orbitinstasis/T420_KB_BLE/Images/20221105_153418.jpg

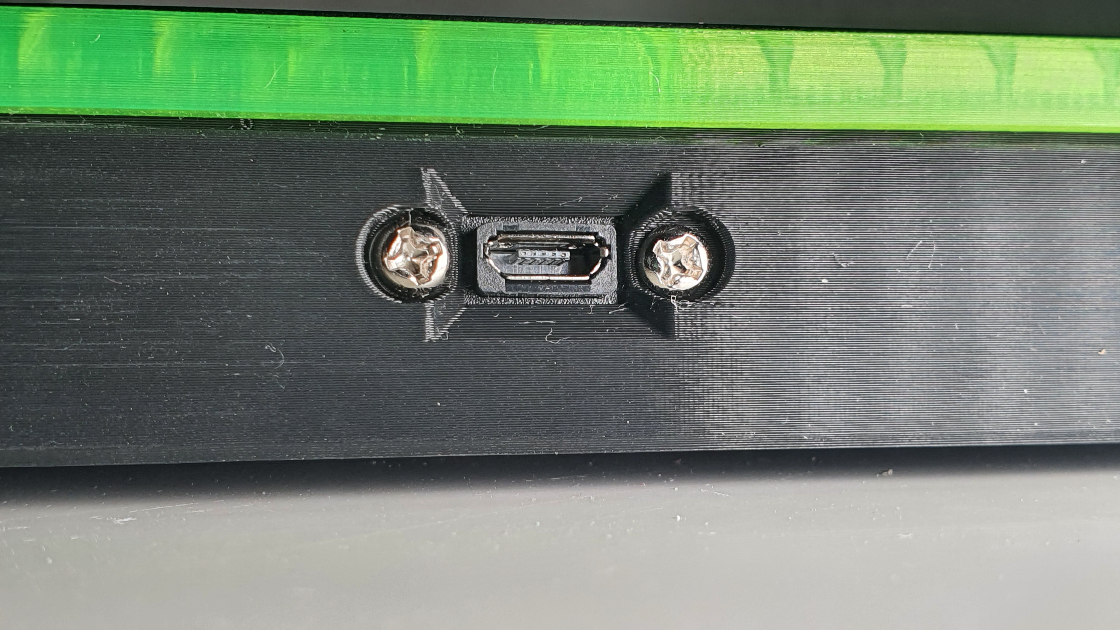
Images/20221105_153418.jpg
