orbitinstasis/T420_KB_BLE/README.md

# T420_KB_BLE
BLE and USB Mouse and Keyboard
