orbitinstasis/T420_KB_BLE/Old/Lenovo_ThinkPad_T61/Teensy 3p2/Lenovo_T61_io_list.txt

cntrl-l			16	22	
cntrl-r			9	22	
shift-l			17	21	
shift-r			9	21	
alt-l			15	1	
alt-r			8	1	
gui				12	3	
a				11	20	
b				25	8	
c				24	9	
d				11	24	
e				12	24	
f				25	11	
g				15	25	
h				31	15	
i				32	12	
j				31	11	
k				32	11	
l				7	11	
m				31	9	
n				31	8	
o				7	12	
p				12	6	
q				12	20	
r				12	25	
s				11	33	
t				17	25	
u				31	12	
v				25	9	
w				12	33	
x				9	33	
y				31	17	
z				9	20	
`				16	20	
1				10	20	
2				10	33	
3				10	24	
4				25	10	
5				16	25	
6				31	16	
7				31	10	
8				32	10	
9				7	10	
0				6	10	
-				16	6	
=				32	16	
bckspace		26	17	
esc				15	20	
f1				16	33	
f2				16	24	
f3				17	24	
f4				15	24	
f5				15	26	
f6				15	32	
f7				17	7	
f8				16	7	
f9				16	26	
f10				26	10	
f11				10	5	
f12				10	4	
insert			16	4	
delete			16	5	
home			16	2	
pg-up			16	3	
pg-dn			10	3	
end				10	2	
arrow-r			8	4	
arrow-l			8	2	
arrow-u			15	2	
arrow-d			5	8	
menu			11	3	
/				6	8	
period			7	9	
comma			32	9	
;				11	6	
'				15	6	
enter			26	9	
[				17	6	
]				32	17	
\				26	11	
caps-lck		17	33	
tab				17	20	
space			26	8	
prt-sc			10	1	
scr-lk			12	1	
pause			9	2	
page left		9	3	
page right		8	3	
mute			11	5	
volume down		17	5	
volume up		12	5	
ThinkVantage	15	5
