orbitinstasis/T420_KB_BLE/Enclosure/adafruit-bluefruit-le-uart-friend-bluetooth-low-energy-ble-1.snapshot.6/TEXTURES/eagleUp_Adafruit Bluefruit LE UART Friend_board_bottom.jpg

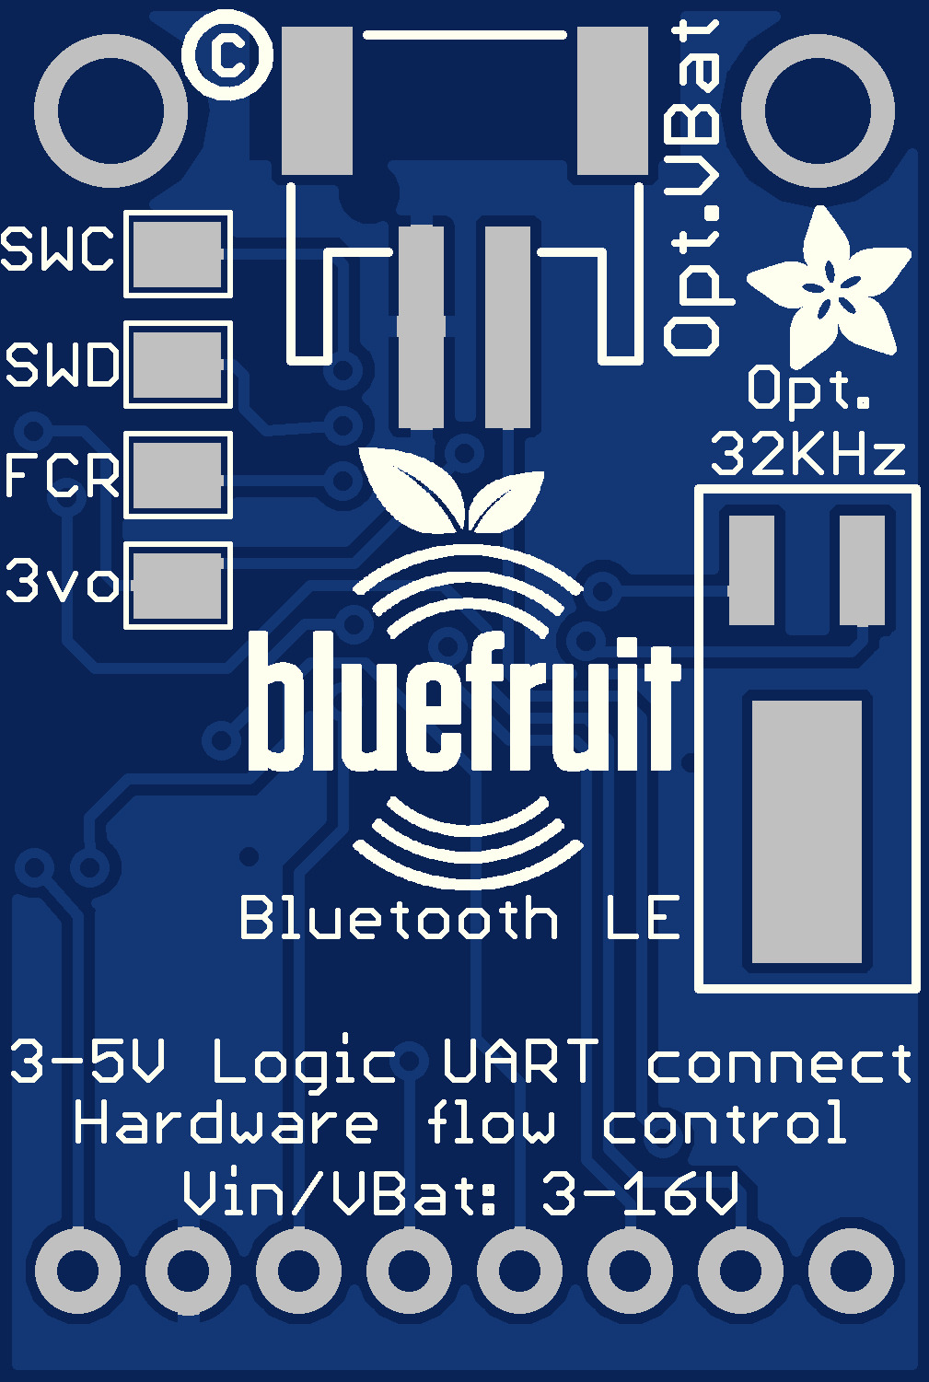
Enclosure/adafruit-bluefruit-le-uart-friend-bluetooth-low-energy-ble-1.snapshot.6/TEXTURES/eagleUp_Adafruit Bluefruit LE UART Friend_board_bottom.jpg
