orbitinstasis/T420_KB_BLE/Enclosure/revers t410_scaled.png

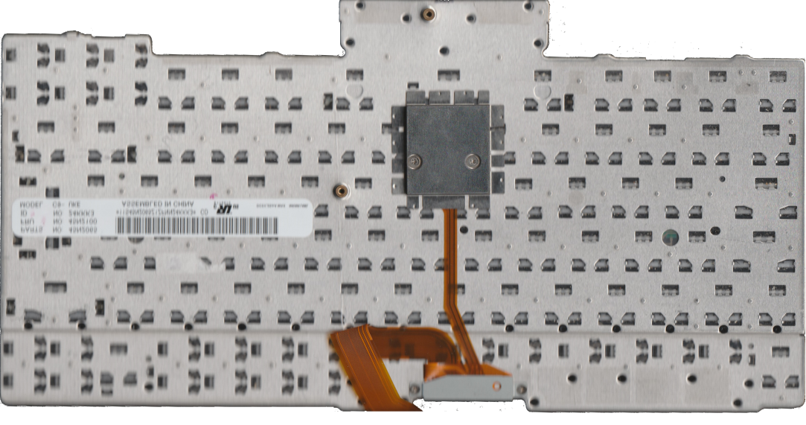
Enclosure/revers t410_scaled.png
