orbitinstasis/T420_KB_BLE/Enclosure/switch/Sliding Switches.PNG

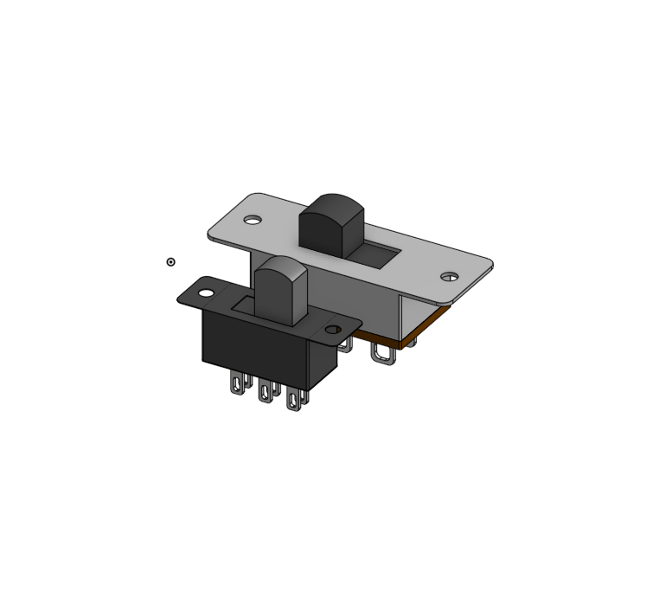
Enclosure/switch/Sliding Switches.PNG
