orbitinstasis/T420_KB_BLE/Images/20221105_142908.jpg

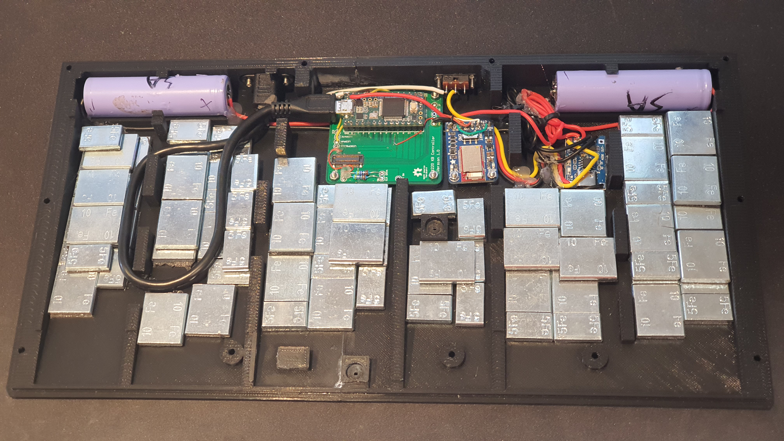
Images/20221105_142908.jpg
