orbitinstasis/T420_KB_BLE/Images/20221105_153204.jpg

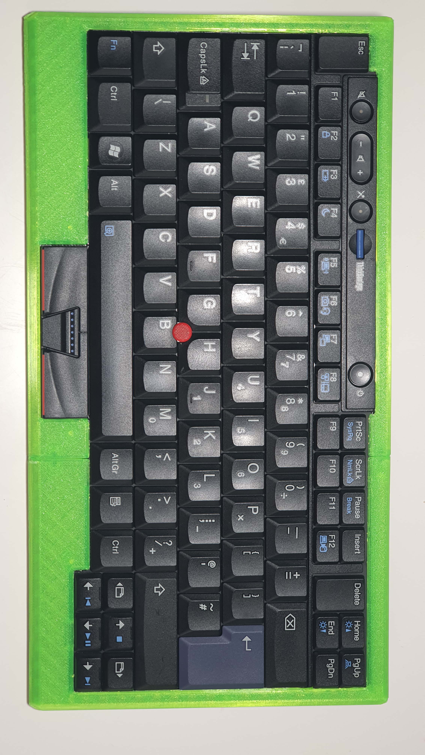
Images/20221105_153204.jpg
