orbitinstasis/T420_KB_BLE/Images/20221105_153320.jpg

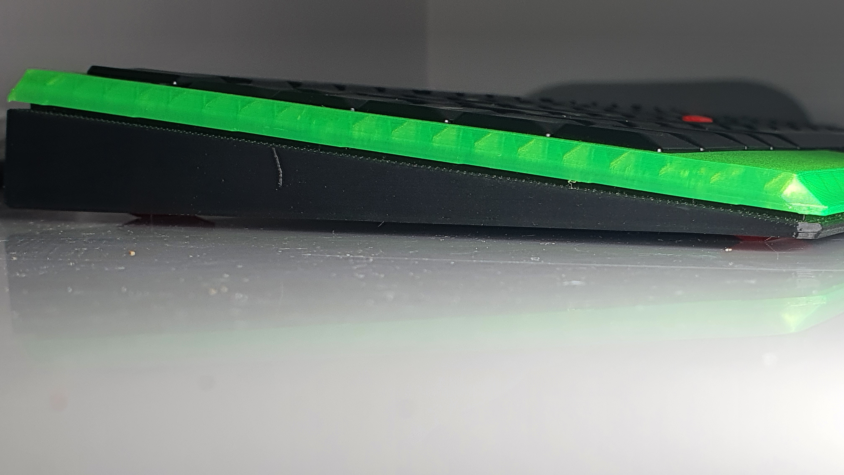
Images/20221105_153320.jpg
