orbitinstasis/T420_KB_BLE/Images/20221105_153400.jpg

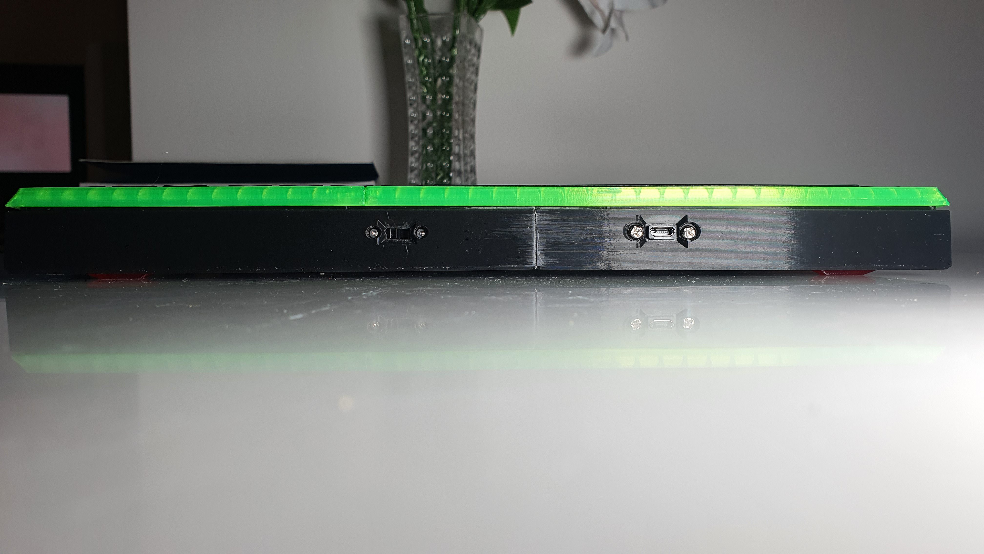
Images/20221105_153400.jpg
