orbitinstasis/T420_KB_BLE/Images/20221105_153611.jpg

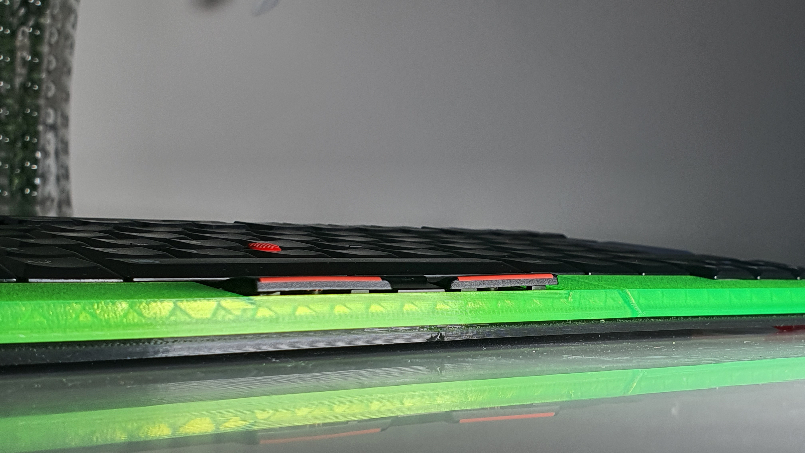
Images/20221105_153611.jpg
