orbitinstasis/T420_KB_BLE/Images/20221105_153649.jpg

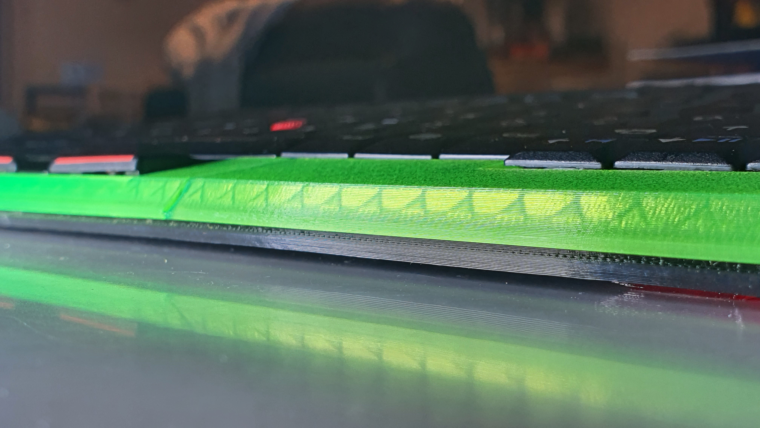
Images/20221105_153649.jpg
