orbitinstasis/T420_KB_BLE/Images/IMG-20221105-WA0033.jpeg

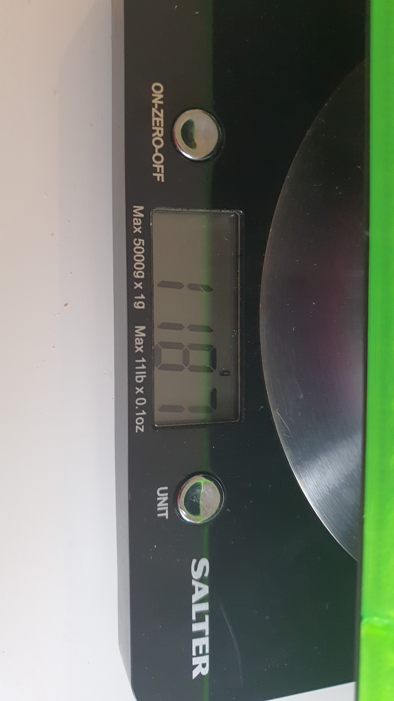
Images/IMG-20221105-WA0033.jpeg
