orbitinstasis/T420_KB_BLE/Enclosure/3D Printable Parts/4 R.stl

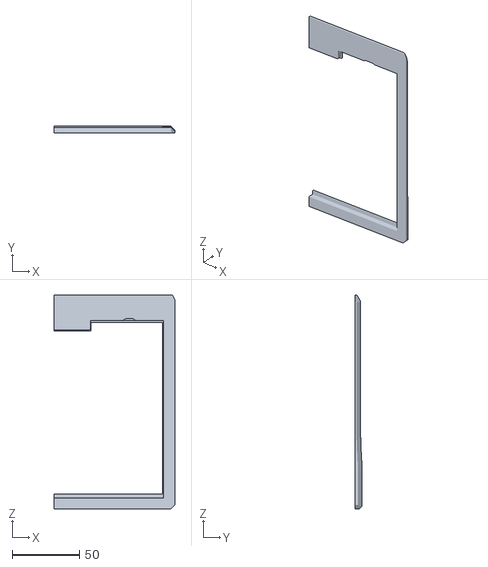
[picture p27: CAD file, 2022-11-05]
Enclosure/3D Printable Parts/4 R.stl
90.0 x 5.33 x 159.5
