orbitinstasis/T420_KB_BLE/Enclosure/BatteryHolder.stp

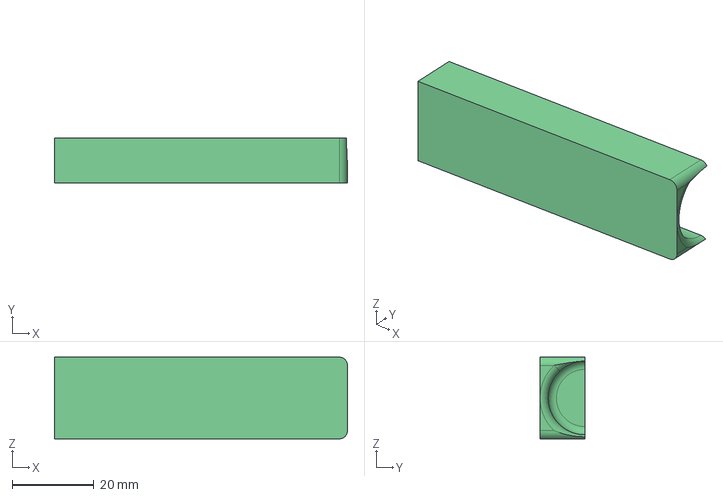
[picture p28: CAD file, 2022-11-05]
Enclosure/BatteryHolder.stp
71.7 x 11.0 x 20.0 mm
