orbitinstasis/T420_KB_BLE/Enclosure/switch/Sliding Switch 2.step

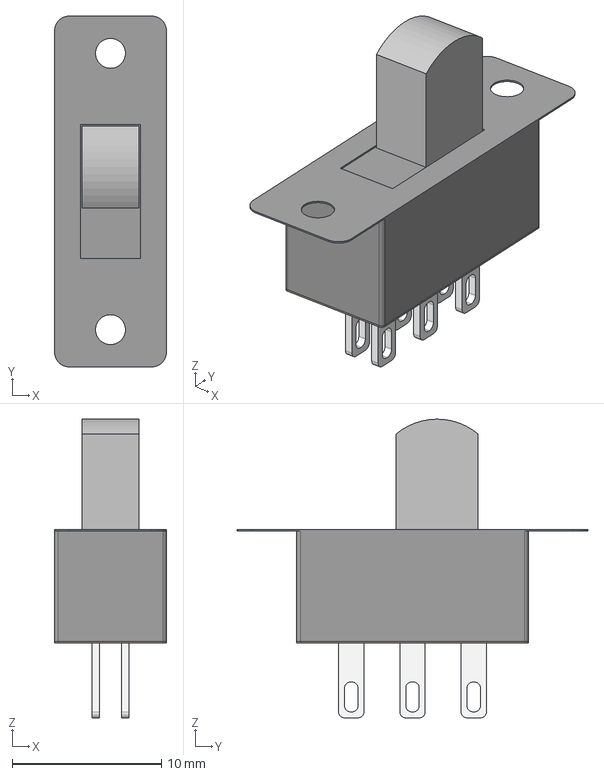
[picture p29: CAD file, 2022-11-05]
Enclosure/switch/Sliding Switch 2.step
7.50 x 23.5 x 20.0 mm
