orbitinstasis/T420_KB_BLE/Enclosure/3D Printable Parts/BezelTest2Left.stp

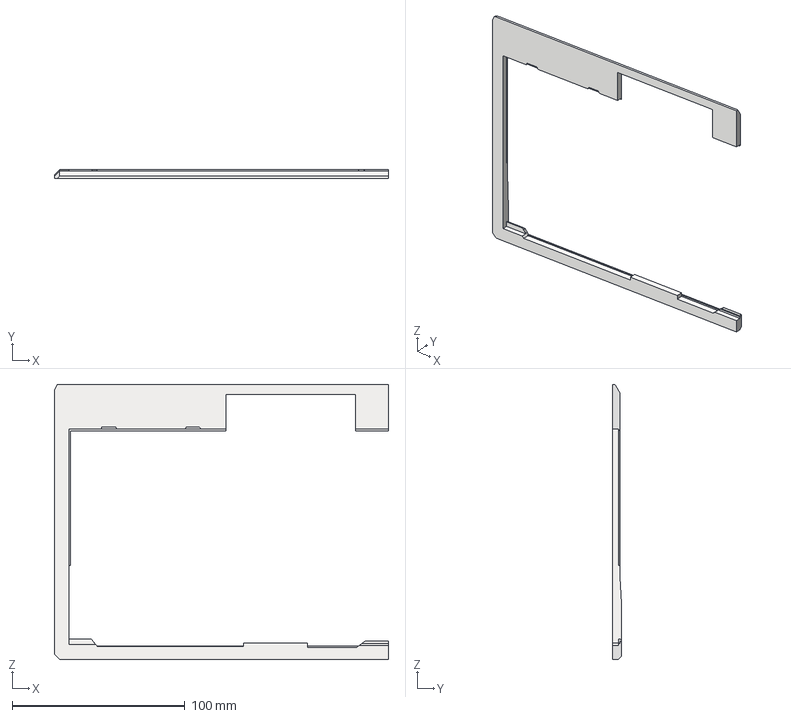
[picture p30: CAD file, 2022-11-05]
Enclosure/3D Printable Parts/BezelTest2Left.stp
193.6 x 5.33 x 159.5 mm
