orbitinstasis/T420_KB_BLE/Enclosure/BezelStep2AfterFinal.stp

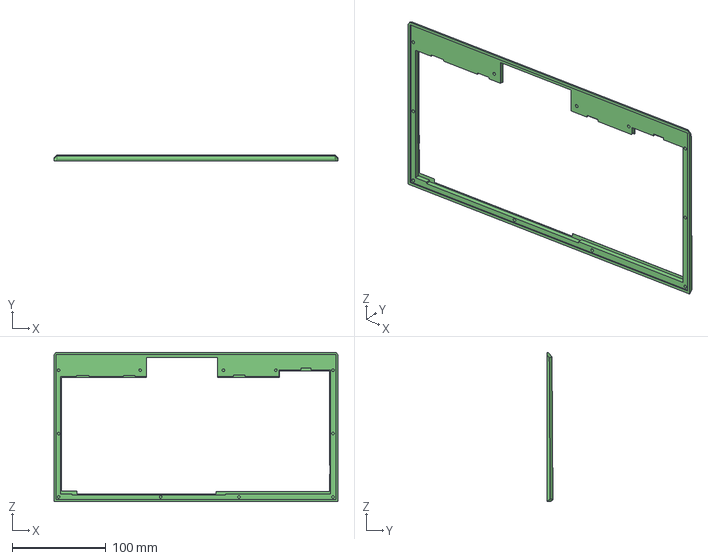
[picture p31: CAD file, 2022-11-05]
Enclosure/BezelStep2AfterFinal.stp
303.6 x 6.33 x 159.5 mm
