orbitinstasis/T420_KB_BLE/Enclosure/3D Printable Parts/62.stl

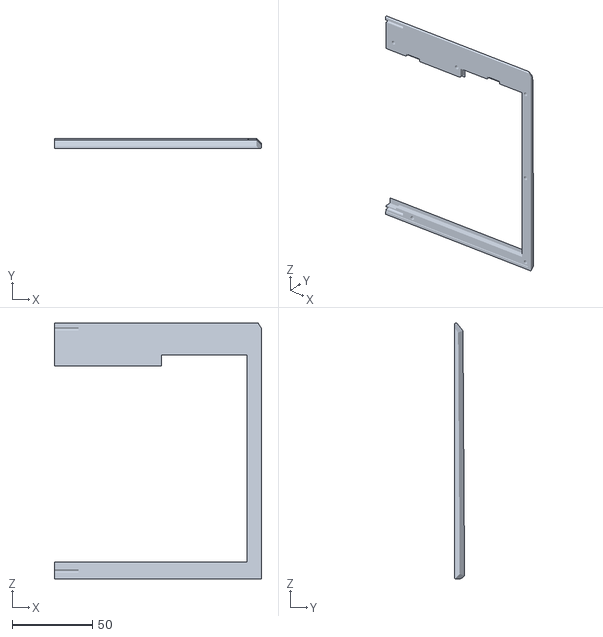
[picture p32: CAD file, 2022-11-05]
Enclosure/3D Printable Parts/62.stl
129.0 x 6.33 x 159.5
