orbitinstasis/T420_KB_BLE/Enclosure/New.stl

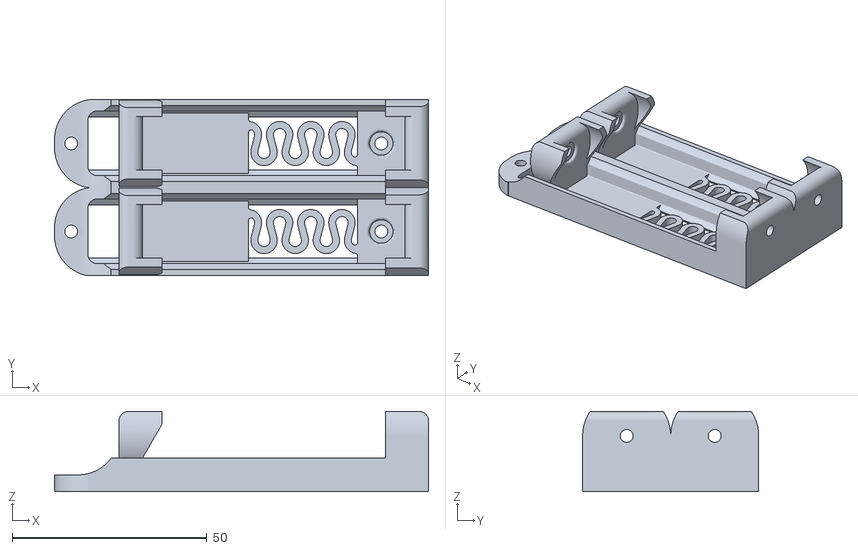
[picture p33: CAD file, 2022-11-05]
Enclosure/New.stl
96.0 x 45.3 x 20.6
