orbitinstasis/T420_KB_BLE/Enclosure/switch/Three Position Sliding Switch.step

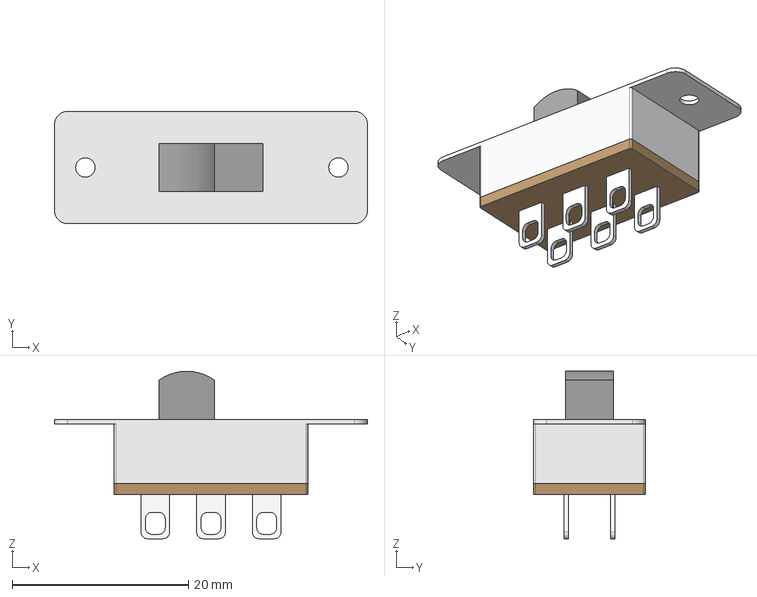
[picture p34: CAD file, 2022-11-05]
Enclosure/switch/Three Position Sliding Switch.step
35.5 x 12.8 x 19.0 mm
