orbitinstasis/T420_KB_BLE/Enclosure/Adafruit3258.stp

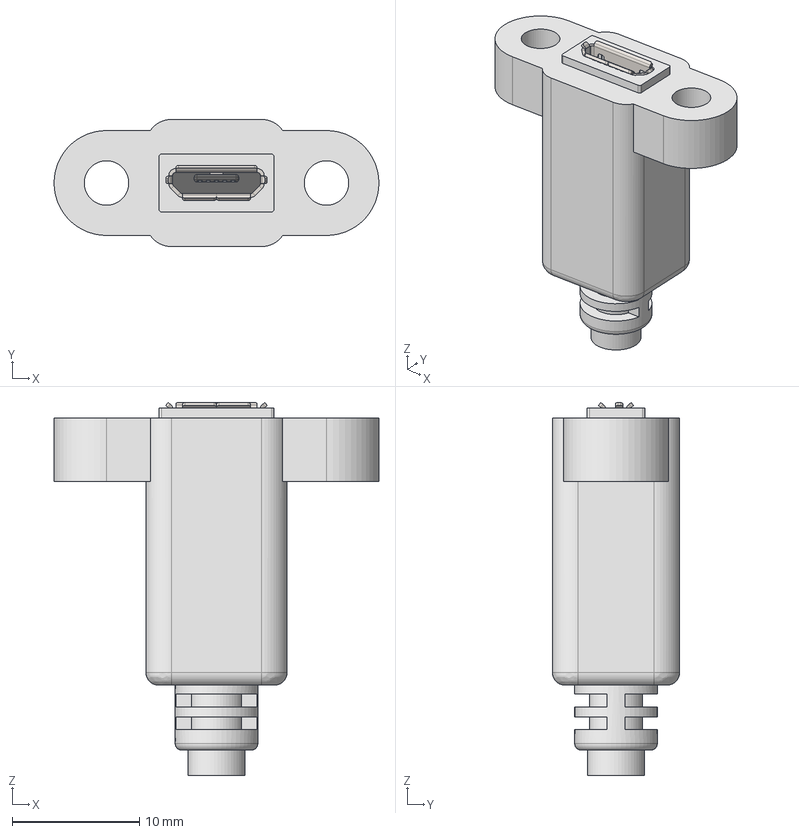
[picture p35: CAD file, 2022-11-05]
Enclosure/Adafruit3258.stp
25.5 x 10.0 x 29.3 mm
Adafruit3258_1
molex_0473460001
