orbitinstasis/T420_KB_BLE/Enclosure/3D Printable Parts/testBottom.stp

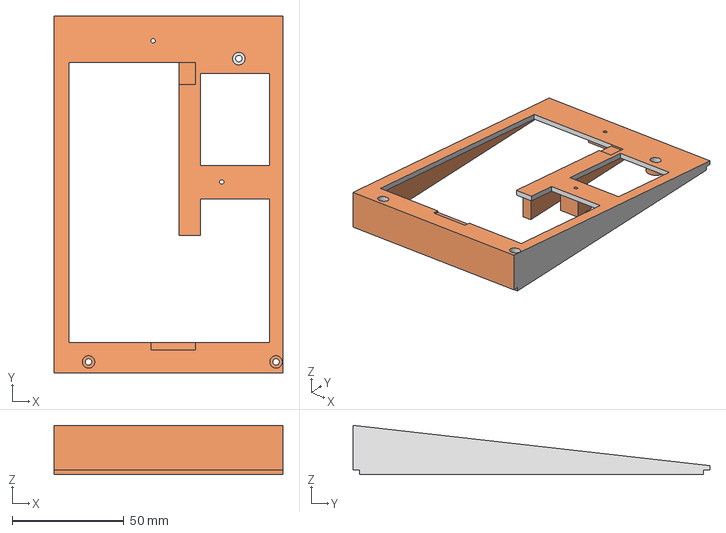
[picture p36: CAD file, 2022-11-05]
Enclosure/3D Printable Parts/testBottom.stp
102.2 x 159.5 x 22.0 mm
