orbitinstasis/T420_KB_BLE/Enclosure/3D Printable Parts/7rIGHT.stp

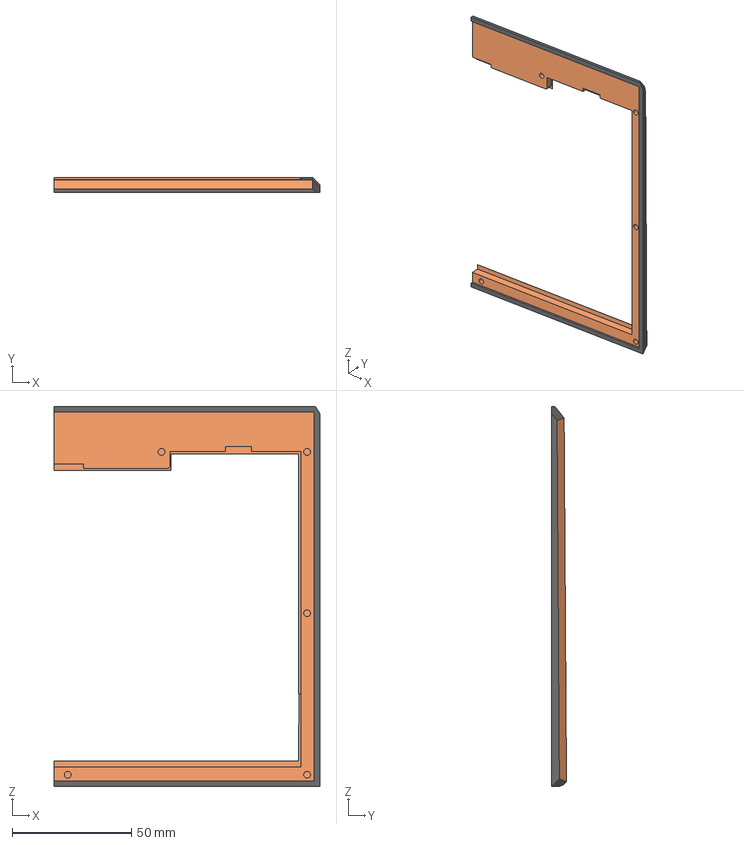
[picture p37: CAD file, 2022-11-05]
Enclosure/3D Printable Parts/7rIGHT.stp
111.5 x 6.33 x 159.5 mm
