orbitinstasis/T420_KB_BLE/Enclosure/test.stp

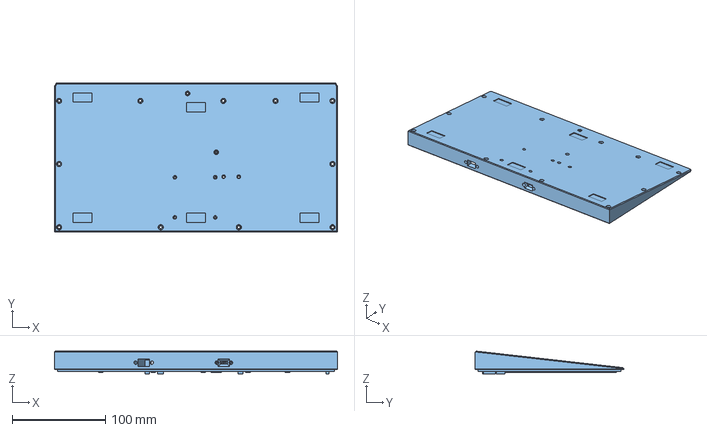
[picture p38: CAD file, 2022-11-05]
Enclosure/test.stp
303.6 x 159.5 x 24.5 mm
