orbitinstasis/T420_KB_BLE/Enclosure/3D Printable Parts/LeftBottomV1.stp

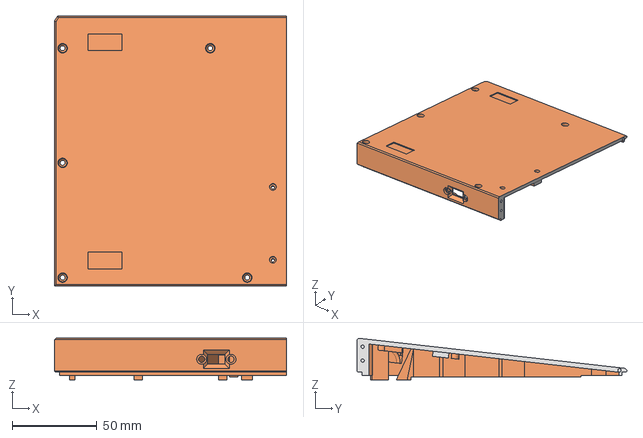
[picture p39: CAD file, 2022-11-05]
Enclosure/3D Printable Parts/LeftBottomV1.stp
137.3 x 159.5 x 24.5 mm
