orbitinstasis/T420_KB_BLE/Enclosure/6xPads.stp

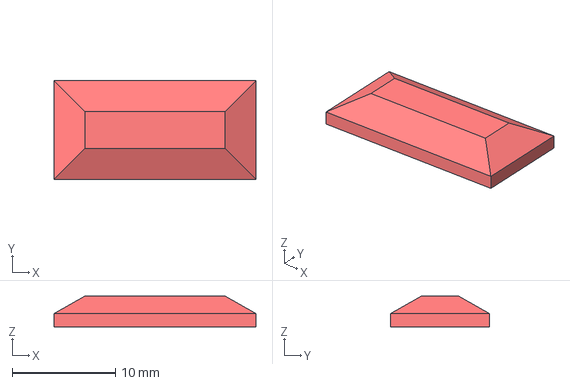
[picture p40: CAD file, 2022-11-05]
Enclosure/6xPads.stp
19.6 x 9.60 x 3.00 mm
