orbitinstasis/T420_KB_BLE/Enclosure/3D Printable Parts/61.stl

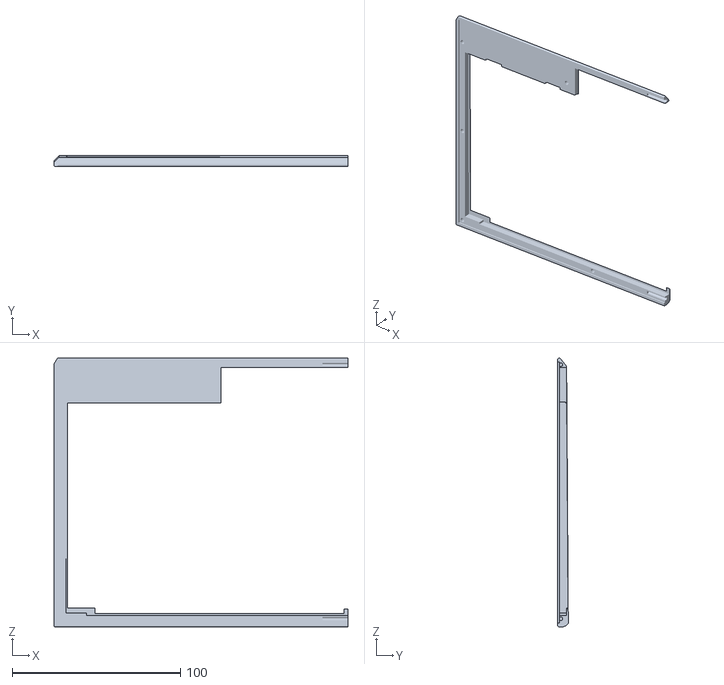
[picture p41: CAD file, 2022-11-05]
Enclosure/3D Printable Parts/61.stl
174.6 x 6.33 x 159.5
