orbitinstasis/T420_KB_BLE/Enclosure/Lenovo_Scanner t32.step

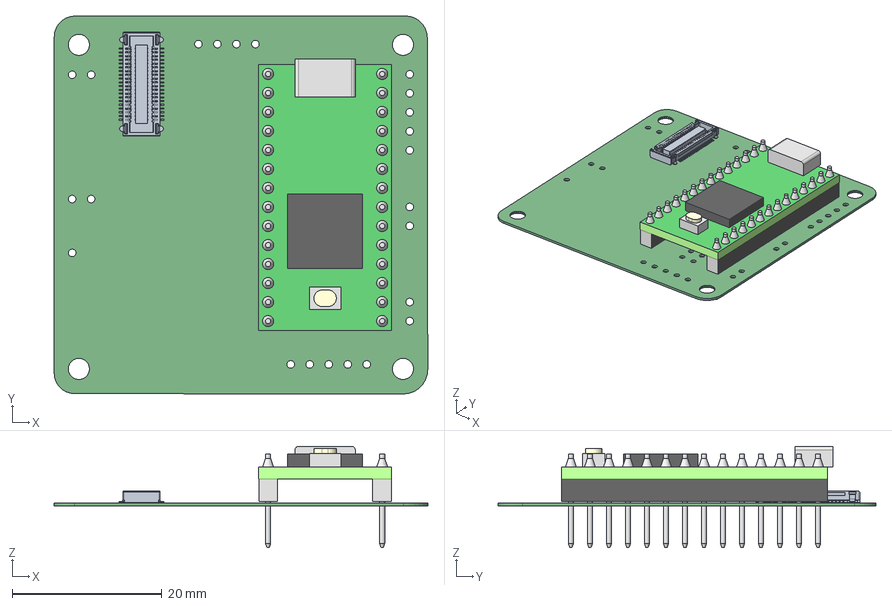
[picture p42: CAD file, 2021-09-04]
Enclosure/Lenovo_Scanner t32.step
49.9 x 50.5 x 13.6 mm
Teensy3.2
