orbitinstasis/T420_KB_BLE/Enclosure/3D Printable Parts/BezelTest2Right.stp

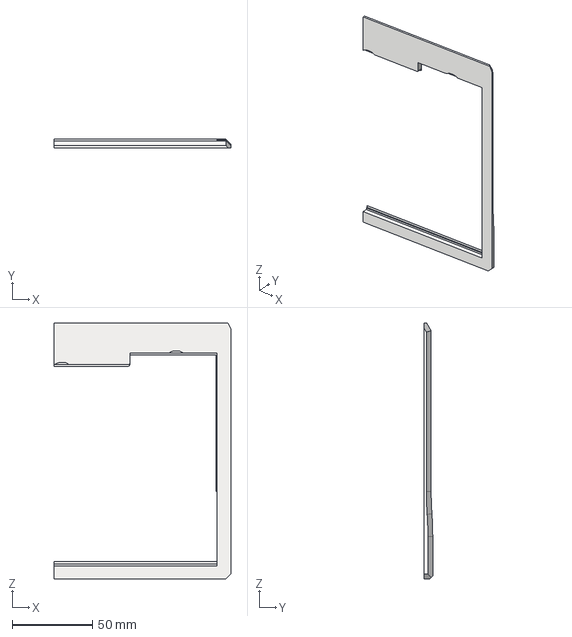
[picture p43: CAD file, 2022-11-05]
Enclosure/3D Printable Parts/BezelTest2Right.stp
110.0 x 5.33 x 159.5 mm
