orbitinstasis/T420_KB_BLE/Enclosure/Teensy3.2.STEP

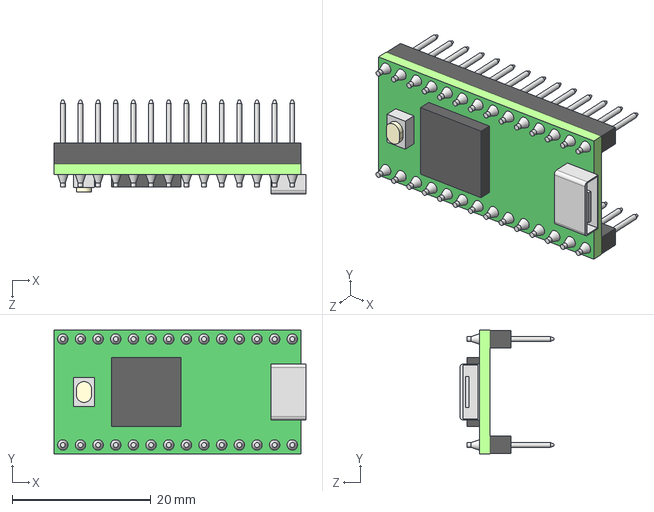
[picture p44: CAD file, 2021-09-04]
Enclosure/Teensy3.2.STEP
36.3 x 17.8 x 13.6 mm
