orbitinstasis/T420_KB_BLE/Enclosure/3D Printable Parts/bezel3.stp

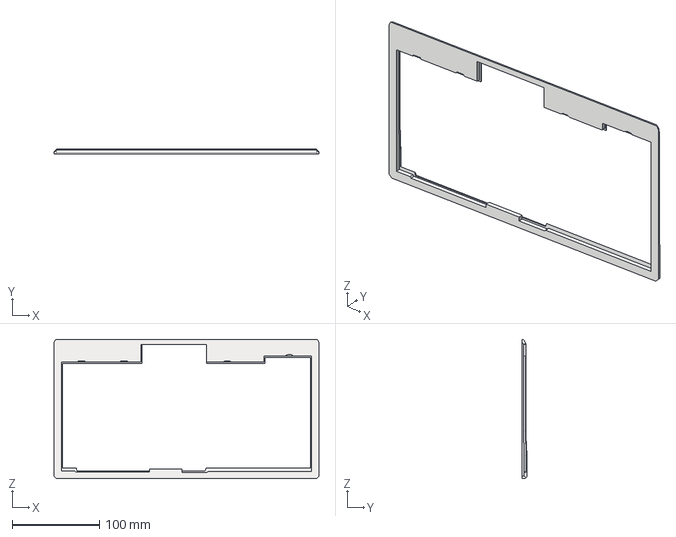
[picture p45: CAD file, 2022-11-05]
Enclosure/3D Printable Parts/bezel3.stp
303.6 x 5.33 x 159.5 mm
