orbitinstasis/T420_KB_BLE/Enclosure/3D Printable Parts/5THFinalAttemptLeft.stp

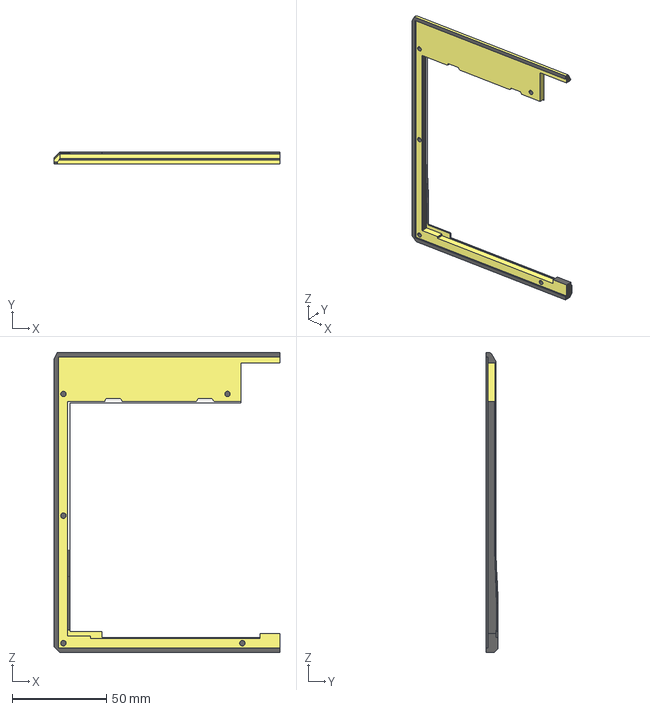
[picture p46: CAD file, 2022-11-05]
Enclosure/3D Printable Parts/5THFinalAttemptLeft.stp
120.0 x 6.33 x 159.5 mm
