orbitinstasis/T420_KB_BLE/Enclosure/3D Printable Parts/5THFinalAttemptRight.stp

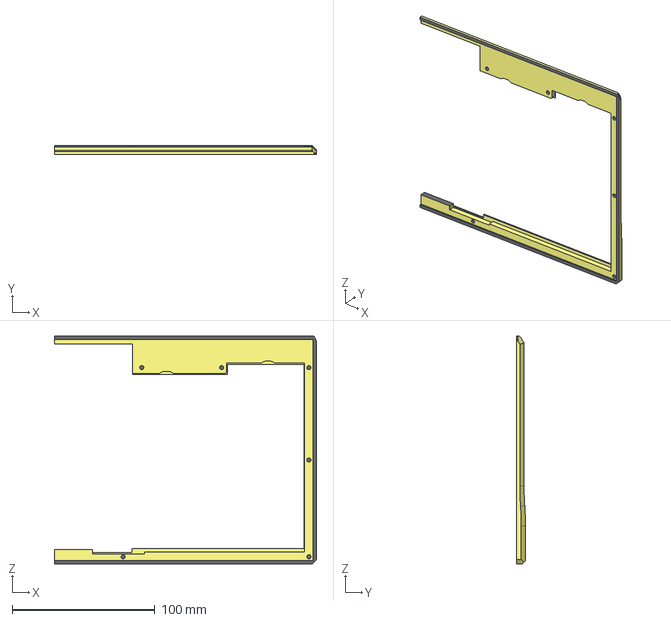
[picture p47: CAD file, 2022-11-05]
Enclosure/3D Printable Parts/5THFinalAttemptRight.stp
183.6 x 6.33 x 159.5 mm
