orbitinstasis/T420_KB_BLE/Enclosure/3D Printable Parts/BezelTestOneLeft.stp

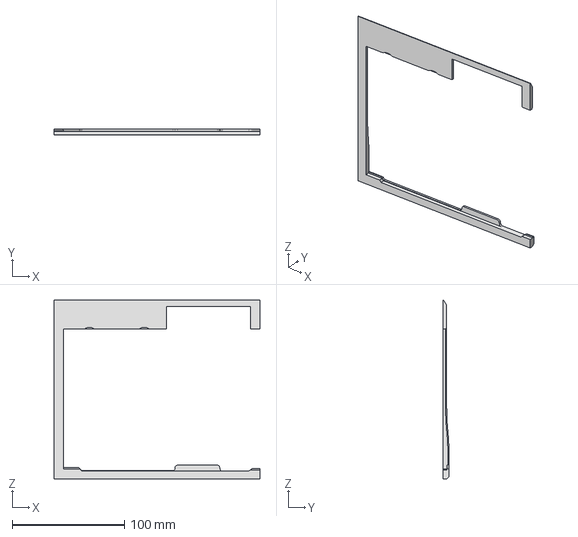
[picture p48: CAD file, 2022-11-05]
Enclosure/3D Printable Parts/BezelTestOneLeft.stp
183.6 x 5.33 x 159.5 mm
