orbitinstasis/T420_KB_BLE/Enclosure/3D Printable Parts/7Left.stp

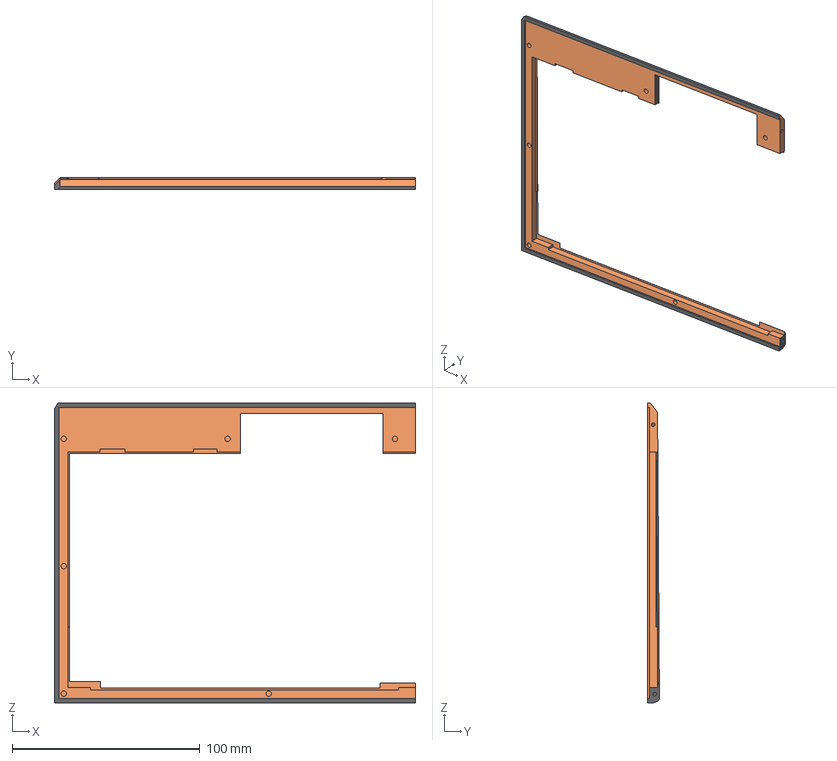
[picture p49: CAD file, 2022-11-05]
Enclosure/3D Printable Parts/7Left.stp
192.1 x 6.33 x 159.5 mm
