orbitinstasis/T420_KB_BLE/Enclosure/3D Printable Parts/RightBottomV1.stp

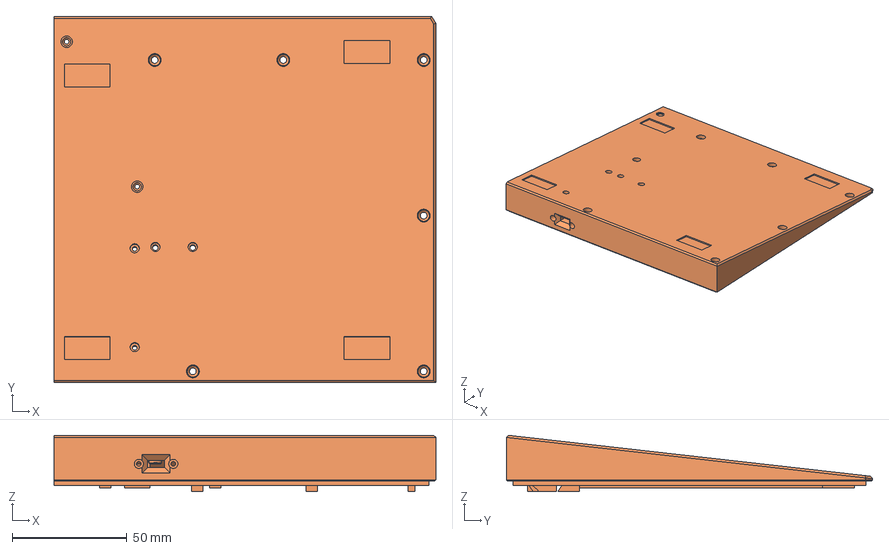
[picture p50: CAD file, 2022-11-05]
Enclosure/3D Printable Parts/RightBottomV1.stp
166.3 x 159.5 x 24.5 mm
