orbitinstasis/T420_KB_BLE/Enclosure/3D Printable Parts/BottomStep.stp

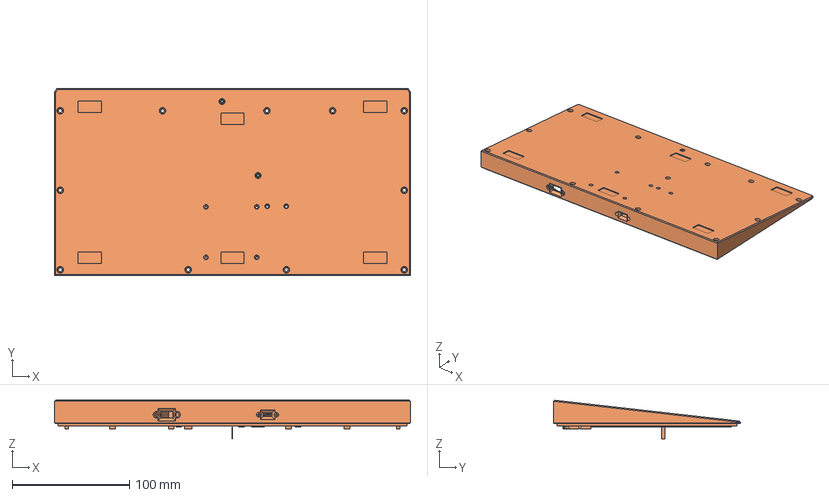
[picture p51: CAD file, 2022-11-05]
Enclosure/3D Printable Parts/BottomStep.stp
303.6 x 159.5 x 32.9 mm
