orbitinstasis/T420_KB_BLE/Enclosure/3D Printable Parts/BottomRight.3mf

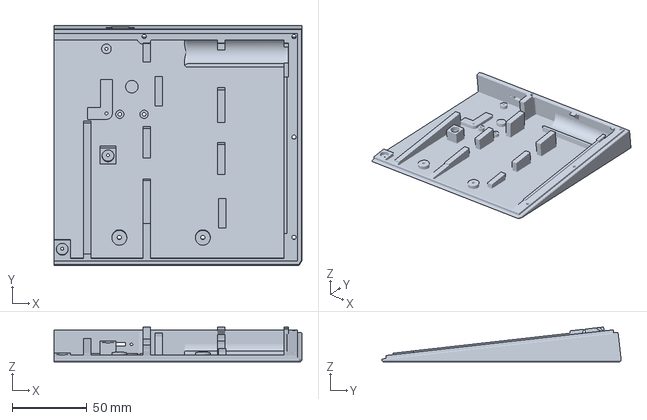
[picture p52: CAD file, 2022-11-05]
Enclosure/3D Printable Parts/BottomRight.3mf
166.3 x 160.6 x 23.5 mm
