orbitinstasis/T420_KB_BLE/Enclosure/3D Printable Parts/4 left.stl

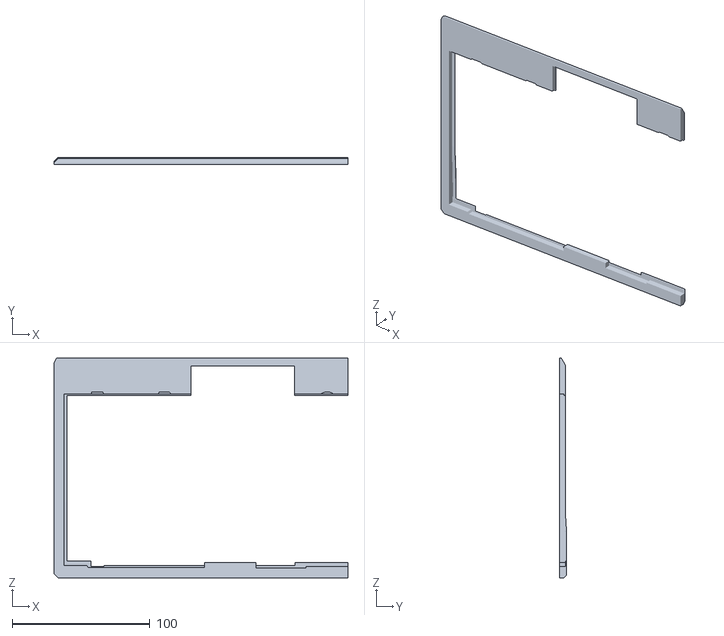
[picture p53: CAD file, 2022-11-05]
Enclosure/3D Printable Parts/4 left.stl
213.6 x 5.33 x 159.5
