orbitinstasis/T420_KB_BLE/Enclosure/3D Printable Parts/BezelTestOneRight.stp

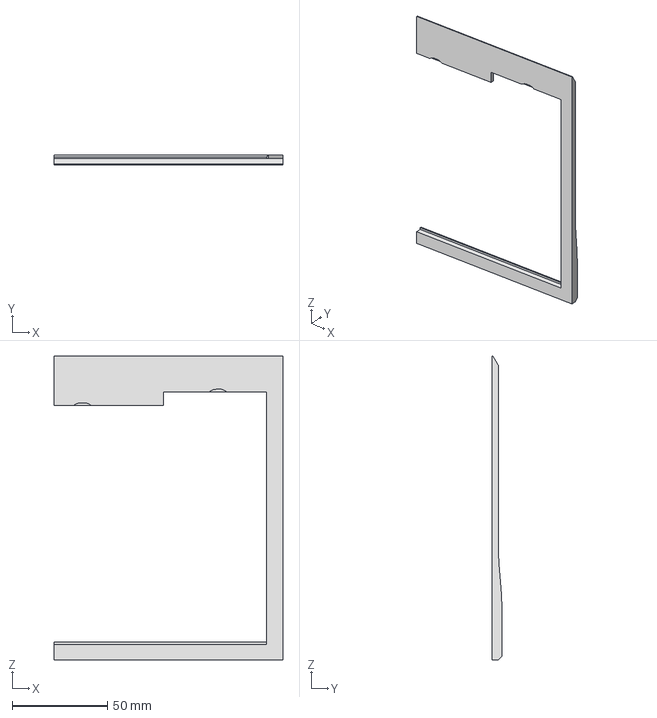
[picture p54: CAD file, 2022-11-05]
Enclosure/3D Printable Parts/BezelTestOneRight.stp
120.0 x 5.33 x 159.5 mm
