orbitinstasis/T420_KB_BLE/(list of files, cad)

Other CAD files:
Enclosure/switch/Sliding Switch.iges
Enclosure/3D Printable Parts/6THright.stp
Enclosure/FinalBezel.stp
Enclosure/3D Printable Parts/6THLEFT.stp
Enclosure/10gram weight.ipt
Enclosure/18650-battery-7.snapshot.1/18650 Battery Final.SLDPRT
Enclosure/18650-battery-7.snapshot.1/18650 Battery Final.ipt
Enclosure/1X01.ipt
Enclosure/1X02.ipt
Enclosure/1X05.ipt
Enclosure/3D Printable Parts/BezelTest2Right.3mf
Enclosure/3D Printable Parts/Bottom.ipt
Enclosure/3D Printable Parts/OldVersions/Bottom.0024.ipt
Enclosure/3D Printable Parts/OldVersions/Bottom.0025.ipt
Enclosure/3D Printable Parts/OldVersions/Bottom.0026.ipt
Enclosure/3D Printable Parts/OldVersions/Bottom.0027.ipt
Enclosure/3D Printable Parts/OldVersions/Bottom.0028.ipt
Enclosure/3D Printable Parts/testBottom.3mf
Enclosure/543630489.iam
Enclosure/5gram weight.ipt
Enclosure/Adafruit3258.ipt
Enclosure/AssBasedonStep.iam
Enclosure/BatteryHolder.ipt
Enclosure/Bezel.ipt
Enclosure/BezelStep2AfterFinal.ipt
Enclosure/Board.ipt
Enclosure/BoardLenovo_Scanner_t32.iam
Enclosure/BottomStep.ipt
Enclosure/BottomStep.stp
Enclosure/Case.ipt
Enclosure/Free-Models.iam
Enclosure/J1Lenovo_Scanner_t32.iam
Enclosure/Lenovo_Scanner t32.iam
Enclosure/Lenovo_Scanner v1.iam
Enclosure/M3 Screw.ipt
Enclosure/My USB Hub.ipt
Enclosure/OSHW_5MM.ipt
Enclosure/OldVersions/AssBasedonStep.0048.iam
Enclosure/OldVersions/AssBasedonStep.0049.iam
Enclosure/OldVersions/AssBasedonStep.0050.iam
Enclosure/OldVersions/AssBasedonStep.0051.iam
Enclosure/OldVersions/AssBasedonStep.0052.iam
Enclosure/OldVersions/Bezel.0067.ipt
Enclosure/OldVersions/Bezel.0068.ipt
Enclosure/OldVersions/Bezel.0069.ipt
Enclosure/OldVersions/Bezel.0070.ipt
Enclosure/OldVersions/Bezel.0071.ipt
Enclosure/OldVersions/BottomStep.0033.ipt
Enclosure/OldVersions/BottomStep.0034.ipt
Enclosure/OldVersions/BottomStep.0035.ipt
Enclosure/OldVersions/BottomStep.0036.ipt
Enclosure/OldVersions/BottomStep.0037.ipt
Enclosure/OldVersions/Case.0003.ipt
Enclosure/OldVersions/Case.0004.ipt
Enclosure/OldVersions/M3 Screw.0001.ipt
Enclosure/OldVersions/M3 Screw.0002.ipt
Enclosure/OldVersions/M3 Screw.0003.ipt
Enclosure/OldVersions/Pads.0001.ipt
Enclosure/OldVersions/m2 screw.0001.ipt
Enclosure/OldVersions/m2 screw.0002.ipt
Enclosure/OldVersions/m2 screw.0003.ipt
Enclosure/Open CASCADE STEP translator 6.8 1.1.1.ipt
Enclosure/Open CASCADE STEP translator 6.8 1.2.1.1.ipt
Enclosure/Open CASCADE STEP translator 6.8 1.2.1.2.ipt
Enclosure/PCB Component.iam
Enclosure/Pads.ipt
Enclosure/T420 Holder.ipt
Enclosure/TEENSY_3P2MIN.ipt
Enclosure/Teensy3.2.ipt
Enclosure/ThinkBoard.iam
Enclosure/USB Hub.ipt
Enclosure/WM6787CT-ND.ipt
Enclosure/m2 screw.ipt
Enclosure/my keyboard BOTTOM.ipt
Enclosure/switch/OldVersions/Sliding Switch 2.0001.ipt
Enclosure/switch/Sliding Switch 2.ipt
Enclosure/switch/Three Position Sliding Switch.iges
Enclosure/switch/battery_holder_2batteries.ipt
Enclosure/t410.ipt
Enclosure/t420 ipt/Audio Control Button.ipt
Enclosure/t420 ipt/Audio Mute Button Label.ipt
Enclosure/t420 ipt/Audio Volume Buttons Label.ipt
Enclosure/t420 ipt/Audio Volume Buttons.iam
Enclosure/t420 ipt/Keyboard Top Bar.iam
Enclosure/t420 ipt/Keycap (Arrows).ipt
Enclosure/t420 ipt/Keycap (Backspace).ipt
Enclosure/t420 ipt/Keycap (Caps Lock).ipt
Enclosure/t420 ipt/Keycap (Ctrl L).ipt
Enclosure/t420 ipt/Keycap (Delete).ipt
Enclosure/t420 ipt/Keycap (Enter).ipt
Enclosure/t420 ipt/Keycap (Function Keys).ipt
Enclosure/t420 ipt/Keycap (Pg Fwd _ Pg Back).ipt
Enclosure/t420 ipt/Keycap (Shift L).ipt
Enclosure/t420 ipt/Keycap (Shift R).ipt
Enclosure/t420 ipt/Keycap (Space).ipt
Enclosure/t420 ipt/Keycap (Standard).ipt
Enclosure/t420 ipt/Keycap (Tab _ Backslash).ipt
Enclosure/t420 ipt/Keycap (TrackPoint B).ipt
Enclosure/t420 ipt/Keycap (Trackpoint G _ H).ipt
Enclosure/t420 ipt/Keycap (Up Arrow).ipt
Enclosure/t420 ipt/Keycap (Win).ipt
Enclosure/t420 ipt/Keycap Label (! Exclamation Mark).ipt
Enclosure/t420 ipt/Keycap Label (# Pound Sign).ipt
Enclosure/t420 ipt/Keycap Label ($ Dollar Sign).ipt
Enclosure/t420 ipt/Keycap Label (% Percent Sign).ipt
Enclosure/t420 ipt/Keycap Label (& Ampersand).ipt
Enclosure/t420 ipt/Keycap Label ('_ Apostrophe _ Quotation Mark).ipt
Enclosure/t420 ipt/Keycap Label (( Open Parentheses).ipt
Enclosure/t420 ipt/Keycap Label () Close Parentheses).ipt
Enclosure/t420 ipt/Keycap Label (, Comma).ipt
Enclosure/t420 ipt/Keycap Label (-_ Hyphen-Minus _ Underscore).ipt
Enclosure/t420 ipt/Keycap Label (. Period).ipt
Enclosure/t420 ipt/Keycap Label (0).ipt
Enclosure/t420 ipt/Keycap Label (1).ipt
Enclosure/t420 ipt/Keycap Label (2).ipt
Enclosure/t420 ipt/Keycap Label (3).ipt
Enclosure/t420 ipt/Keycap Label (4).ipt
Enclosure/t420 ipt/Keycap Label (5).ipt
Enclosure/t420 ipt/Keycap Label (6).ipt
Enclosure/t420 ipt/Keycap Label (7).ipt
Enclosure/t420 ipt/Keycap Label (8).ipt
Enclosure/t420 ipt/Keycap Label (9).ipt
Enclosure/t420 ipt/Keycap Label (;_ Semicolon _ Colon).ipt
Enclosure/t420 ipt/Keycap Label (=+ Equal Sign _ Plus Sign).ipt
Enclosure/t420 ipt/Keycap Label (@ At Sign).ipt
Enclosure/t420 ipt/Keycap Label (A).ipt
Enclosure/t420 ipt/Keycap Label (Alt).ipt
Enclosure/t420 ipt/Keycap Label (Arrow Down).ipt
Enclosure/t420 ipt/Keycap Label (Arrow Left).ipt
Enclosure/t420 ipt/Keycap Label (Arrow Right).ipt
Enclosure/t420 ipt/Keycap Label (Arrow Up).ipt
Enclosure/t420 ipt/Keycap Label (B).ipt
Enclosure/t420 ipt/Keycap Label (Backspace).ipt
Enclosure/t420 ipt/Keycap Label (Break).ipt
Enclosure/t420 ipt/Keycap Label (Browser Back).ipt
Enclosure/t420 ipt/Keycap Label (Browser Fwd).ipt
Enclosure/t420 ipt/Keycap Label (C).ipt
Enclosure/t420 ipt/Keycap Label (CapsLk).ipt
Enclosure/t420 ipt/Keycap Label (Ctrl L).ipt
Enclosure/t420 ipt/Keycap Label (Ctrl R).ipt
Enclosure/t420 ipt/Keycap Label (D).ipt
Enclosure/t420 ipt/Keycap Label (Delete).ipt
Enclosure/t420 ipt/Keycap Label (E).ipt
Enclosure/t420 ipt/Keycap Label (End).ipt
Enclosure/t420 ipt/Keycap Label (Enter).ipt
Enclosure/t420 ipt/Keycap Label (Esc).ipt
Enclosure/t420 ipt/Keycap Label (F).ipt
Enclosure/t420 ipt/Keycap Label (F1).ipt
Enclosure/t420 ipt/Keycap Label (F10).ipt
Enclosure/t420 ipt/Keycap Label (F11).ipt
Enclosure/t420 ipt/Keycap Label (F12).ipt
Enclosure/t420 ipt/Keycap Label (F2).ipt
Enclosure/t420 ipt/Keycap Label (F3).ipt
Enclosure/t420 ipt/Keycap Label (F4).ipt
Enclosure/t420 ipt/Keycap Label (F5).ipt
Enclosure/t420 ipt/Keycap Label (F6).ipt
Enclosure/t420 ipt/Keycap Label (F7).ipt
Enclosure/t420 ipt/Keycap Label (F8).ipt
Enclosure/t420 ipt/Keycap Label (F9).ipt
Enclosure/t420 ipt/Keycap Label (Fn Battery).ipt
Enclosure/t420 ipt/Keycap Label (Fn Brightness Down).ipt
Enclosure/t420 ipt/Keycap Label (Fn Brightness Up).ipt
Enclosure/t420 ipt/Keycap Label (Fn Camera_Headset).ipt
Enclosure/t420 ipt/Keycap Label (Fn Hibernate).ipt
Enclosure/t420 ipt/Keycap Label (Fn Lock).ipt
Enclosure/t420 ipt/Keycap Label (Fn Magnify Screen).ipt
Enclosure/t420 ipt/Keycap Label (Fn Play _ Pause).ipt
Enclosure/t420 ipt/Keycap Label (Fn Projector).ipt
Enclosure/t420 ipt/Keycap Label (Fn Sleep).ipt
Enclosure/t420 ipt/Keycap Label (Fn Stop).ipt
Enclosure/t420 ipt/Keycap Label (Fn ThinkLight).ipt
Enclosure/t420 ipt/Keycap Label (Fn Track Next).ipt
Enclosure/t420 ipt/Keycap Label (Fn Track Prev).ipt
Enclosure/t420 ipt/Keycap Label (Fn TrackPoint).ipt
Enclosure/t420 ipt/Keycap Label (Fn WiFi).ipt
Enclosure/t420 ipt/Keycap Label (Fn).ipt
Enclosure/t420 ipt/Keycap Label (G).ipt
Enclosure/t420 ipt/Keycap Label (H).ipt
Enclosure/t420 ipt/Keycap Label (Home).ipt
Enclosure/t420 ipt/Keycap Label (I).ipt
Enclosure/t420 ipt/Keycap Label (Insert).ipt
Enclosure/t420 ipt/Keycap Label (J).ipt
Enclosure/t420 ipt/Keycap Label (K).ipt
Enclosure/t420 ipt/Keycap Label (L).ipt
Enclosure/t420 ipt/Keycap Label (M).ipt
Enclosure/t420 ipt/Keycap Label (Menu).ipt
Enclosure/t420 ipt/Keycap Label (N).ipt
Enclosure/t420 ipt/Keycap Label (NmLk).ipt
Enclosure/t420 ipt/Keycap Label (Numpad 0).ipt
Enclosure/t420 ipt/Keycap Label (Numpad 1).ipt
Enclosure/t420 ipt/Keycap Label (Numpad 2).ipt
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
