orbitinstasis/T420_KB_BLE/T420 Schematic.pdf

# NOZOMI-3 SWG SDV2 LOGIC SCHEMATICS

# 1.TITLE PAGE

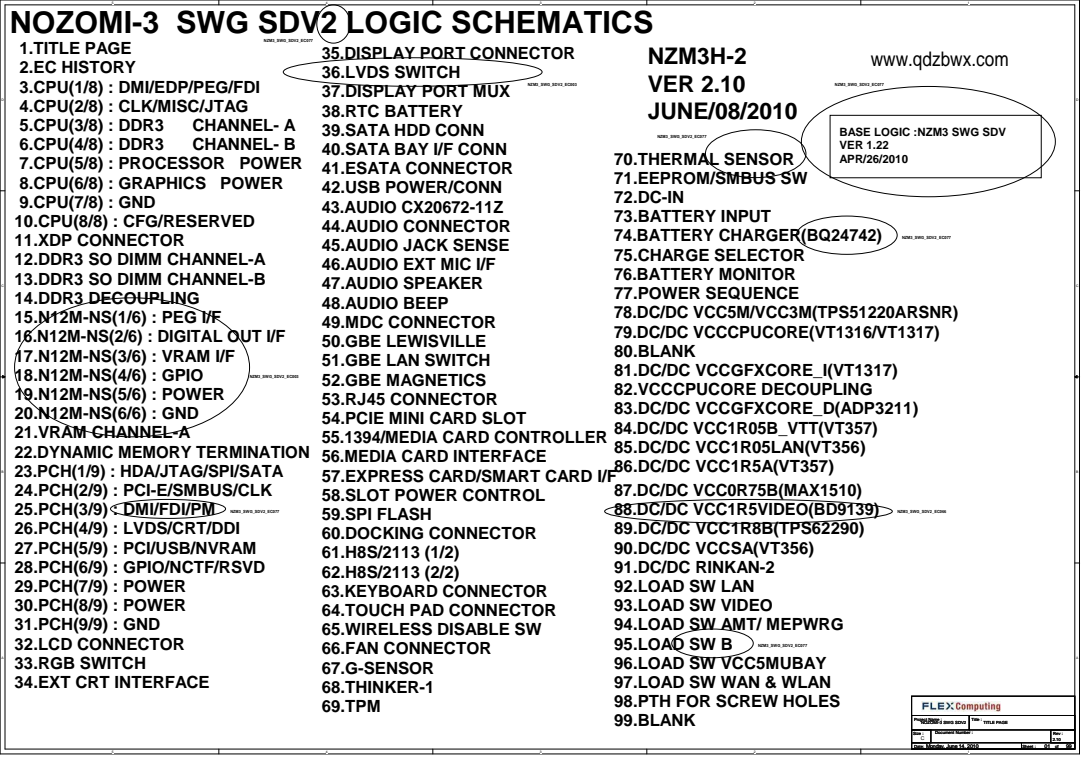
[picture p55: page 1]
5.CPU(3/8) : DDR3; CHANNEL- A; 6.CPU(4/8) : DDR3; CHANNEL- B; NZM3H-2 VER 2.10 JUNE/08/2010; NZM3_SWG_SDV2_EC003; NZM3_SWG_SDV2_EC066; NZM3_SWG_SDV2_EC077

NZM3_SWG_SDV2_EC077
35.DISPLAY PORT CONNECTOR
36.LVDS SWITCH
37.DISPLAY PORT MUX
38.RTC BATTERY
39.SATA HDD CONN
40.SATA BAY I/F CONN
41.ESATA CONNECTOR
42.USB POWER/CONN
43.AUDIO CX20672-11Z
44.AUDIO CONNECTOR
45.AUDIO JACK SENSE
46.AUDIO EXT MIC I/F
47.AUDIO SPEAKER
48.AUDIO BEEP
49.MDC CONNECTOR
50.GBE LEWISVILLE
51.GBE LAN SWITCH
52.GBE MAGNETICS
53.RJ45 CONNECTOR
54.PCIE MINI CARD SLOT
55.1394/MEDIA CARD CONTROLLER
56.MEDIA CARD INTERFACE
57.EXPRESS CARD/SMART CARD I/F
58.SLOT POWER CONTROL
59.SPI FLASH
60.DOCKING CONNECTOR
63.KEYBOARD CONNECTOR
64.TOUCH PAD CONNECTOR
65.WIRELESS DISABLE SW
66.FAN CONNECTOR
67.G-SENSOR
68.THINKER-1
69.TPM

www.qdzbwx.com

2.EC HISTORY
3.CPU(1/8) : DMI/EDP/PEG/FDI
4.CPU(2/8) : CLK/MISC/JTAG
7.CPU(5/8) : PROCESSOR POWER
8.CPU(6/8) : GRAPHICS POWER
9.CPU(7/8) : GND
10.CPU(8/8) : CFG/RESERVED
11.XDP CONNECTOR
12.DDR3 SO DIMM CHANNEL-A
13.DDR3 SO DIMM CHANNEL-B
14.DDR3 DECOUPLING
15.N12M-NS(1/6) : PEG I/F
16.N12M-NS(2/6) : DIGITAL OUT I/F
17.N12M-NS(3/6) : VRAM I/F
18.N12M-NS(4/6) : GPIO
19.N12M-NS(5/6) : POWER
20.N12M-NS(6/6) : GND
21.VRAM CHANNEL-A
22.DYNAMIC MEMORY TERMINATION
23.PCH(1/9) : HDA/JTAG/SPI/SATA
24.PCH(2/9) : PCI-E/SMBUS/CLK
25.PCH(3/9) : DMI/FDI/PM
26.PCH(4/9) : LVDS/CRT/DDI
27.PCH(5/9) : PCI/USB/NVRAM
28.PCH(6/9) : GPIO/NCTF/RSVD
29.PCH(7/9) : POWER
30.PCH(8/9) : POWER
31.PCH(9/9) : GND
32.LCD CONNECTOR
33.RGB SWITCH
34.EXT CRT INTERFACE

BASE LOGIC :NZM3 SWG SDV
VER 1.22
APR/26/2010

70.THERMAL SENSOR
71.EEPROM/SMBUS SW
73.BATTERY INPUT
74.BATTERY CHARGER(BQ24742)
75.CHARGE SELECTOR
76.BATTERY MONITOR
77.POWER SEQUENCE
78.DC/DC VCC5M/VCC3M(TPS51220ARSNR)
79.DC/DC VCCCPUCORE(VT1316/VT1317)
80.BLANK
81.DC/DC VCCGFXCORE_I(VT1317)
82.VCCCPUCORE DECOUPLING
83.DC/DC VCCGFXCORE_D(ADP3211)
84.DC/DC VCC1R05B_VTT(VT357)
85.DC/DC VCC1R05LAN(VT356)
86.DC/DC VCC1R5A(VT357)
87.DC/DC VCC0R75B(MAX1510)
88.DC/DC VCC1R5VIDEO(BD9139)
89.DC/DC VCC1R8B(TPS62290)
90.DC/DC VCCSA(VT356)
91.DC/DC RINKAN-2
92.LOAD SW LAN
93.LOAD SW VIDEO
94.LOAD SW AMT/ MEPWRG
95.LOAD SW B
96.LOAD SW VCC5MUBAY
97.LOAD SW WAN & WLAN
98.PTH FOR SCREW HOLES
99.BLANK

Project Name : NOZOMI-3 SWG SDV2 NOZOMI-3 SWG SDV2 NOZOMI-3 SWG SDV2 | Title : TITLE PAGE TITLE PAGE TITLE PAGE

Size : C | Document Number : | Rev :

Monday, June 14, 2010 Monday, June 14, 2010 Monday, June 14, 2010 Date: | 01 01 01 99 99 99 Sheet : of

# EC HISTORY

# NOZOMI-3 PRE-DV :BASE LOGIC NZM1 EXT 512MB SIT VER.7.03 12/01/2009

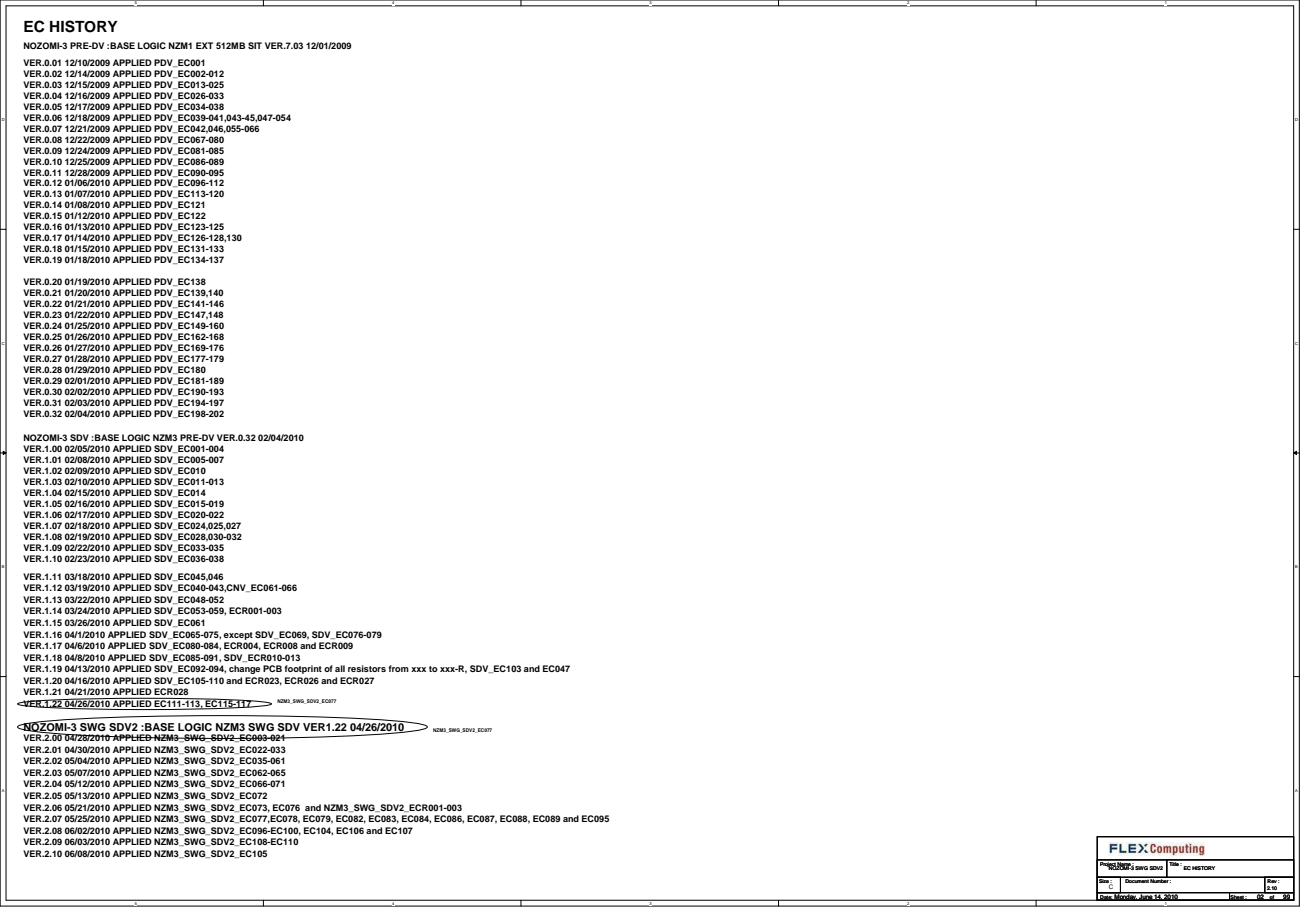
[picture p56: page 2]
Monday, June 14, 2010; NOZOMI-3 SWG SDV2; EC HISTORY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

NOZOMI-3 SDV :BASE LOGIC NZM3 PRE-DV VER.0.32 02/04/2010
VER.1.00 02/05/2010 APPLIED SDV_EC001-004
VER.1.01 02/08/2010 APPLIED SDV_EC005-007
VER.1.02 02/09/2010 APPLIED SDV_EC010
VER.1.03 02/10/2010 APPLIED SDV_EC011-013
VER.1.04 02/15/2010 APPLIED SDV_EC014
VER.1.05 02/16/2010 APPLIED SDV_EC015-019
VER.1.06 02/17/2010 APPLIED SDV_EC020-022
VER.1.07 02/18/2010 APPLIED SDV_EC024,025,027
VER.1.08 02/19/2010 APPLIED SDV_EC028,030-032
VER.1.09 02/22/2010 APPLIED SDV_EC033-035
VER.1.10 02/23/2010 APPLIED SDV_EC036-038
VER.1.11 03/18/2010 APPLIED SDV_EC045,046
VER.1.12 03/19/2010 APPLIED SDV_EC040-043,CNV_EC061-066
VER.1.13 03/22/2010 APPLIED SDV_EC048-052
VER.1.14 03/24/2010 APPLIED SDV_EC053-059, ECR001-003
VER.1.15 03/26/2010 APPLIED SDV_EC061
VER.1.16 04/1/2010 APPLIED SDV_EC065-075, except SDV_EC069, SDV_EC076-079
VER.1.17 04/6/2010 APPLIED SDV_EC080-084, ECR004, ECR008 and ECR009
VER.1.18 04/8/2010 APPLIED SDV_EC085-091, SDV_ECR010-013
VER.1.19 04/13/2010 APPLIED SDV_EC092-094, change PCB footprint of all resistors from xxx to xxx-R, SDV_EC103 and EC047
VER.1.20 04/16/2010 APPLIED SDV_EC105-110 and ECR023, ECR026 and ECR027
VER.1.21 04/21/2010 APPLIED ECR028
VER.1.22 04/26/2010 APPLIED EC111-113, EC115-117
NOZOMI-3 SWG SDV2 :BASE LOGIC NZM3 SWG SDV VER1.22 04/26/2010
VER.2.00 04/28/2010 APPLIED NZM3_SWG_SDV2_EC003-021
VER.2.01 04/30/2010 APPLIED NZM3_SWG_SDV2_EC022-033
VER.2.02 05/04/2010 APPLIED NZM3_SWG_SDV2_EC035-061
VER.2.03 05/07/2010 APPLIED NZM3_SWG_SDV2_EC062-065
VER.2.04 05/12/2010 APPLIED NZM3_SWG_SDV2_EC066-071
VER.2.05 05/13/2010 APPLIED NZM3_SWG_SDV2_EC072
VER.2.06 05/21/2010 APPLIED NZM3_SWG_SDV2_EC073, EC076 and NZM3_SWG_SDV2_ECR001-003
VER.2.07 05/25/2010 APPLIED NZM3_SWG_SDV2_EC077,EC078, EC079, EC082, EC083, EC084, EC086, EC087, EC088, EC089 and EC095
VER.2.08 06/02/2010 APPLIED NZM3_SWG_SDV2_EC096-EC100, EC104, EC106 and EC107
VER.2.09 06/03/2010 APPLIED NZM3_SWG_SDV2_EC108-EC110
VER.2.10 06/08/2010 APPLIED NZM3_SWG_SDV2_EC105

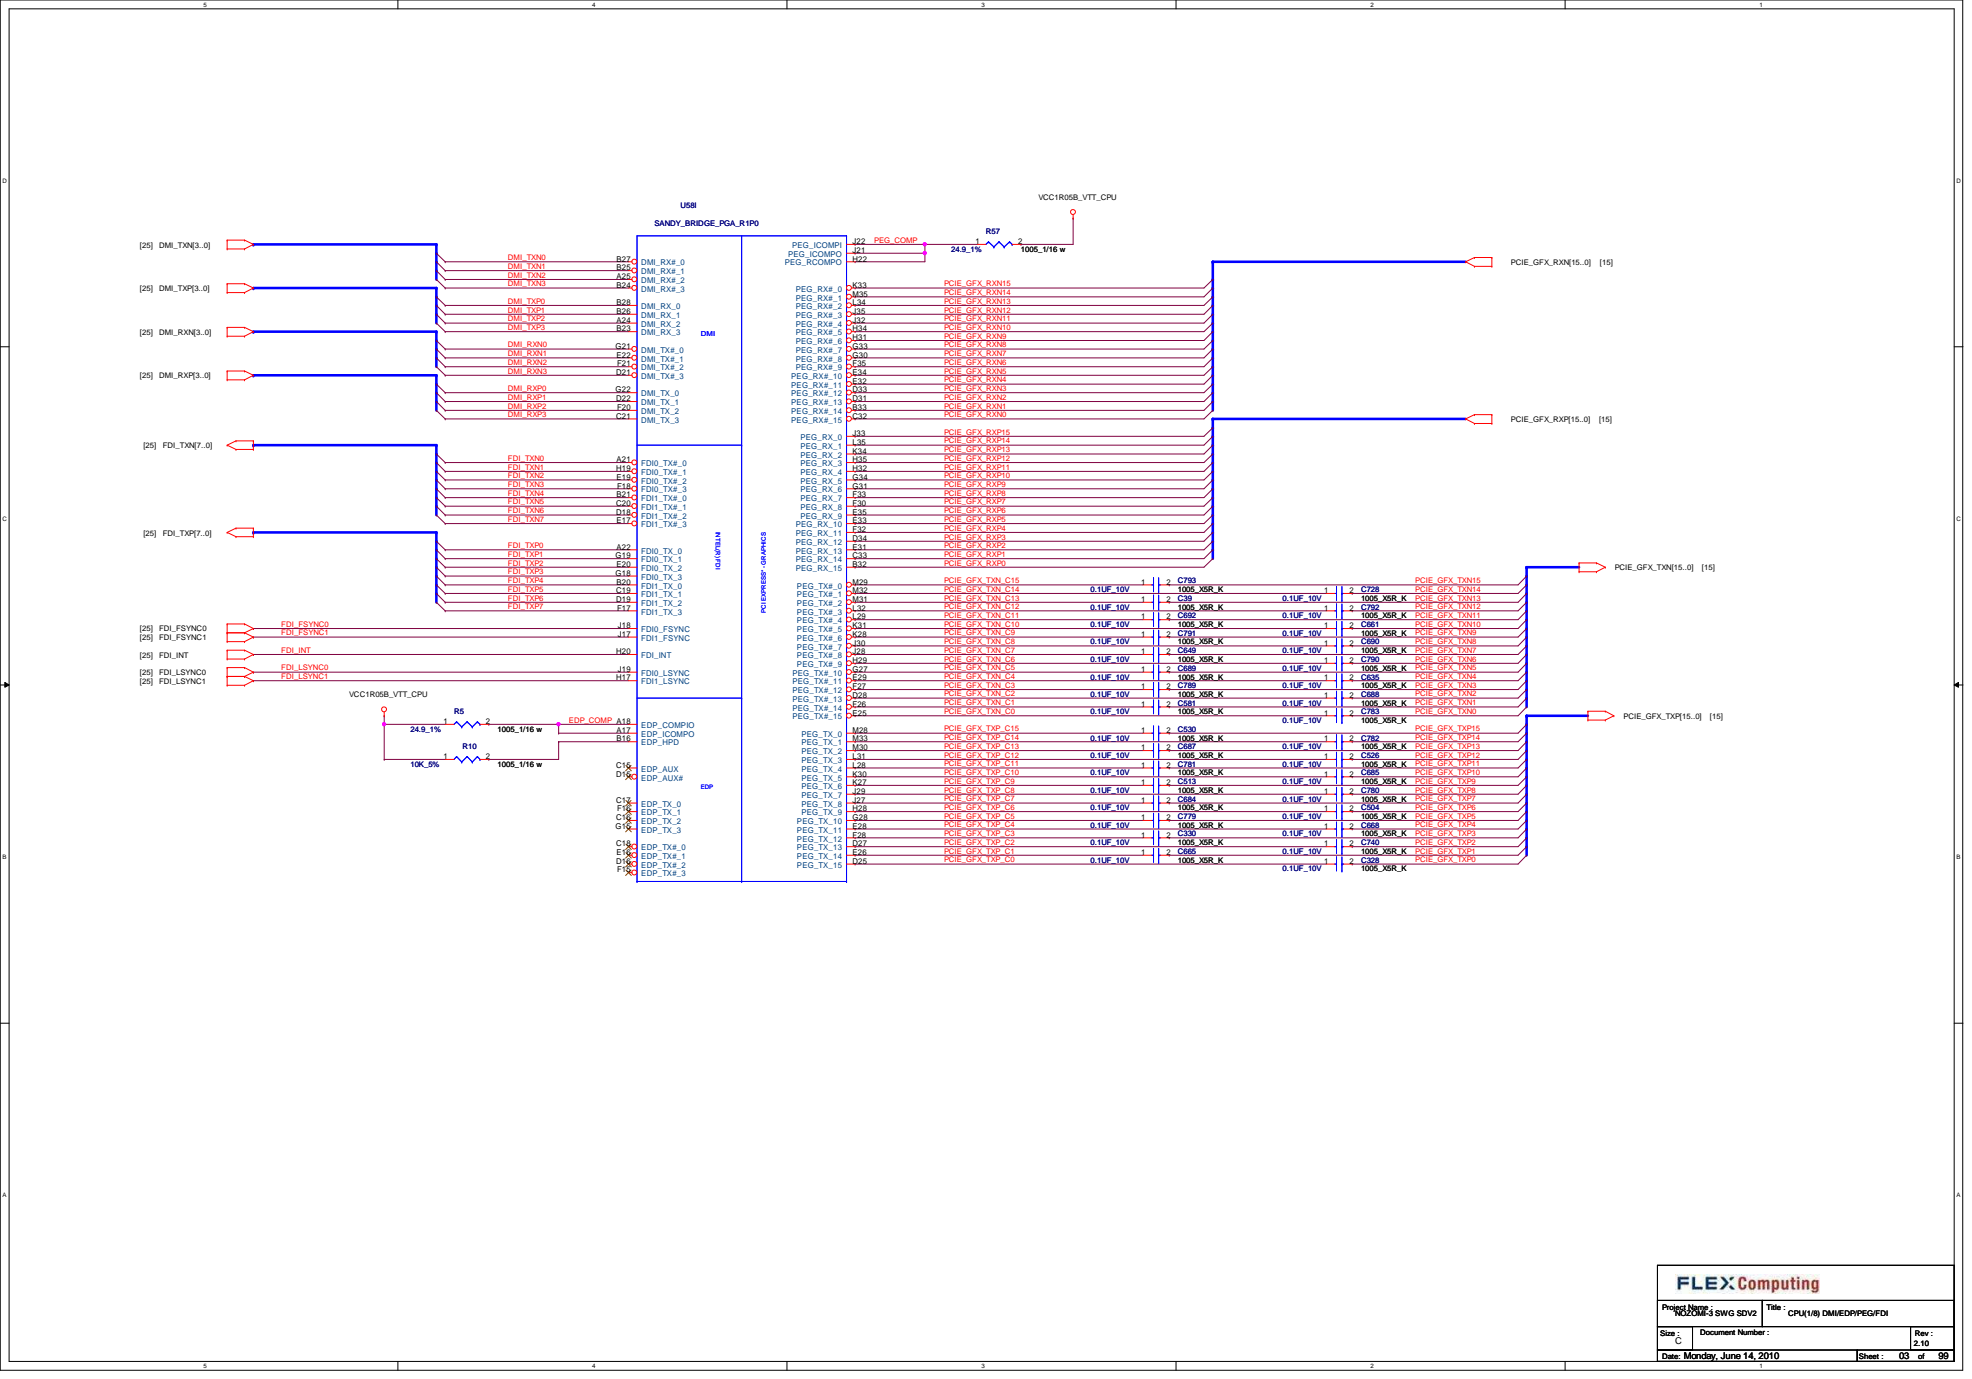
[picture p57: page 3]

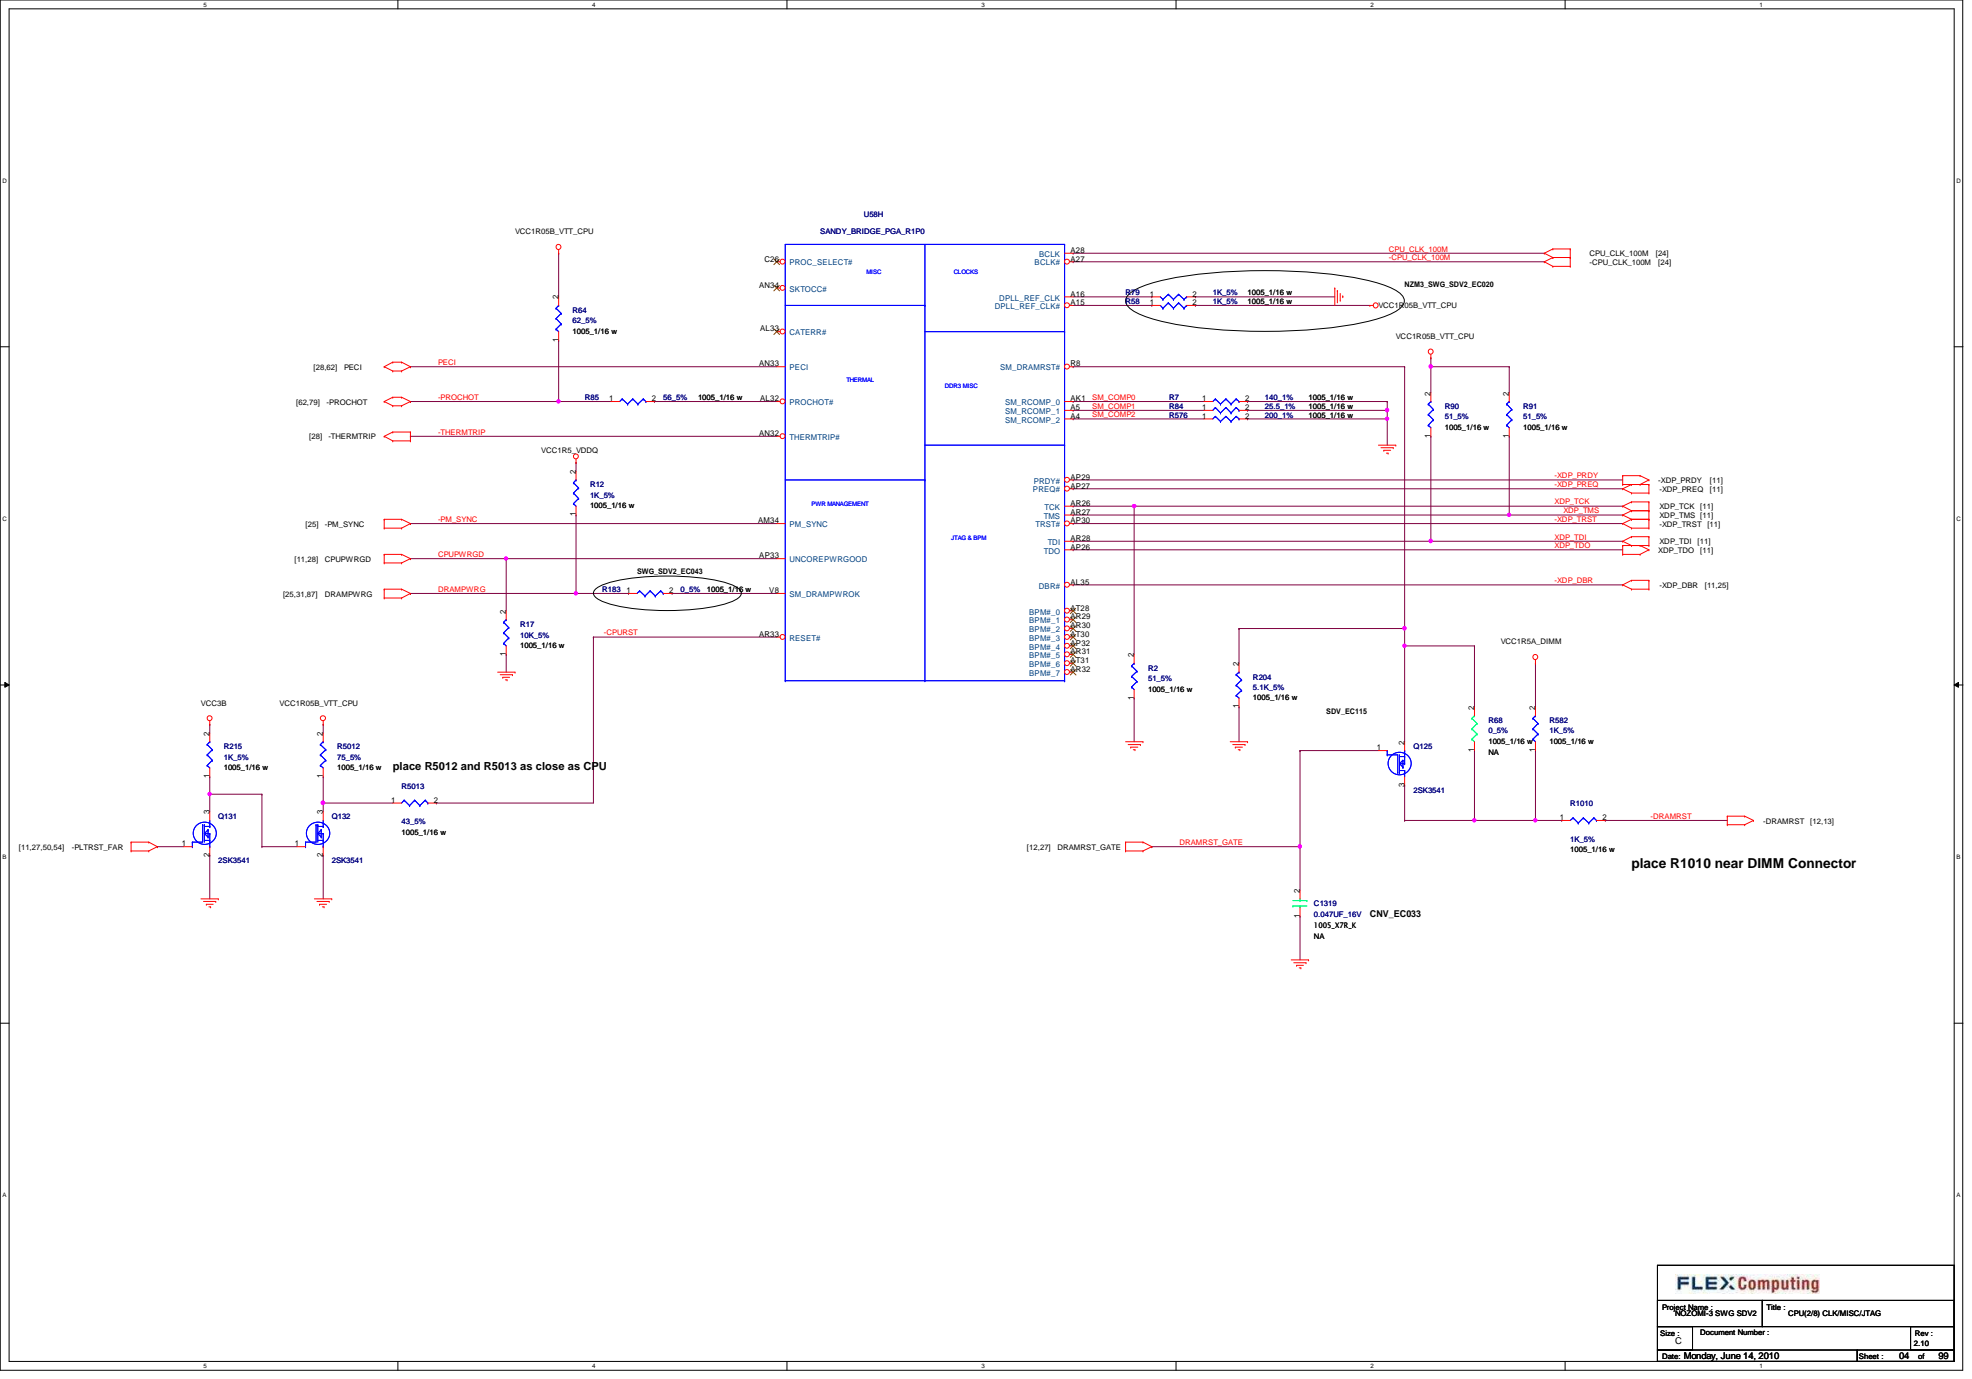
[picture p58: page 4]

place R5012 and R5013 as close as CPU

place R1010 near DIMM Connector

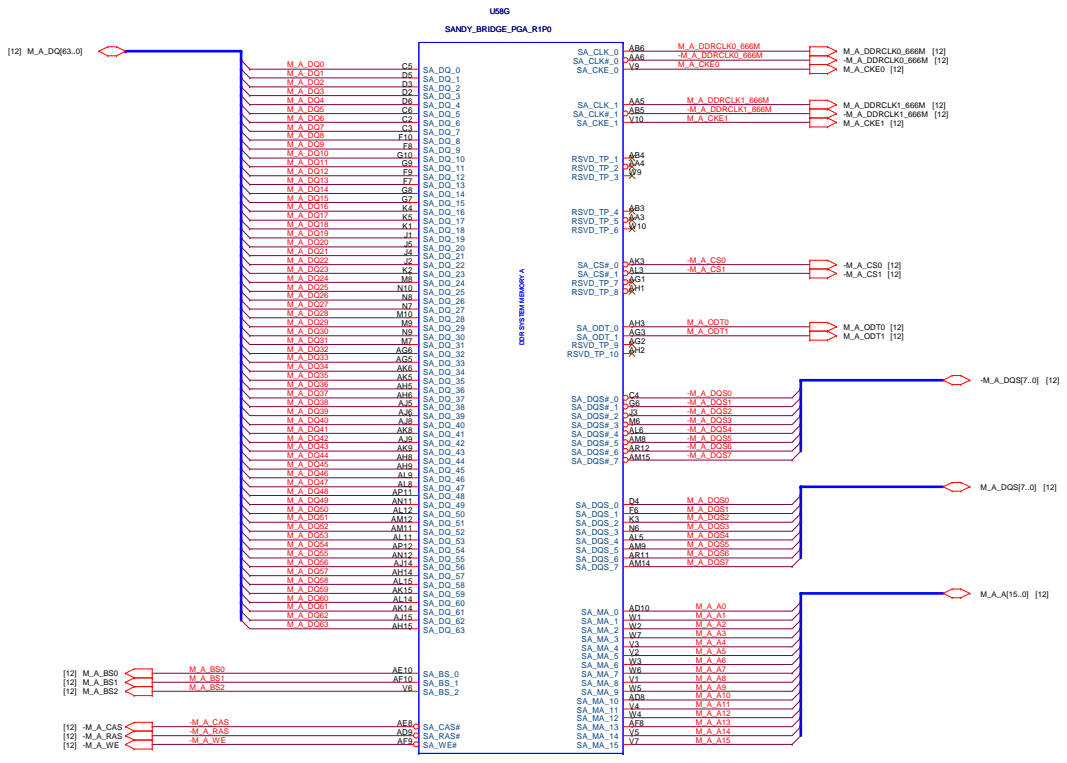
[picture p59: page 5]

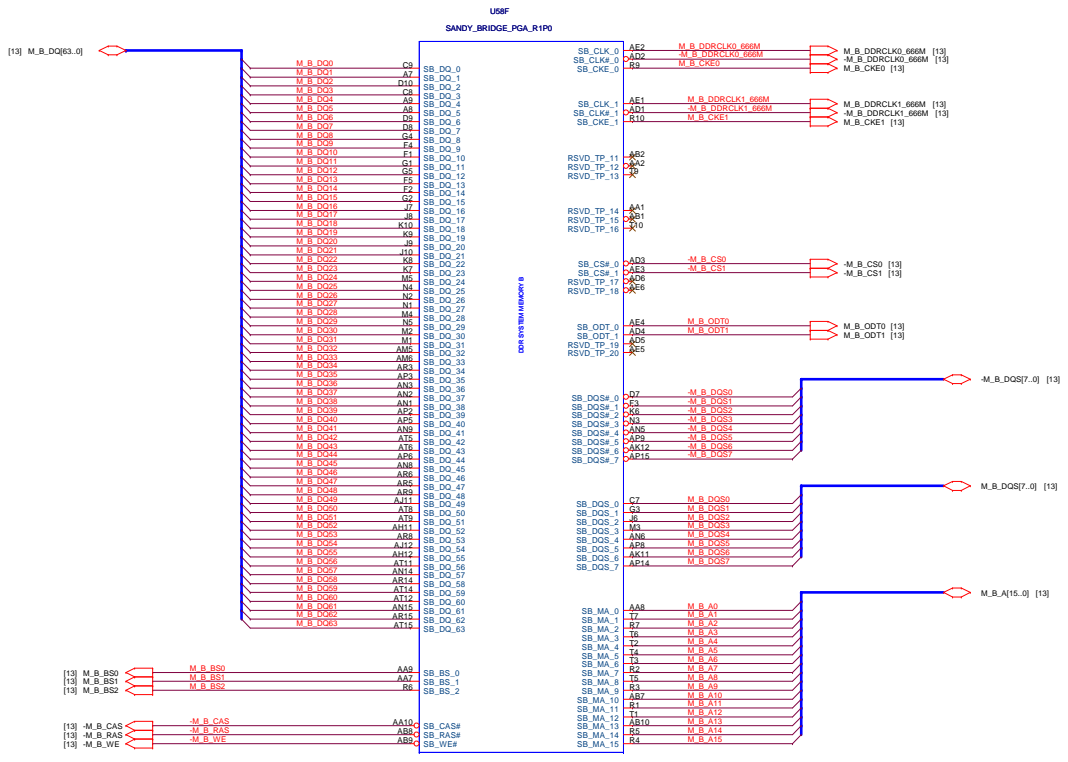
[picture p60: page 6]

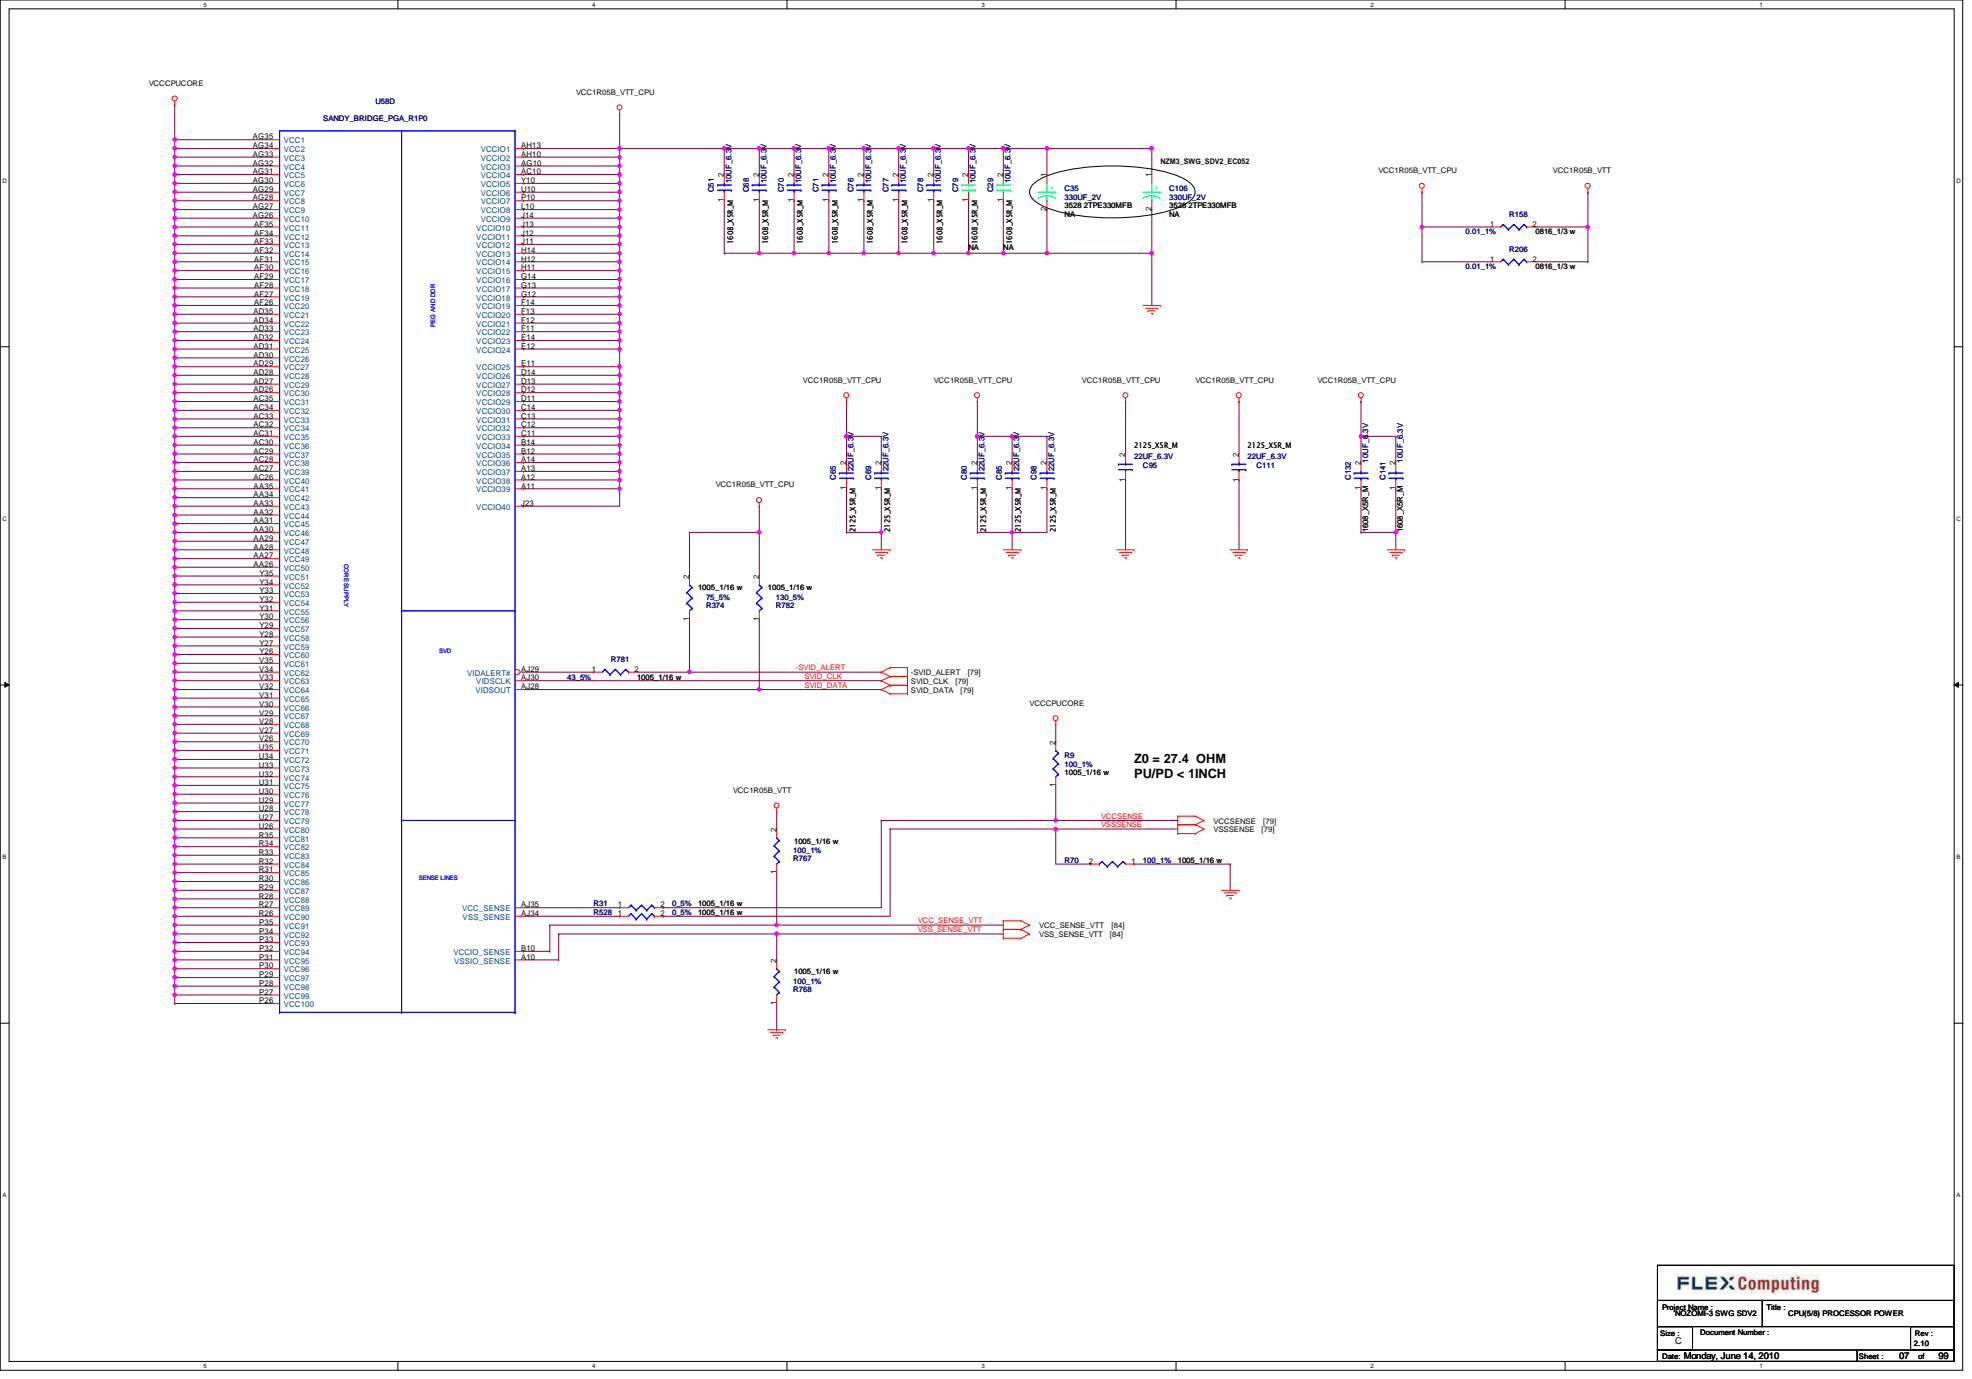
[picture p61: page 7]

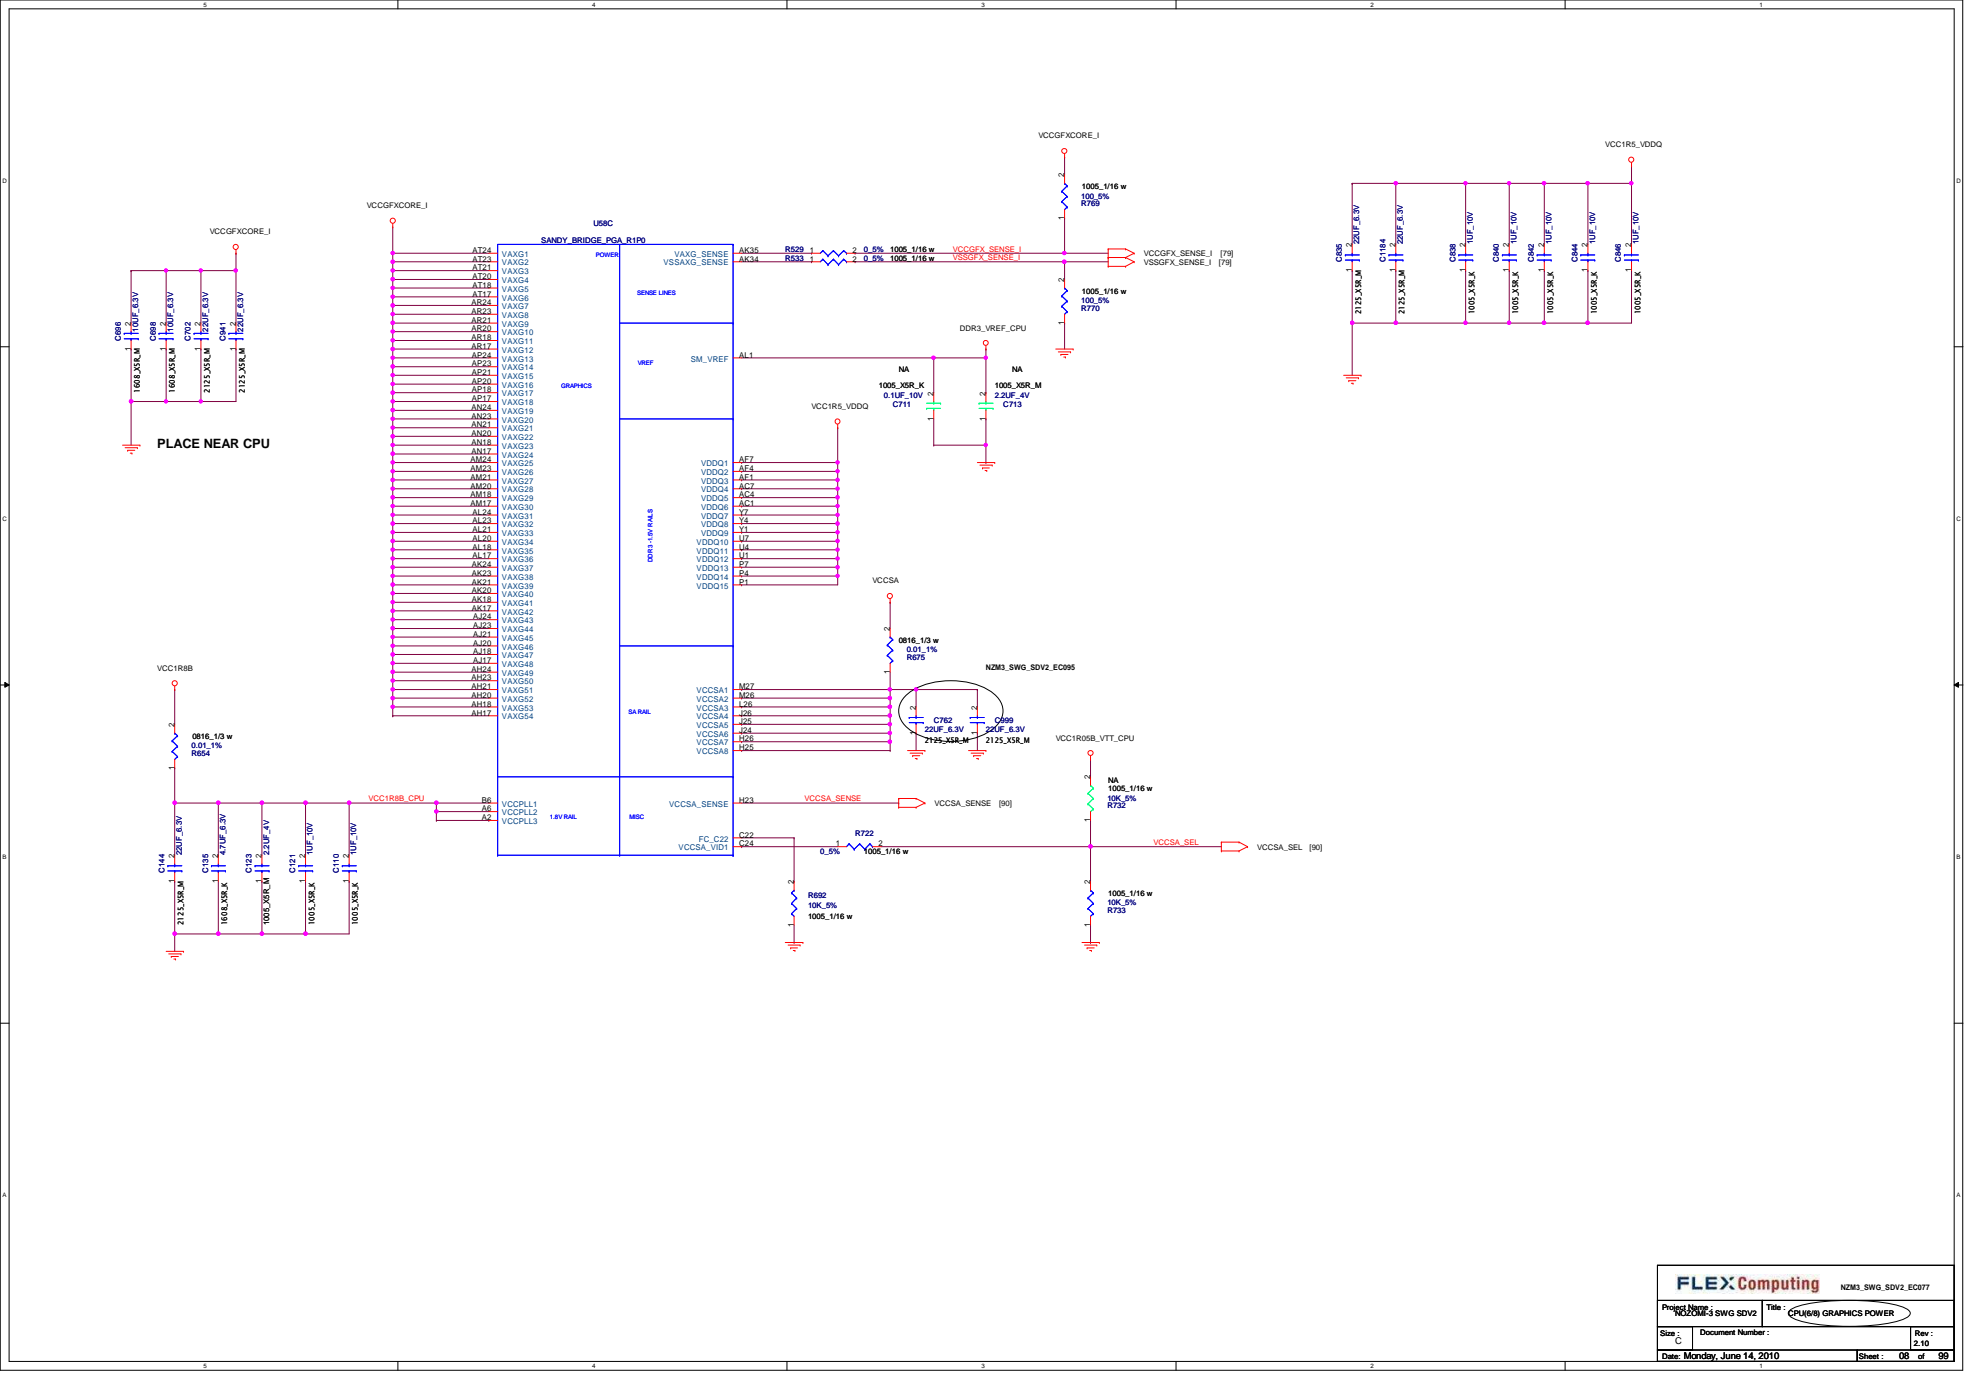
[picture p62: page 8]

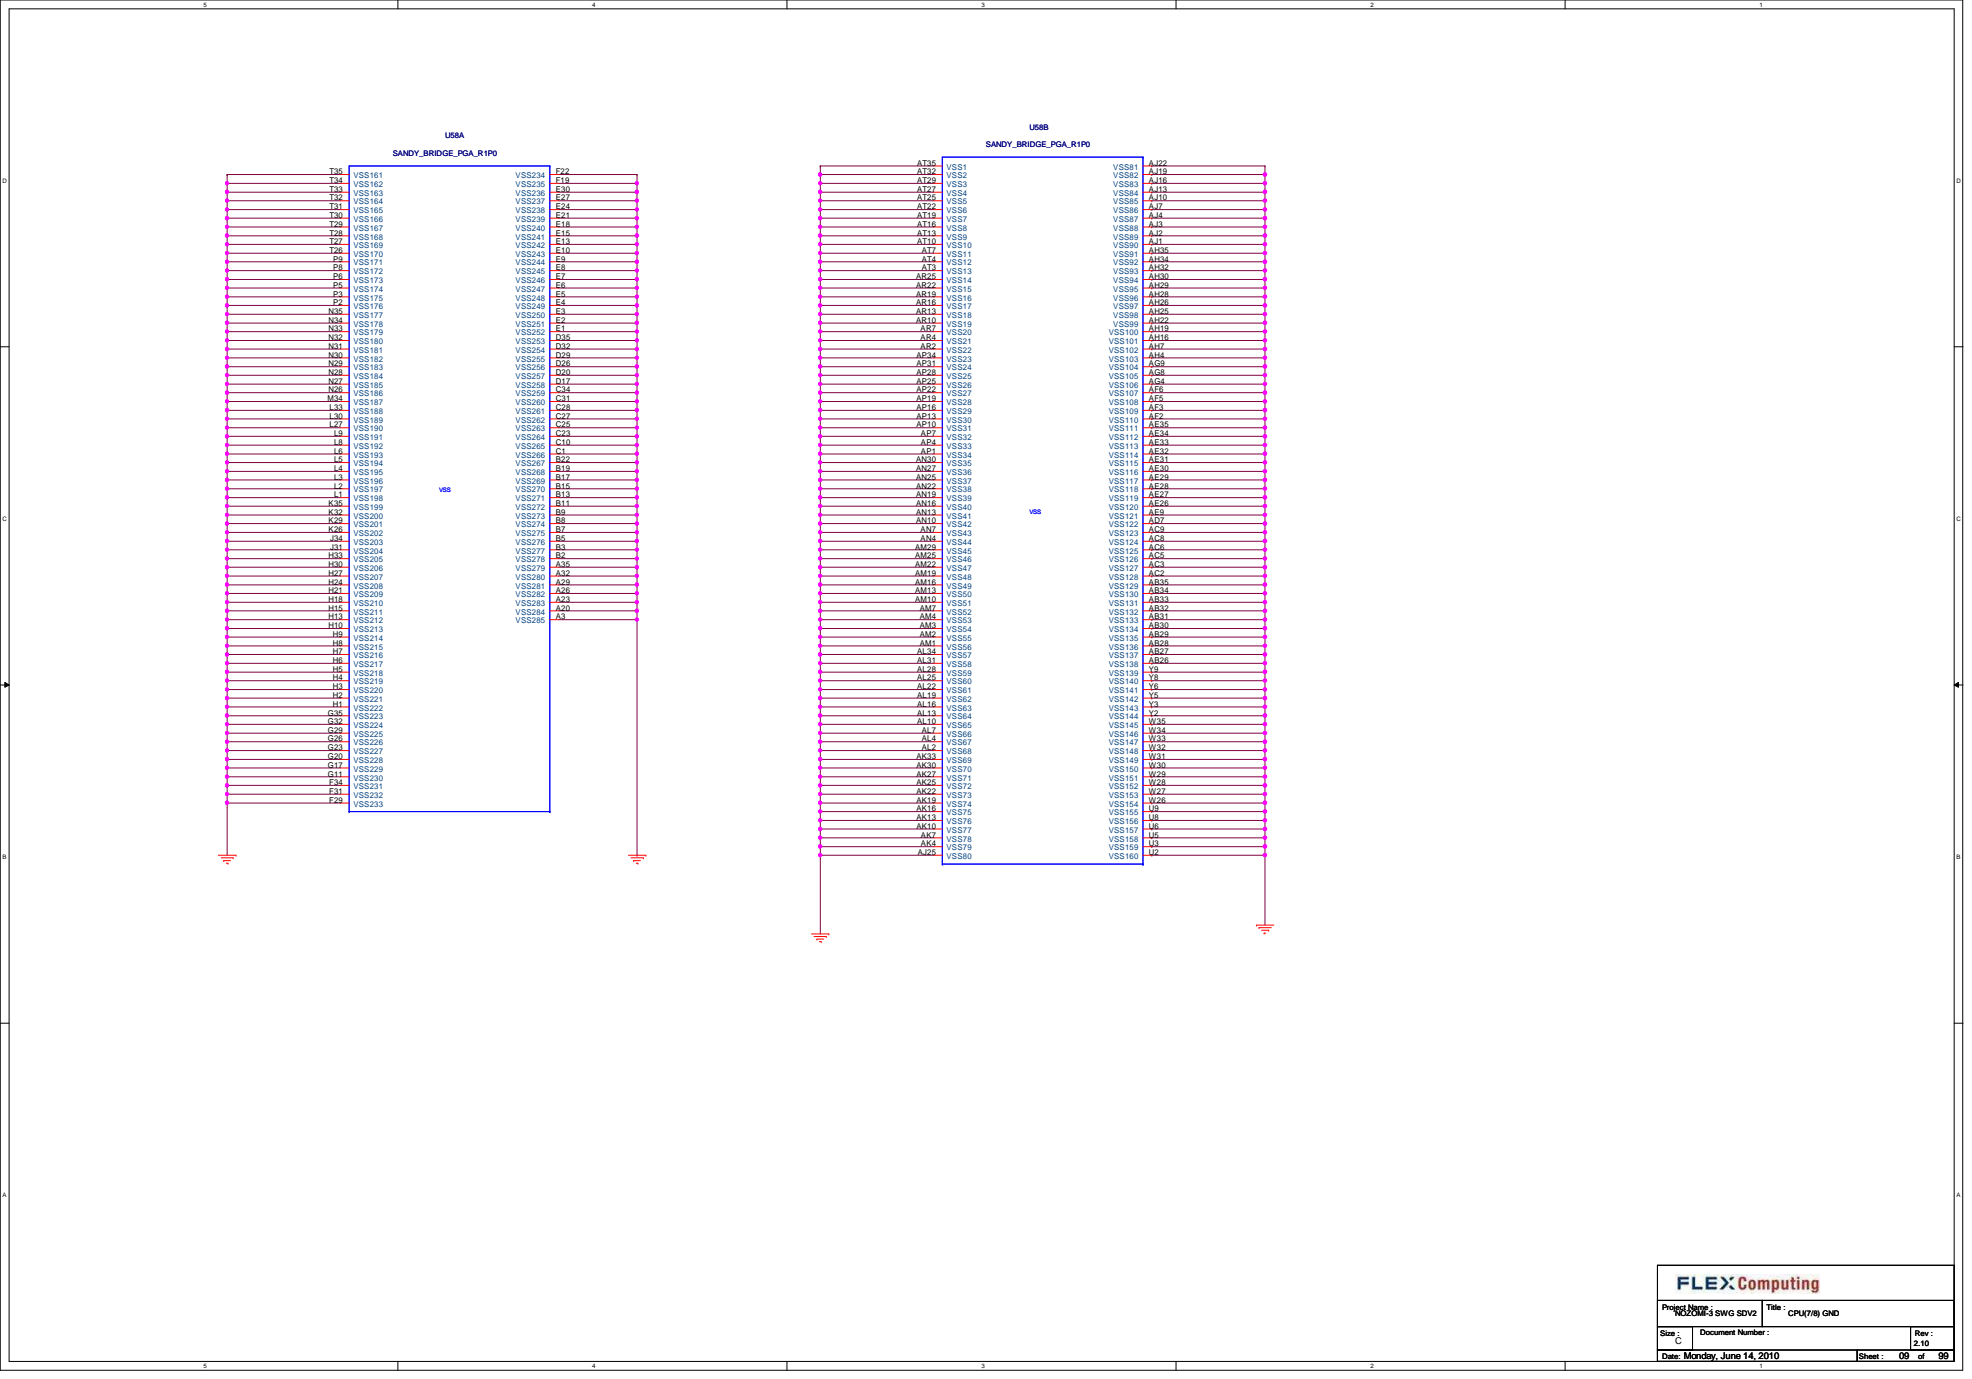
[picture p63: page 9]

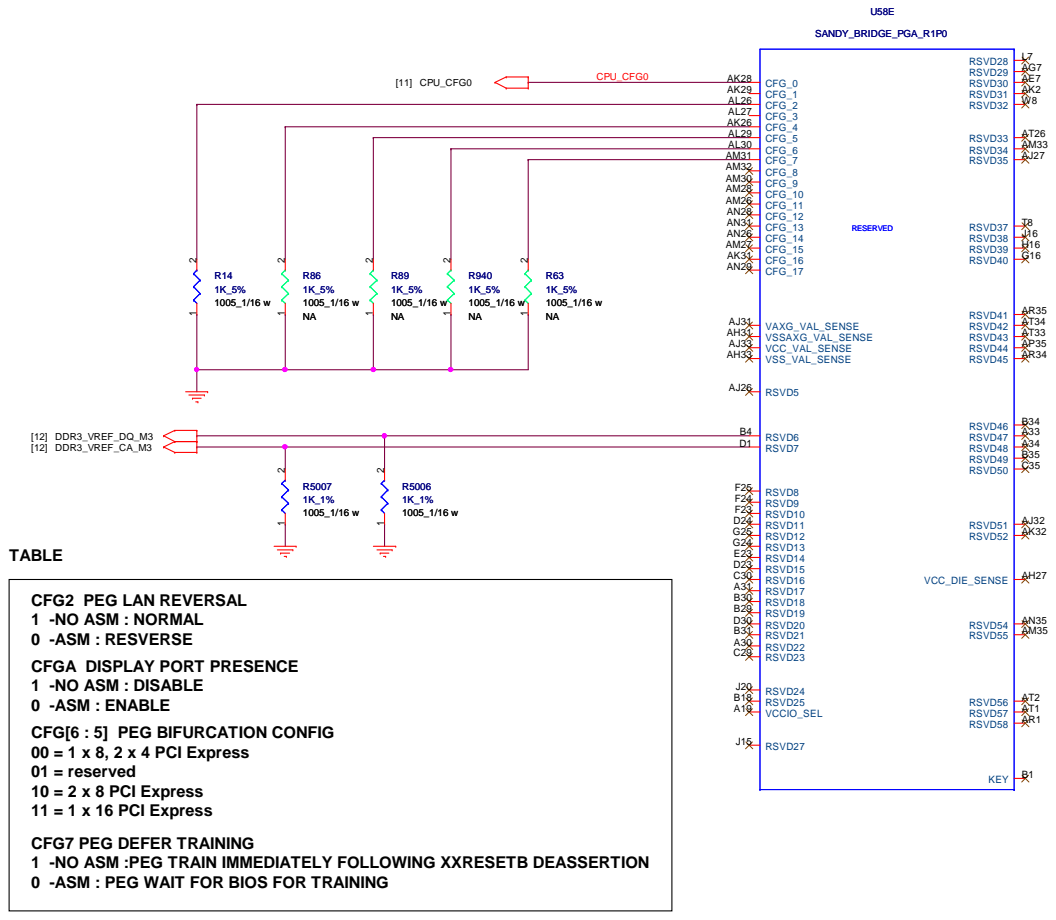
[picture p64: page 10]

CFG2 PEG LAN REVERSAL
1 -NO ASM : NORMAL
0 -ASM : RESVERSE
CFGA DISPLAY PORT PRESENCE
1 -NO ASM : DISABLE
0 -ASM : ENABLE
CFG[6 : 5] PEG BIFURCATION CONFIG
00 = 1 x 8, 2 x 4 PCI Express
01 = reserved
10 = 2 x 8 PCI Express
11 = 1 x 16 PCI Express
CFG7 PEG DEFER TRAINING
1 -NO ASM :PEG TRAIN IMMEDIATELY FOLLOWING XXRESETB DEASSERTION
0 -ASM : PEG WAIT FOR BIOS FOR TRAINING

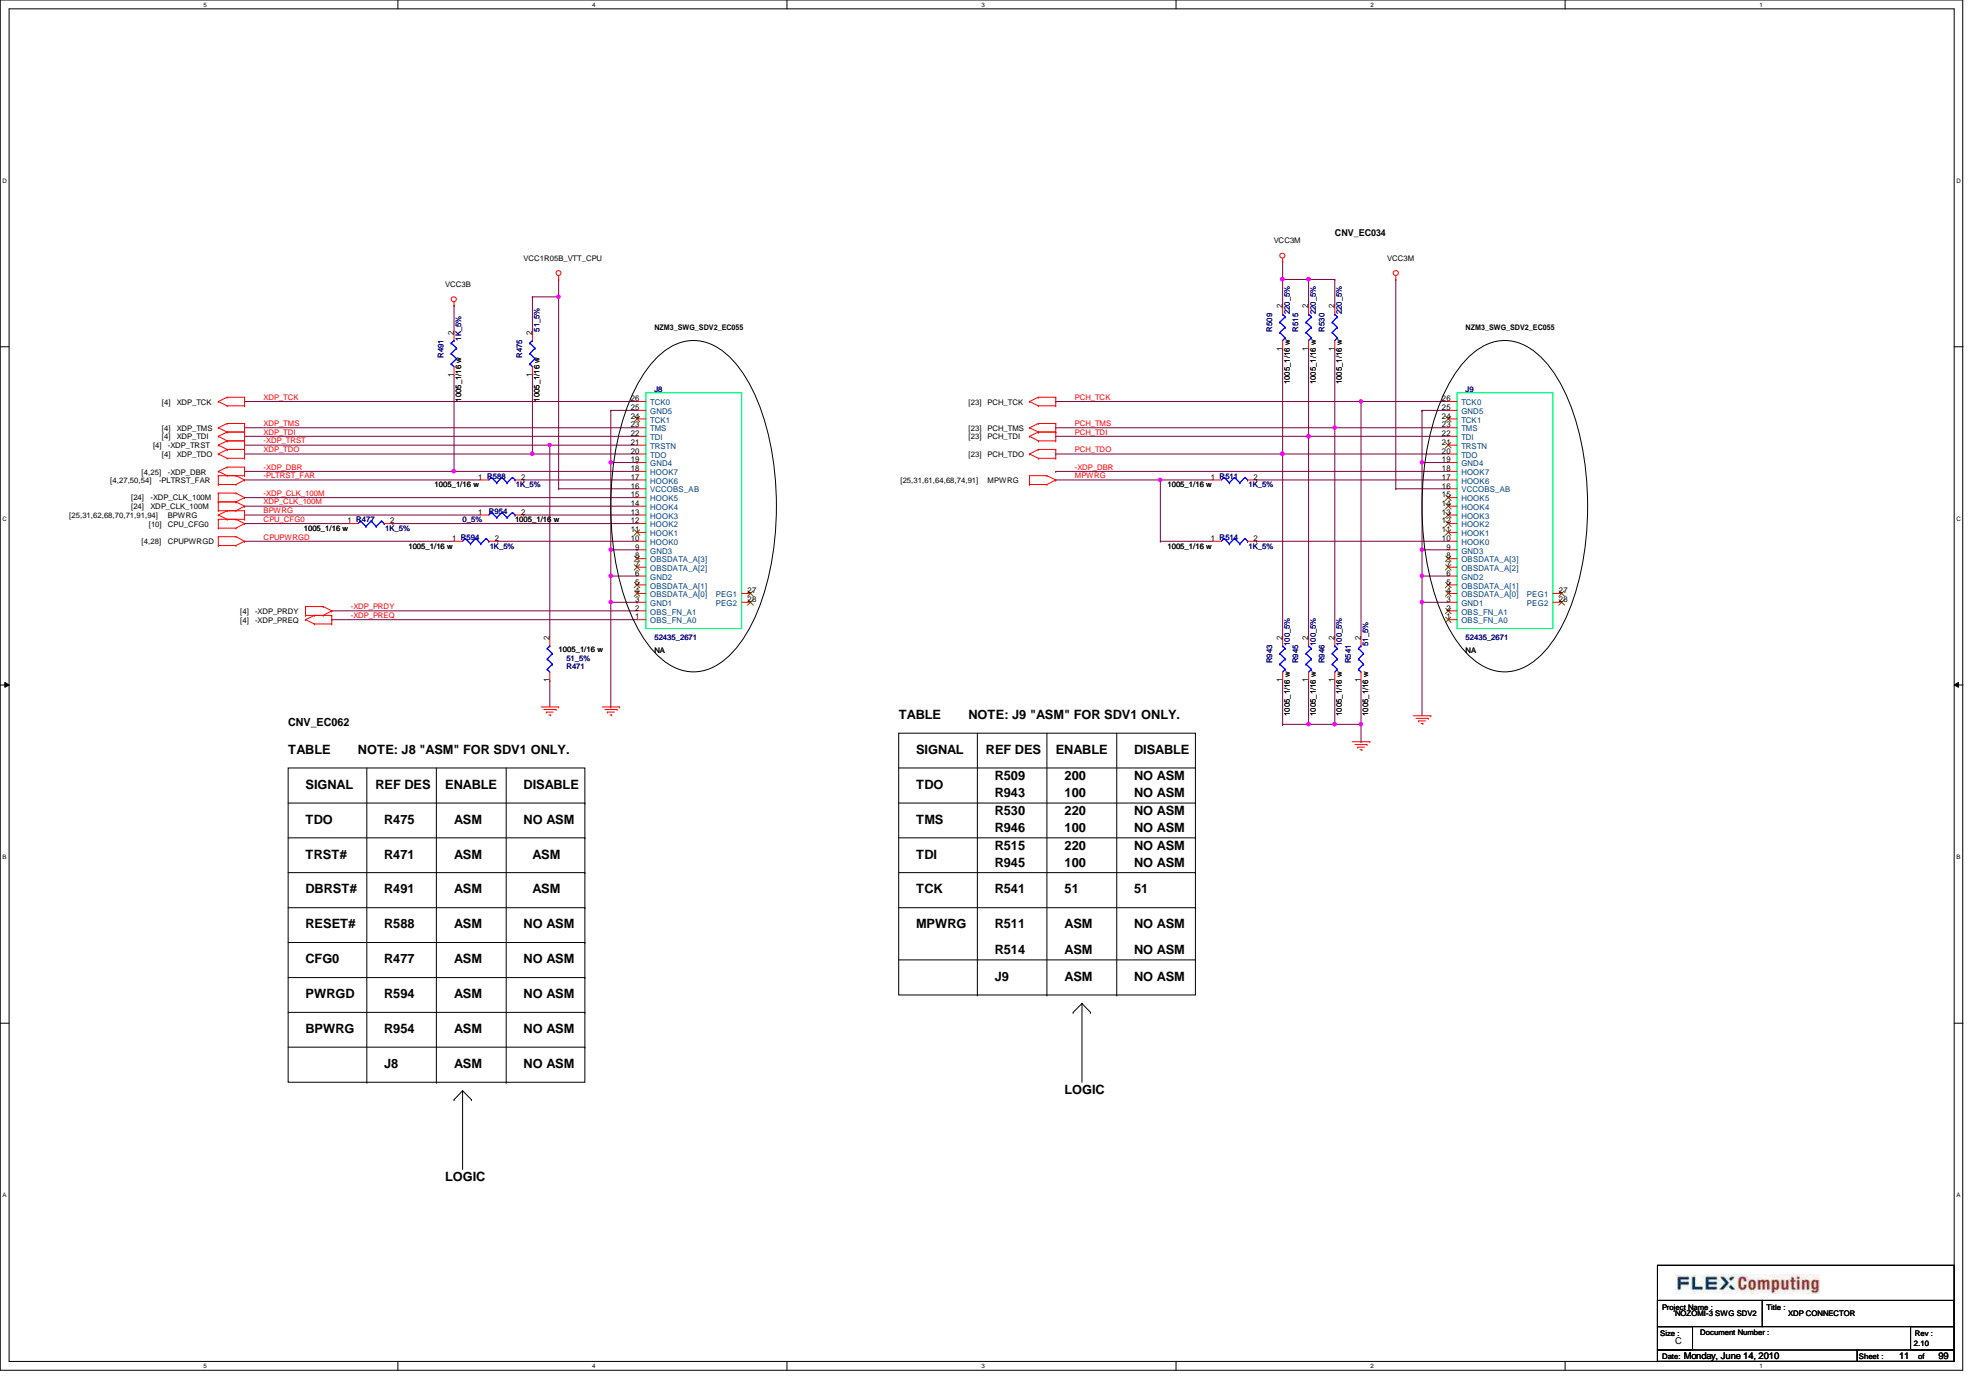
[picture p65: page 11]

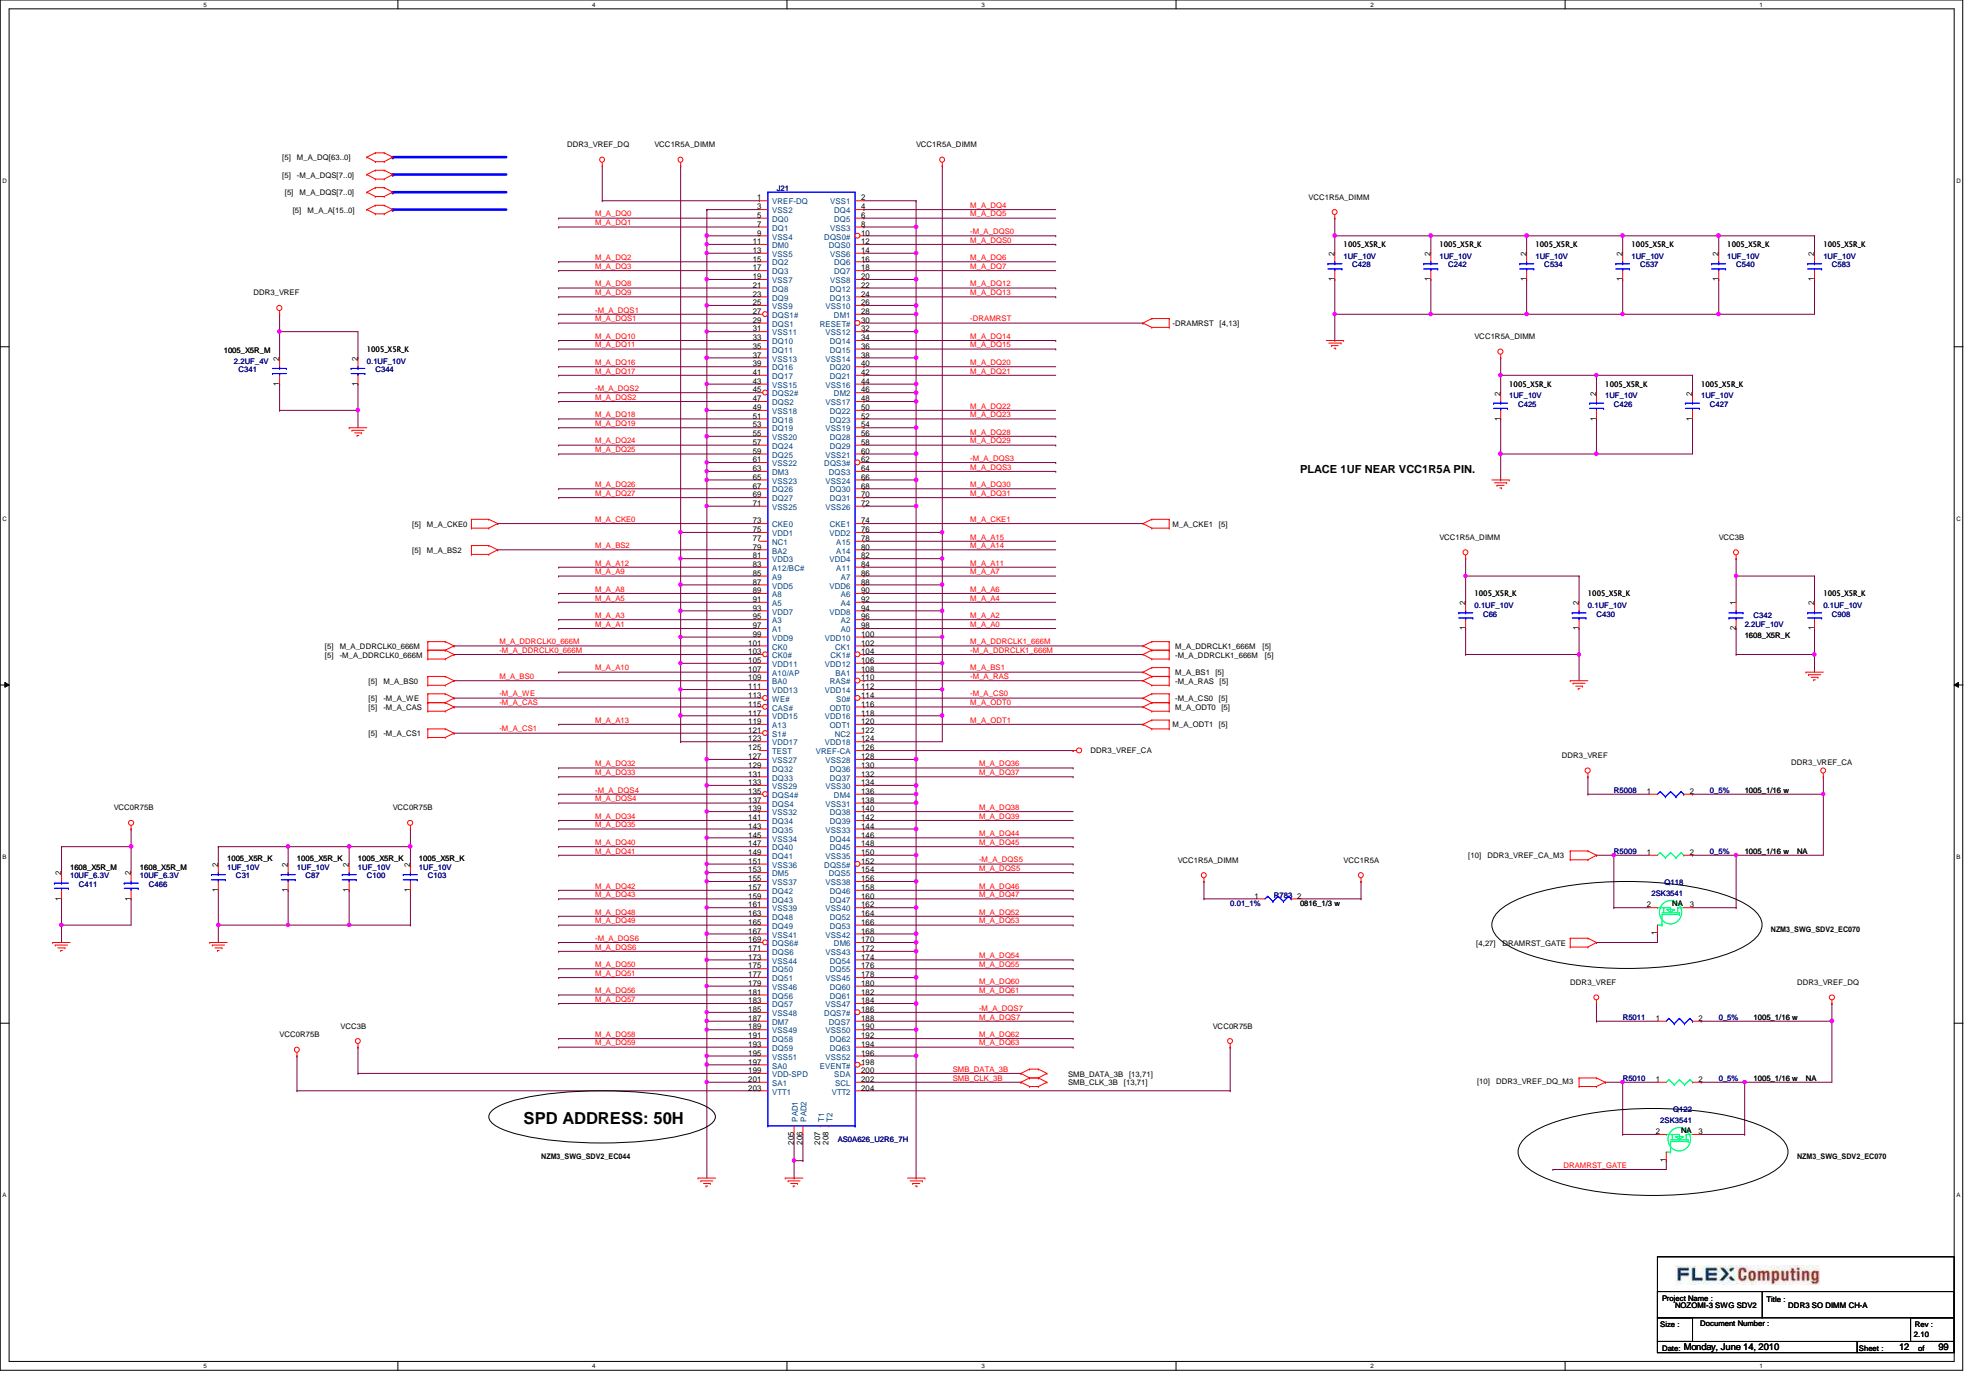
[picture p66: page 12]

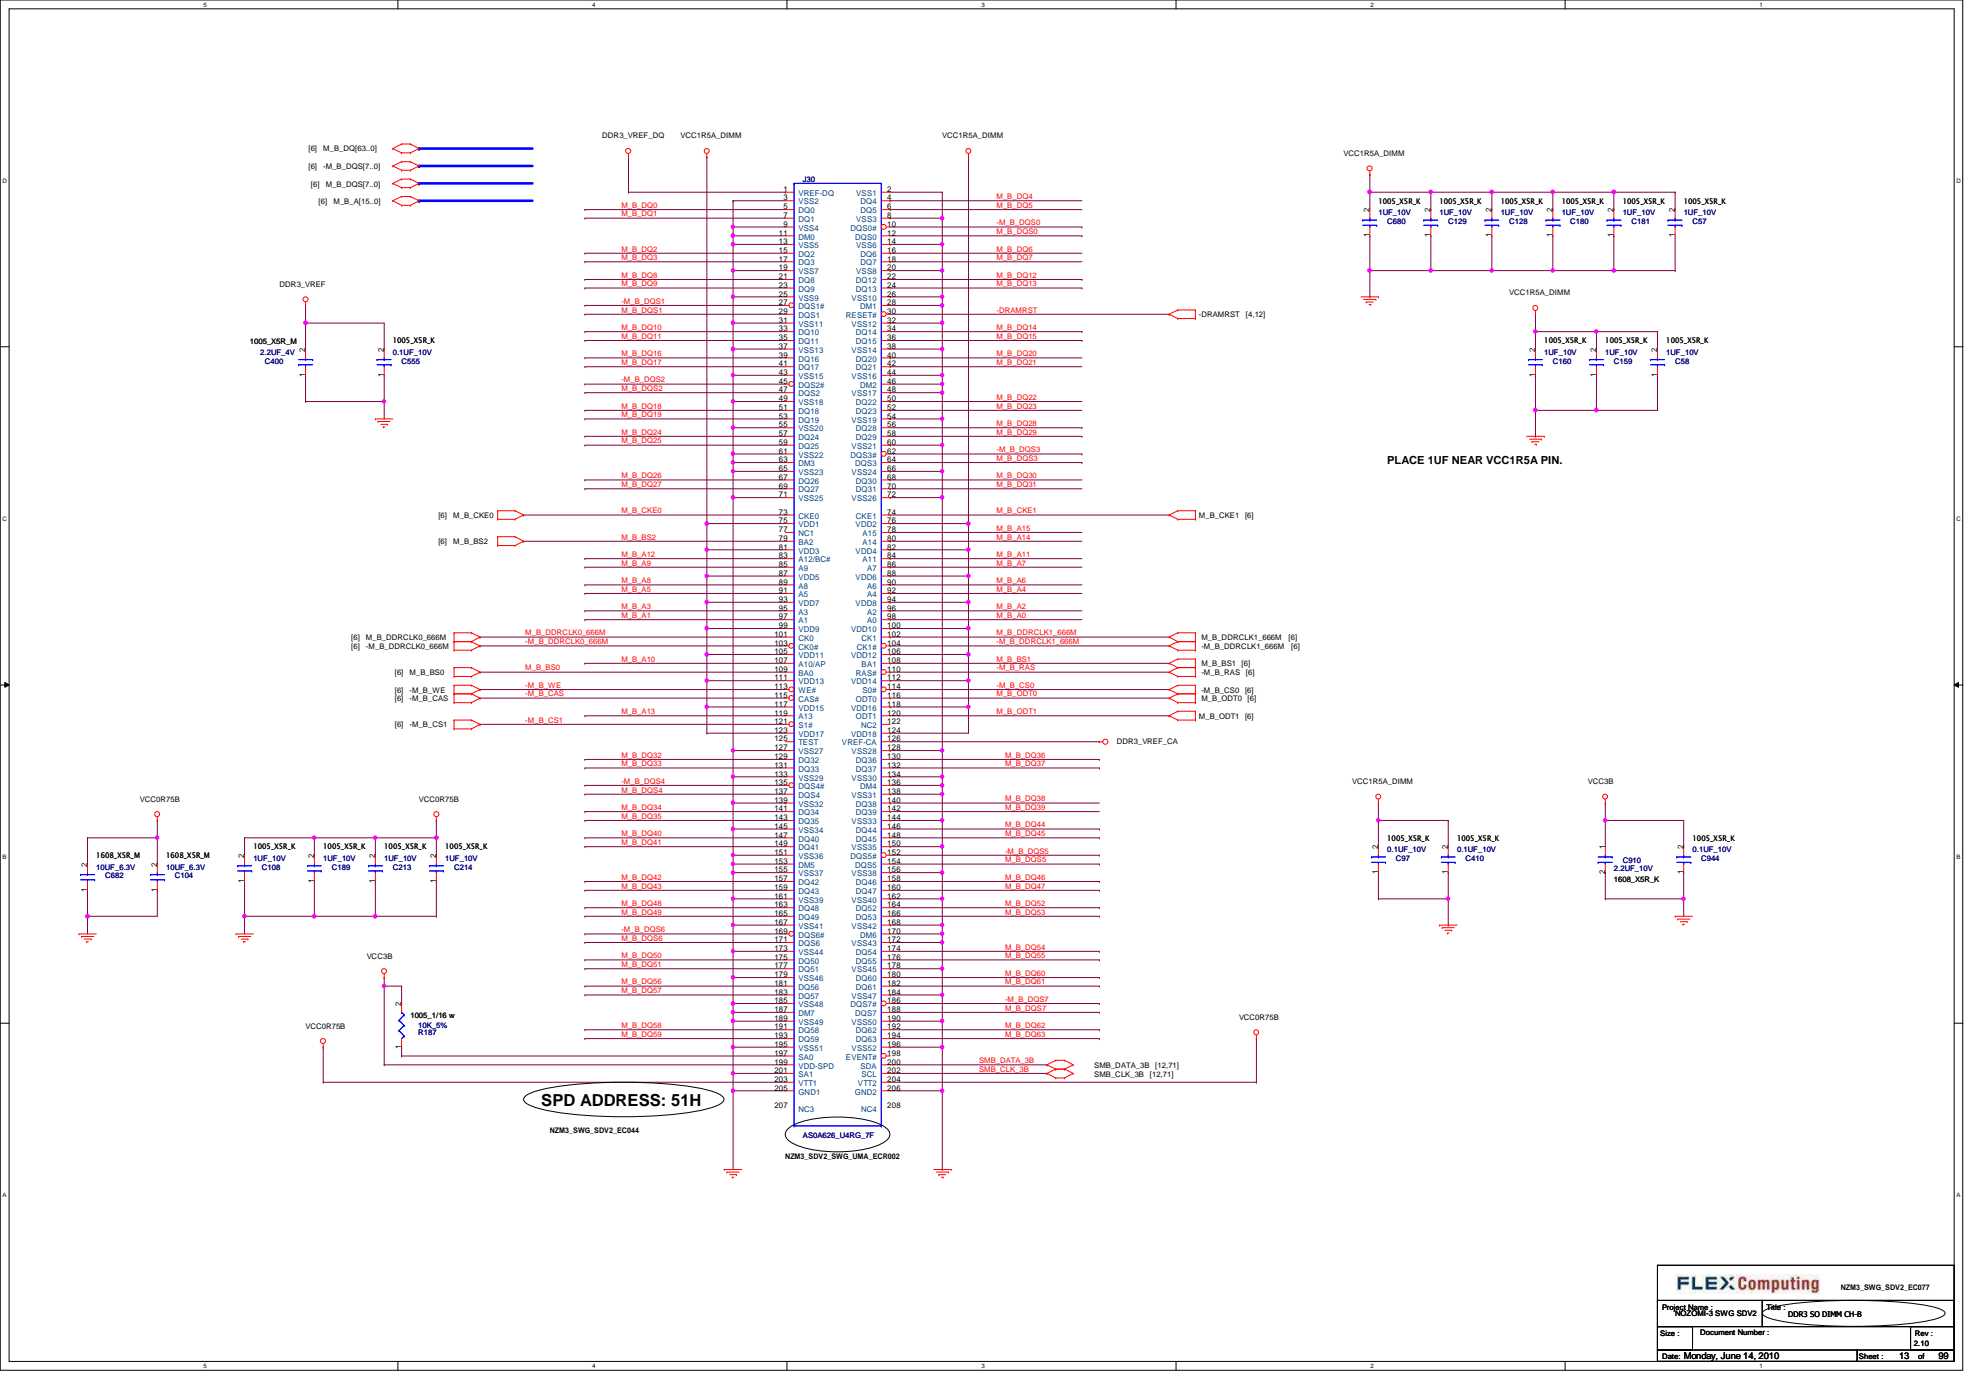
[picture p67: page 13]

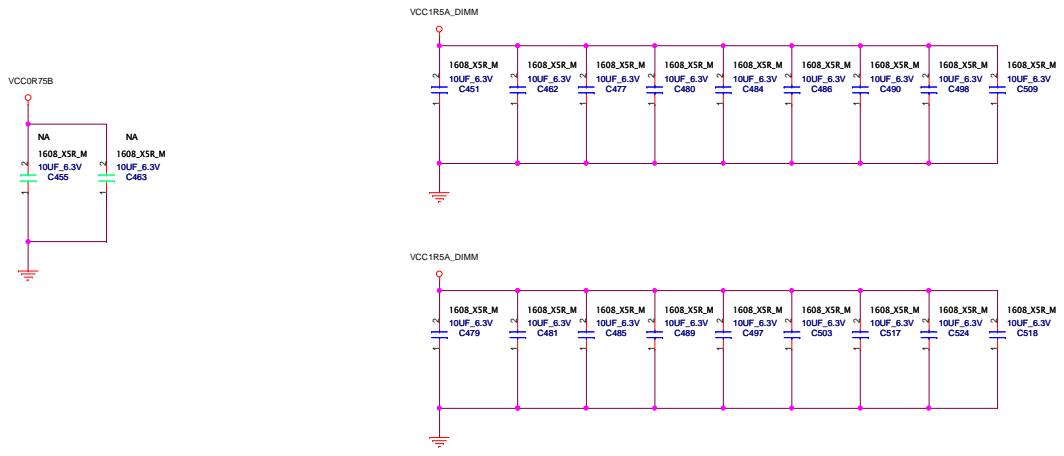
[picture p68: page 14]

1.6A

## PLACE C539 UNDER GPU

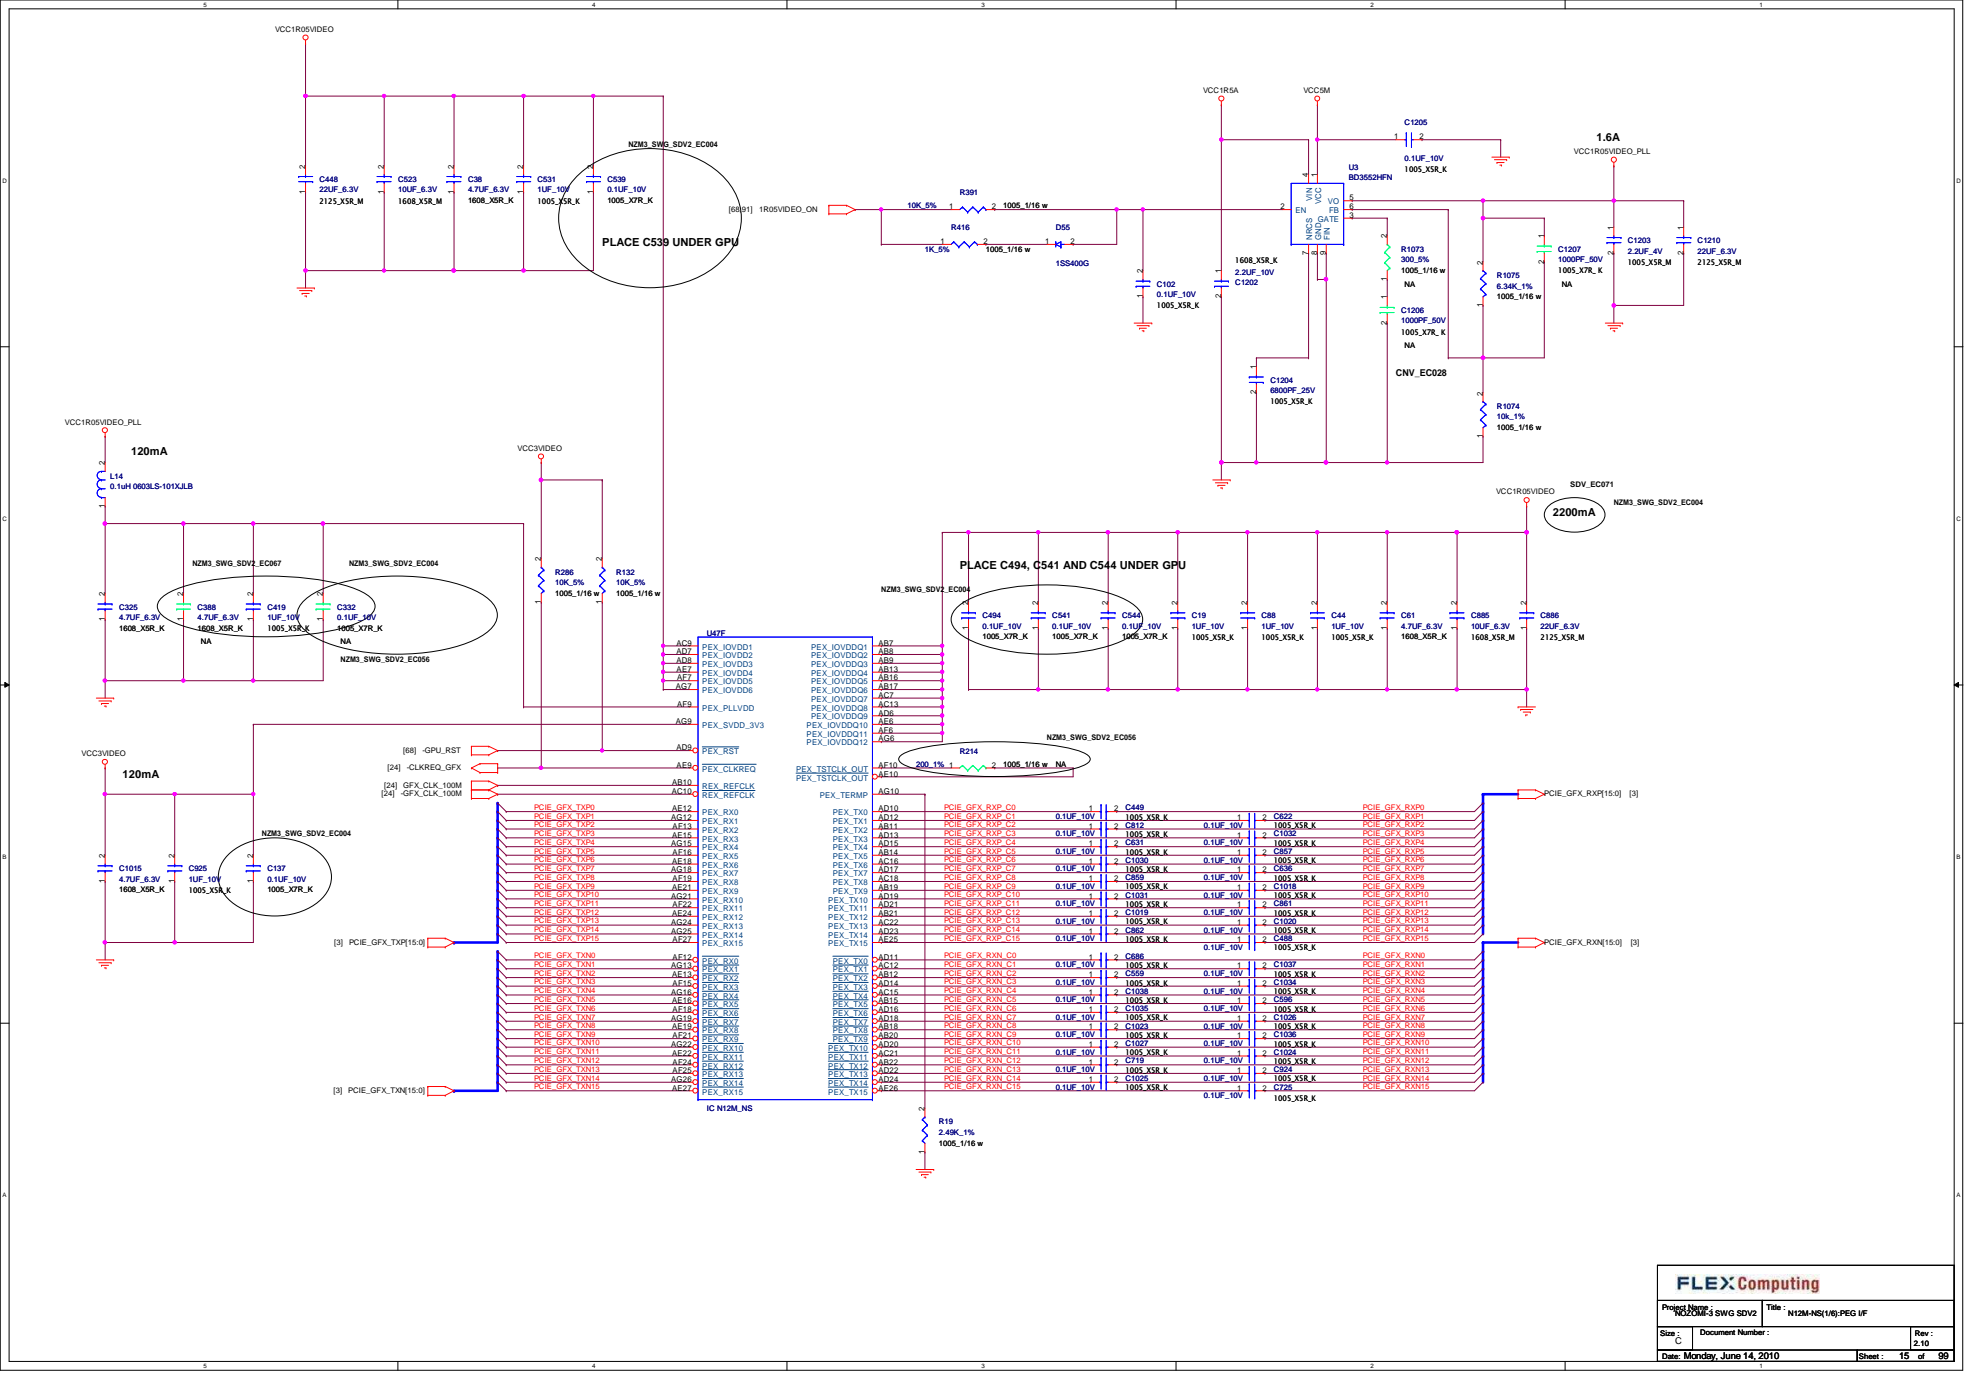
[picture p69: page 15]

PLACE C494, C541 AND C544 UNDER GPU

120mA

855mA

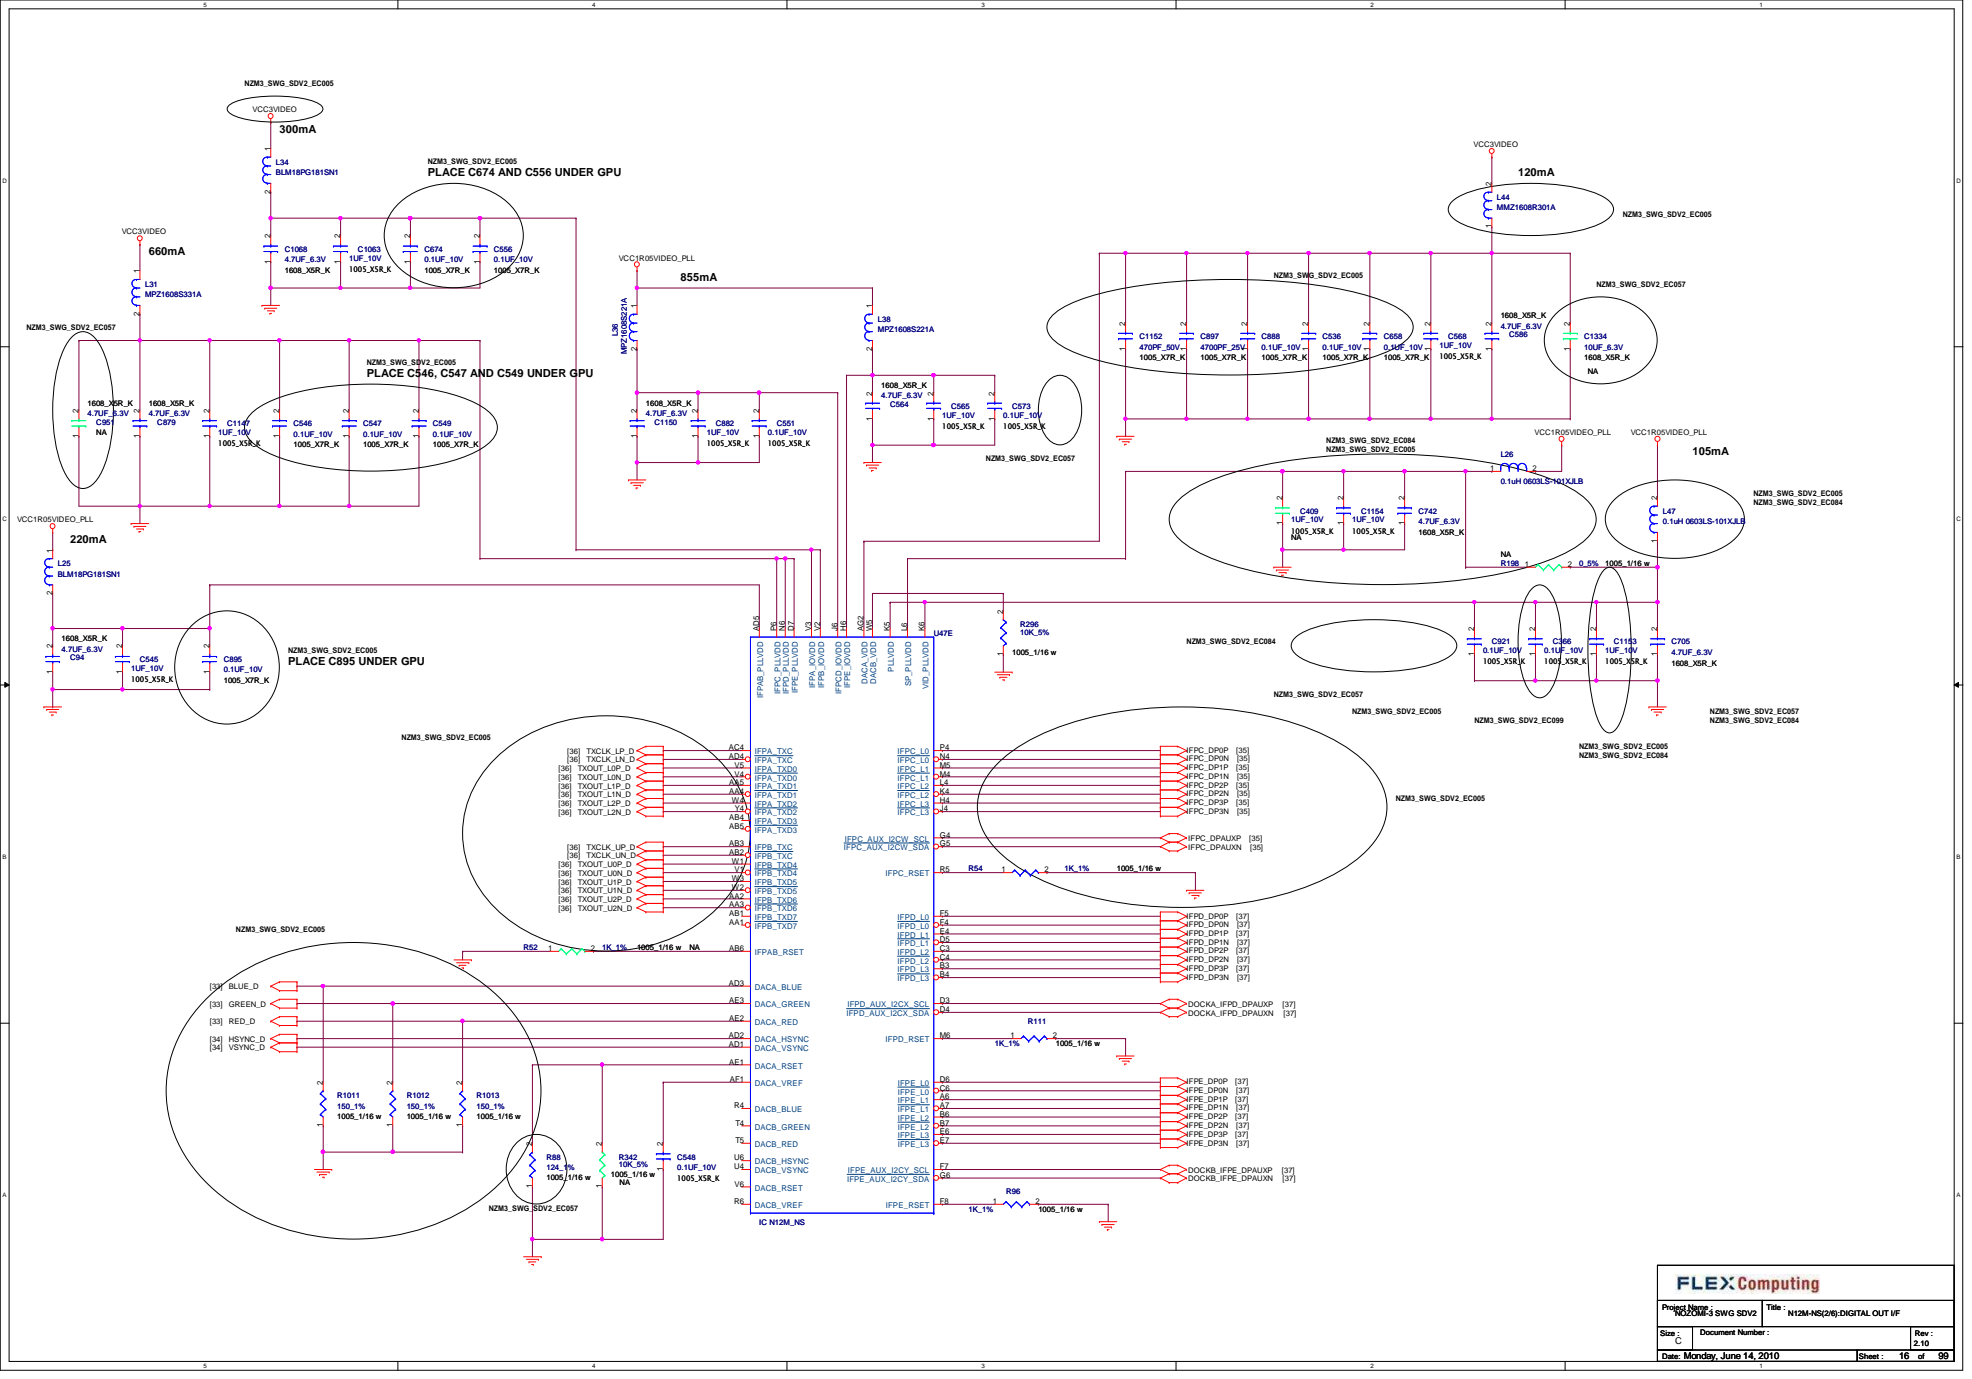
[picture p70: page 16]

NZM3_SWG_SDV2_EC005
PLACE C674 AND C556 UNDER GPU

PLACE C546, C547 AND C549 UNDER GPU

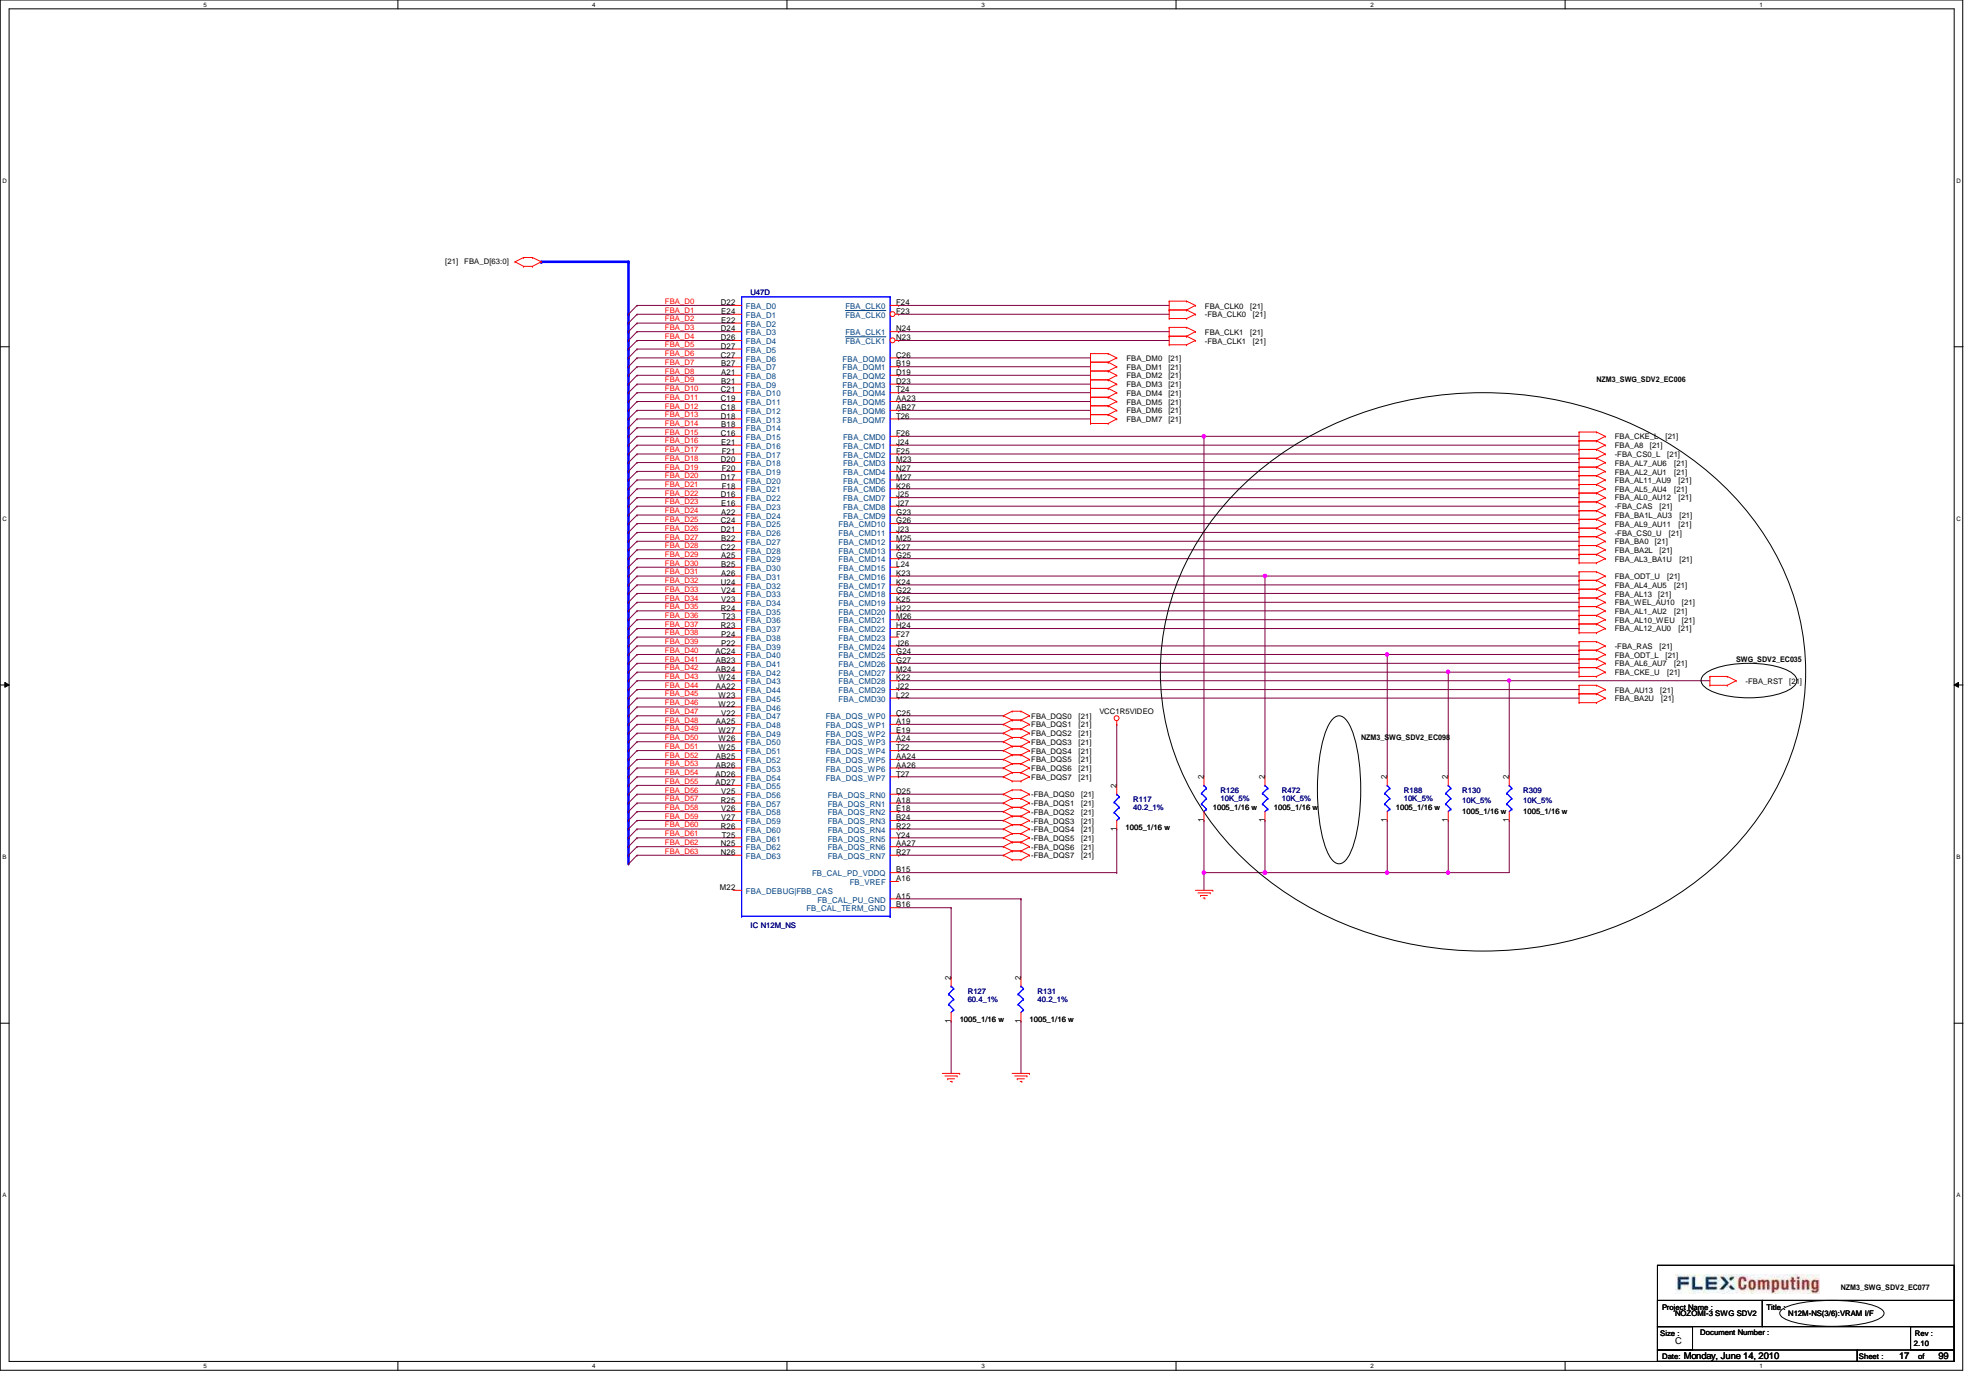
[picture p71: page 17]

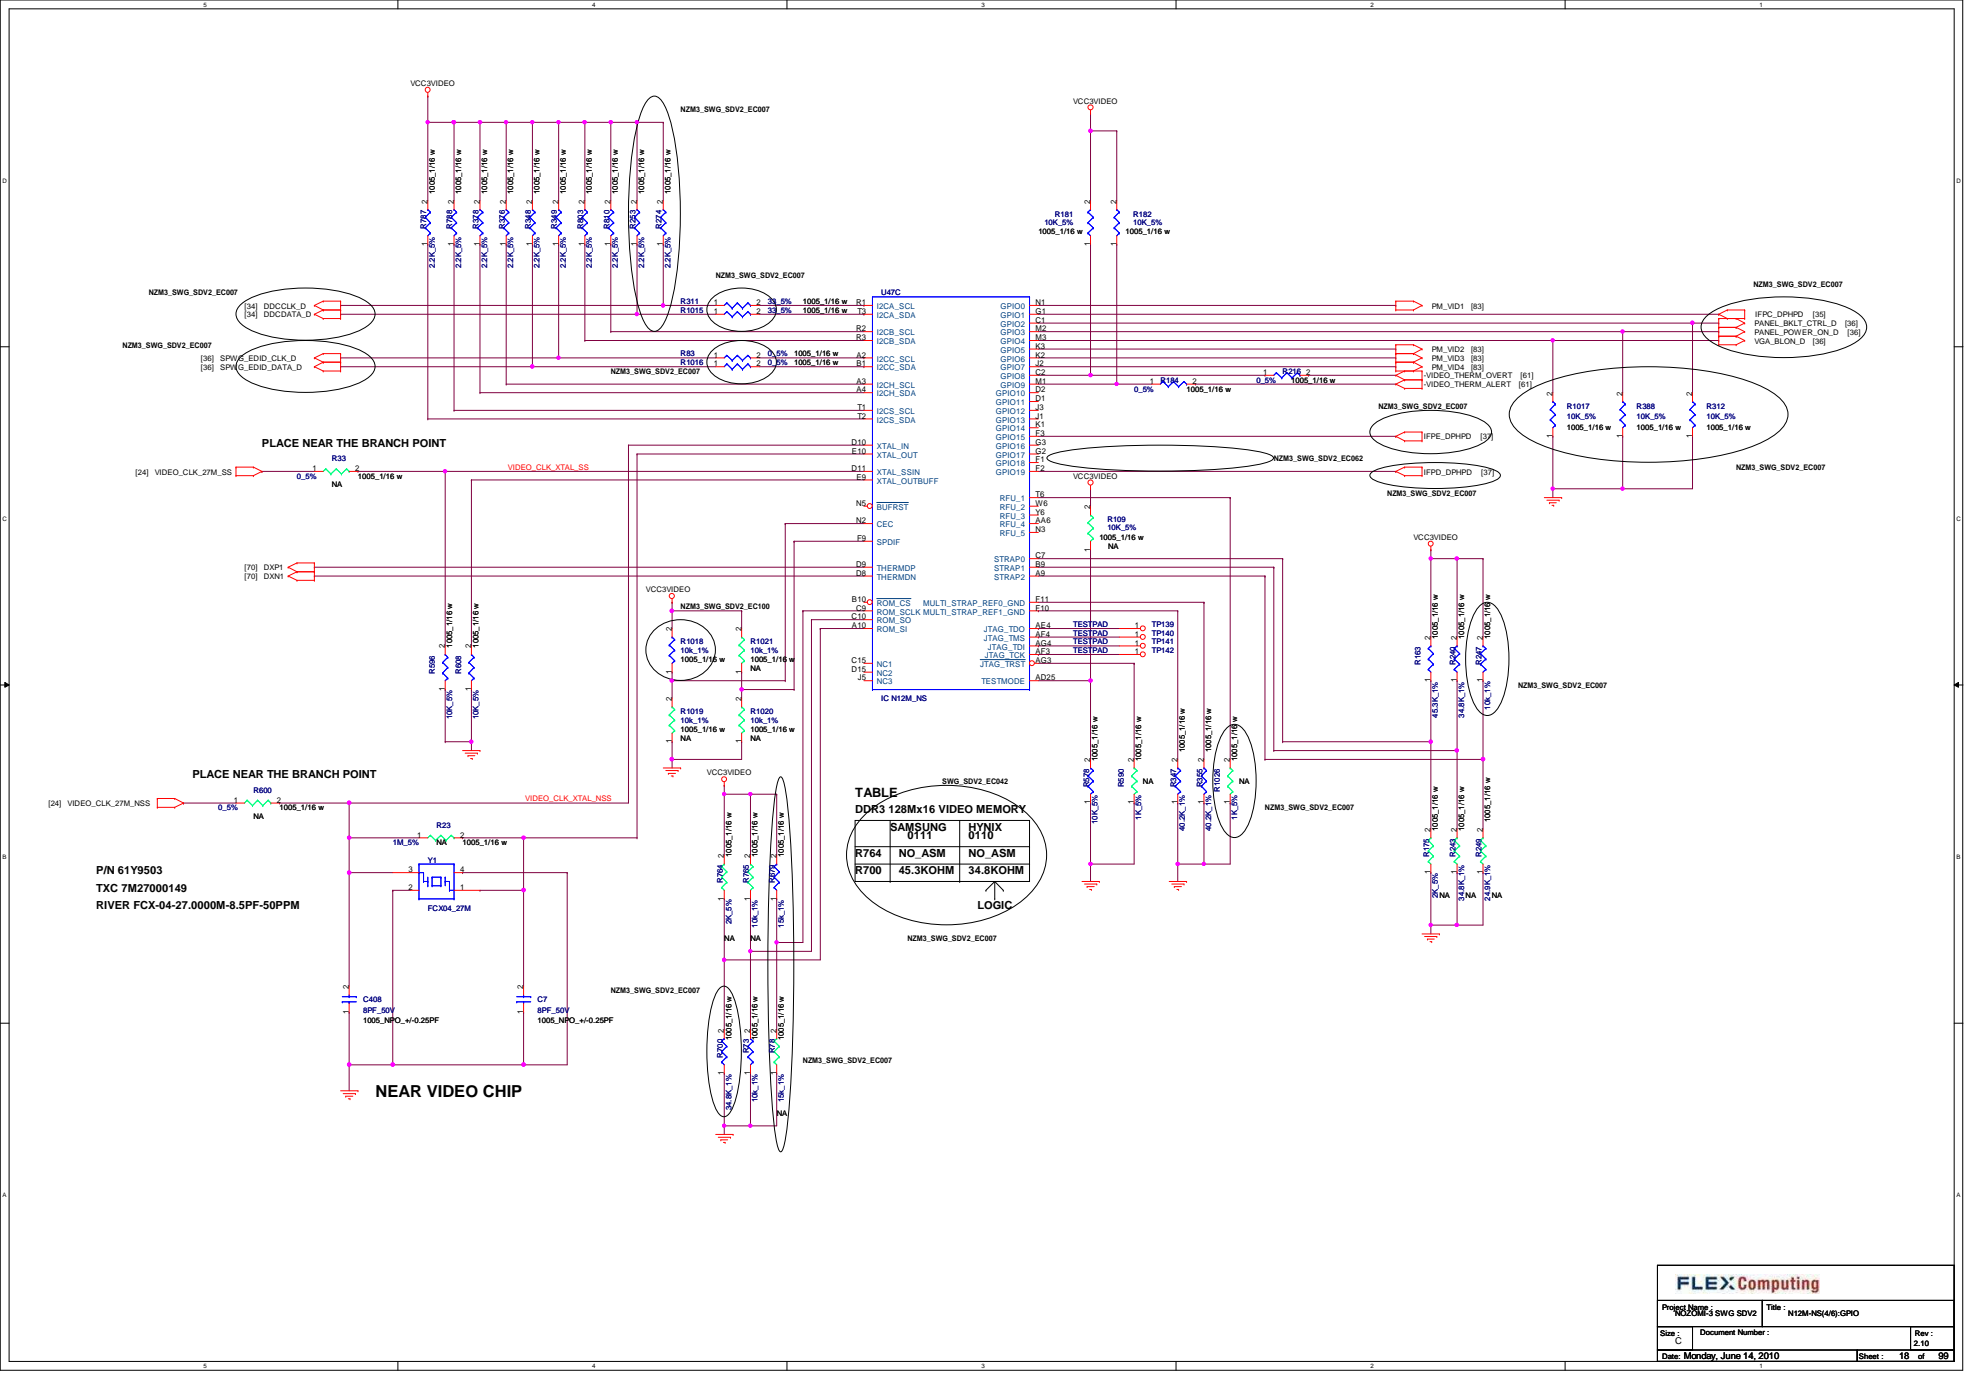
[picture p72: page 18]

PLACE NEAR THE BRANCH POINT

## UNDER GPU

120mA

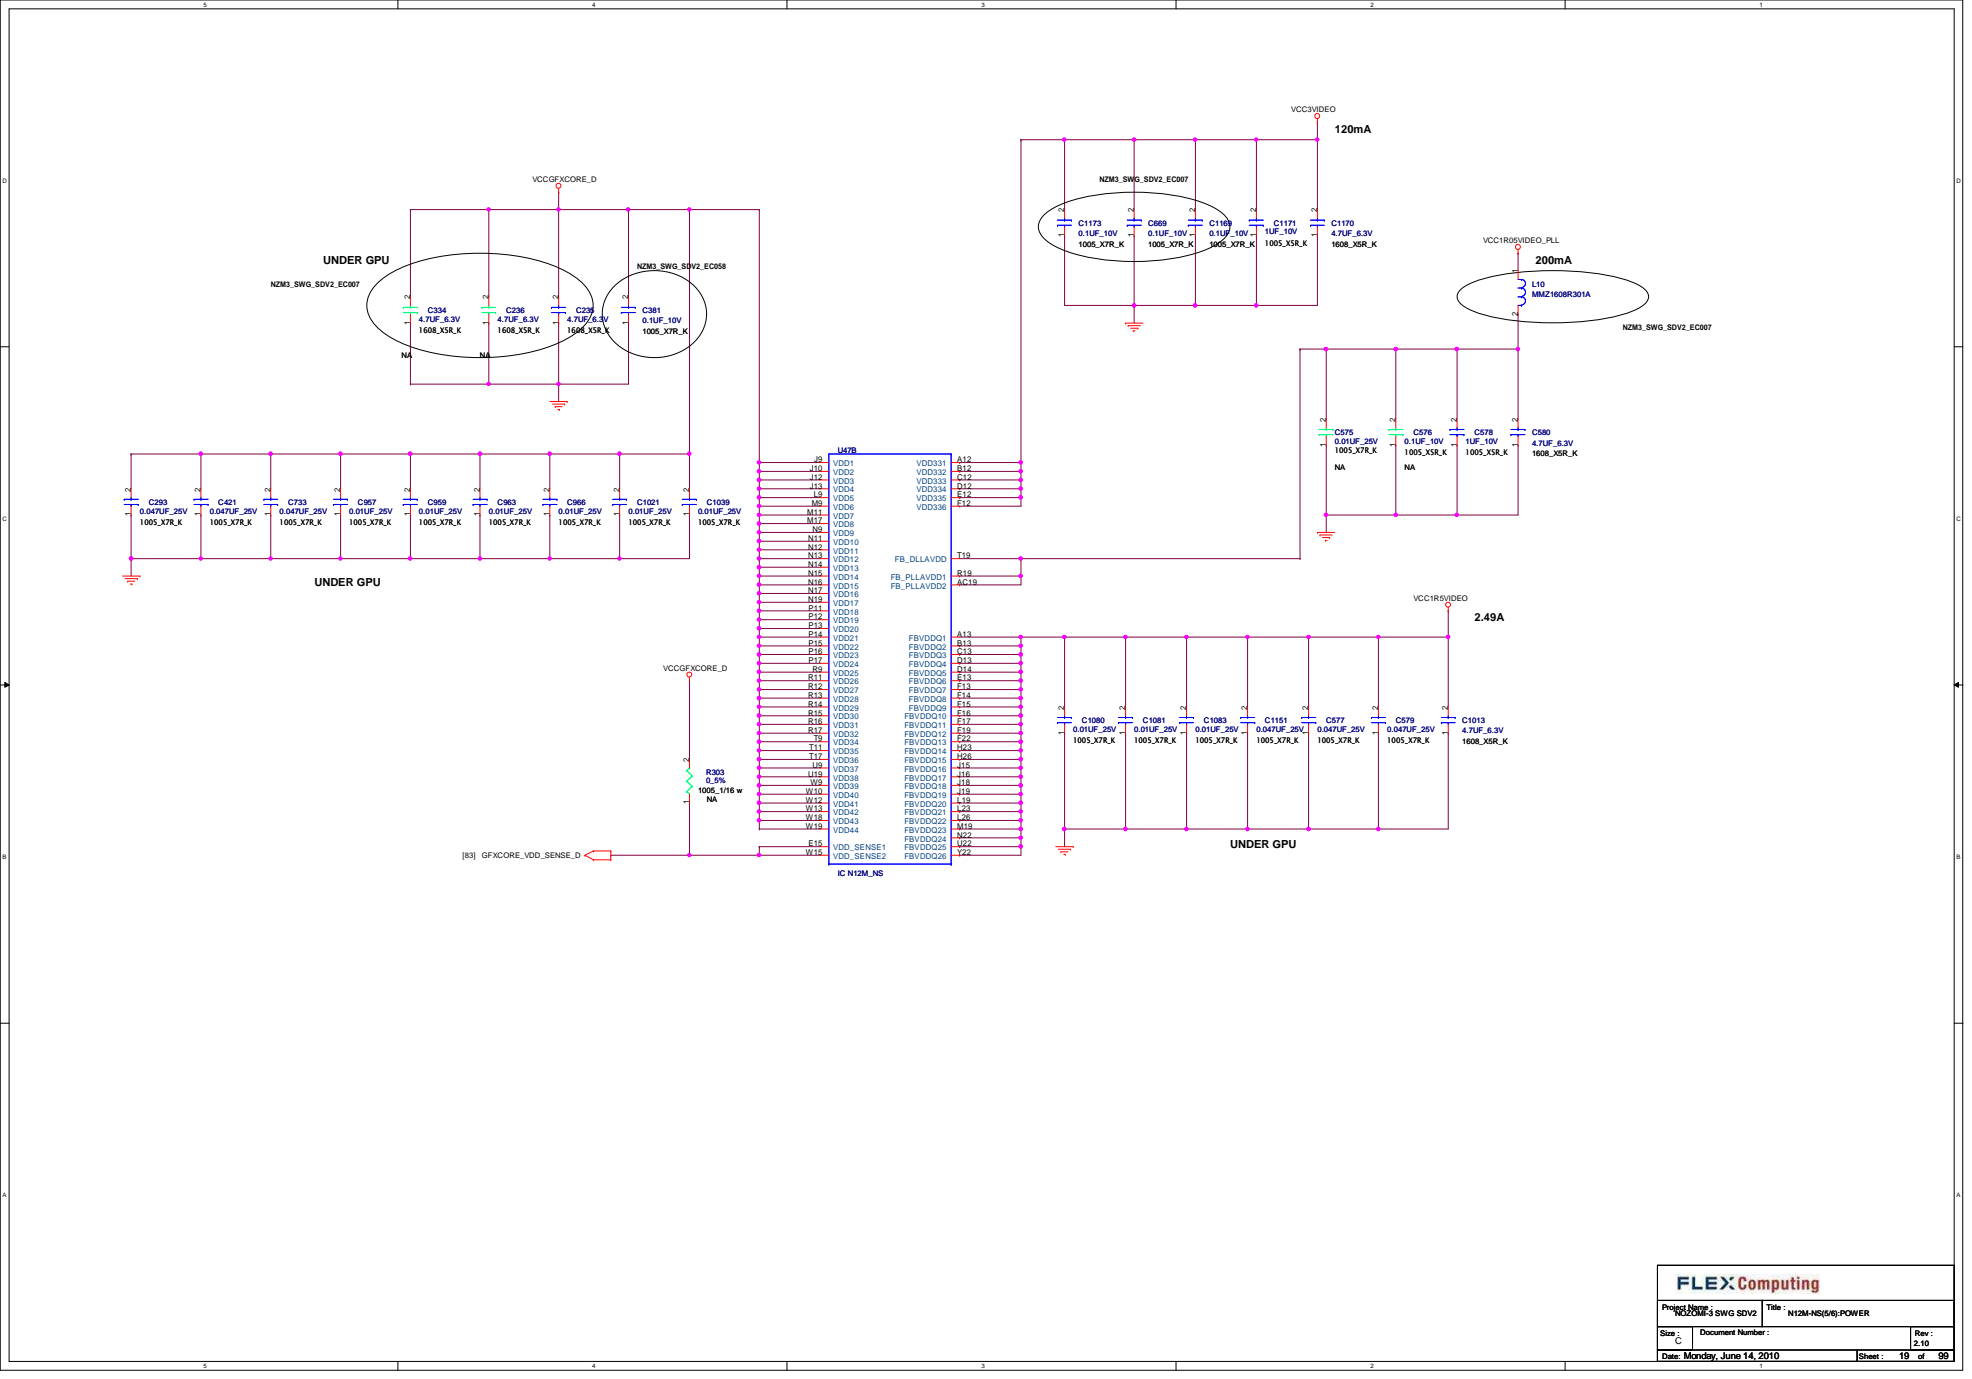
[picture p73: page 19]

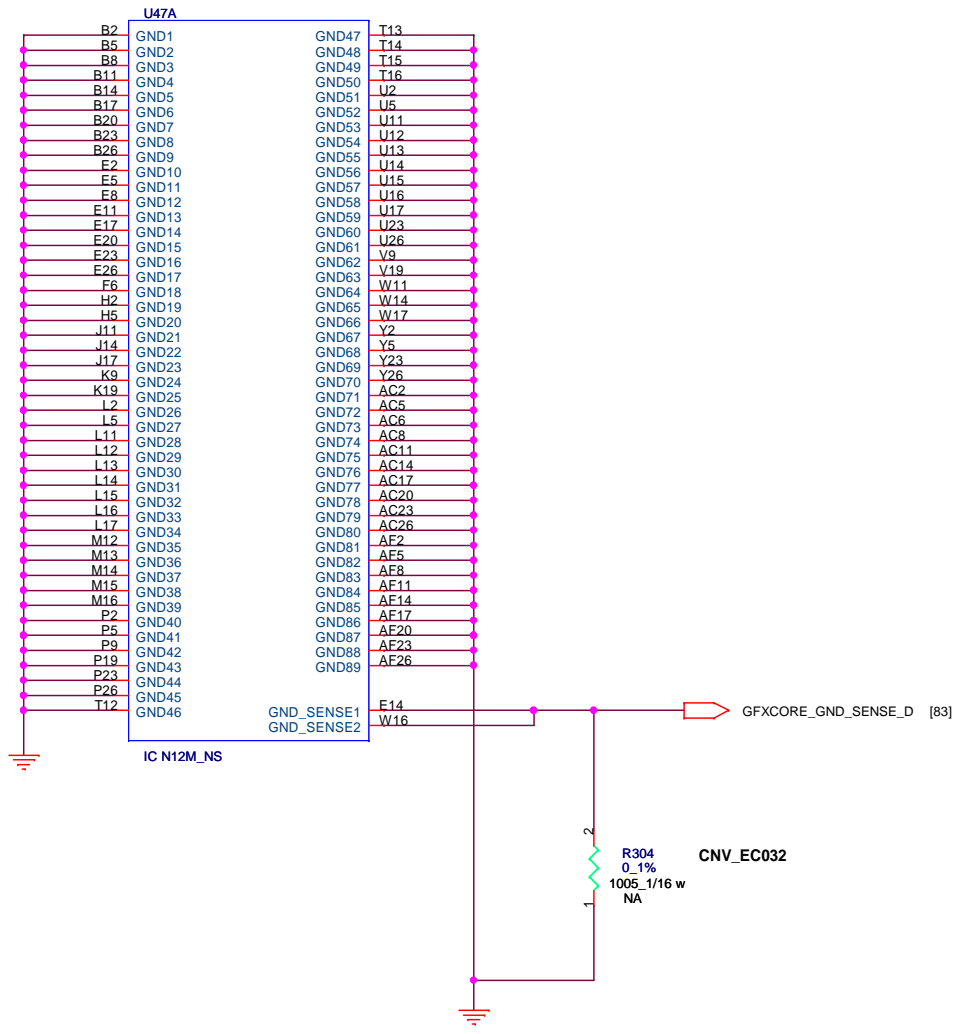
[picture p74: page 20]

(TOP/LEFT SIDE M0) | (BOTTOM/LEFT SIDE M1) | (TOP/RIGHT SIDE M2) | (BOTTOM/RIGHT SIDE M3)

## DDR3 VIDEO MEMORY

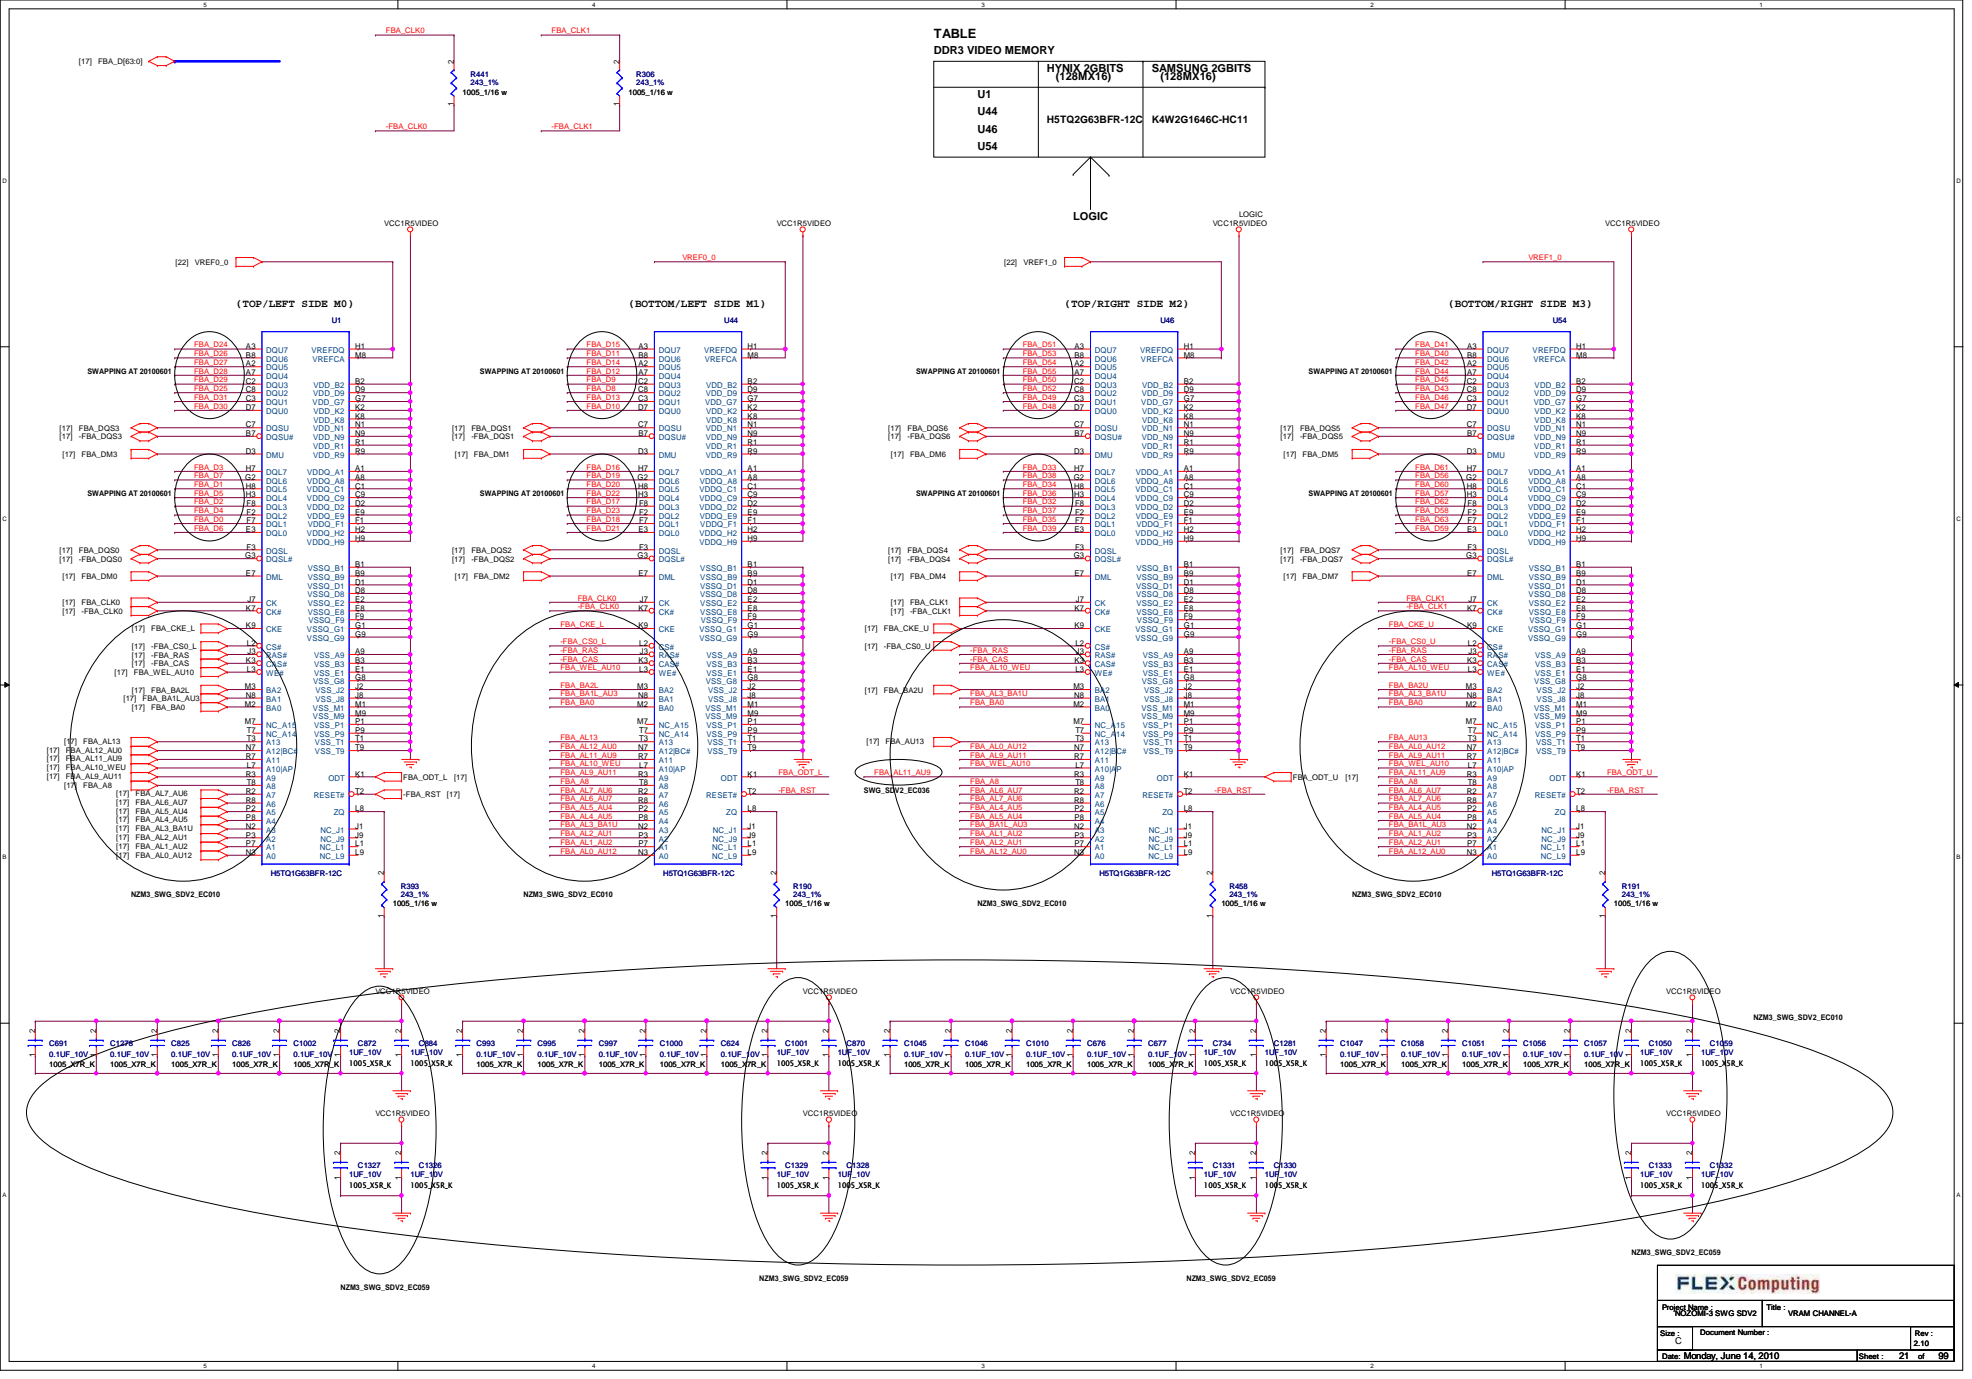
[picture p75: page 21]

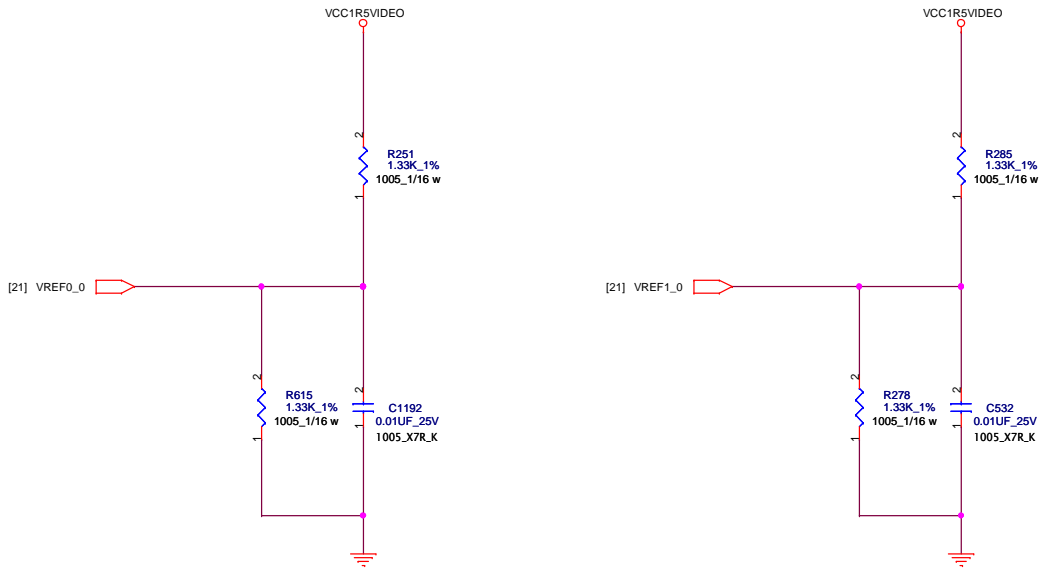
[picture p76: page 22]
[21] VREF0_0; [21] VREF1_0; VCC1R5VIDEO; Monday, June 14, 2010; NOZOMI-3 SWG SDV2; DYNAMIC MEMORY TERMINATION

## HIGH

## SPKR TCO TIMER SYSTEM REBOOT

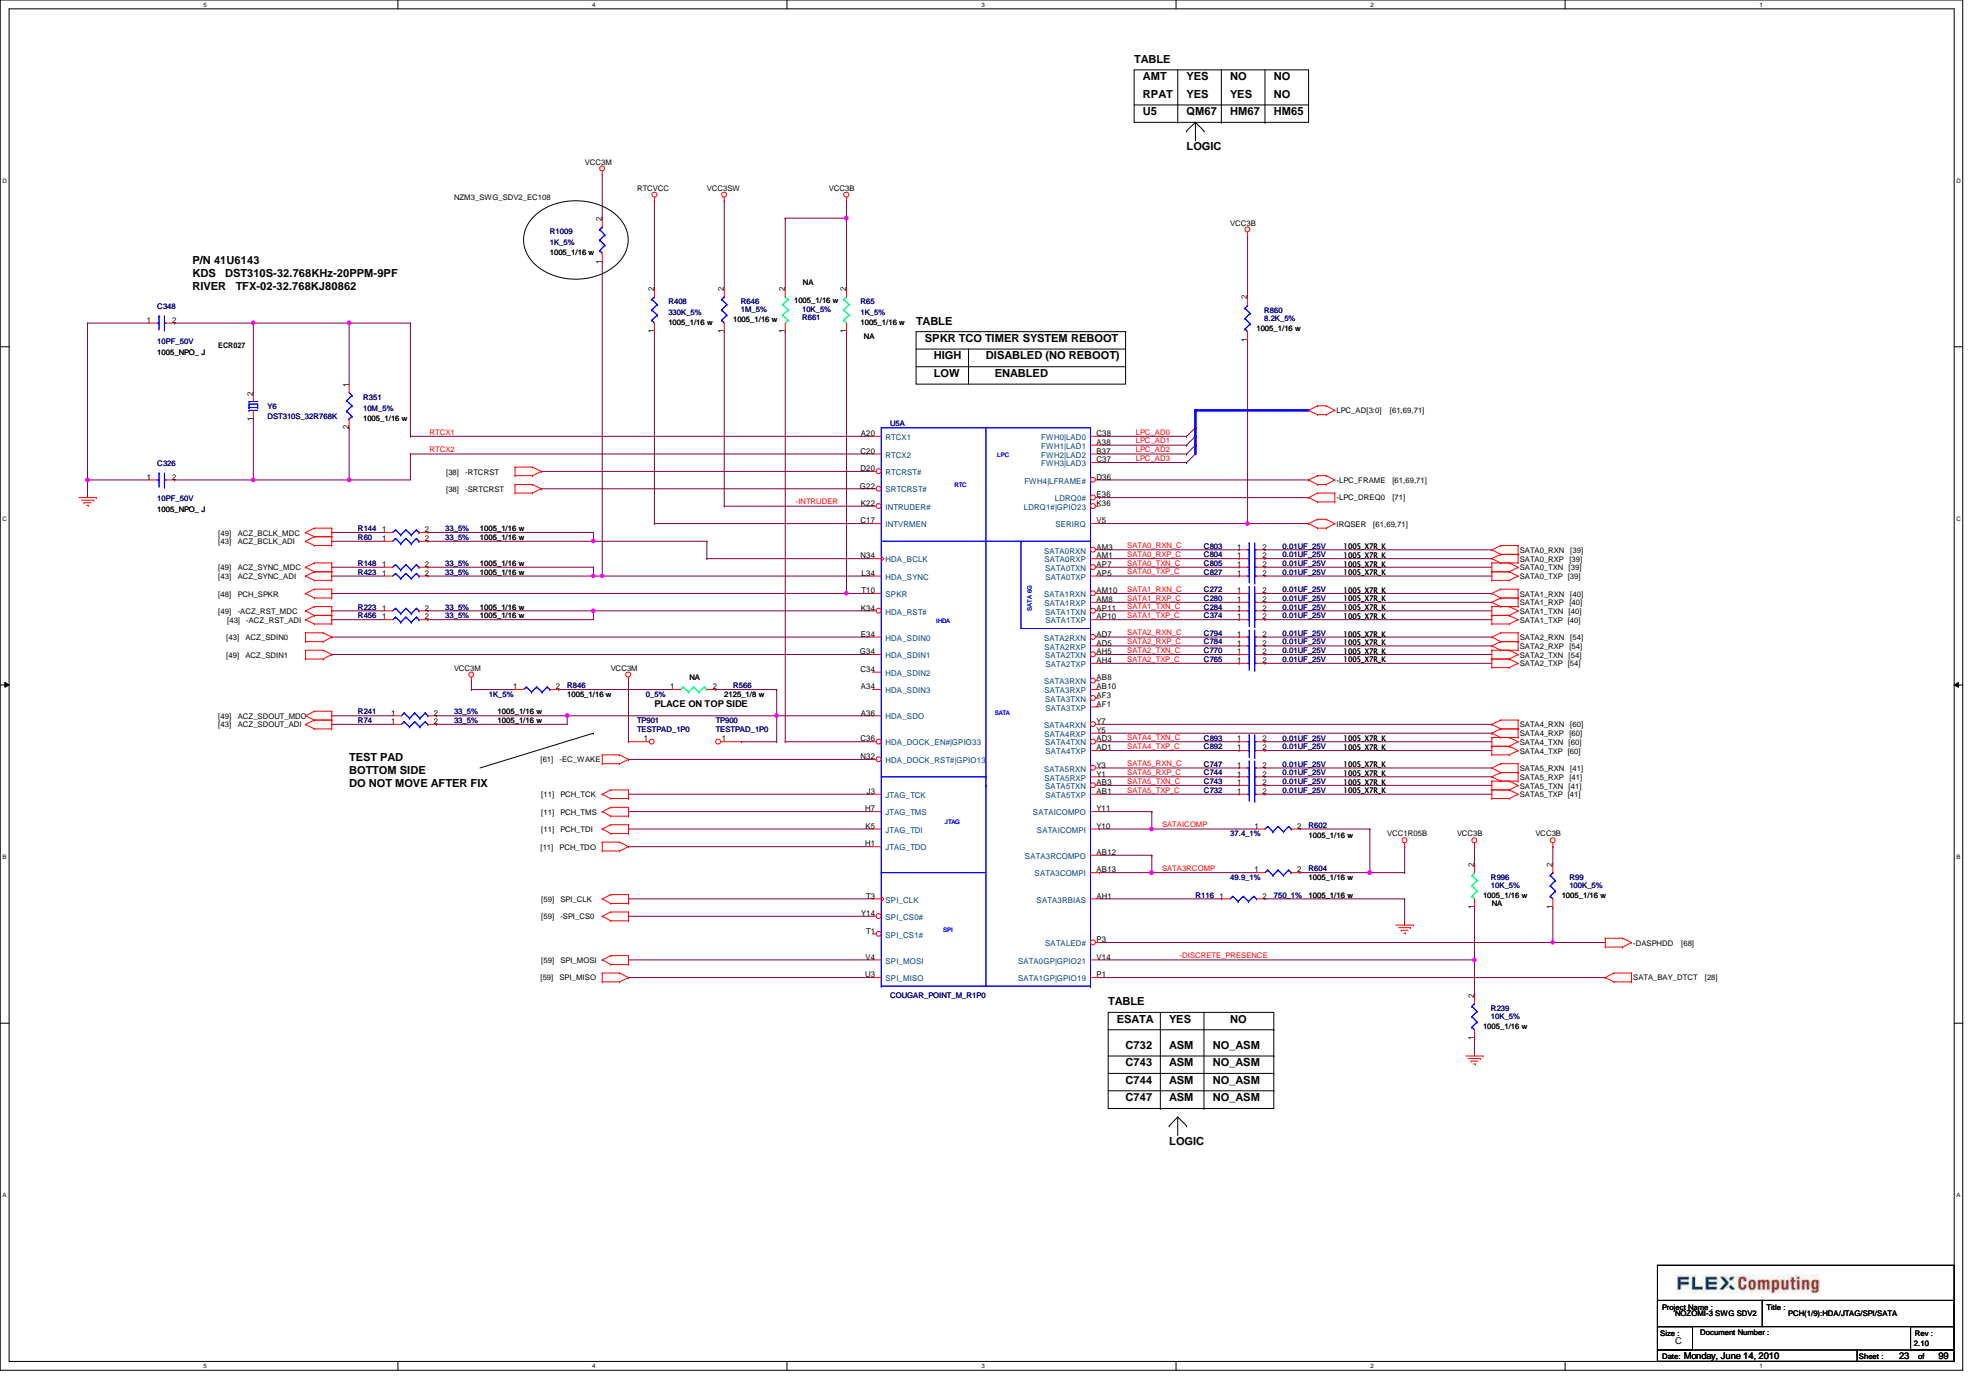
[picture p77: page 23]

RTCX1 A20 RTCX2 C20 RTCRST# D20 SRTCRST# G22 RTC RTC INTRUDER# K22 INTVRMEN C17 | LPC

HDA_BCLK N34 HDA_SYNC L34 SPKR T10 HDA_RST# K34 IHDA IHDA HDA_SDIN0 E34 HDA_SDIN1 G34 HDA_SDIN2 C34 HDA_SDIN3 A34 HDA_SDO A36 HDA_DOCK_EN#|GPIO33 C36 HDA_DOCK_RST#|GPIO13 N32

TEST PAD
BOTTOM SIDE
DO NOT MOVE AFTER FIX

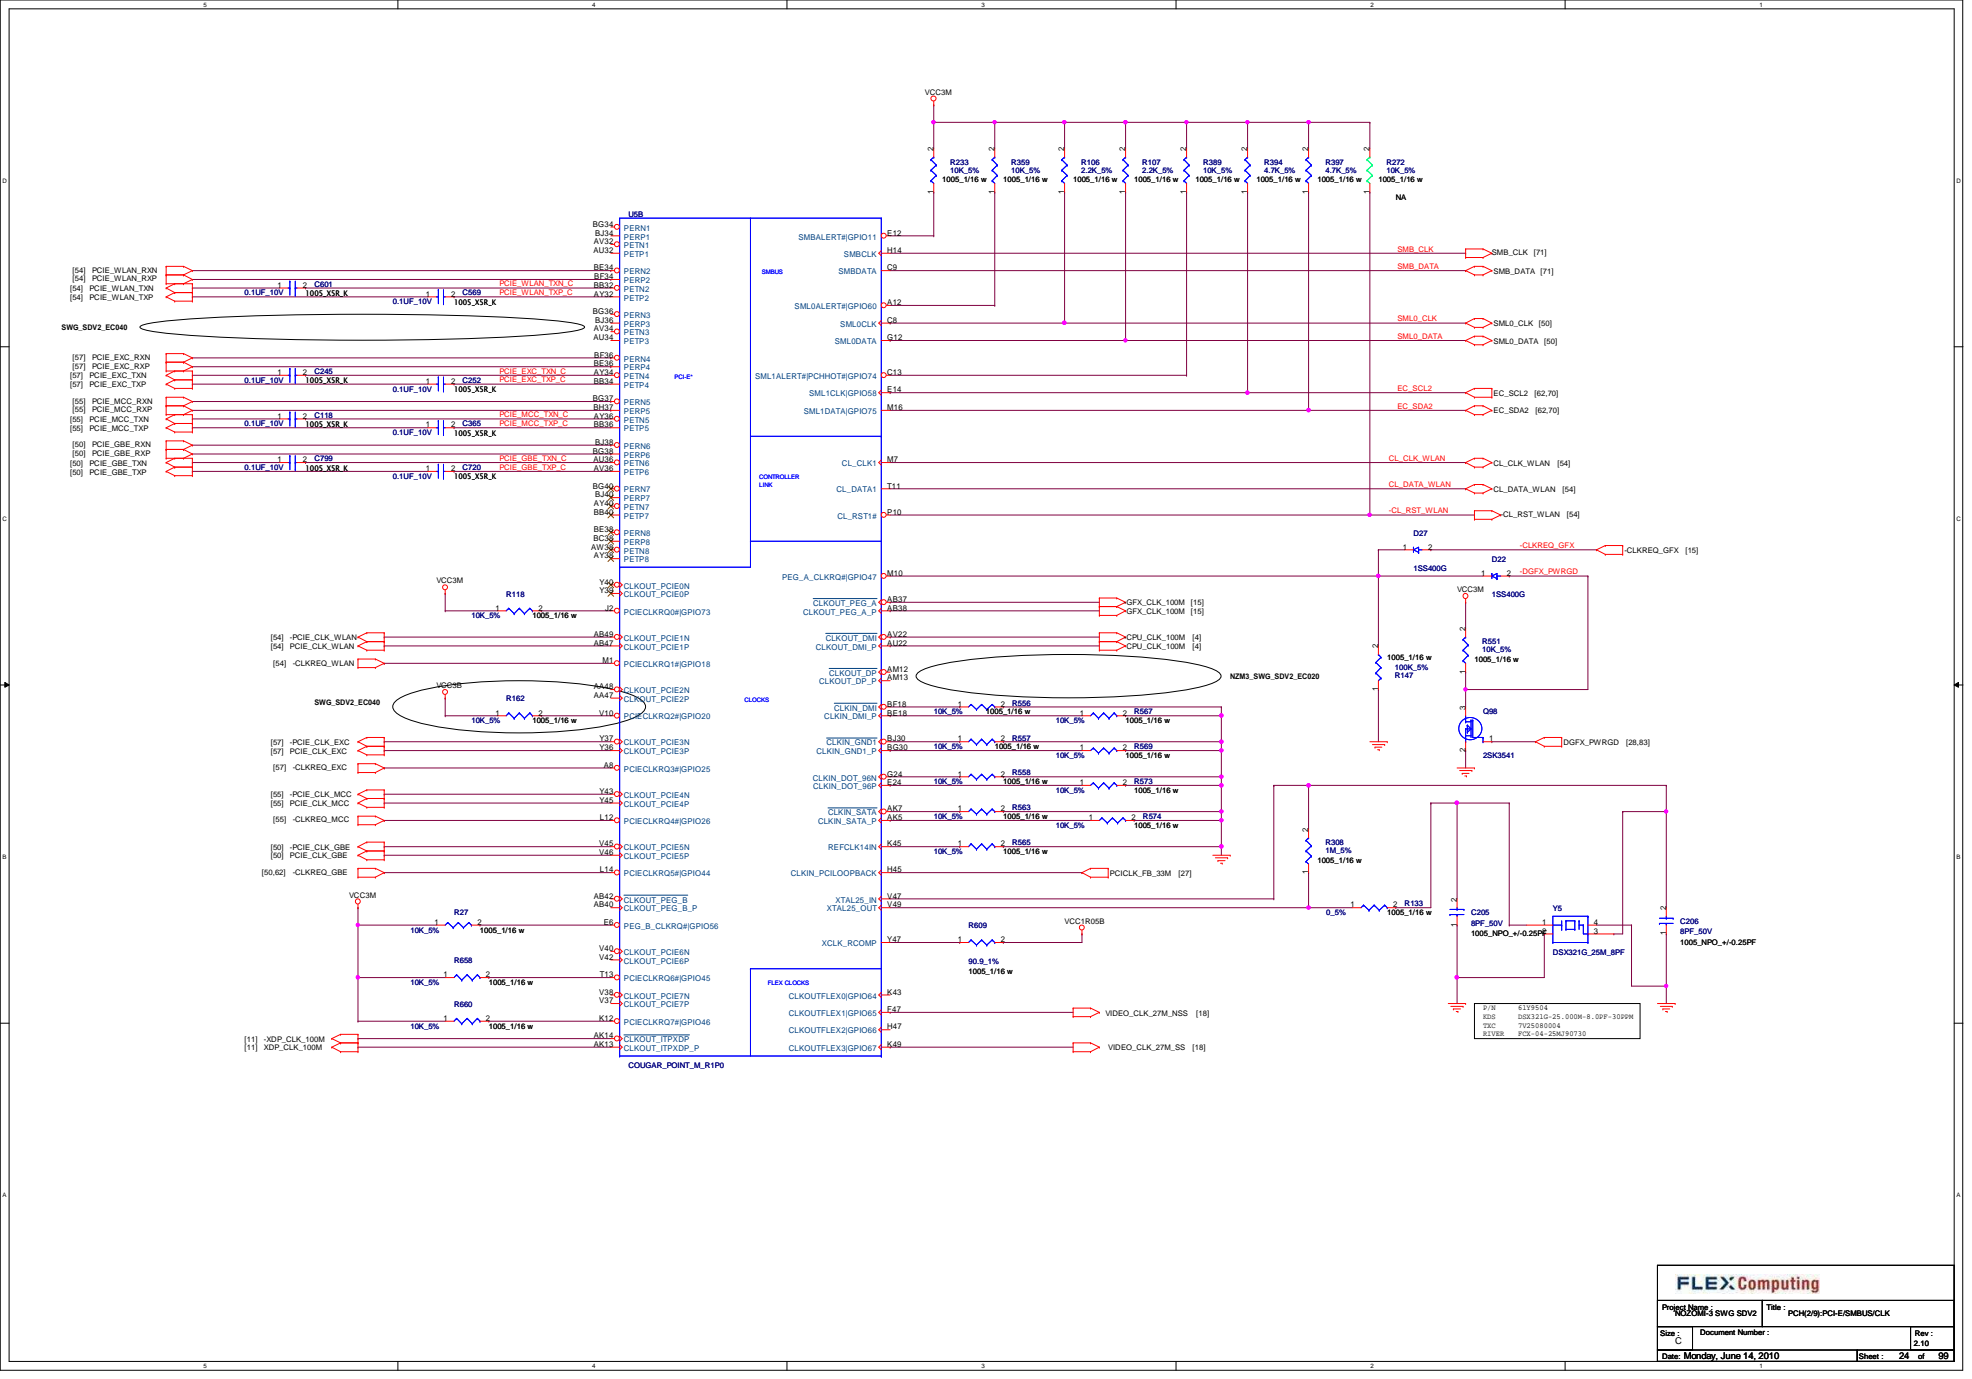
[picture p78: page 24]

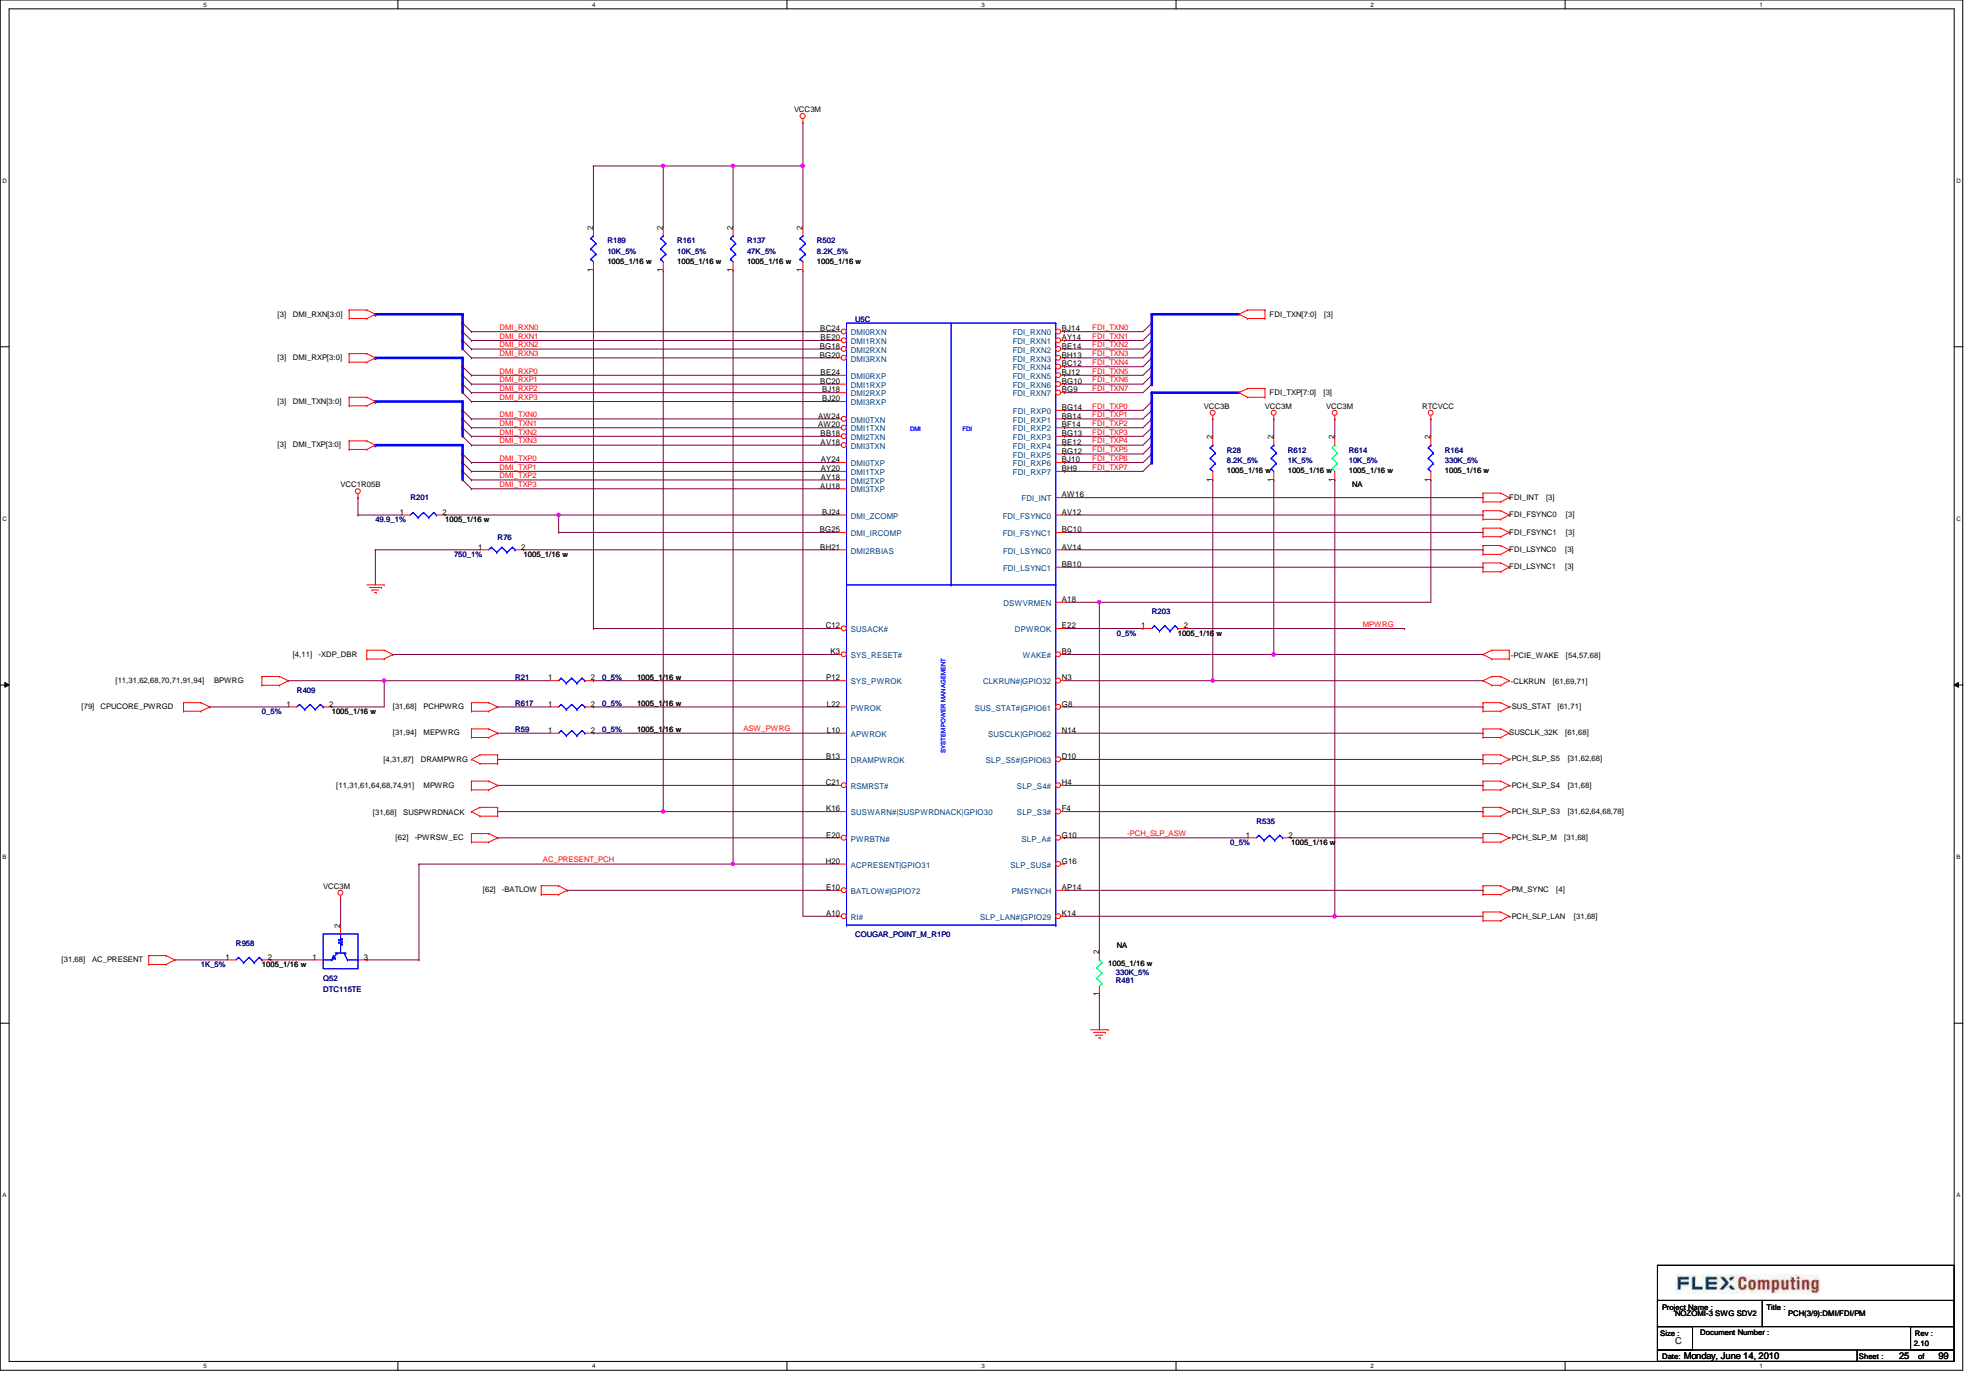
[picture p79: page 25]

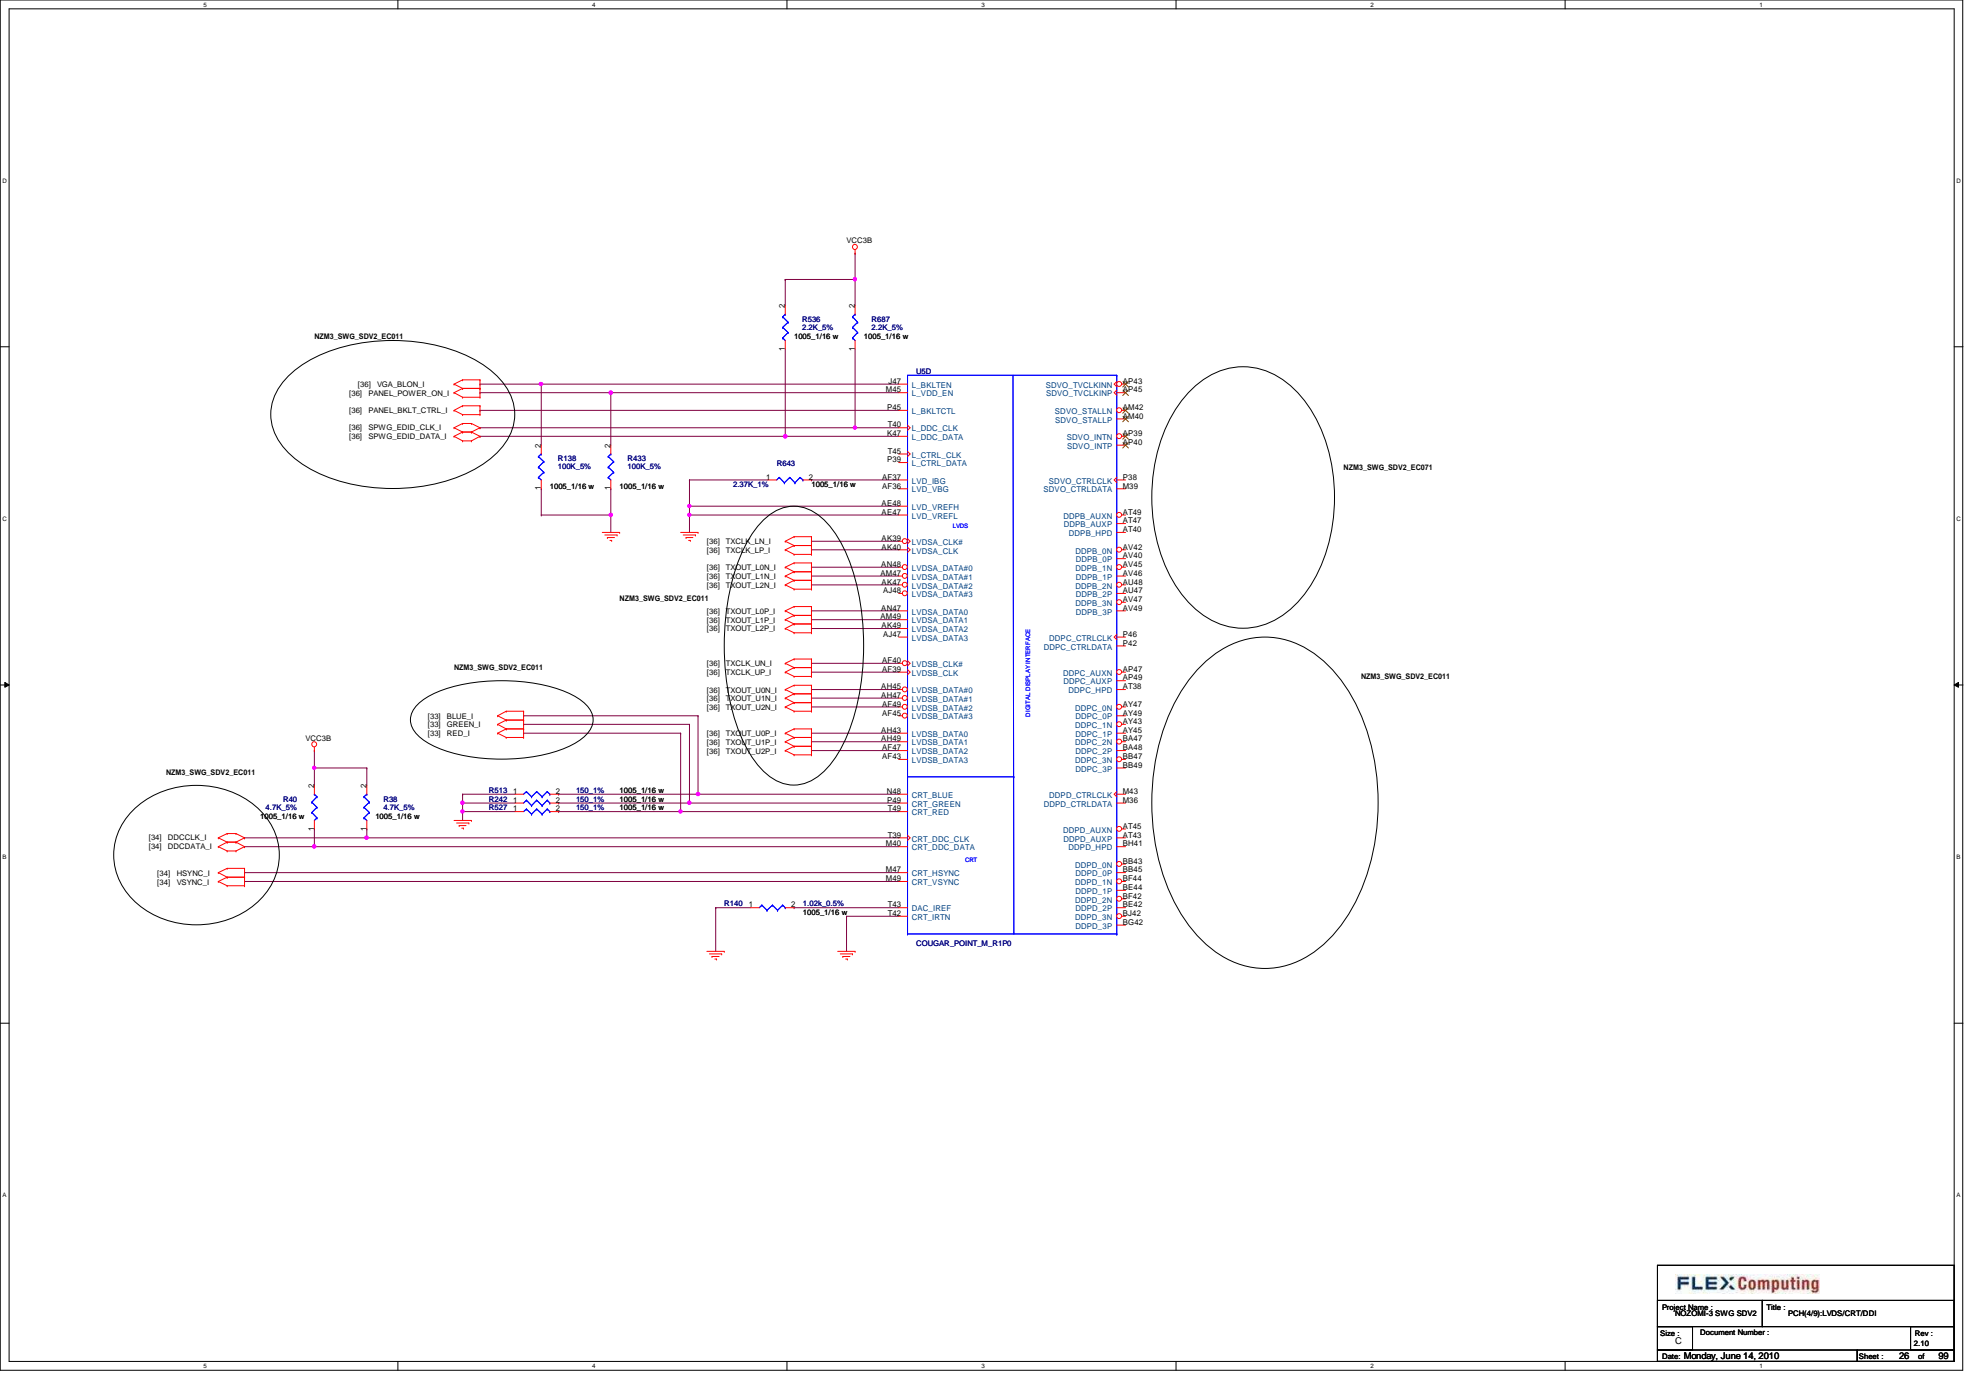
[picture p80: page 26]

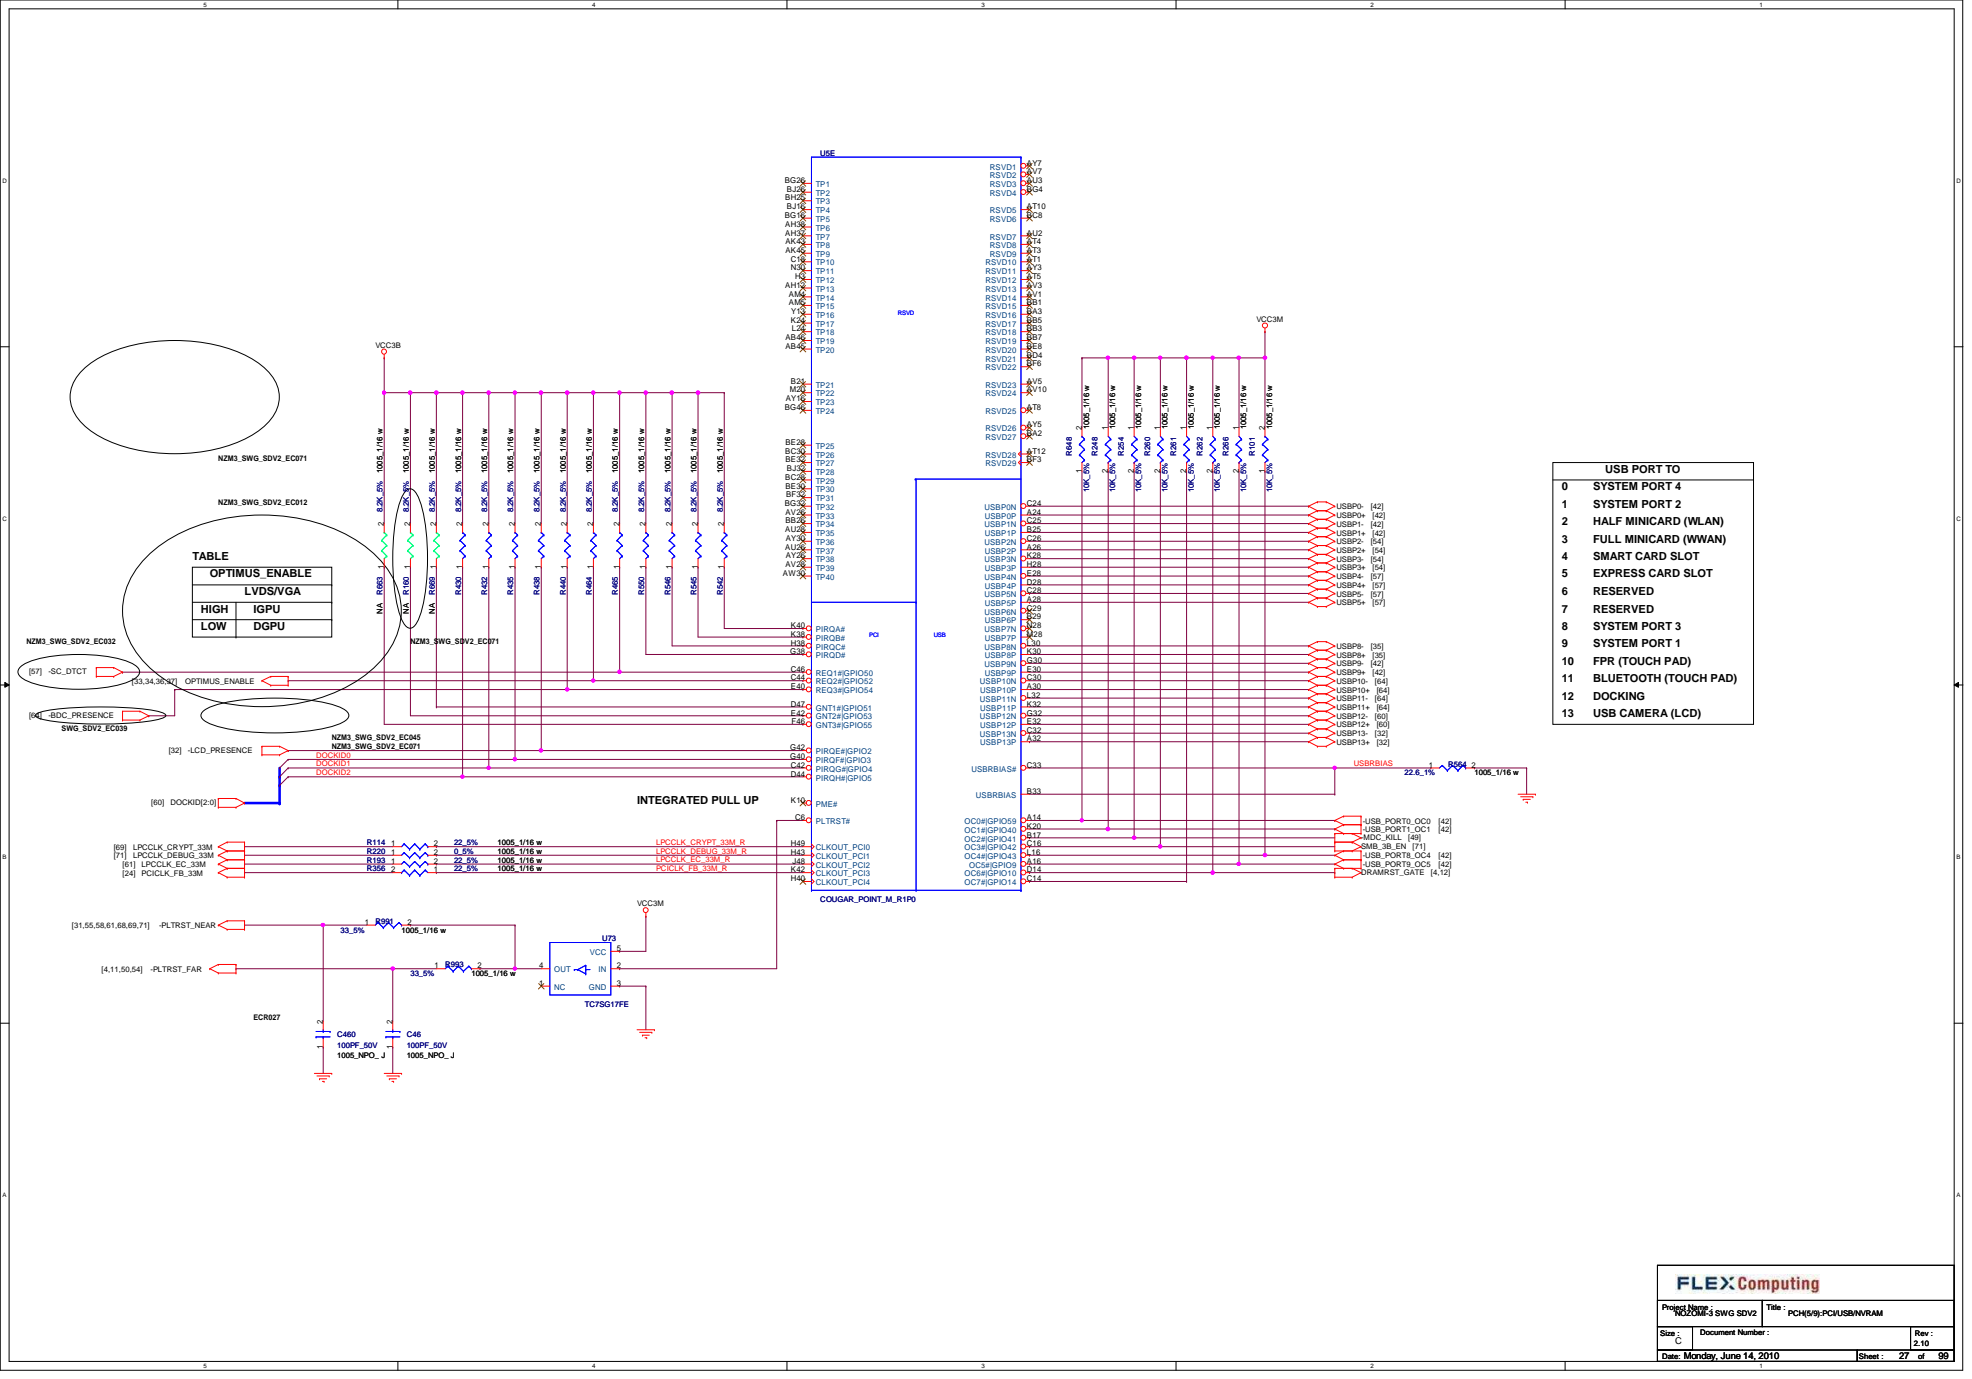
[picture p81: page 27]

## GPIO15 HIGH

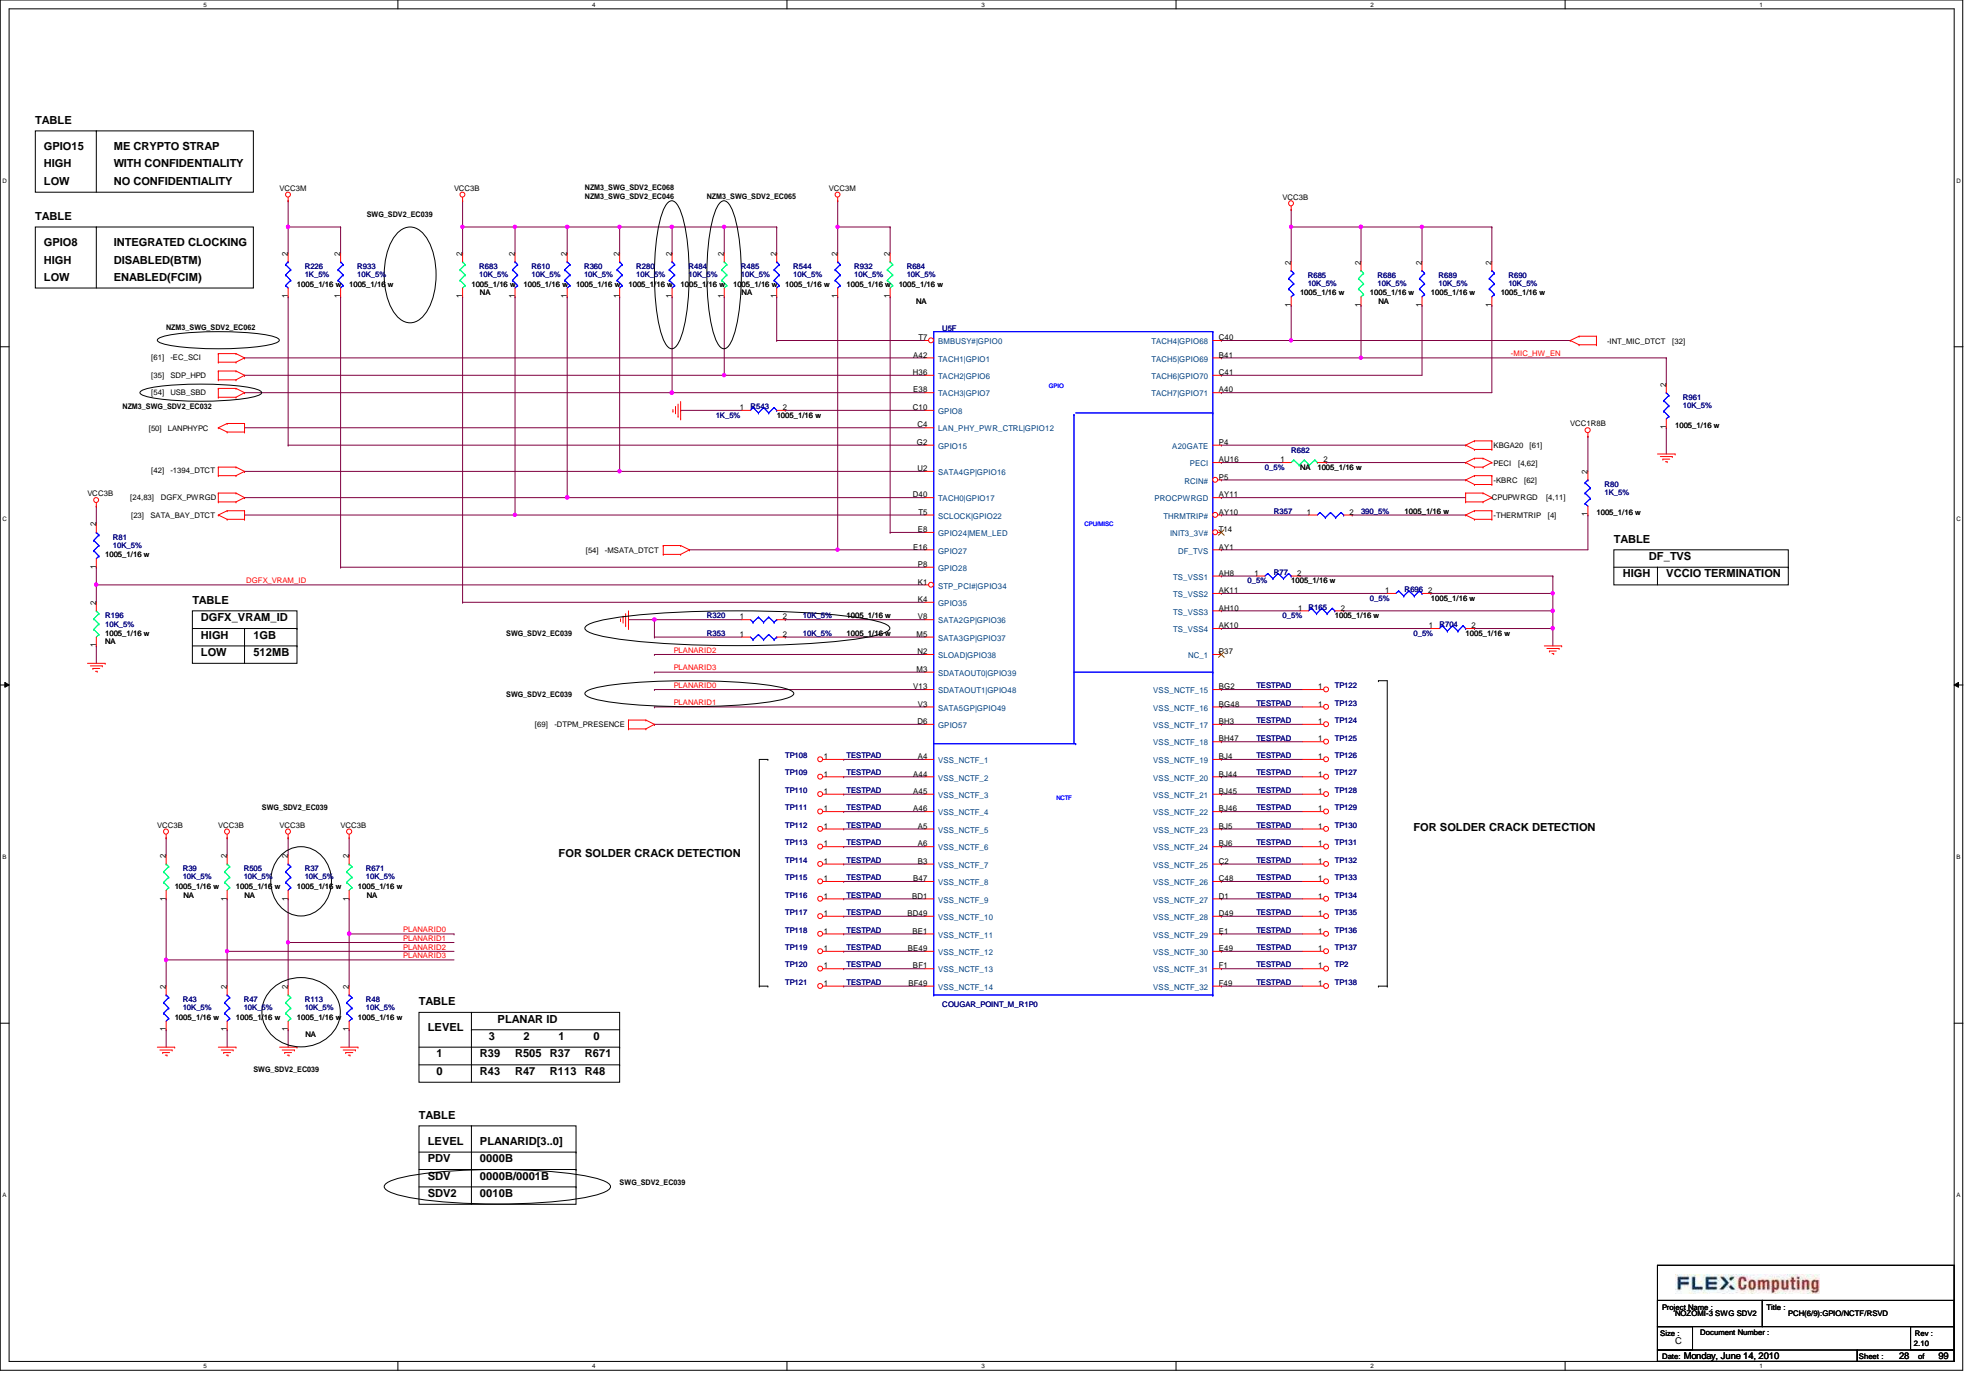
[picture p82: page 28]

FOR SOLDER CRACK DETECTION

1.432A

## (For VCCCORE)

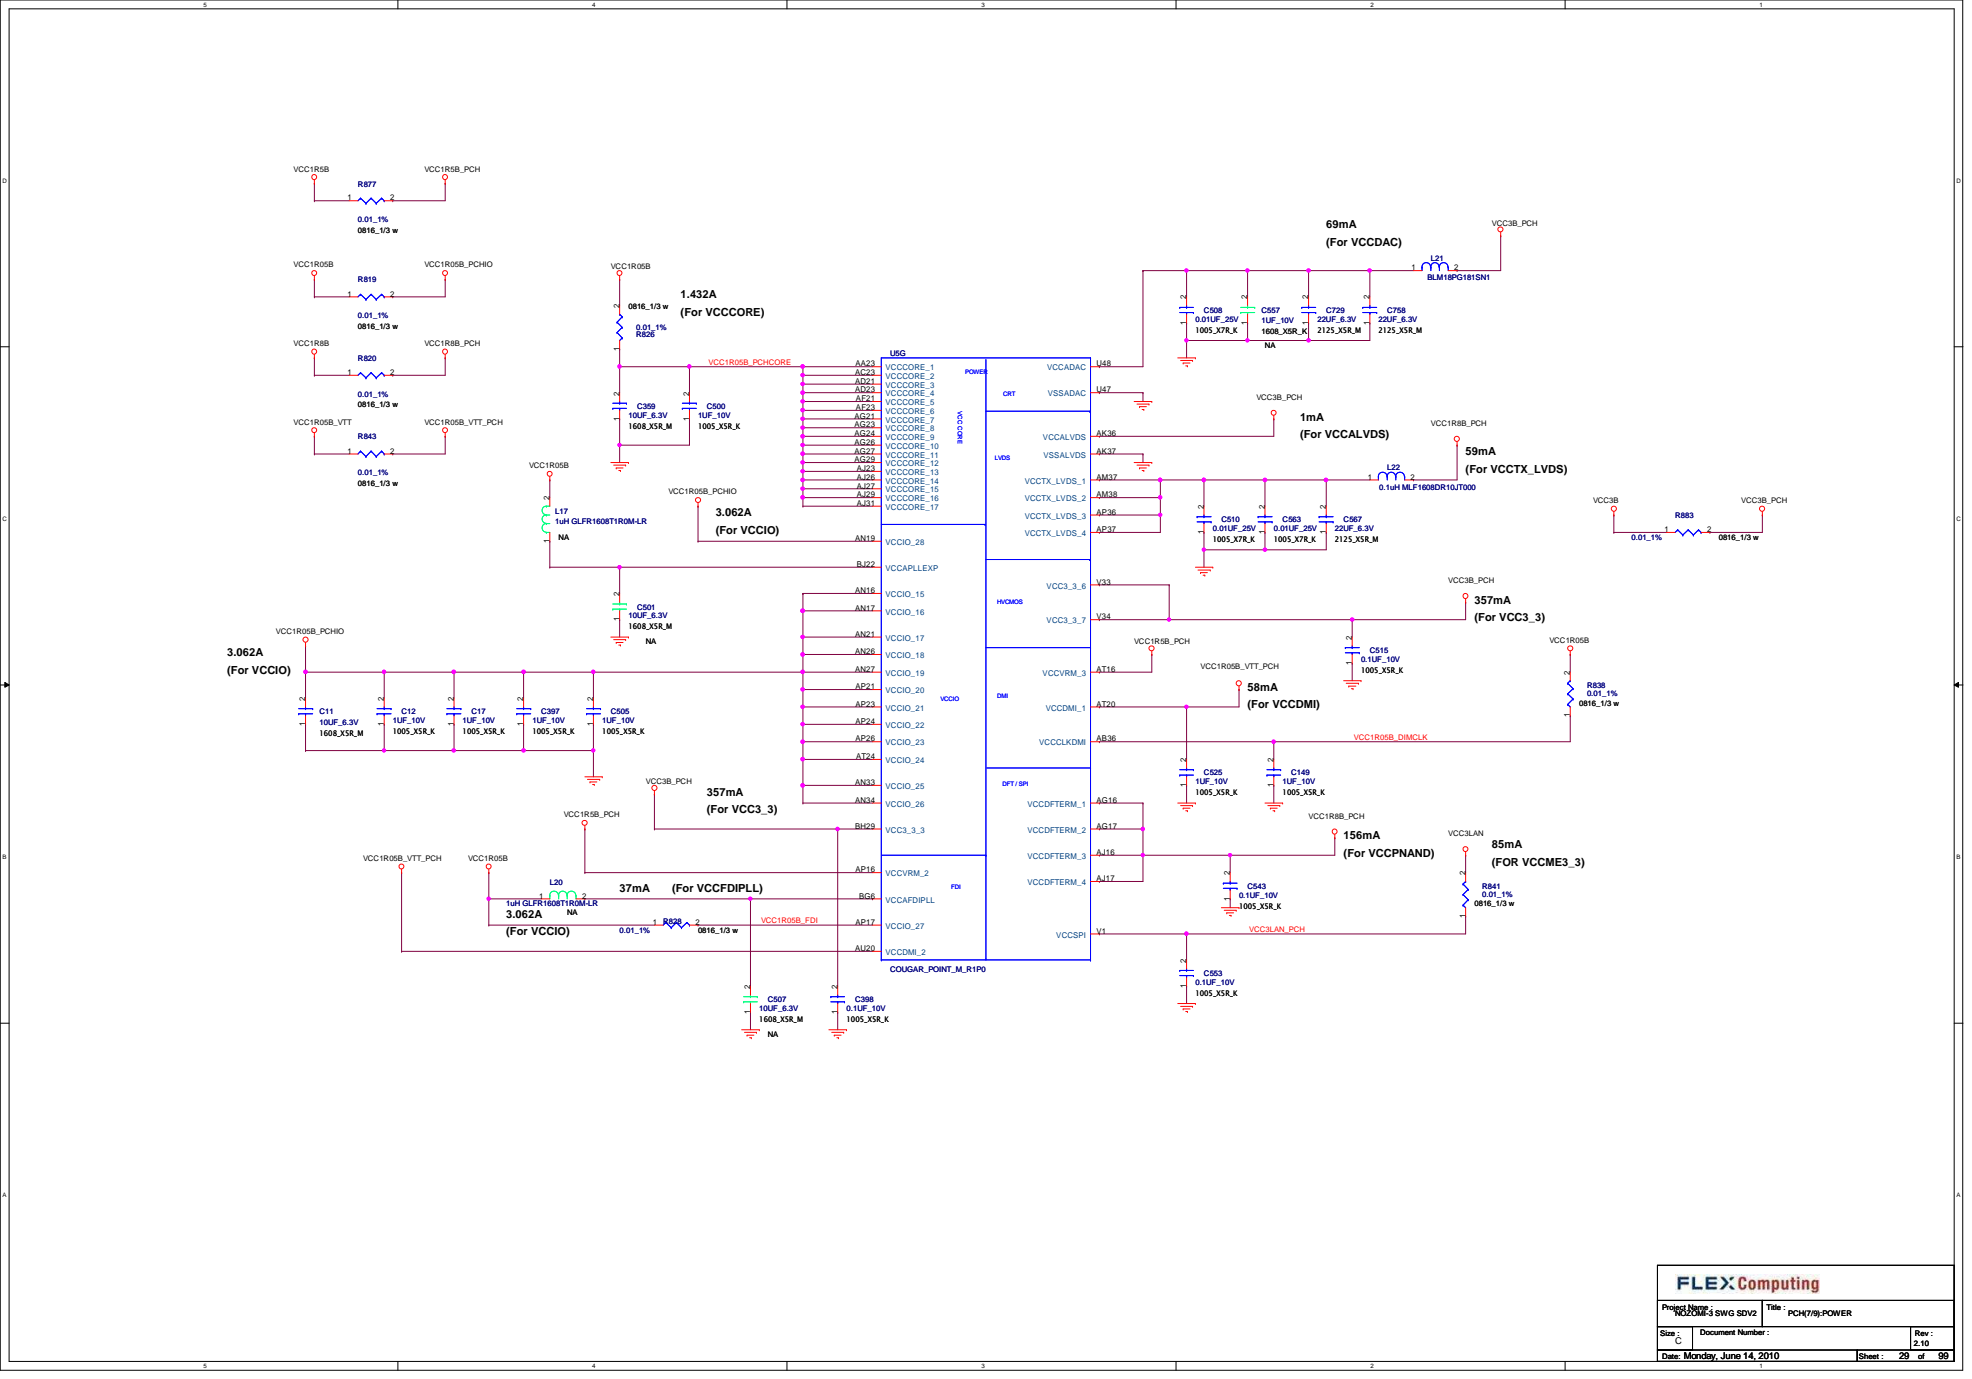
[picture p83: page 29]

3.062A

## (For VCCIO)

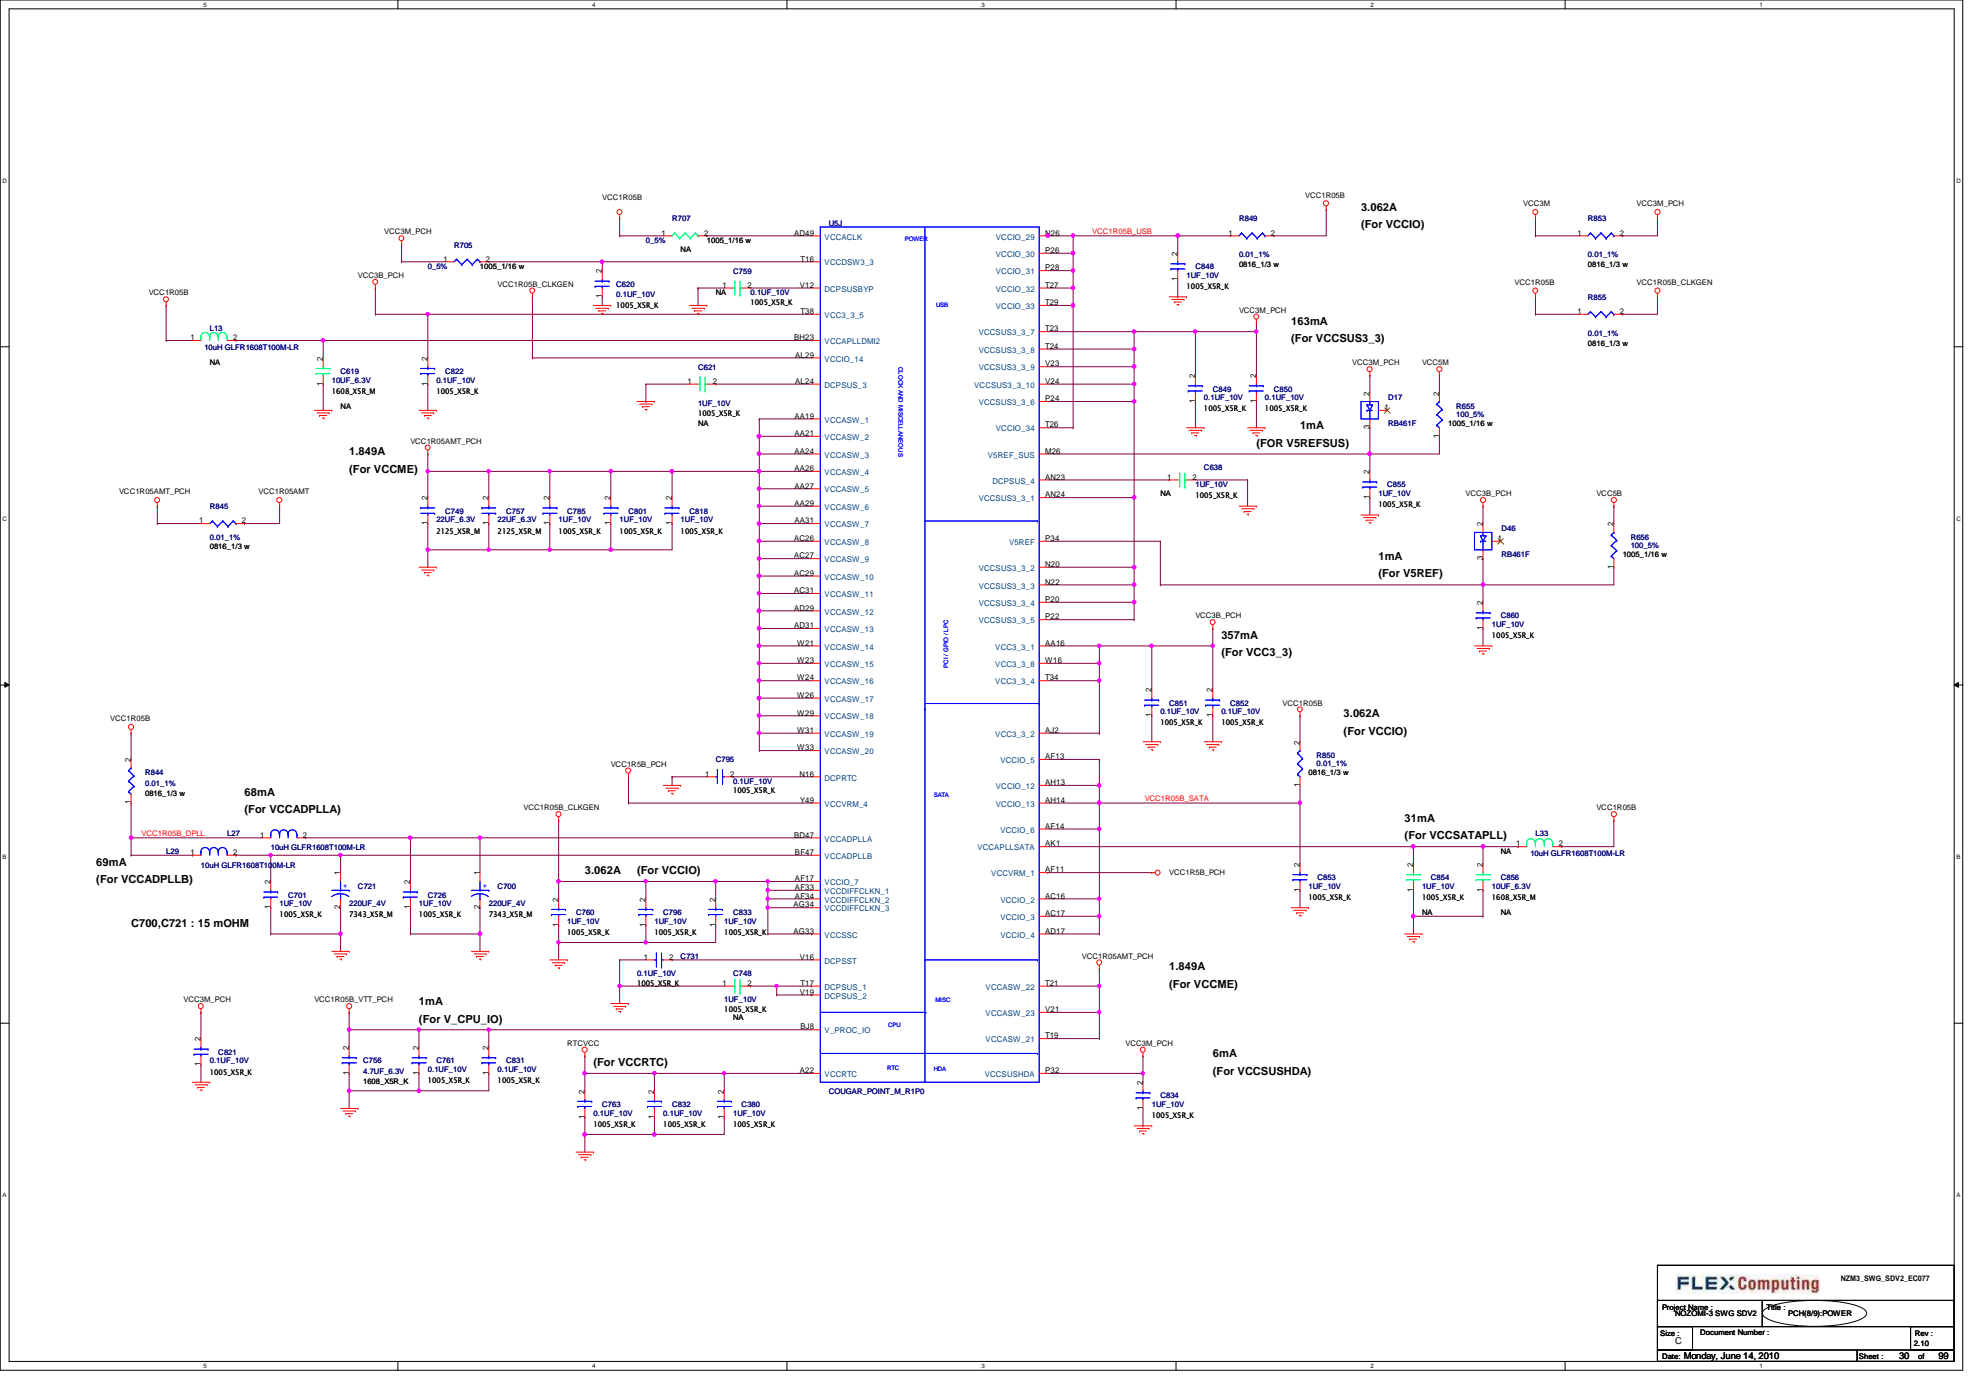
[picture p84: page 30]

# TEST PAD FOR METS/APS

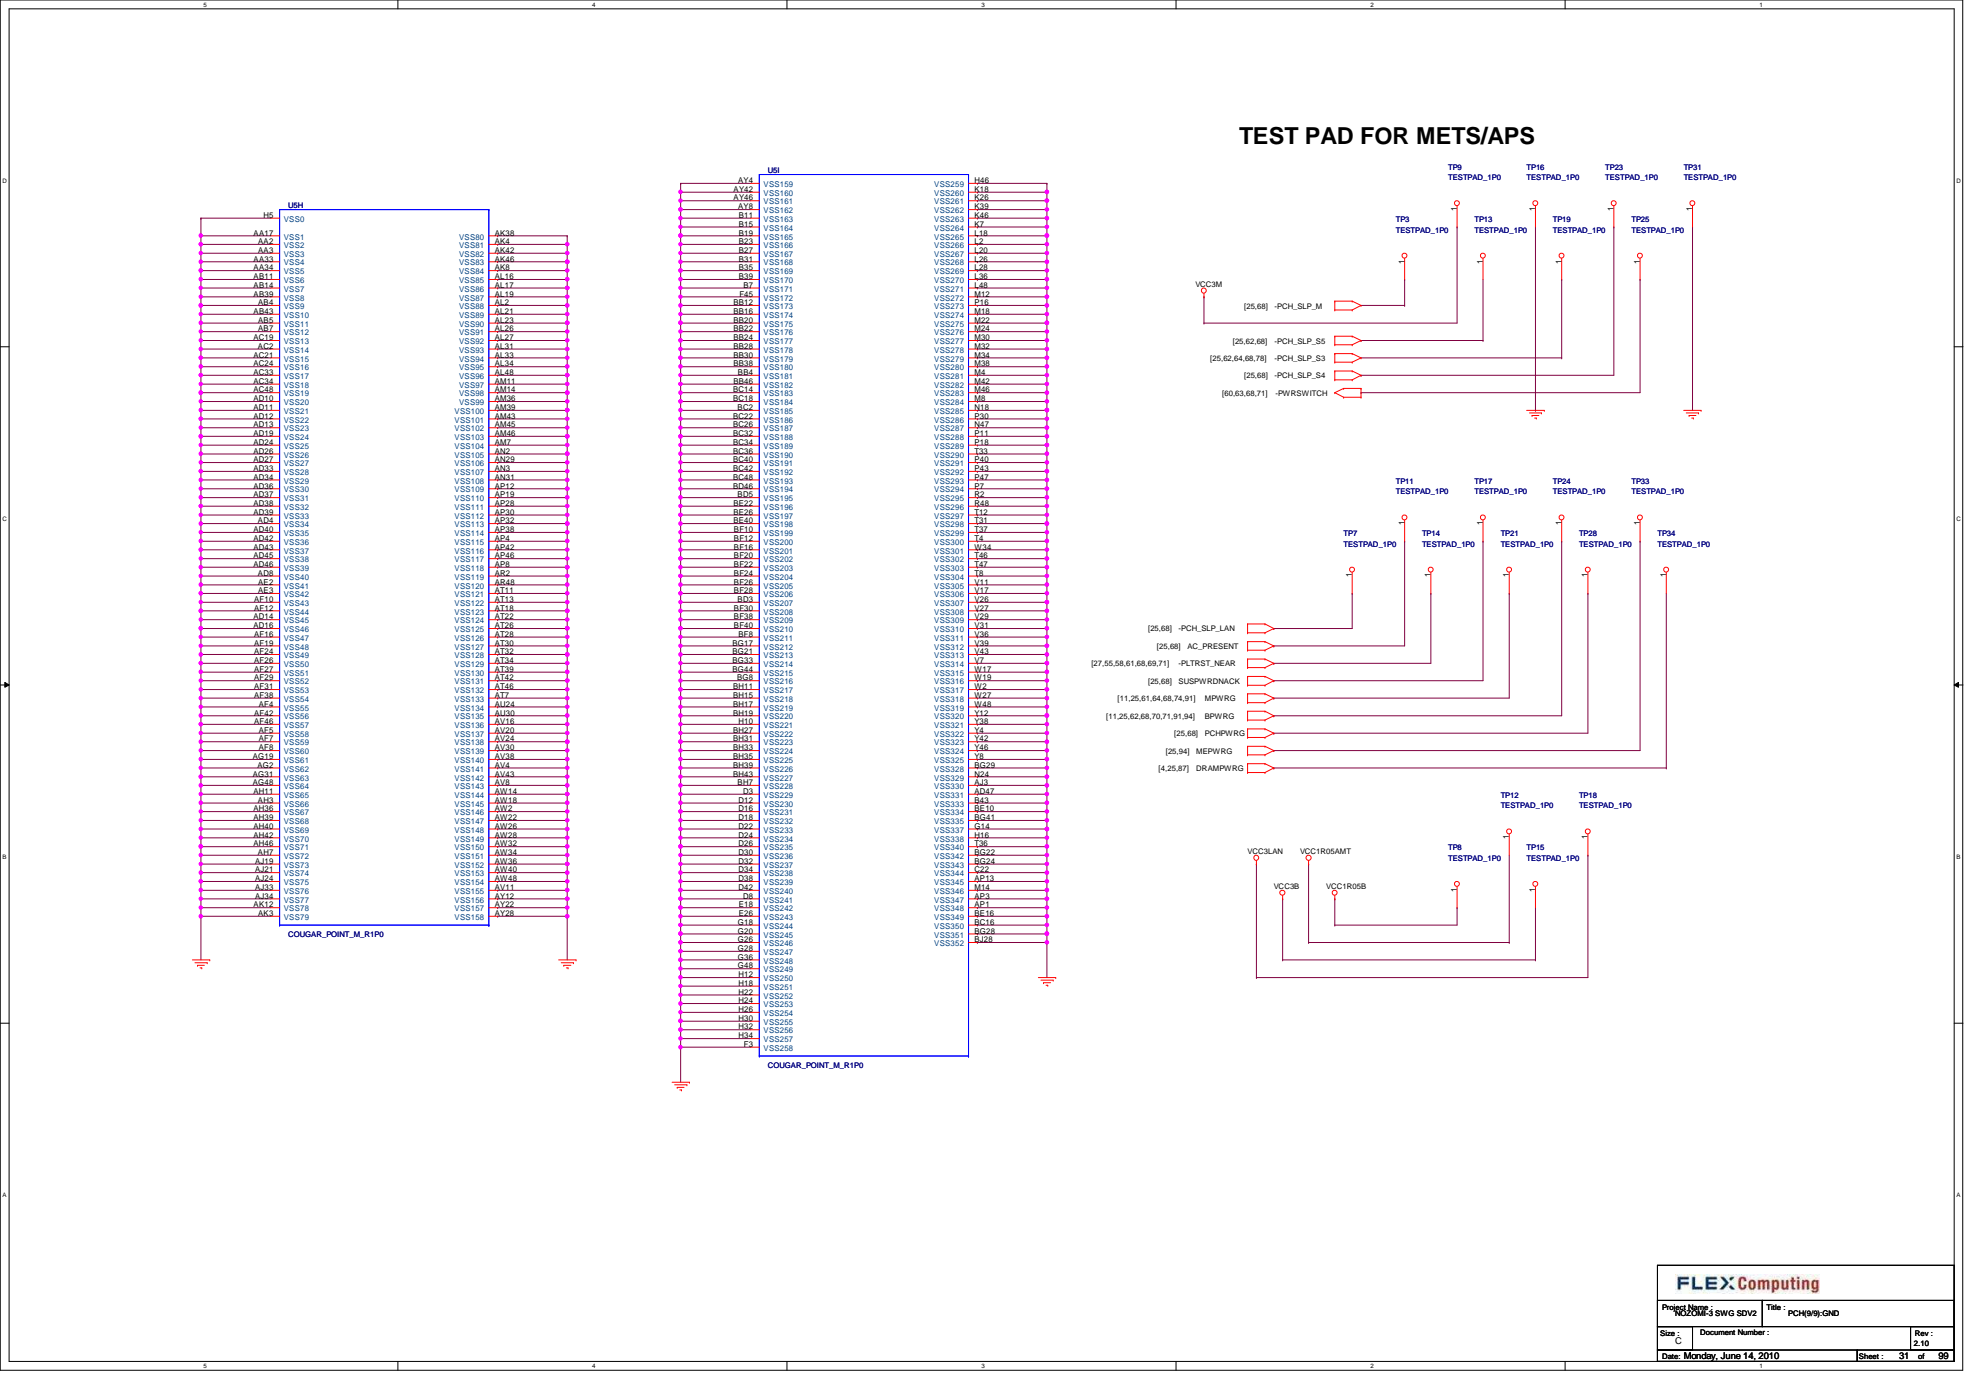
[picture p85: page 31]

0.9A

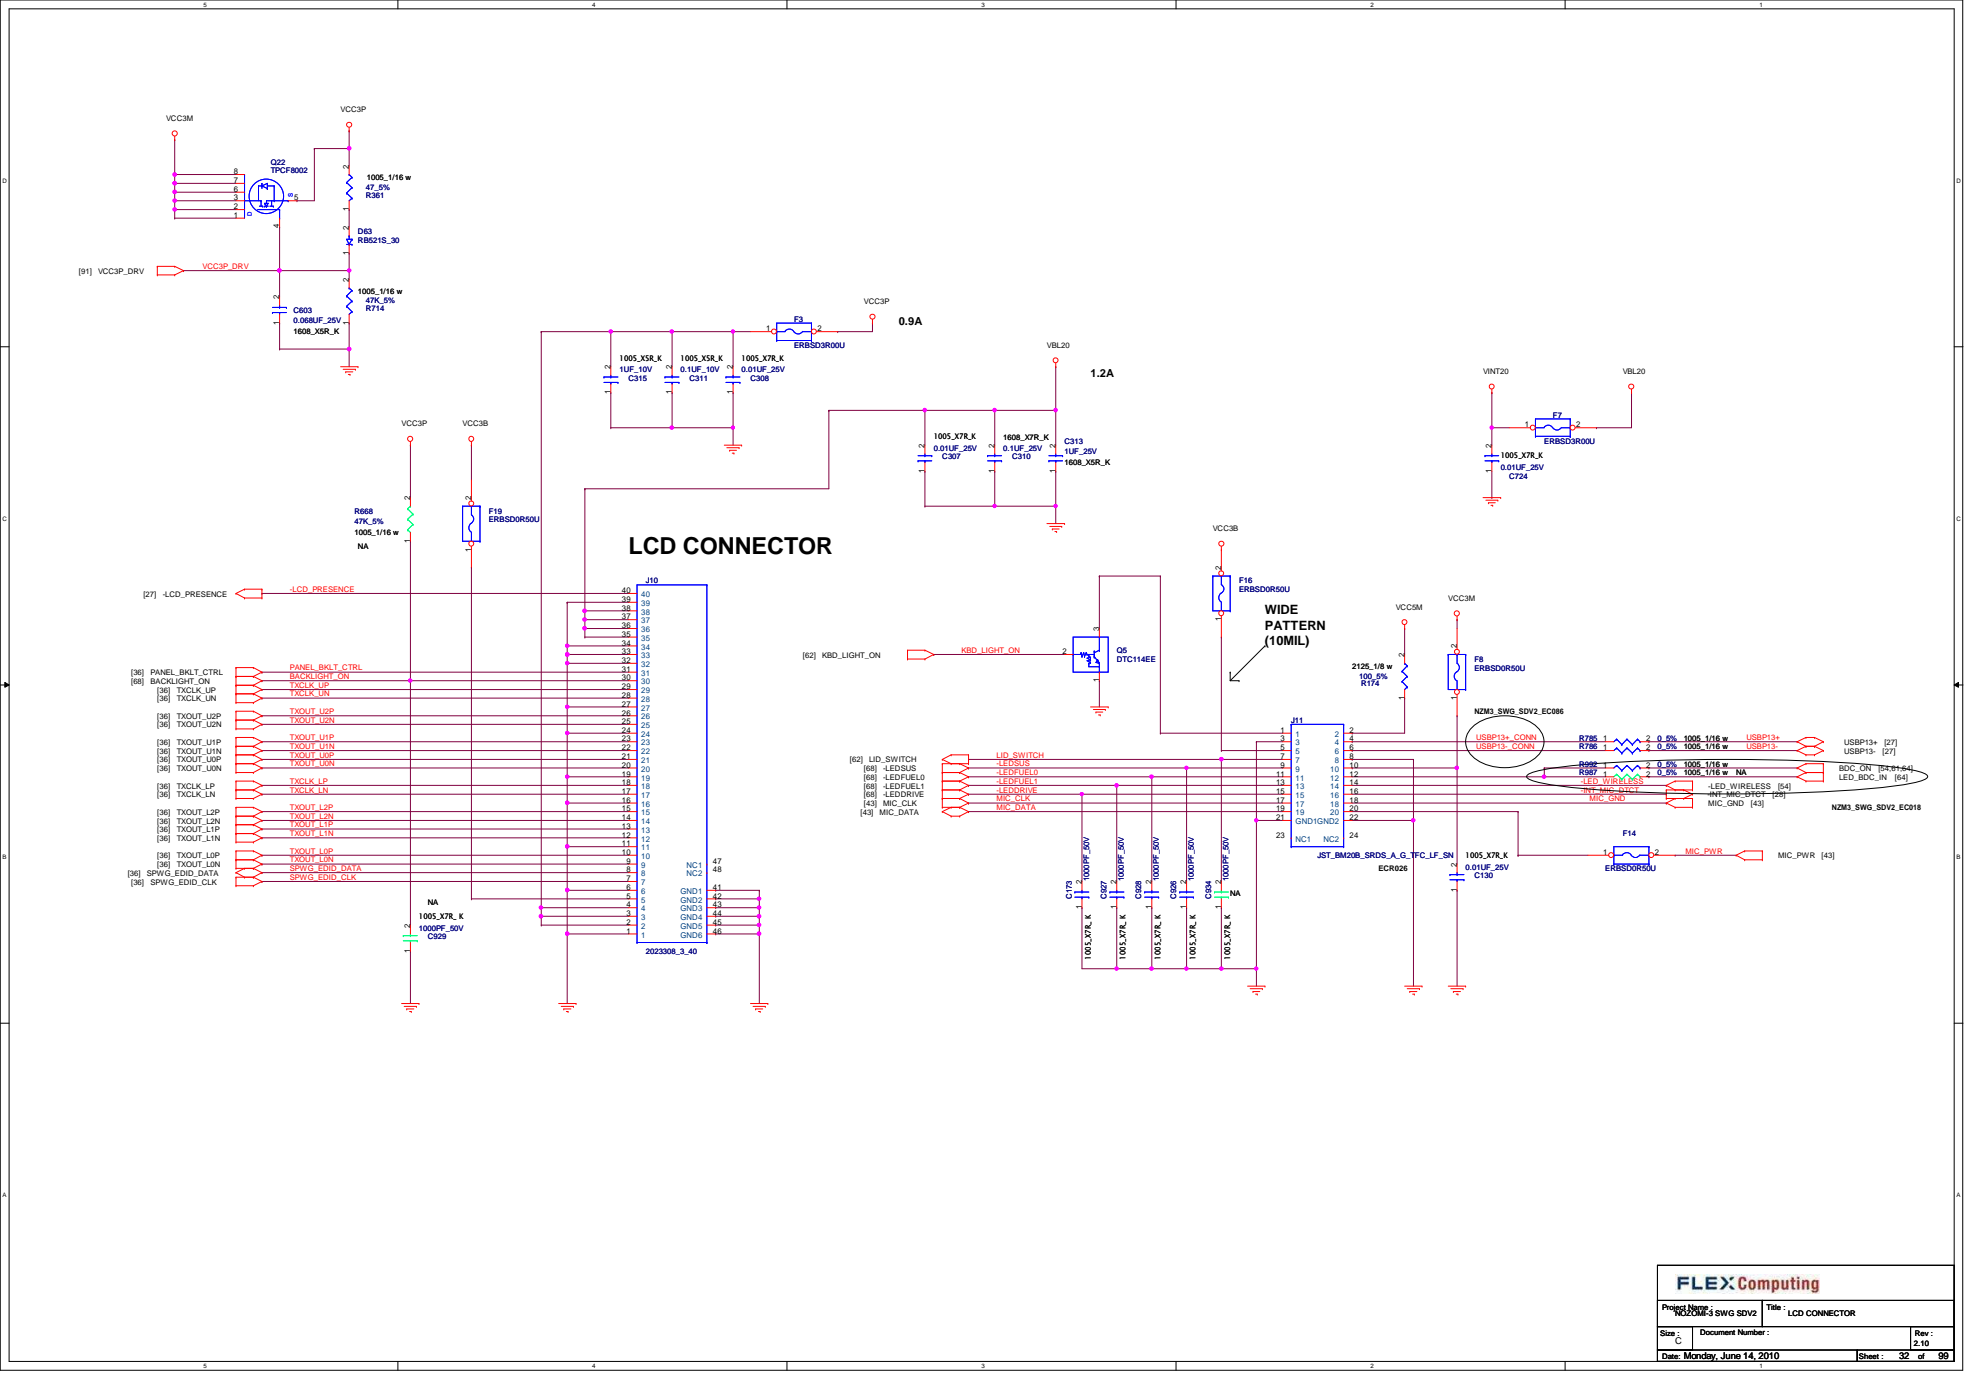
[picture p86: page 32]

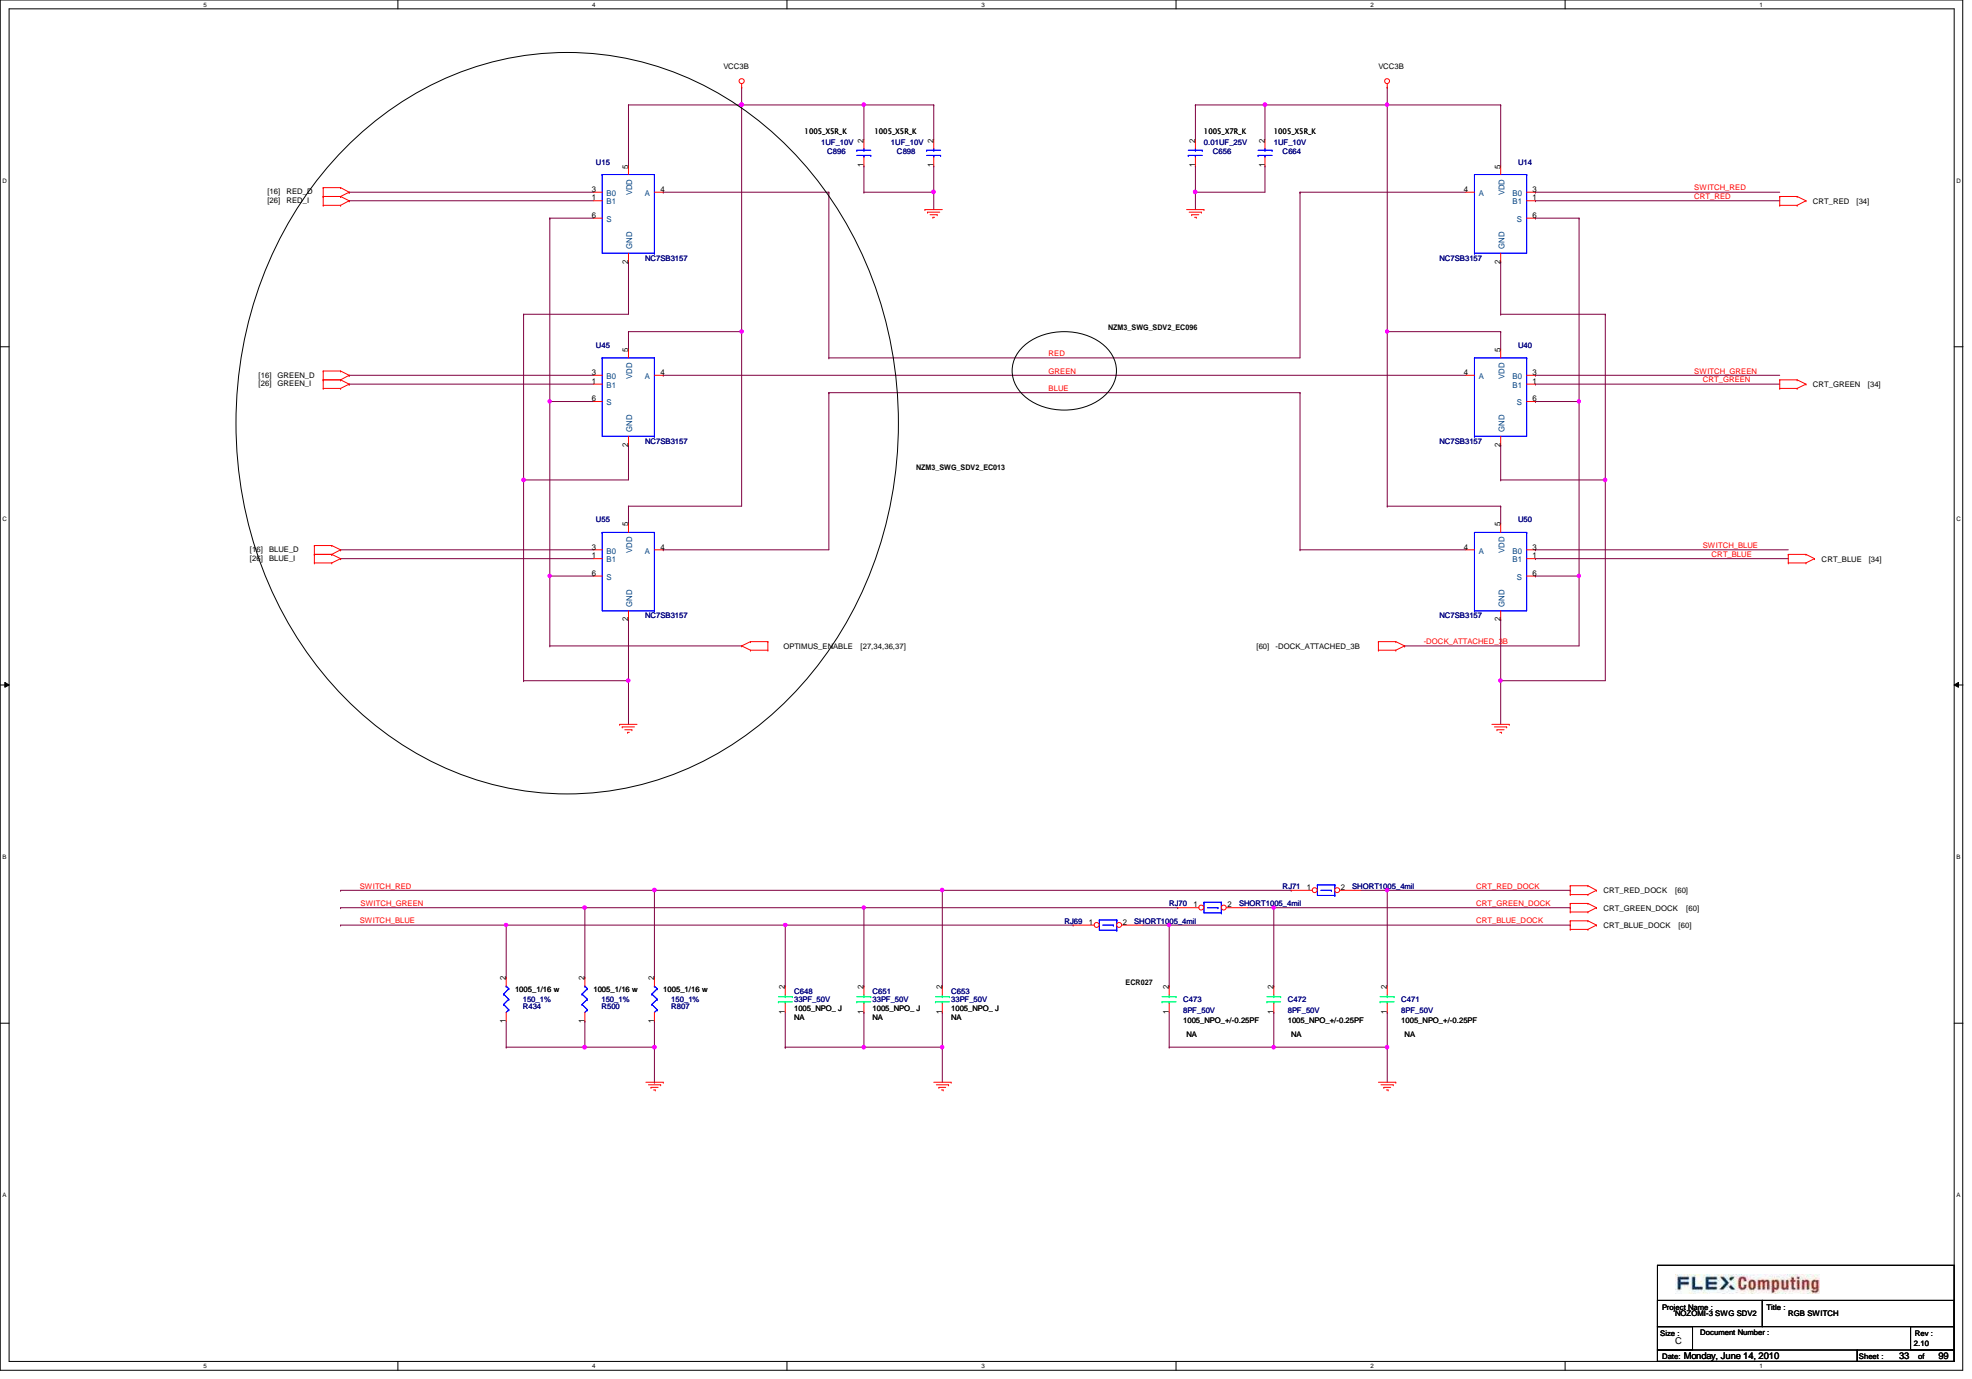
[picture p87: page 33]

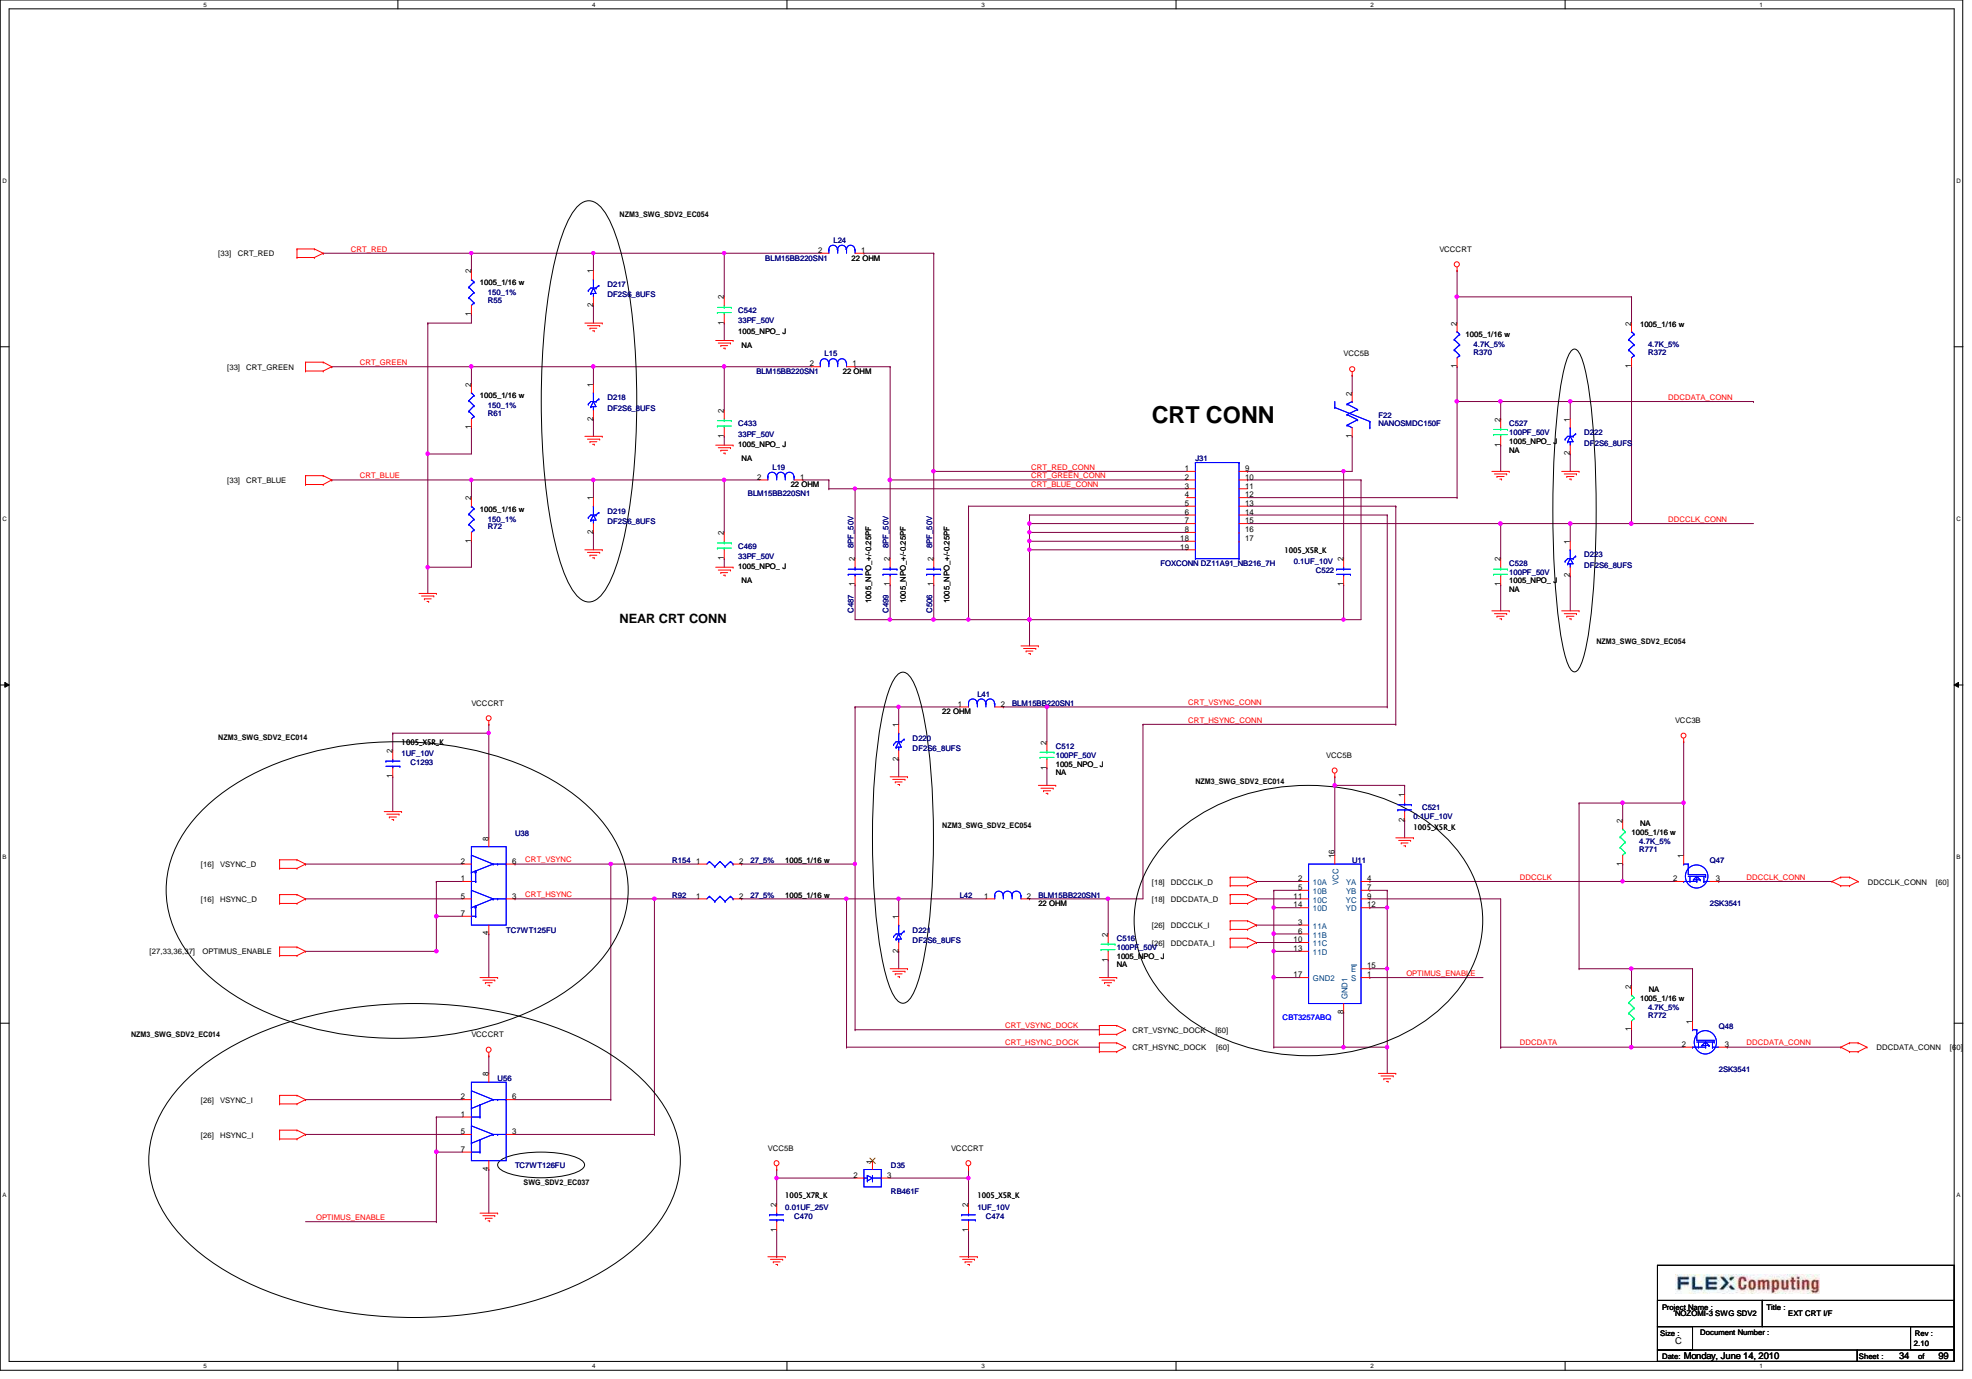
[picture p88: page 34]

## FOR SYSTEM DP NEAR DP CONN

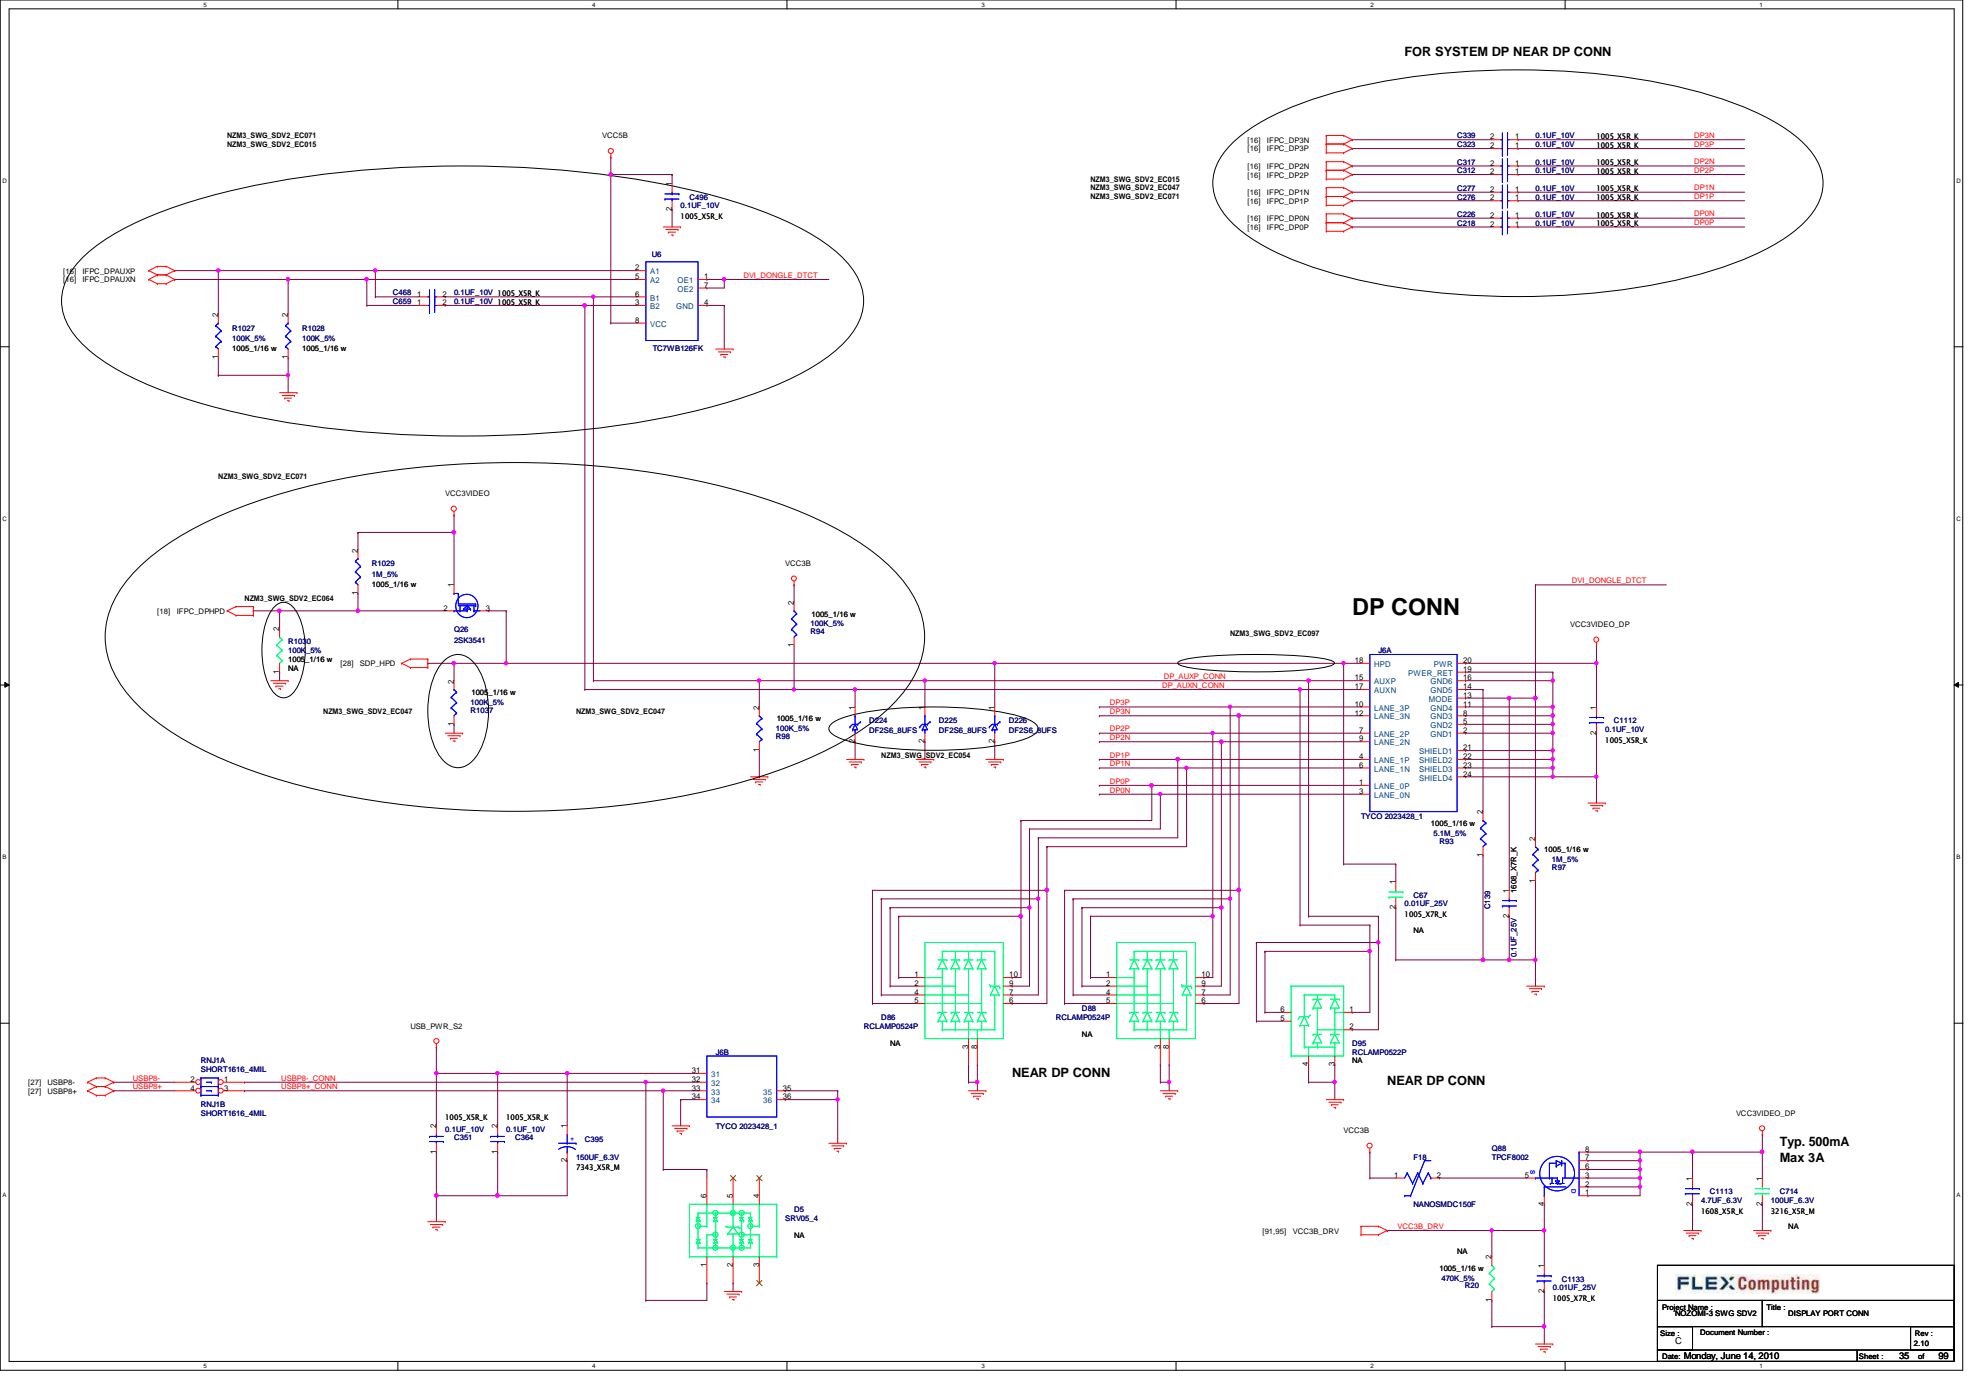
[picture p89: page 35]

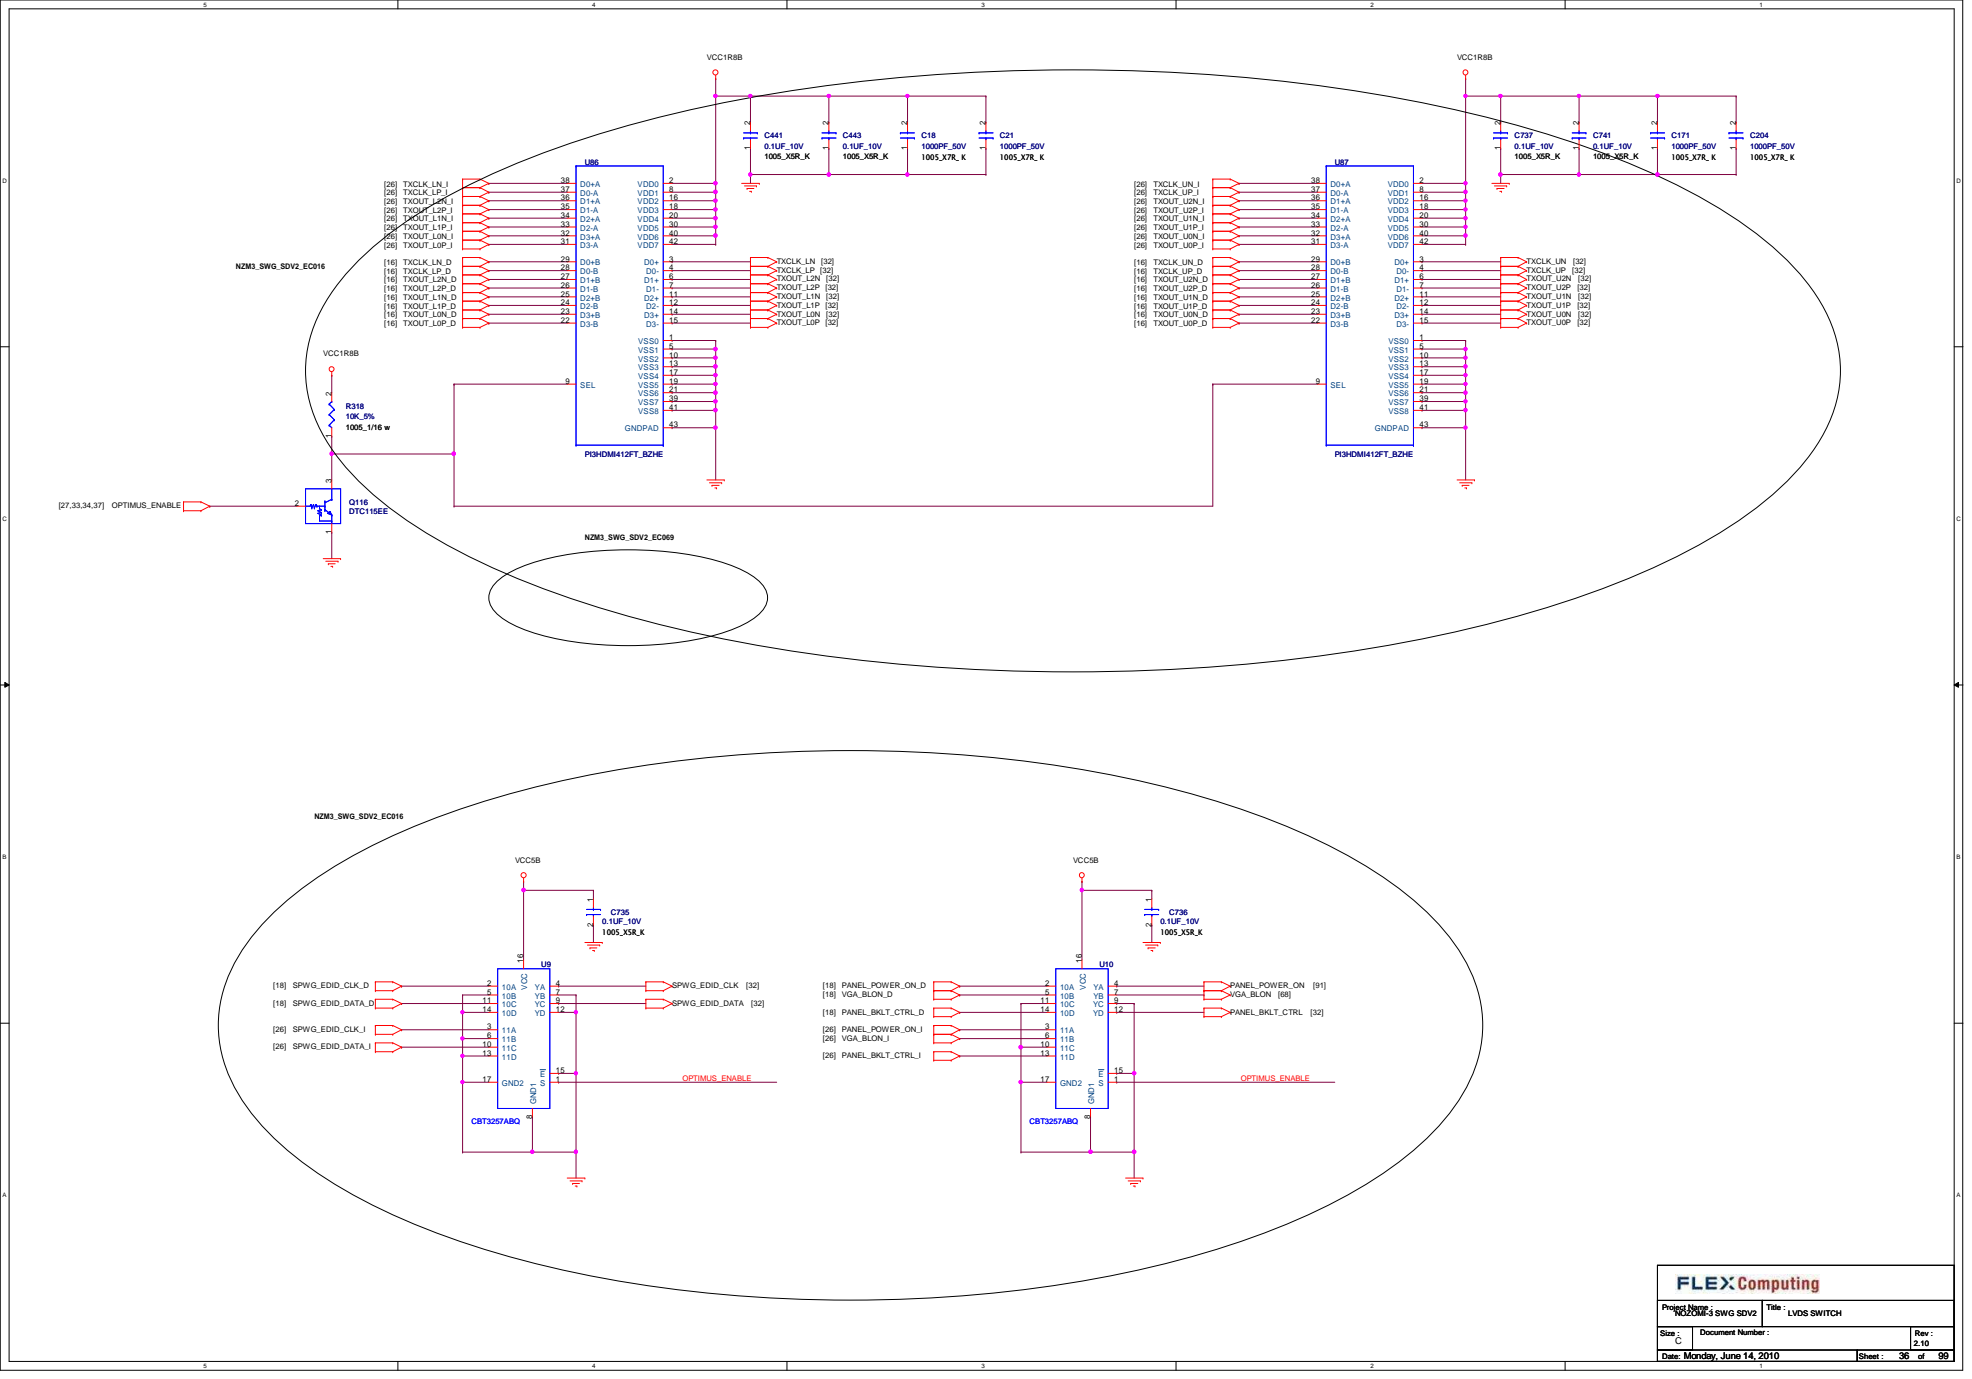
[picture p90: page 36]

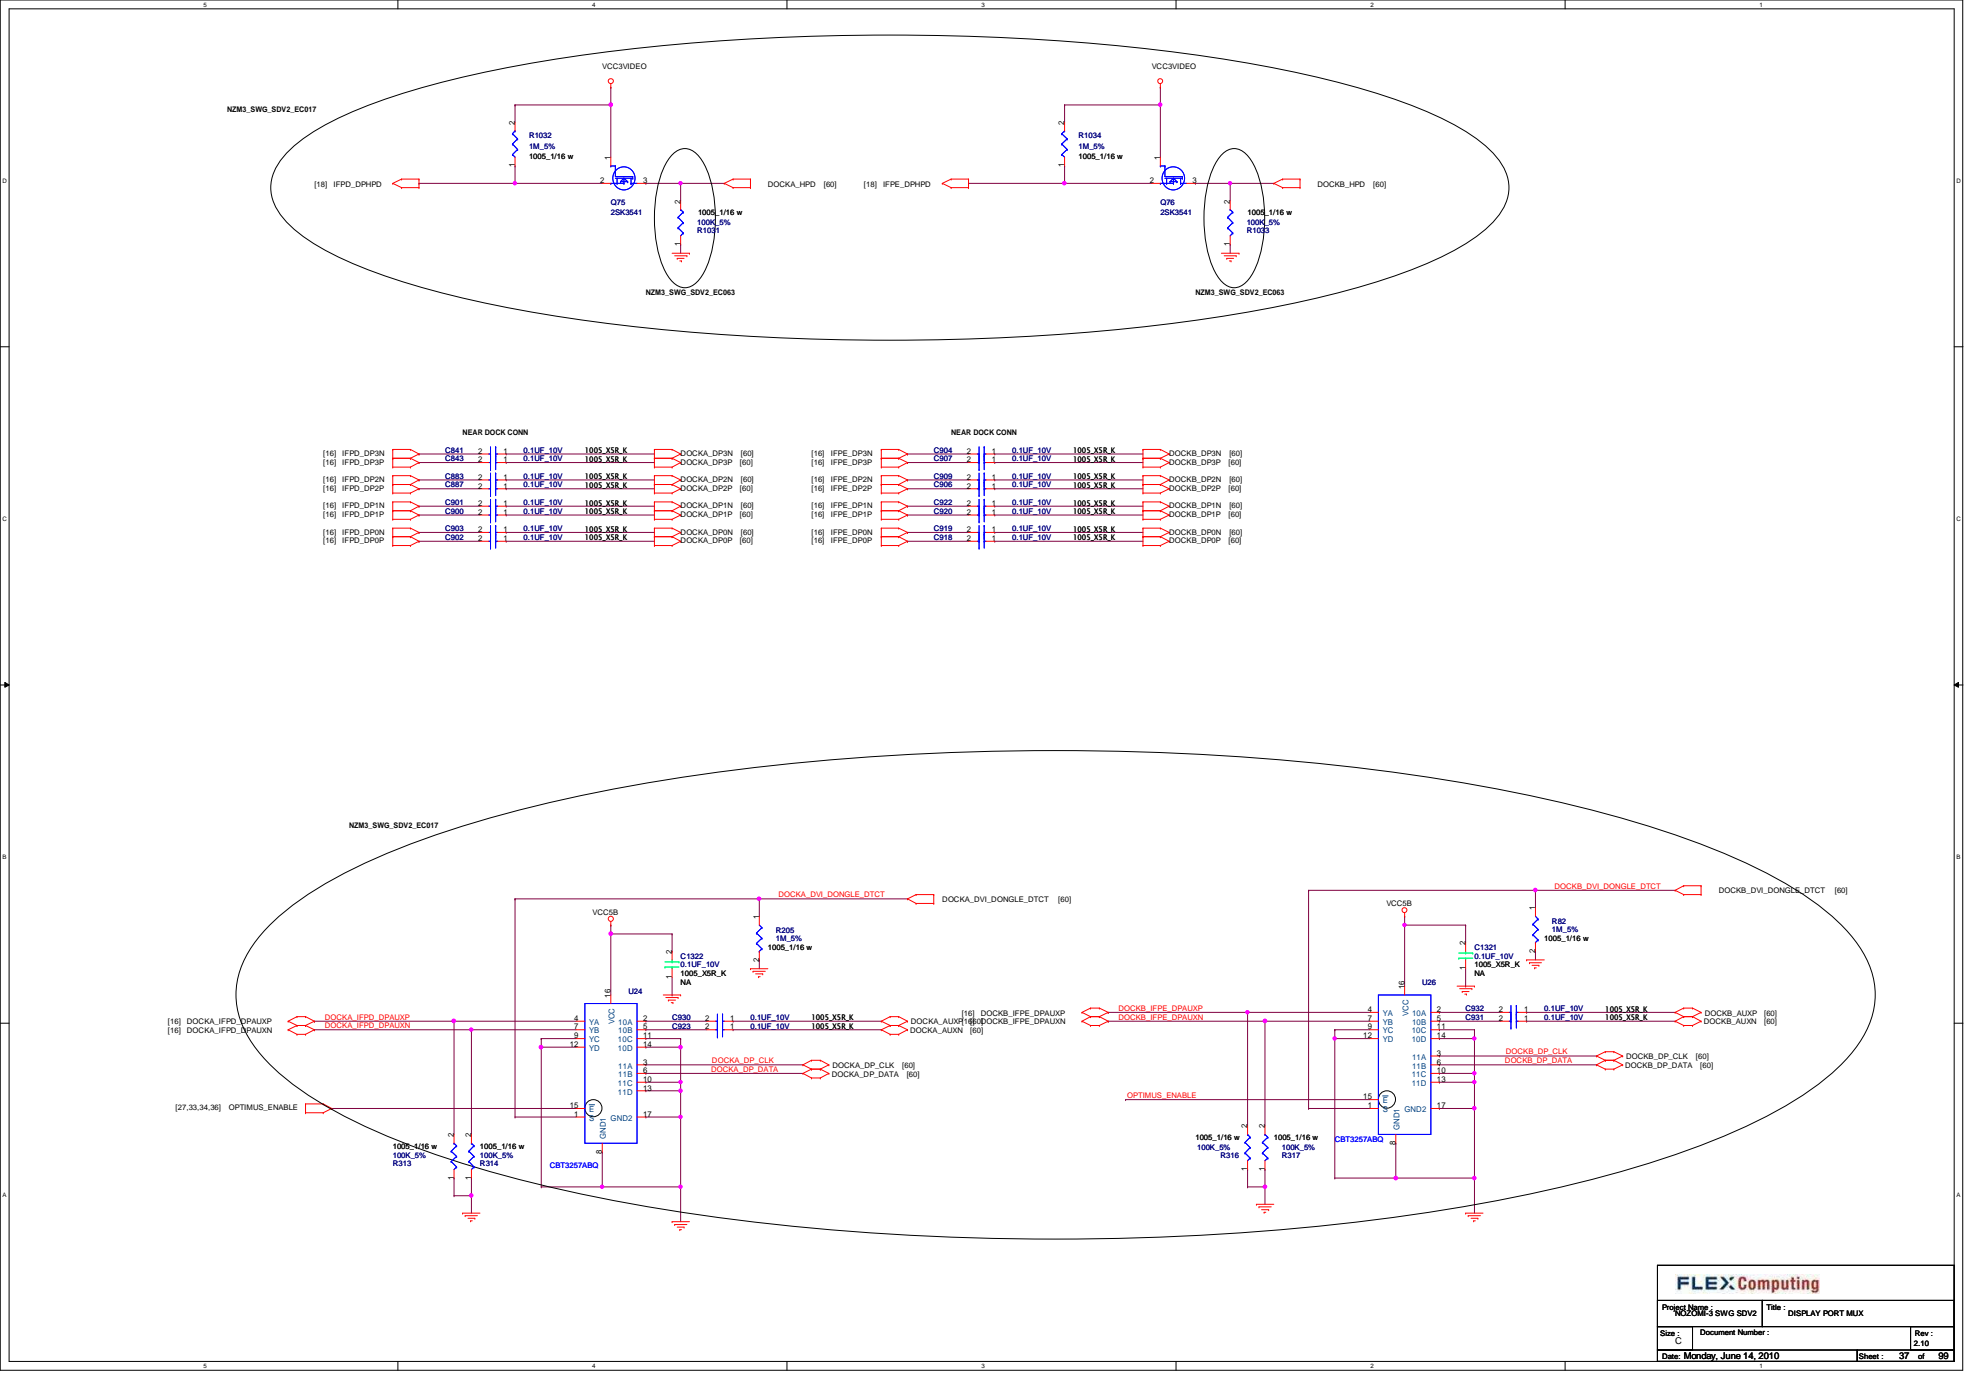
[picture p91: page 37]

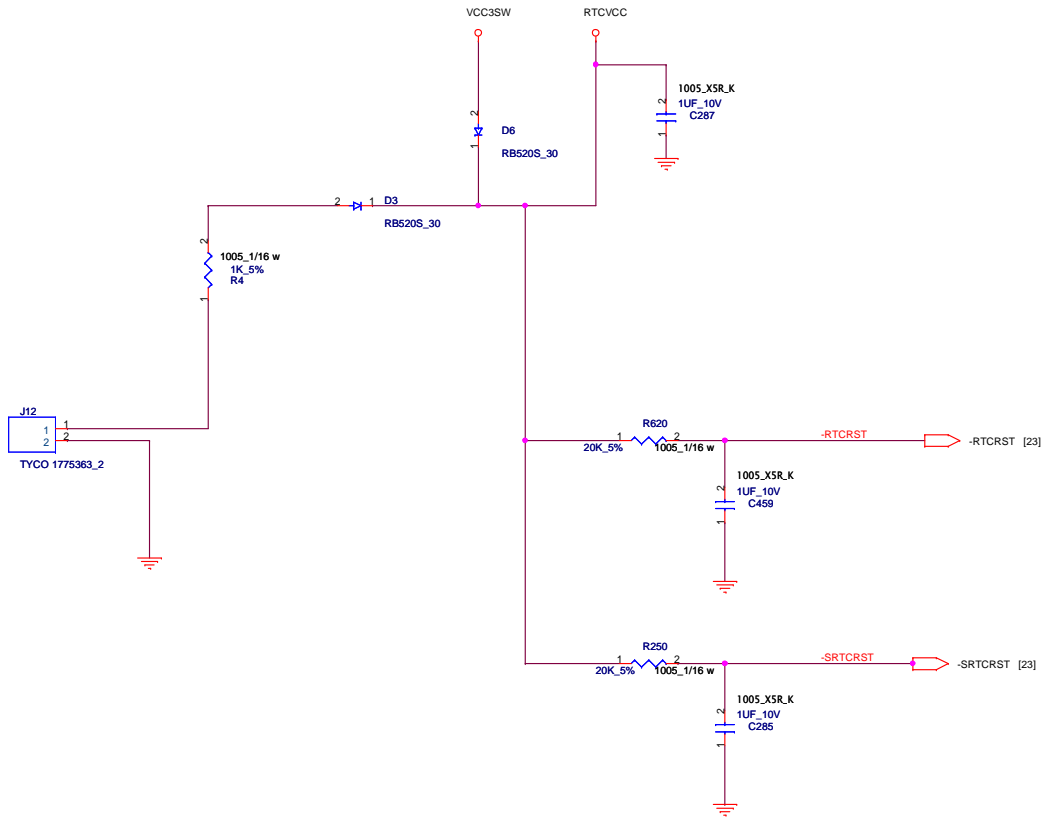
[picture p92: page 38]

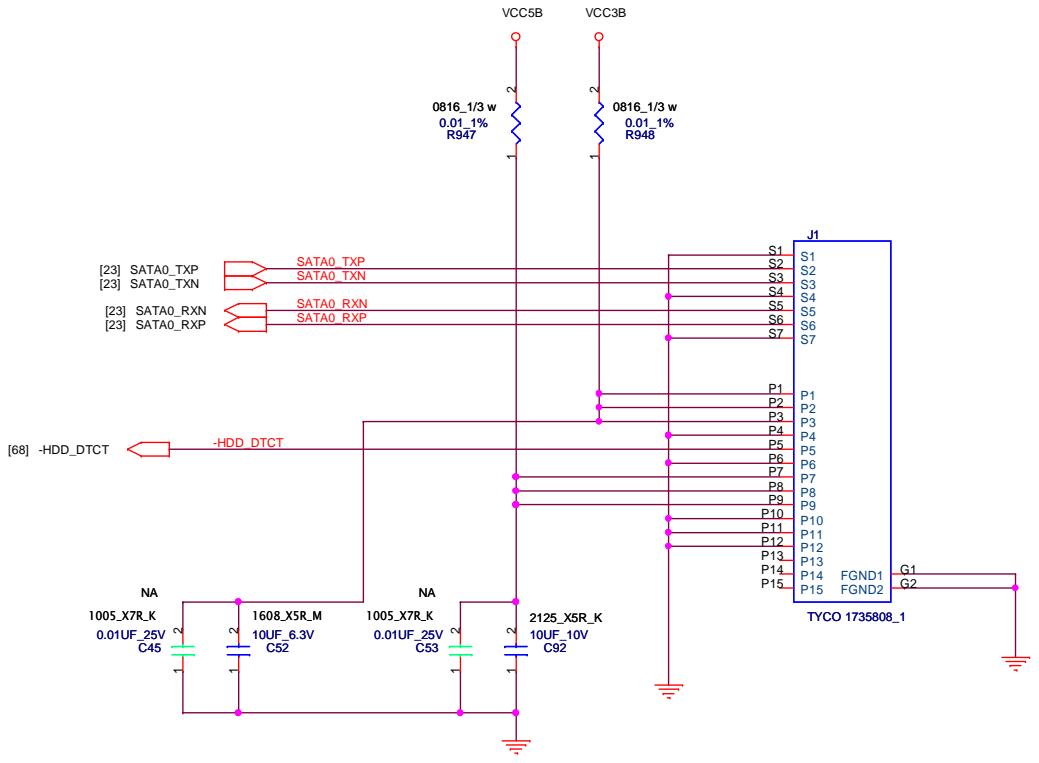
[picture p93: page 39]

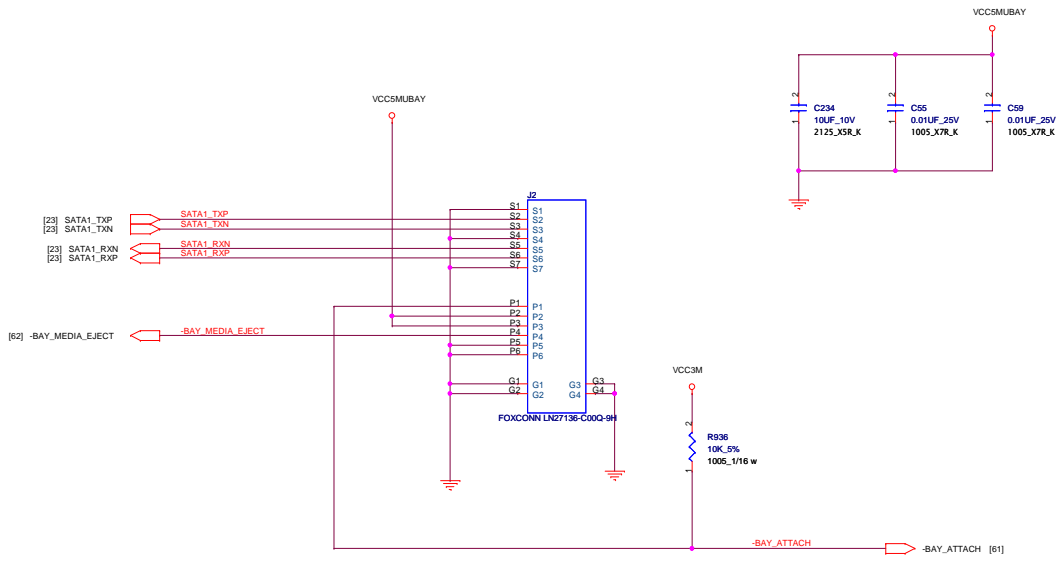
[picture p94: page 40]

## MINIMUM STUB LENGTH

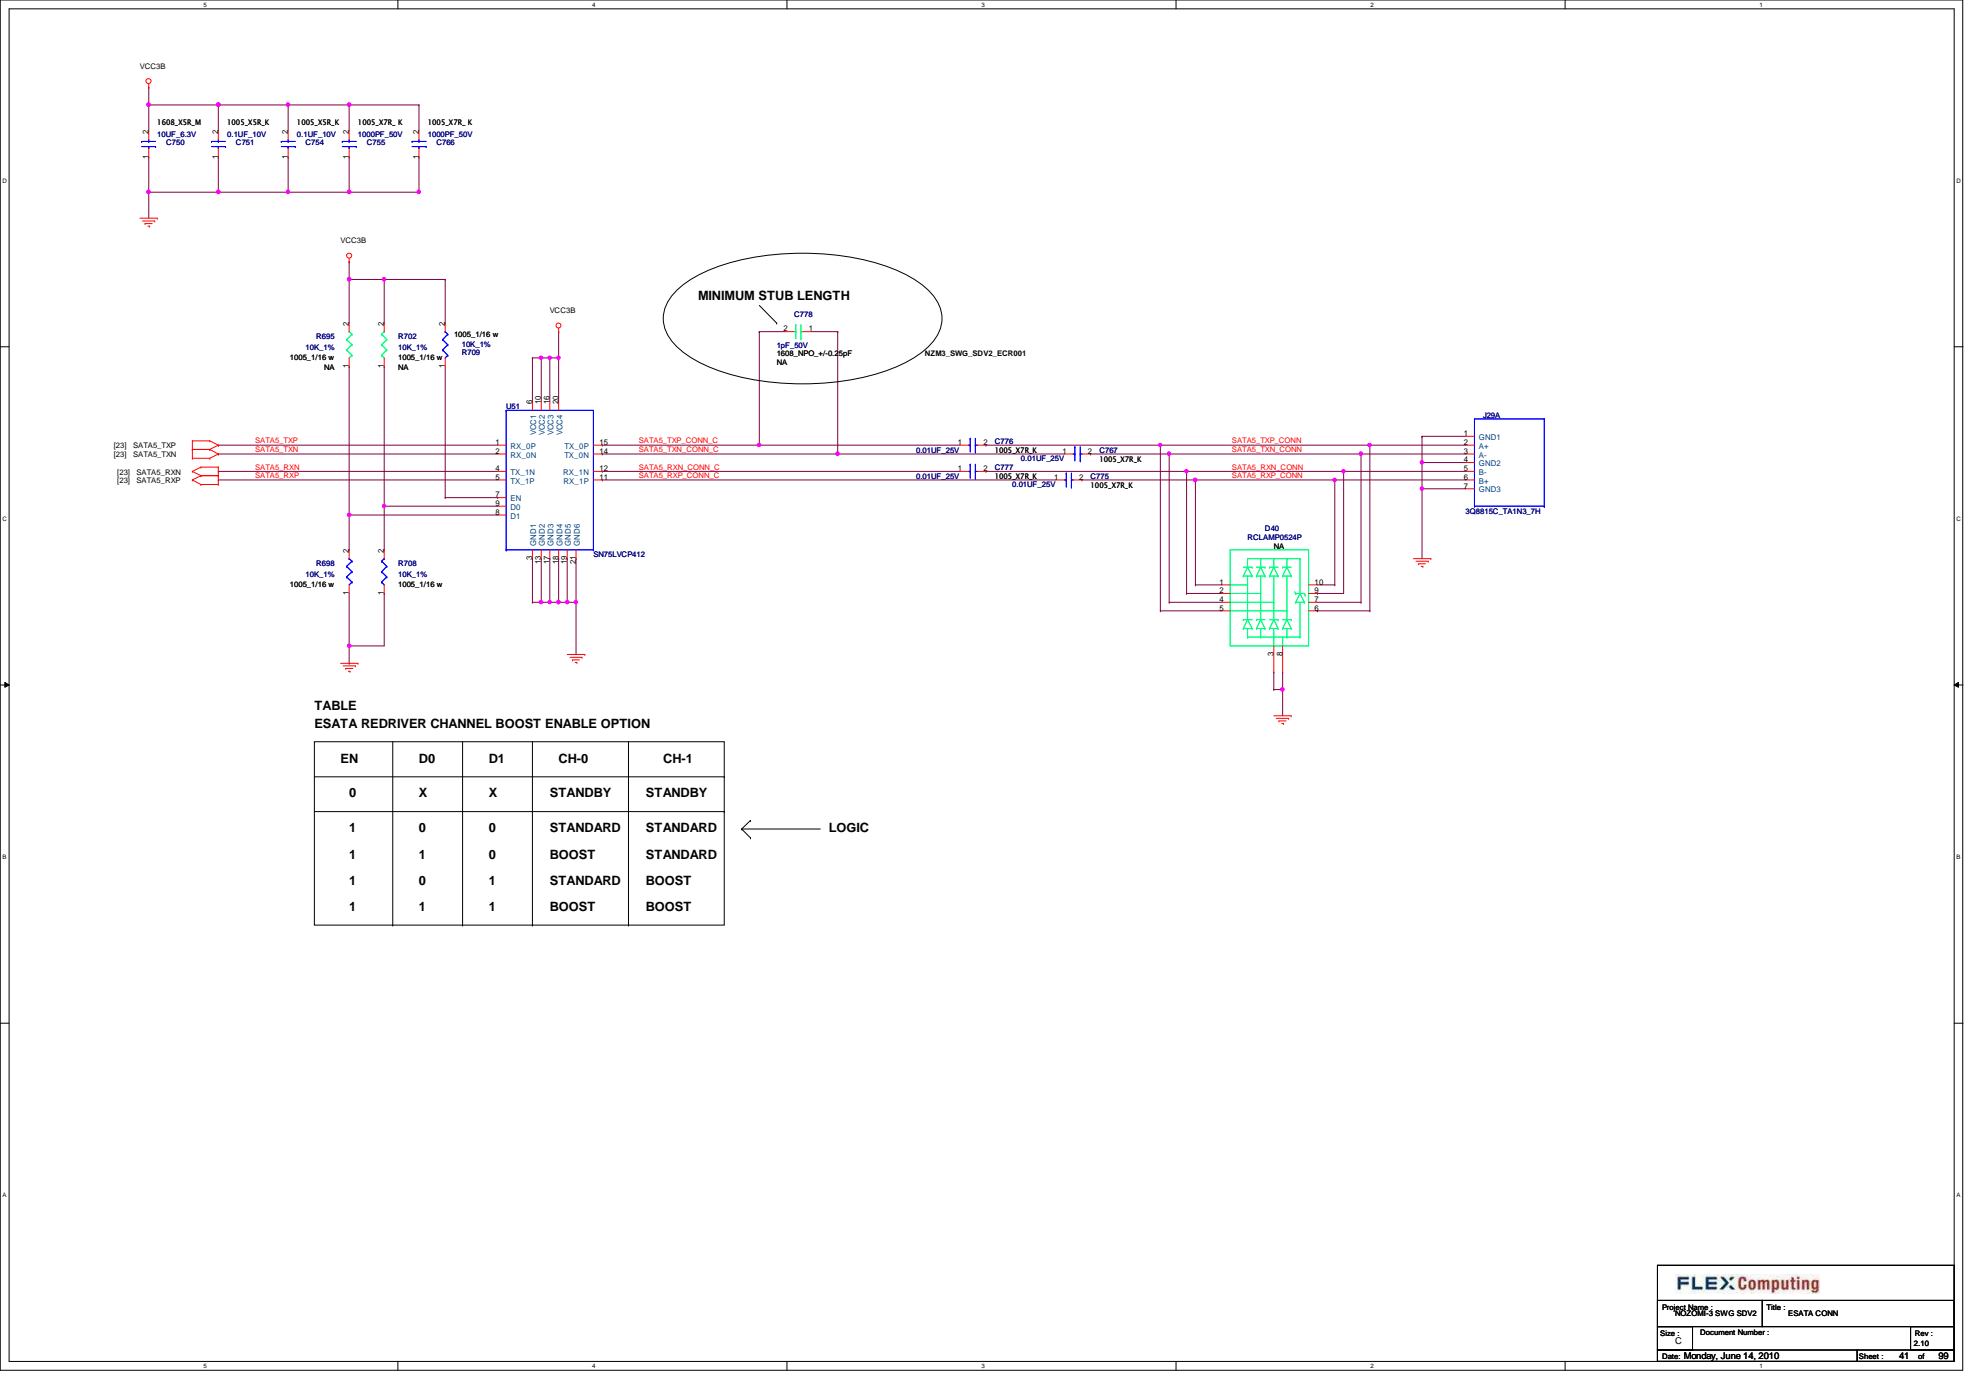
[picture p95: page 41]

TABLE
ESATA REDRIVER CHANNEL BOOST ENABLE OPTION

## WIDE PATTERN(MIN 500mA) PLACE NEAR USB CONN

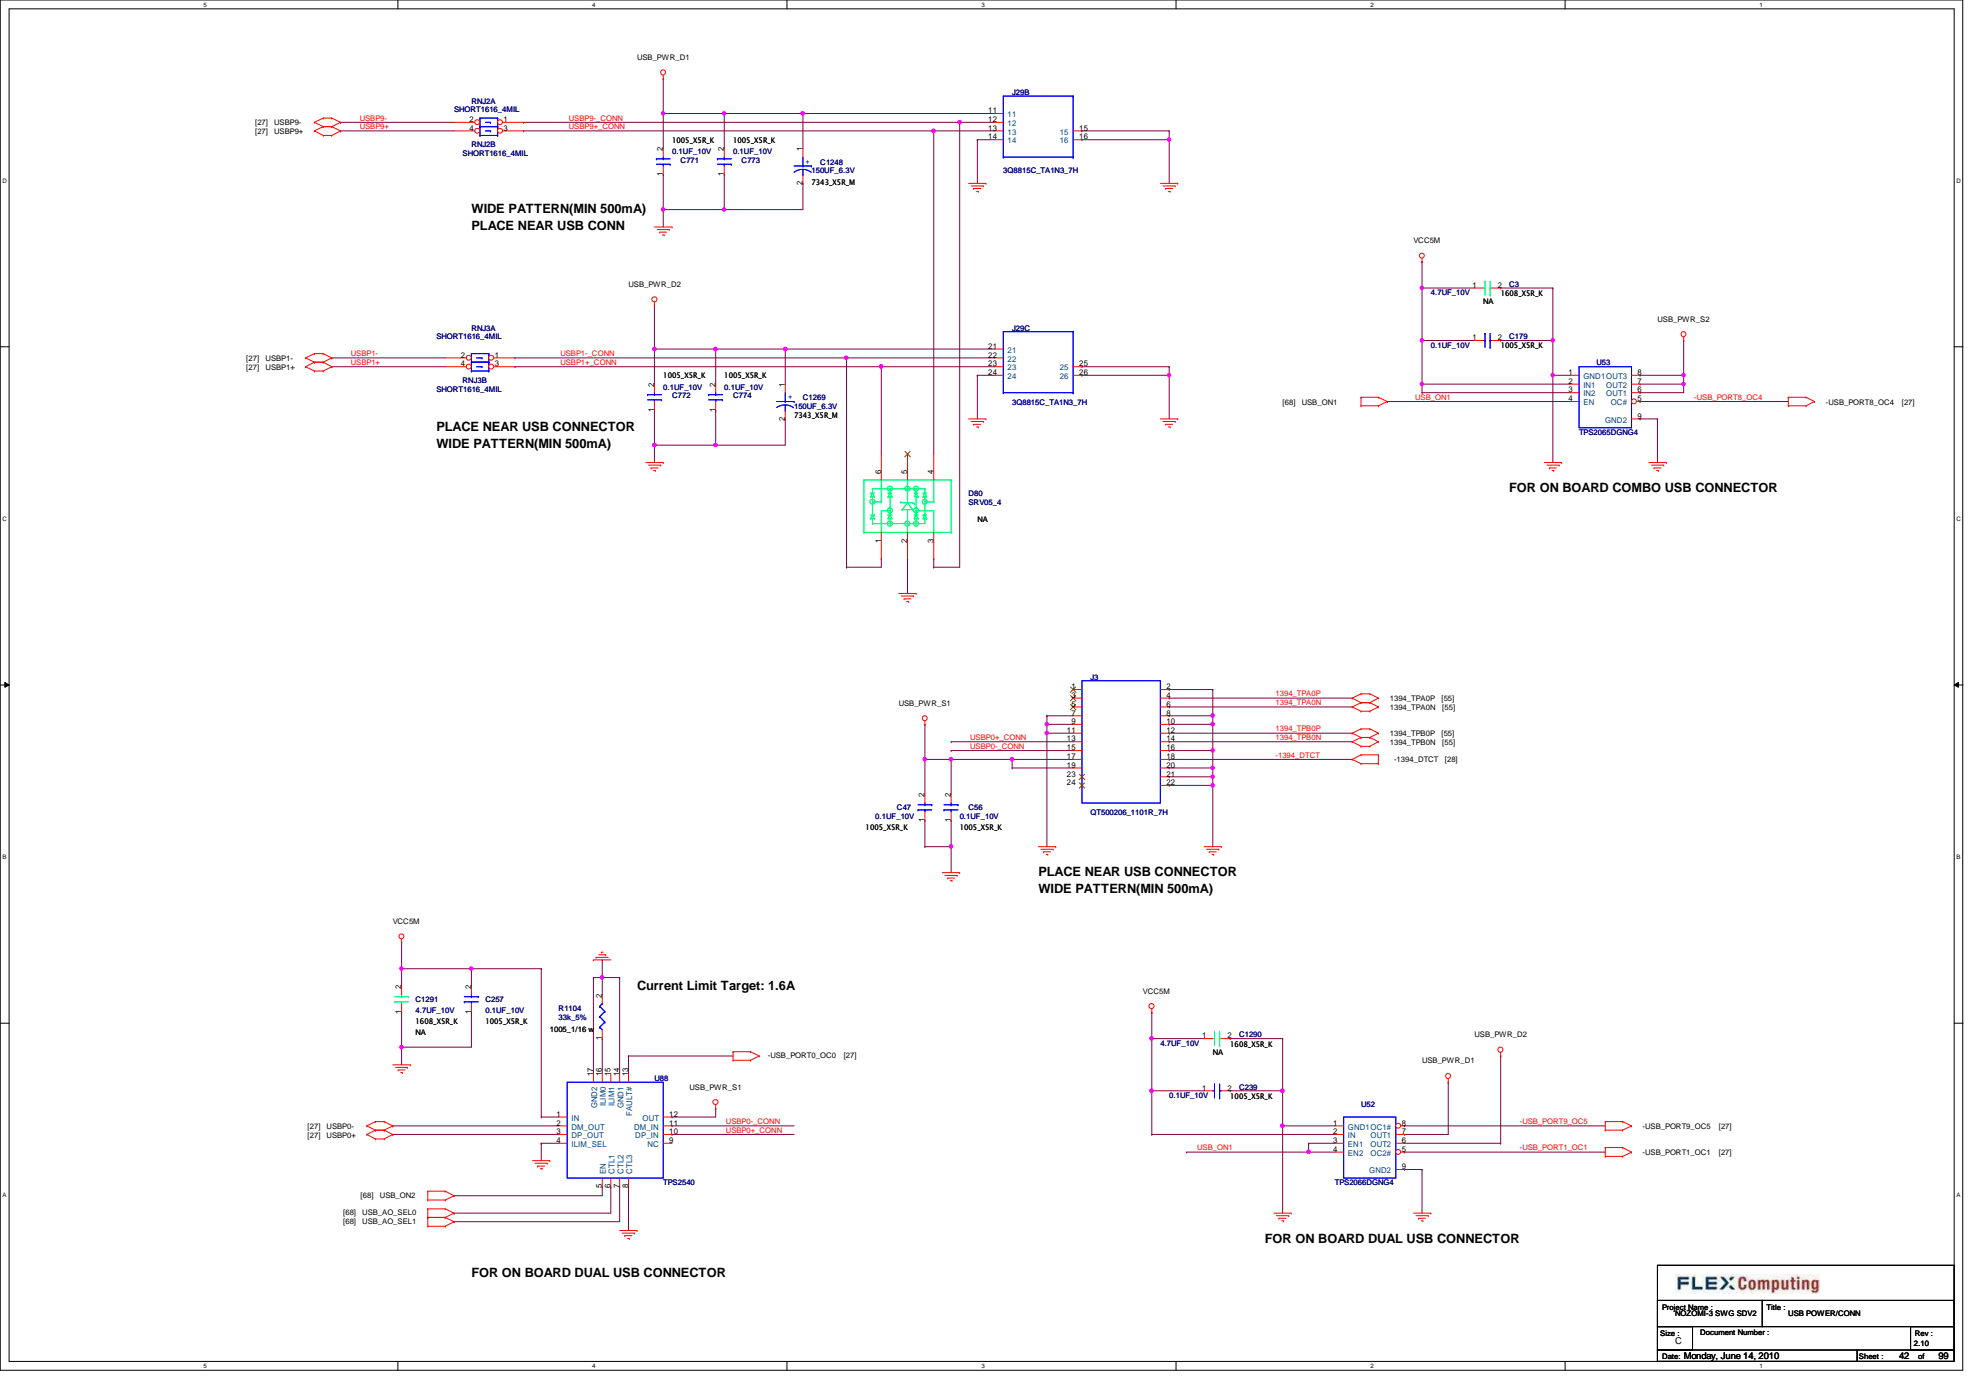
[picture p96: page 42]

PLACE NEAR USB CONNECTOR
WIDE PATTERN(MIN 500mA)

FOR ON BOARD COMBO USB CONNECTOR

FOR ON BOARD DUAL USB CONNECTOR

## NO ASM

## NO ASM

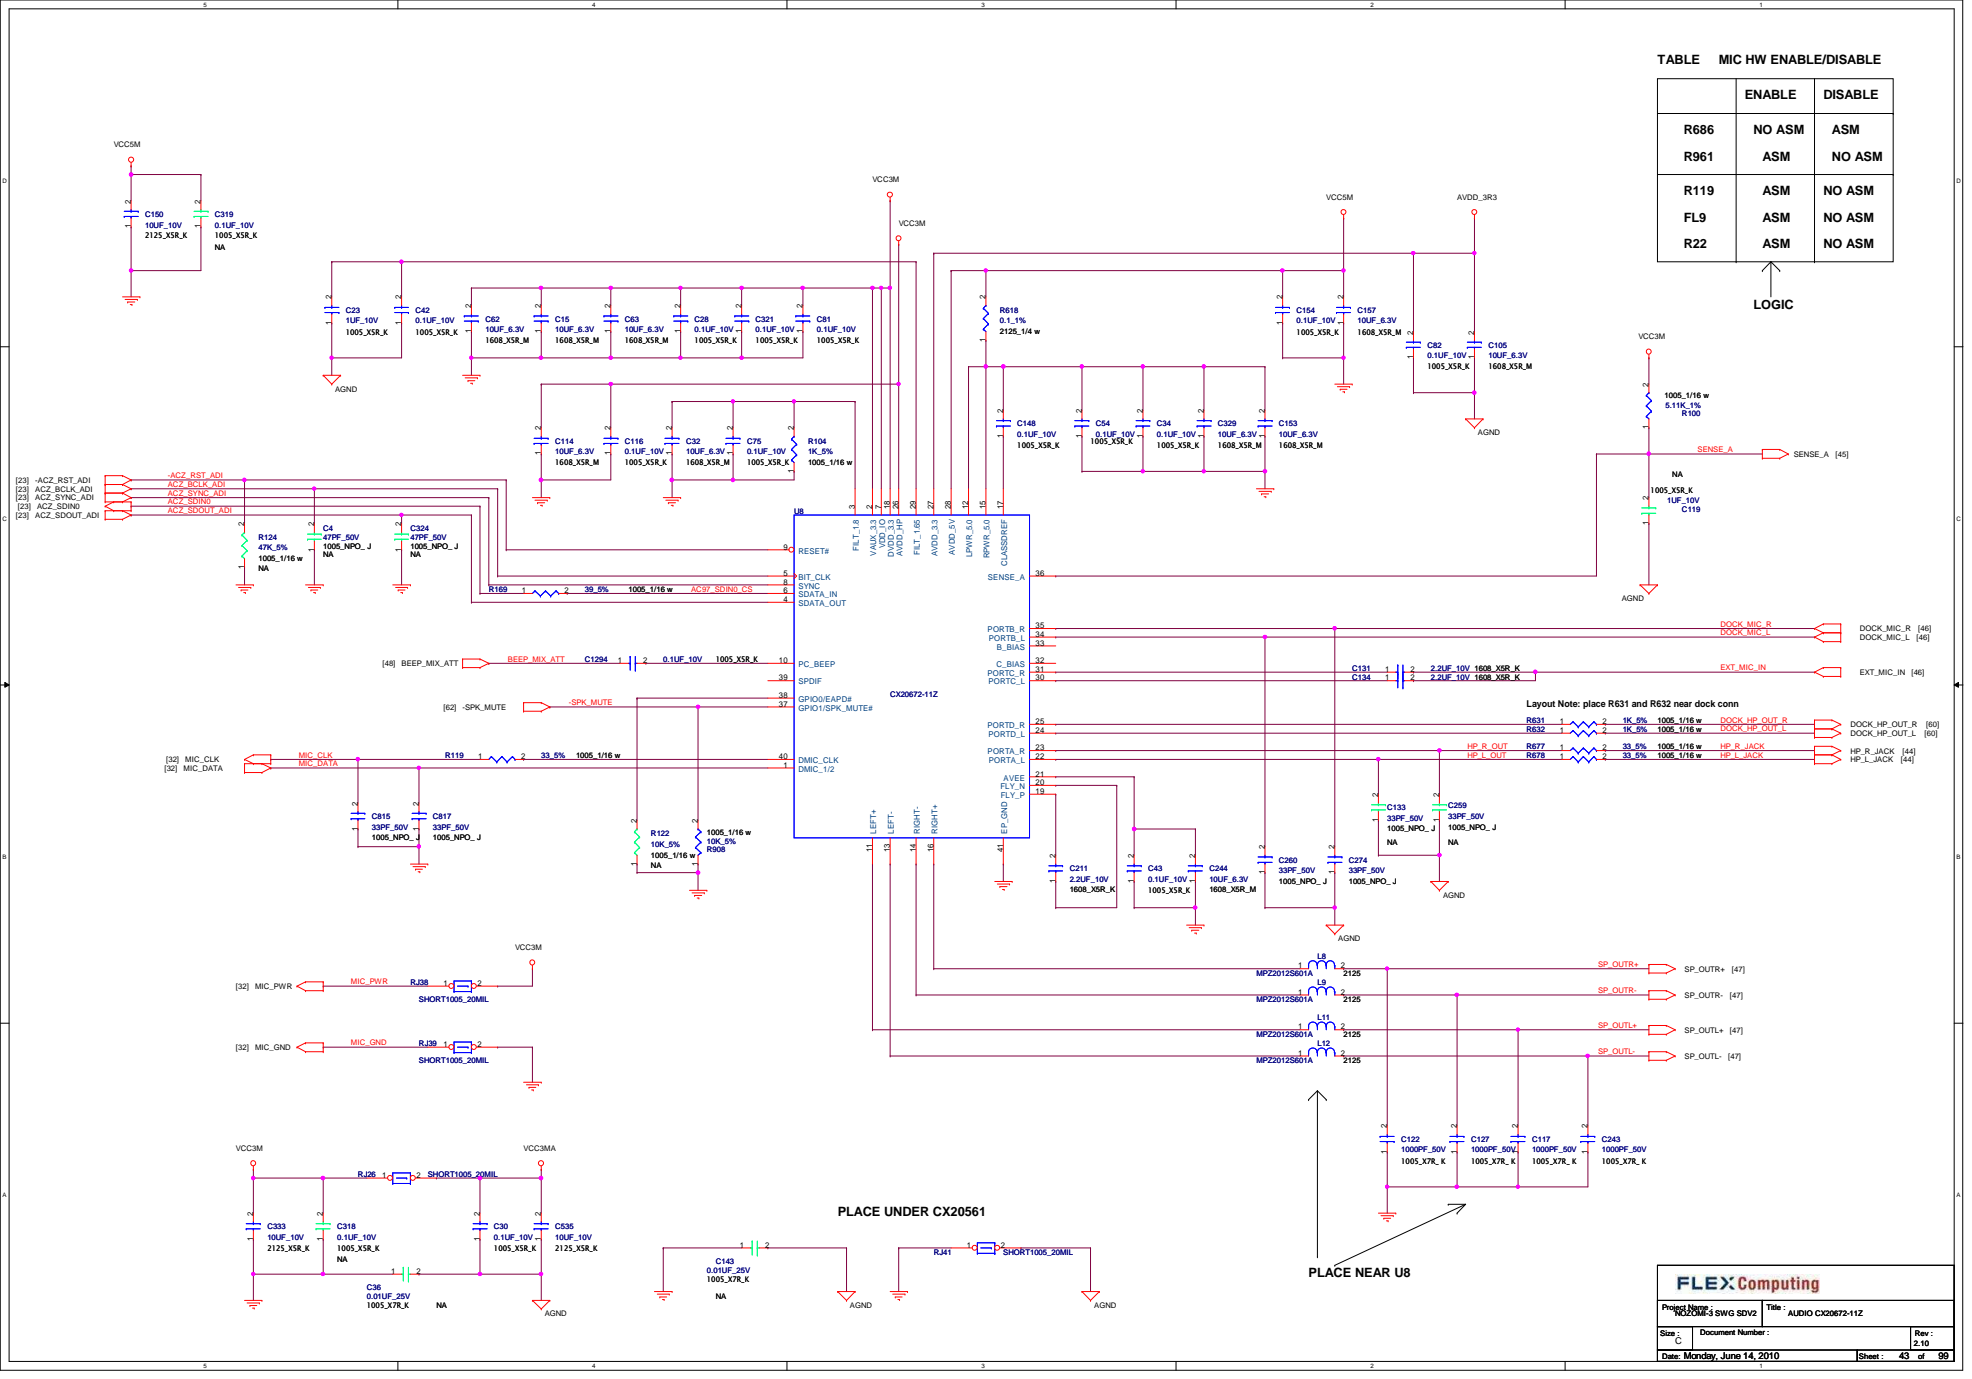
[picture p97: page 43]

MIC HW ENABLE/DISABLE

Layout Note: place R631 and R632 near dock conn

# NEAR AUDIO CONN

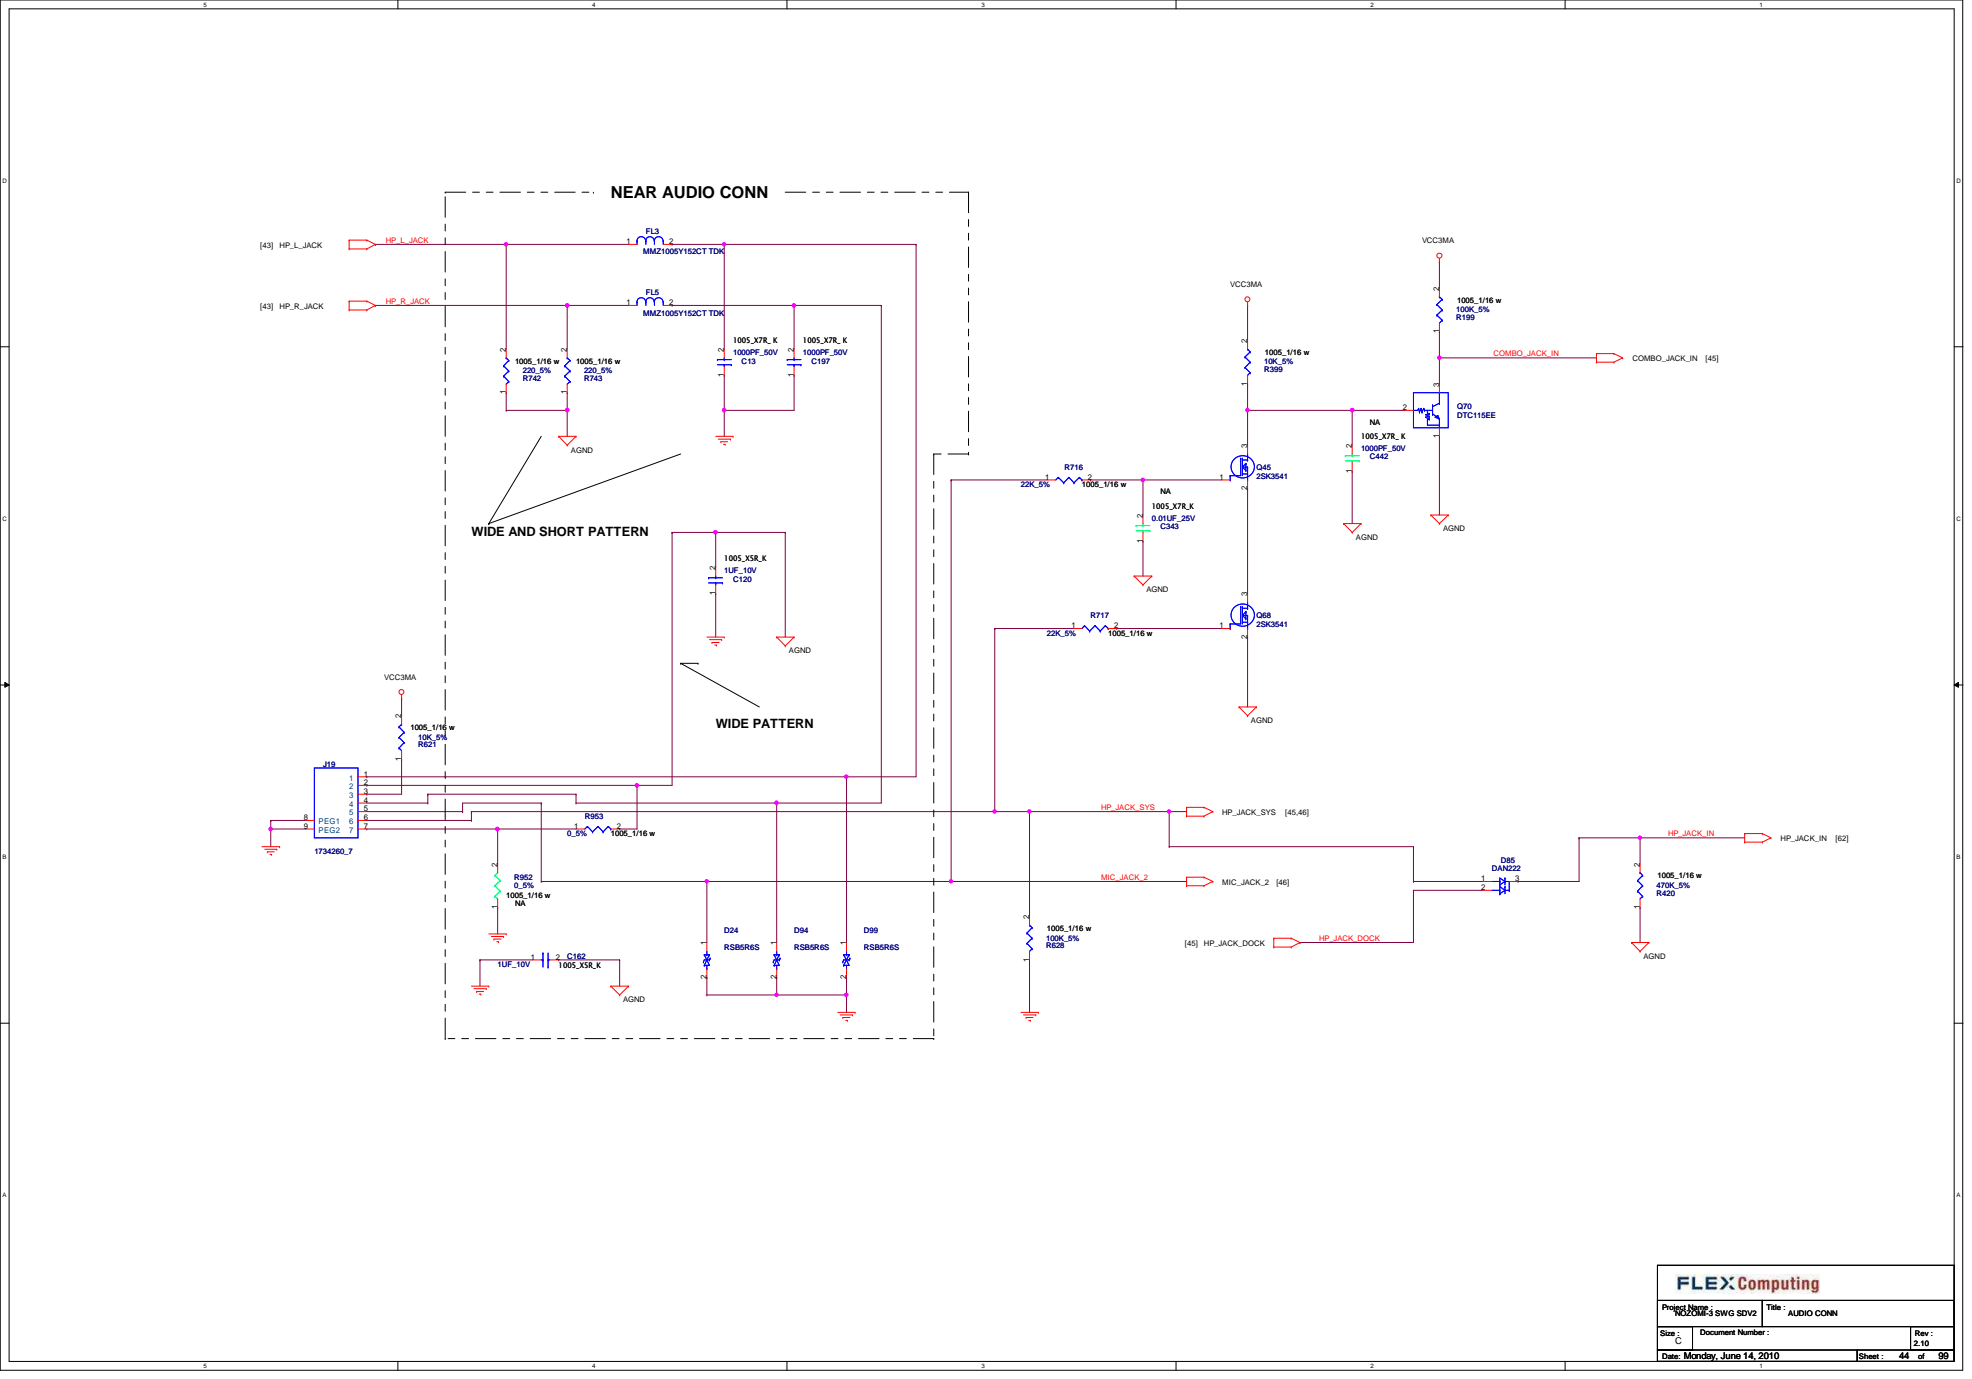
[picture p98: page 44]

WIDE AND SHORT PATTERN

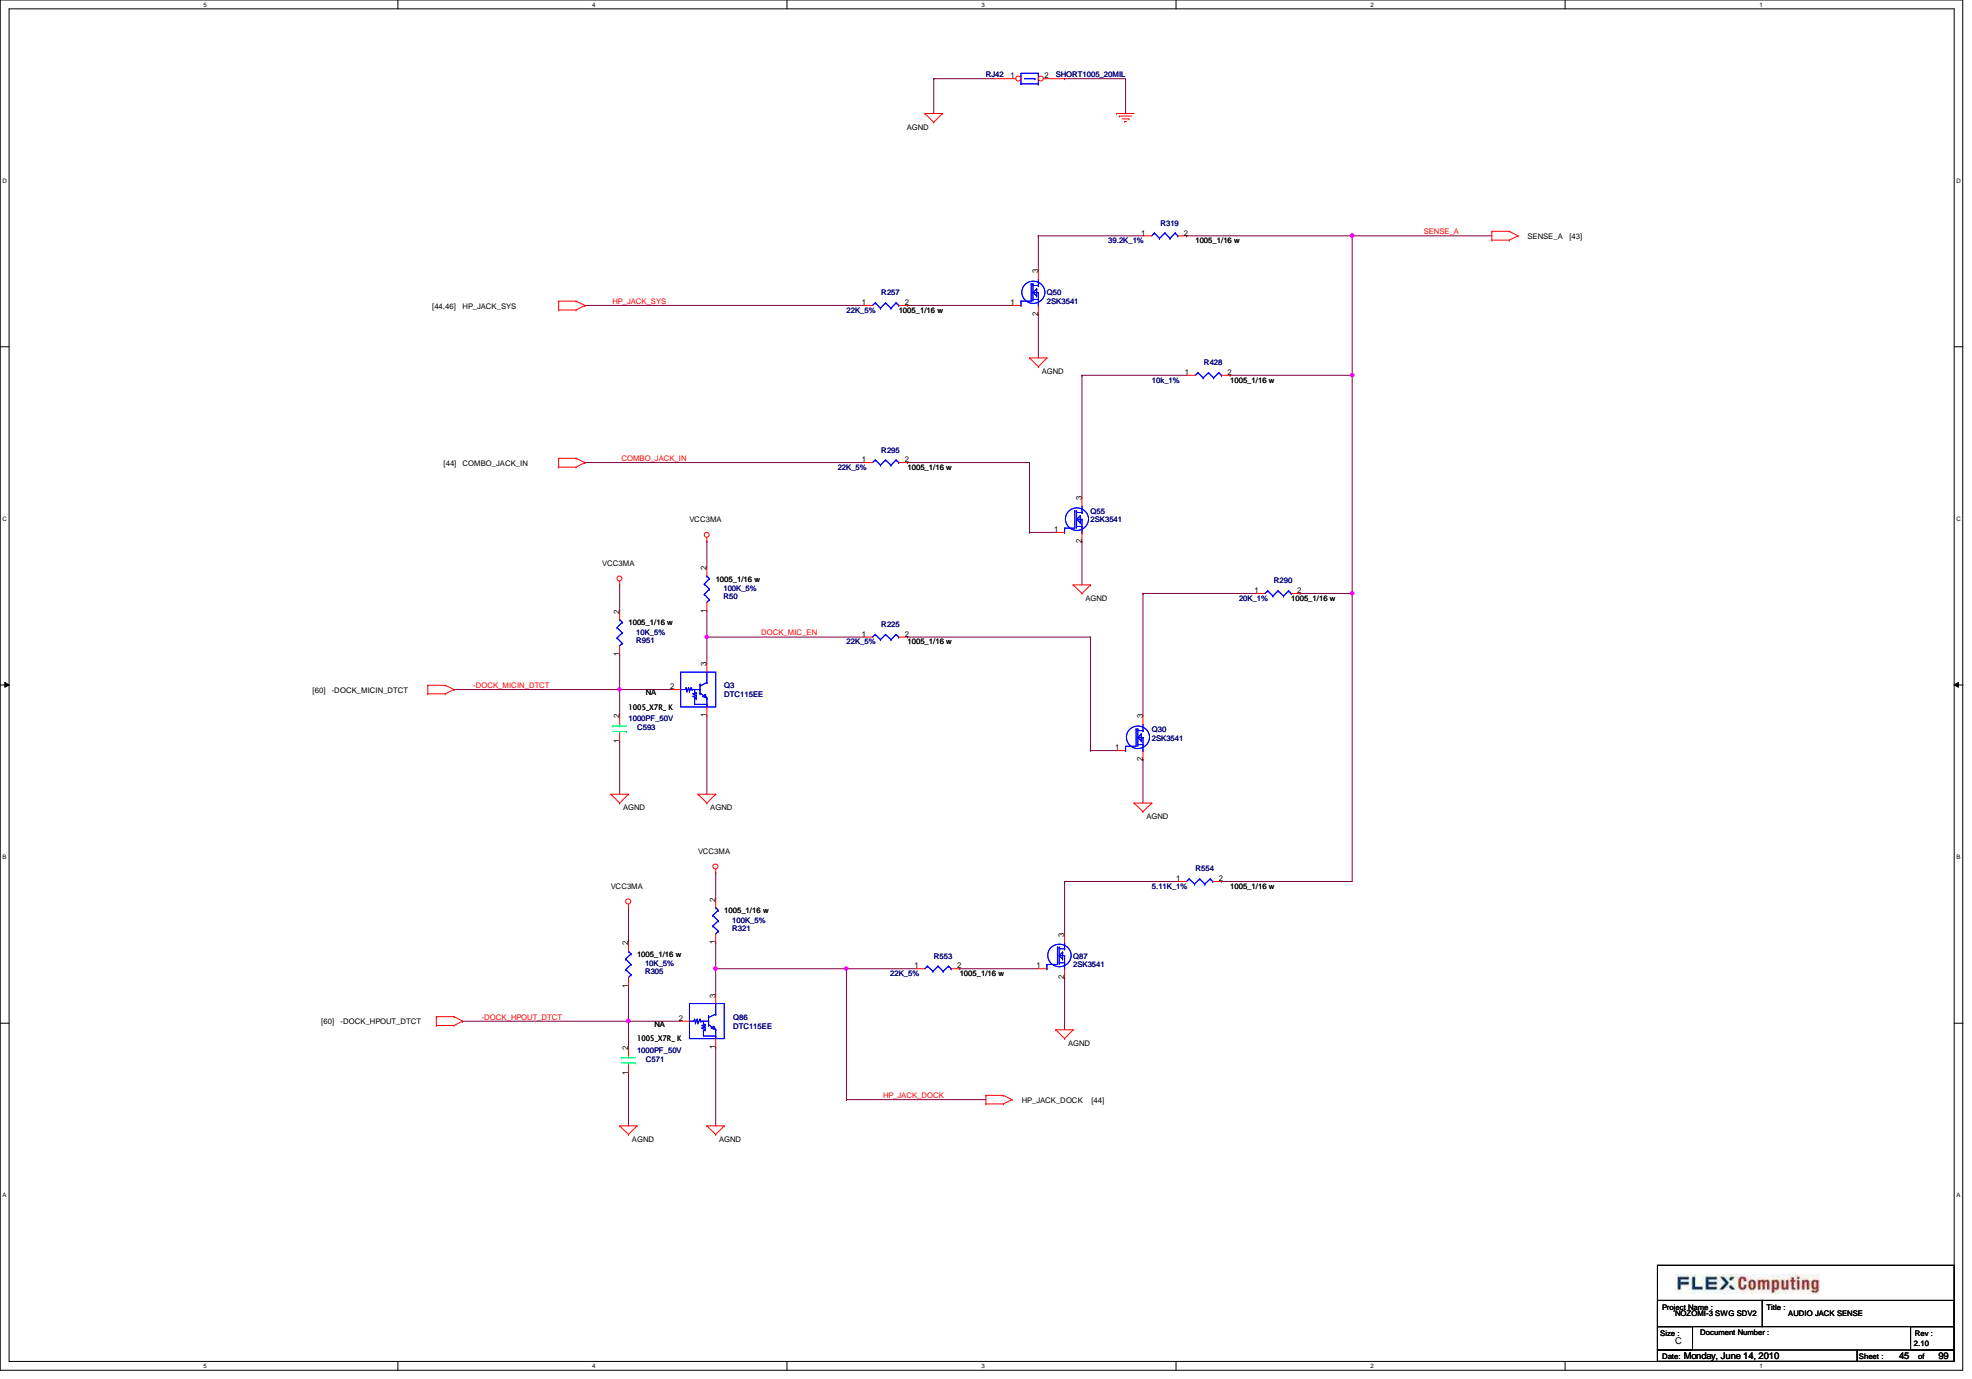
[picture p99: page 45]

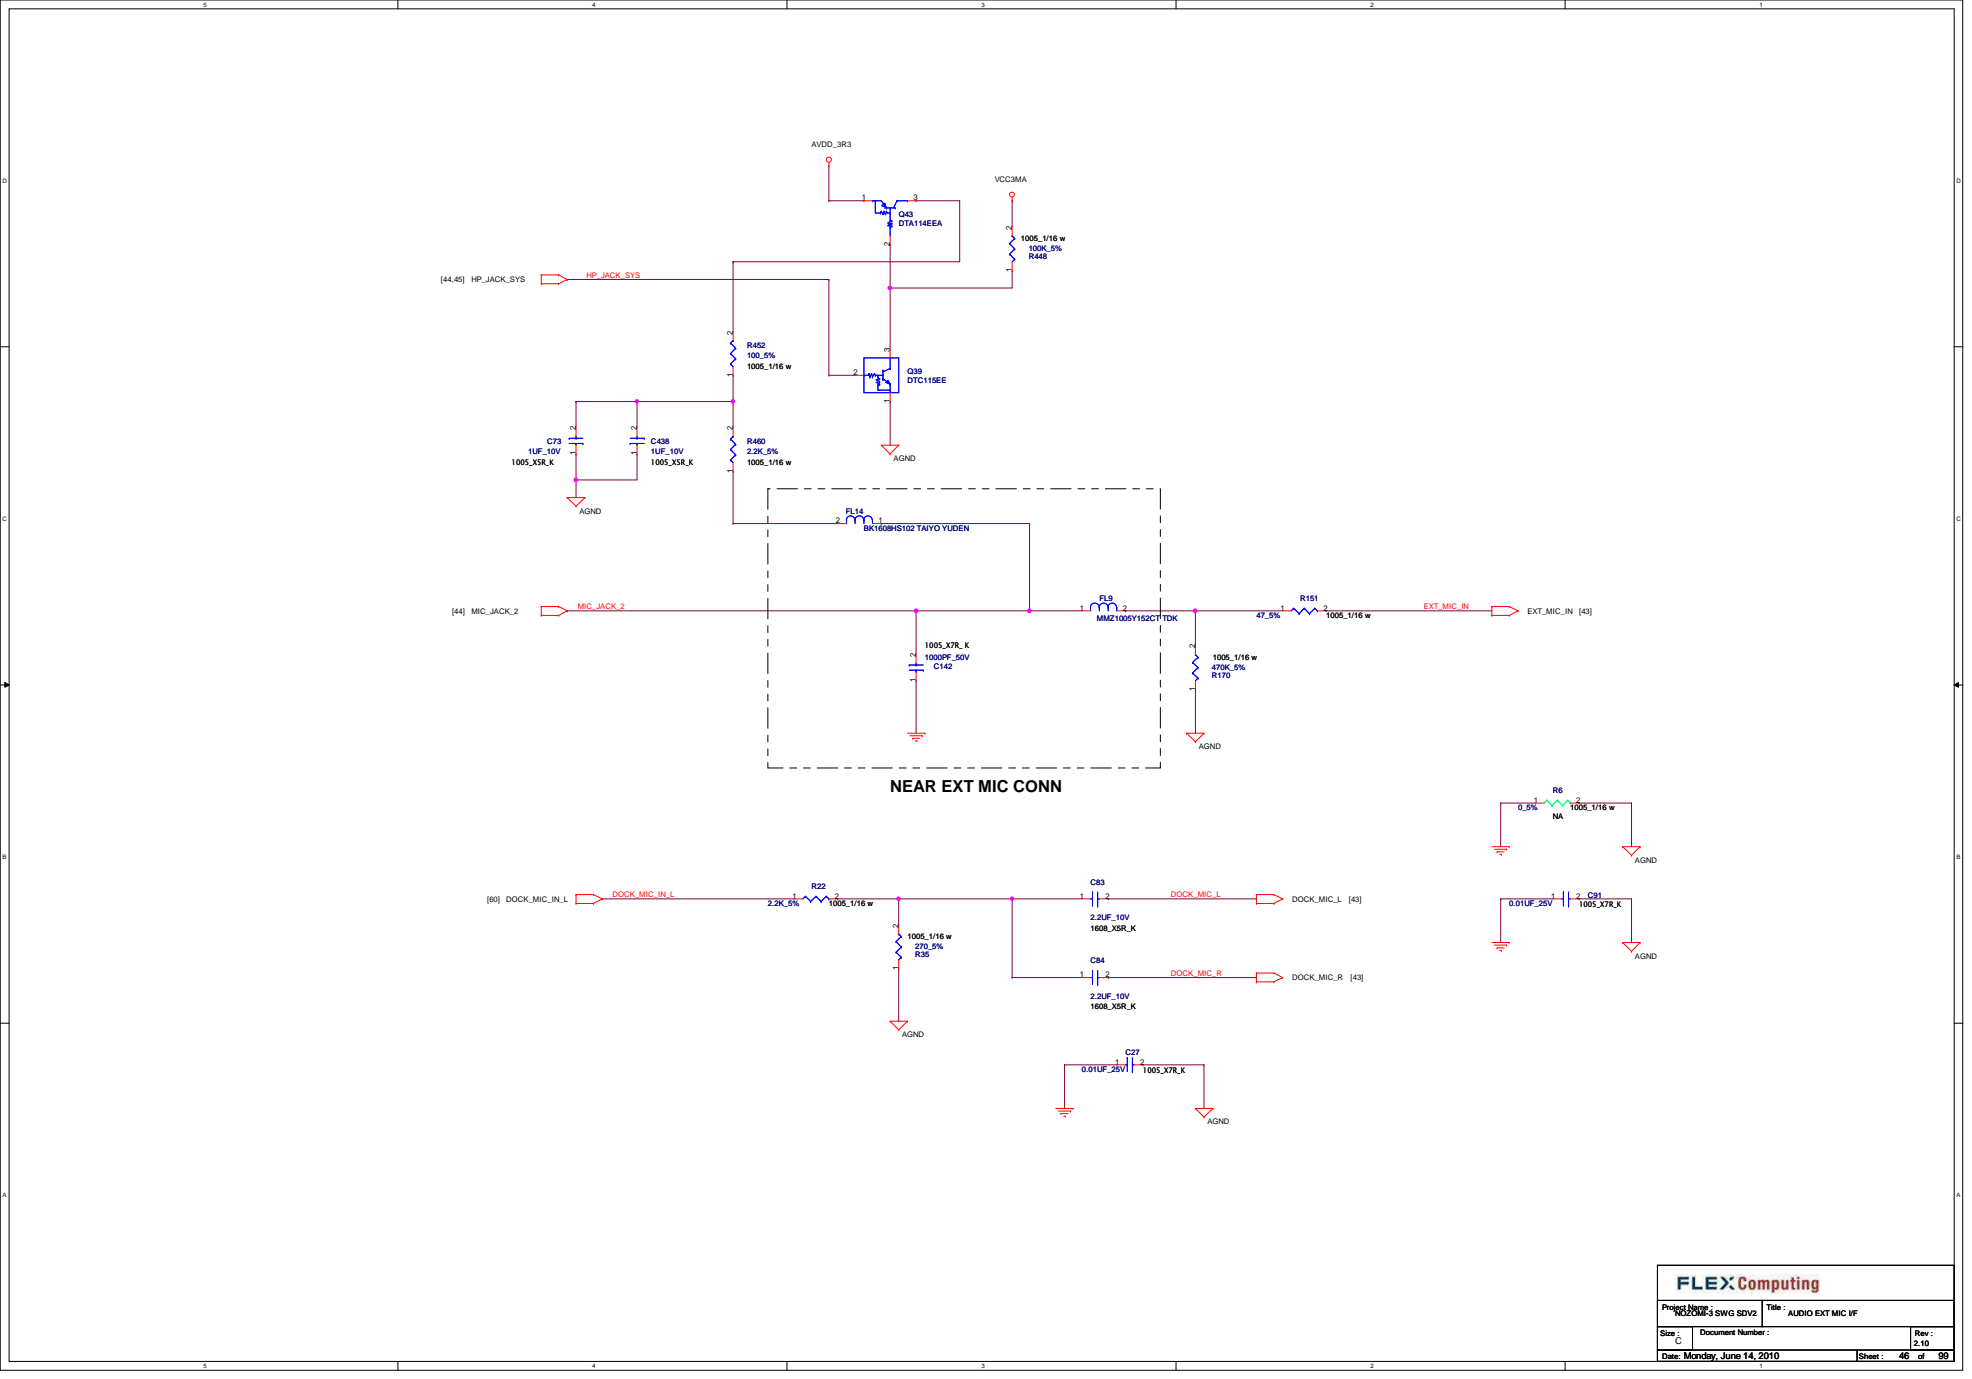
[picture p100: page 46]

NEAR EXT MIC CONN

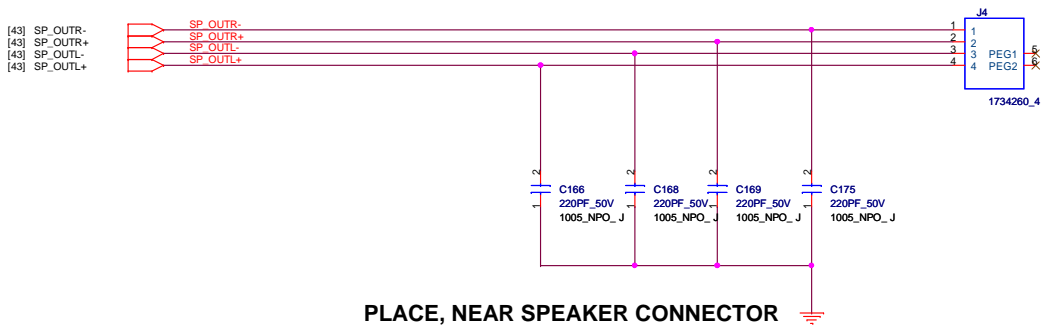
[picture p101: page 47]
SP_OUTL+; SP_OUTL-; SP_OUTR+; SP_OUTR- [43] SP_OUTR- [43] SP_OUTR+; [43] SP_OUTL+; [43] SP_OUTL-; Monday, June 14, 2010; NOZOMI-3 SWG SDV2; AUDIO SPEAKER; C175 220PF_50V 1005_NPO_ J; C168 220PF_50V 1005_NPO_ J; C166 220PF_50V 1005_NPO_ J; C169 220PF_50V 1005_NPO_ J; PEG1 5 PEG2 6

PLACE, NEAR SPEAKER CONNECTOR

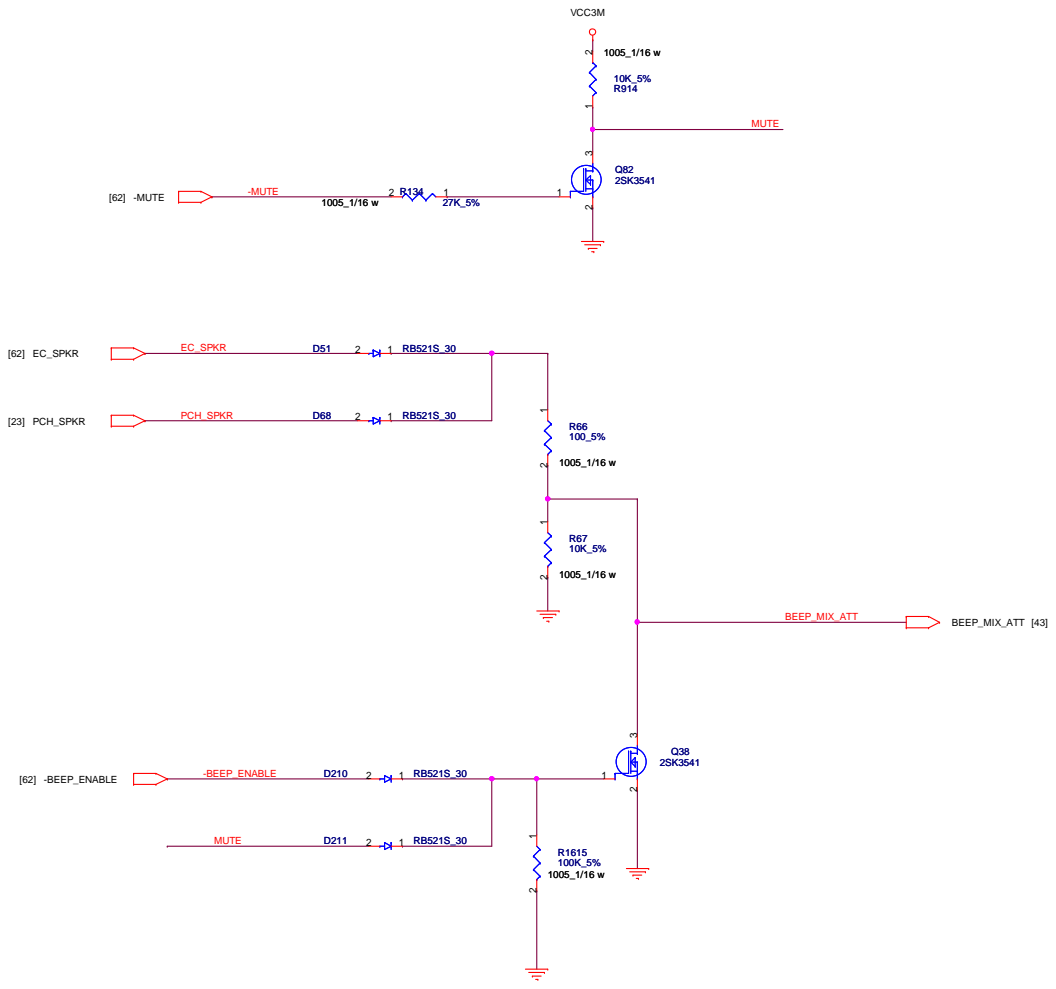
[picture p102: page 48]

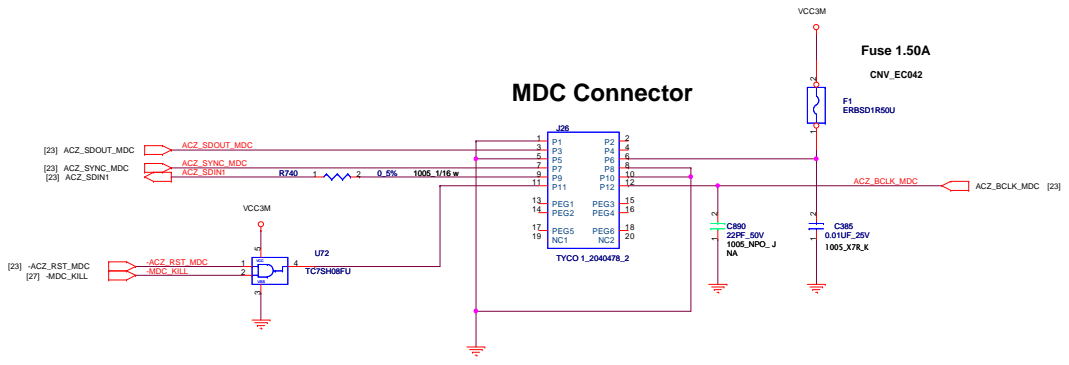
[picture p103: page 49]

## LOGIC

## TABLE

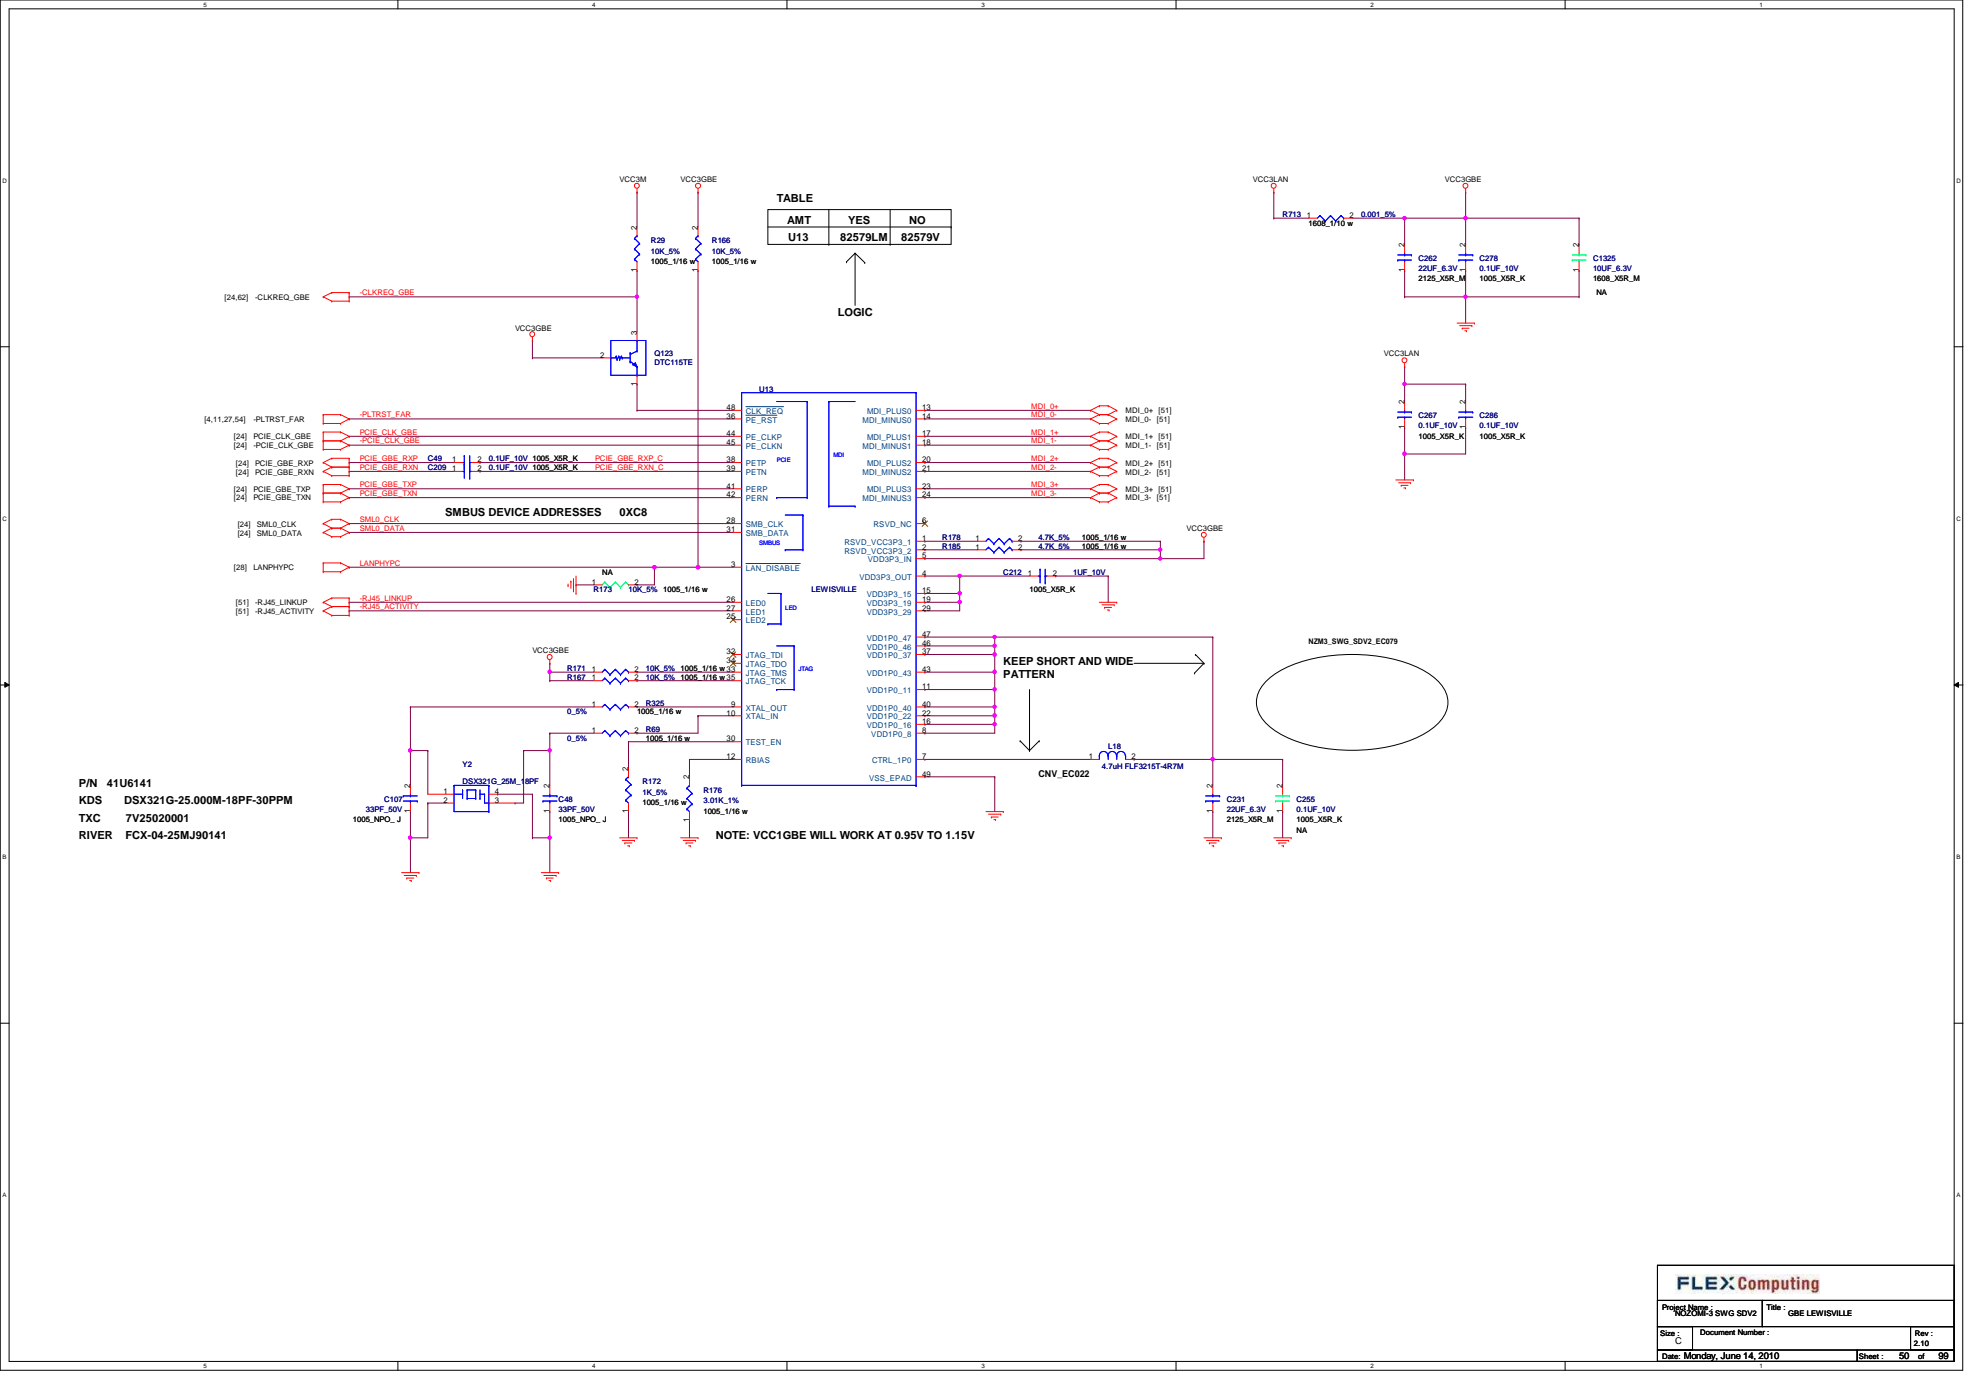
[picture p104: page 50]

KEEP SHORT AND WIDE
PATTERN

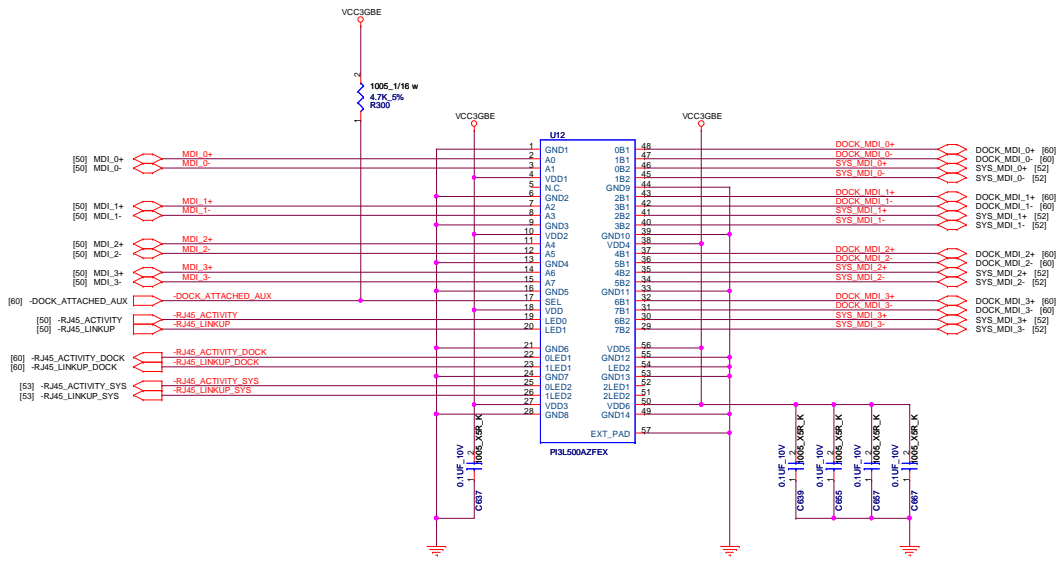
[picture p105: page 51]

### PULSE H0068A(NL) OR MIDCOM 000-7219-35R

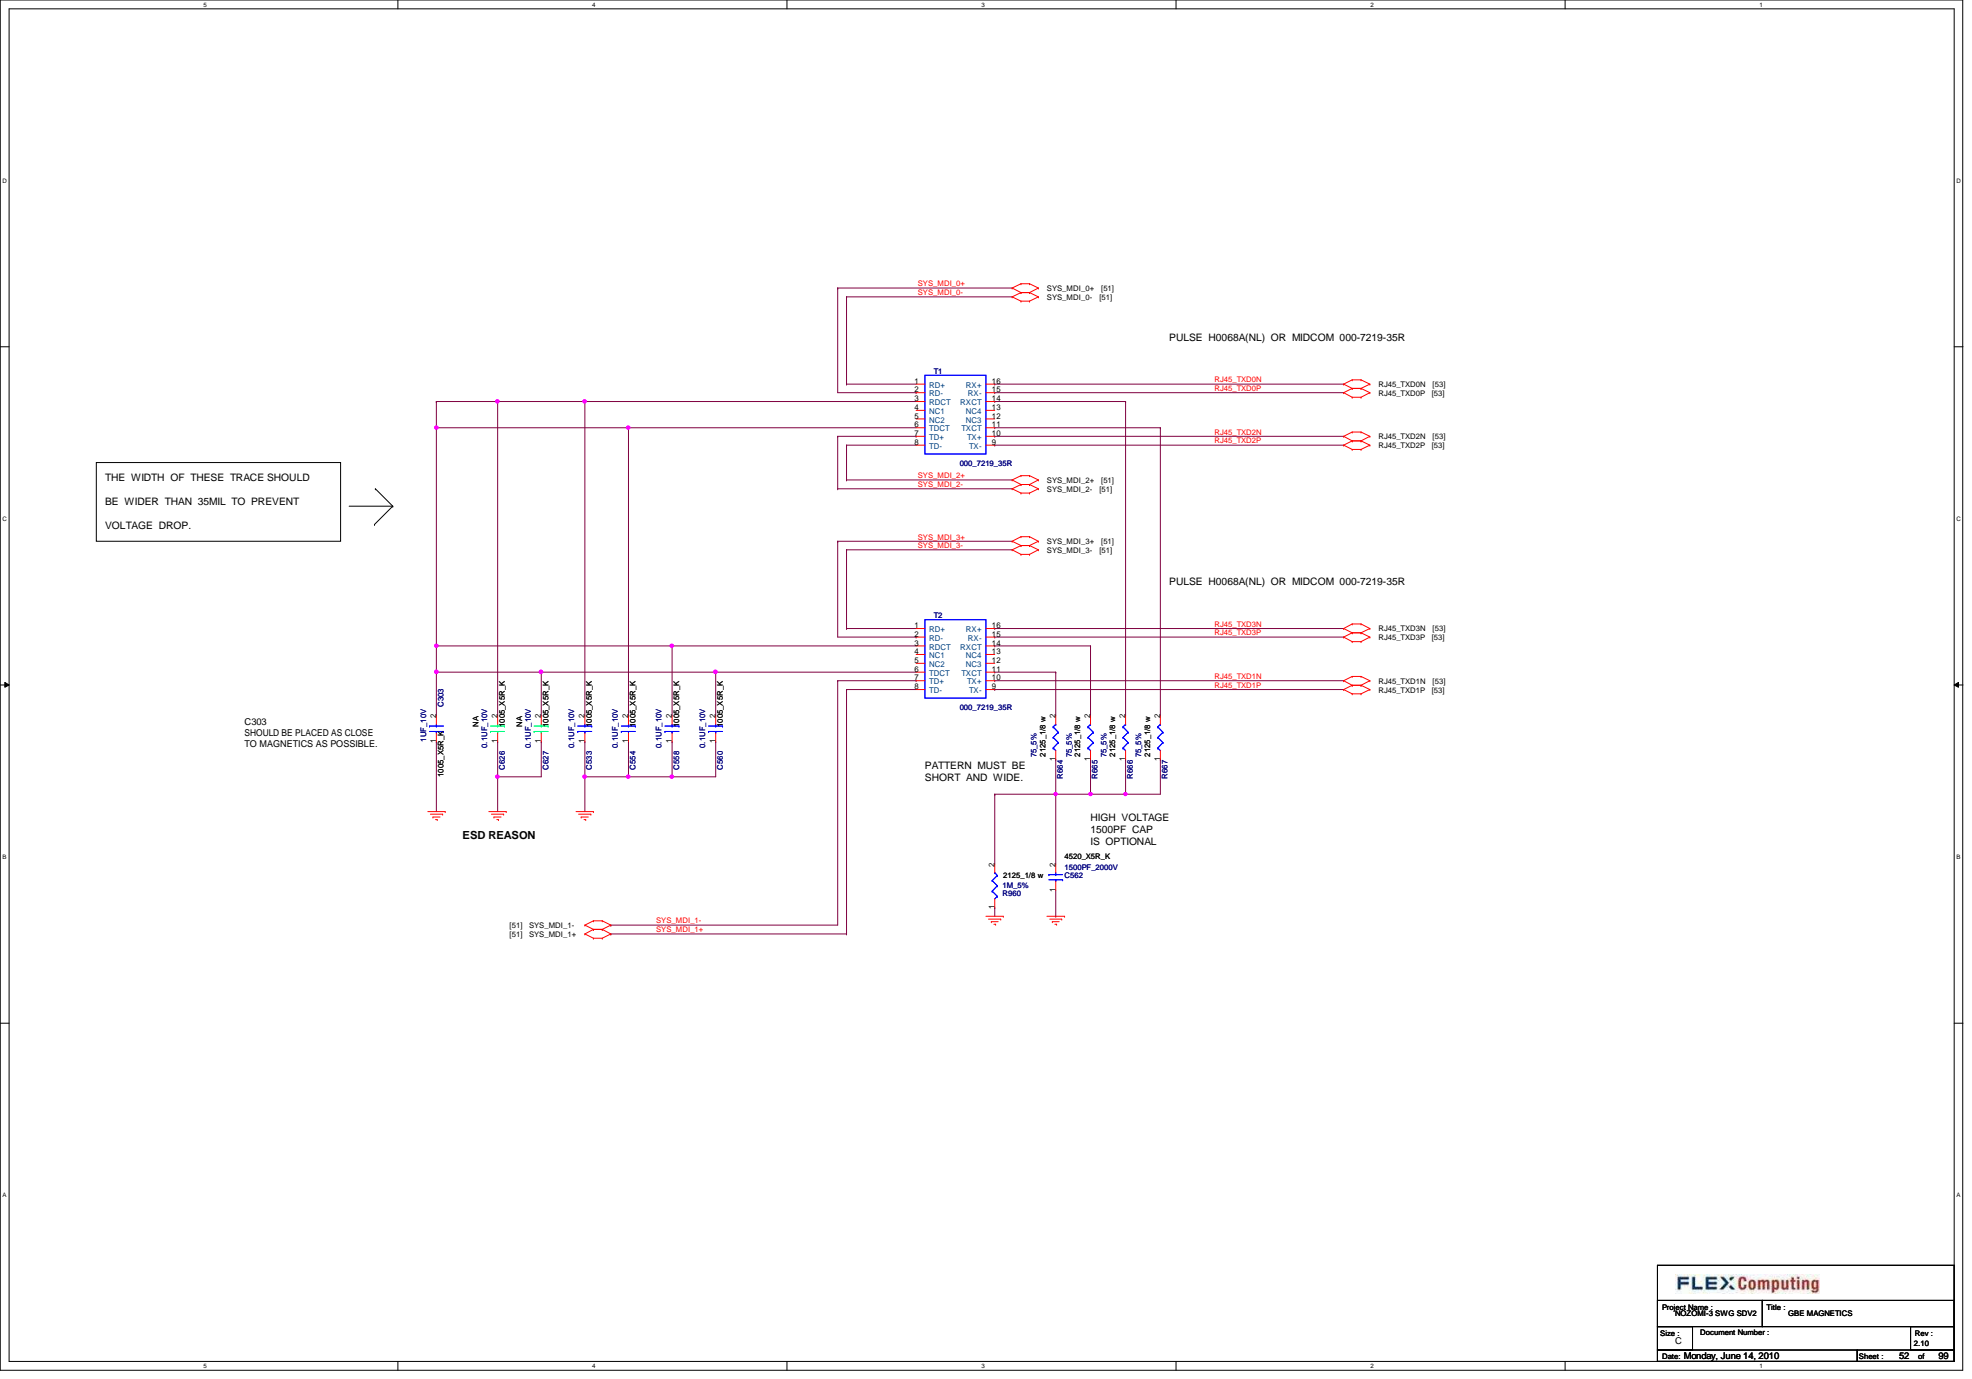
[picture p106: page 52]

TX- 9 TX+ 10 TXCT 11 NC3 12 NC4 13 RXCT 14 RX- 15 RX+ 16 TD- 8 TD+ 7 TDCT 6 NC2 5 NC1 4 RDCT 3 RD- 2 RD+ 1

THE WIDTH OF THESE TRACE SHOULD

BE WIDER THAN 35MIL TO PREVENT

PULSE H0068A(NL) OR MIDCOM 000-7219-35R

SHOULD BE PLACED AS CLOSE
TO MAGNETICS AS POSSIBLE.

IS OPTIONAL ESD REASON

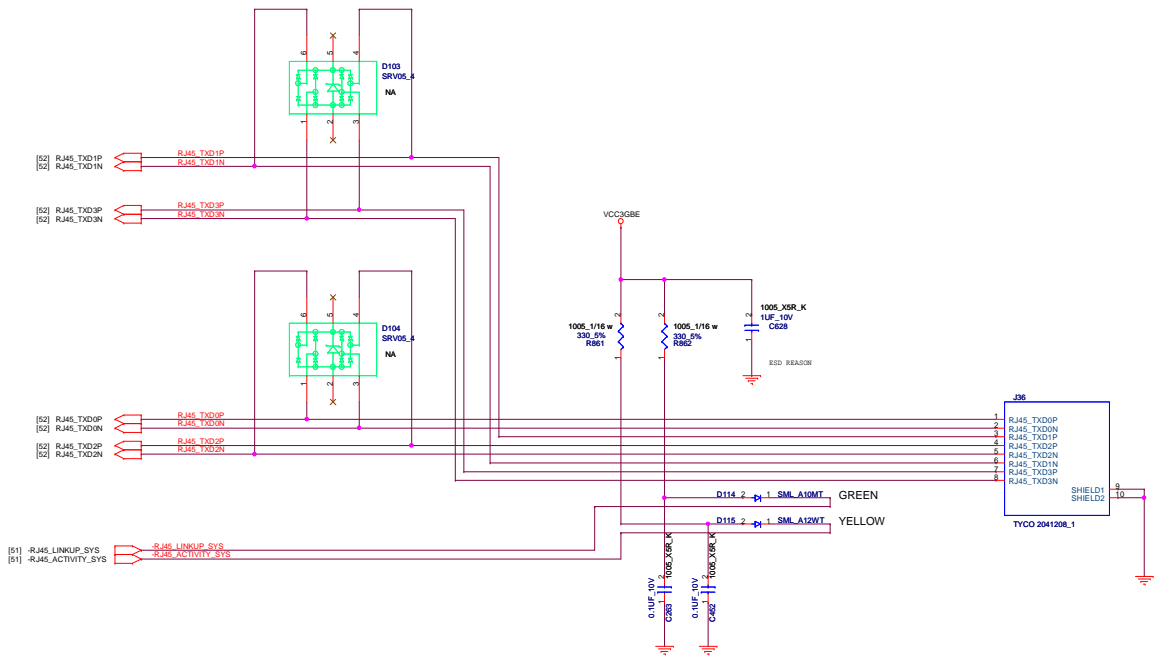
[picture p107: page 53]

### PLACE NEAR J25

# FULL MINI CARD FOR WWAN

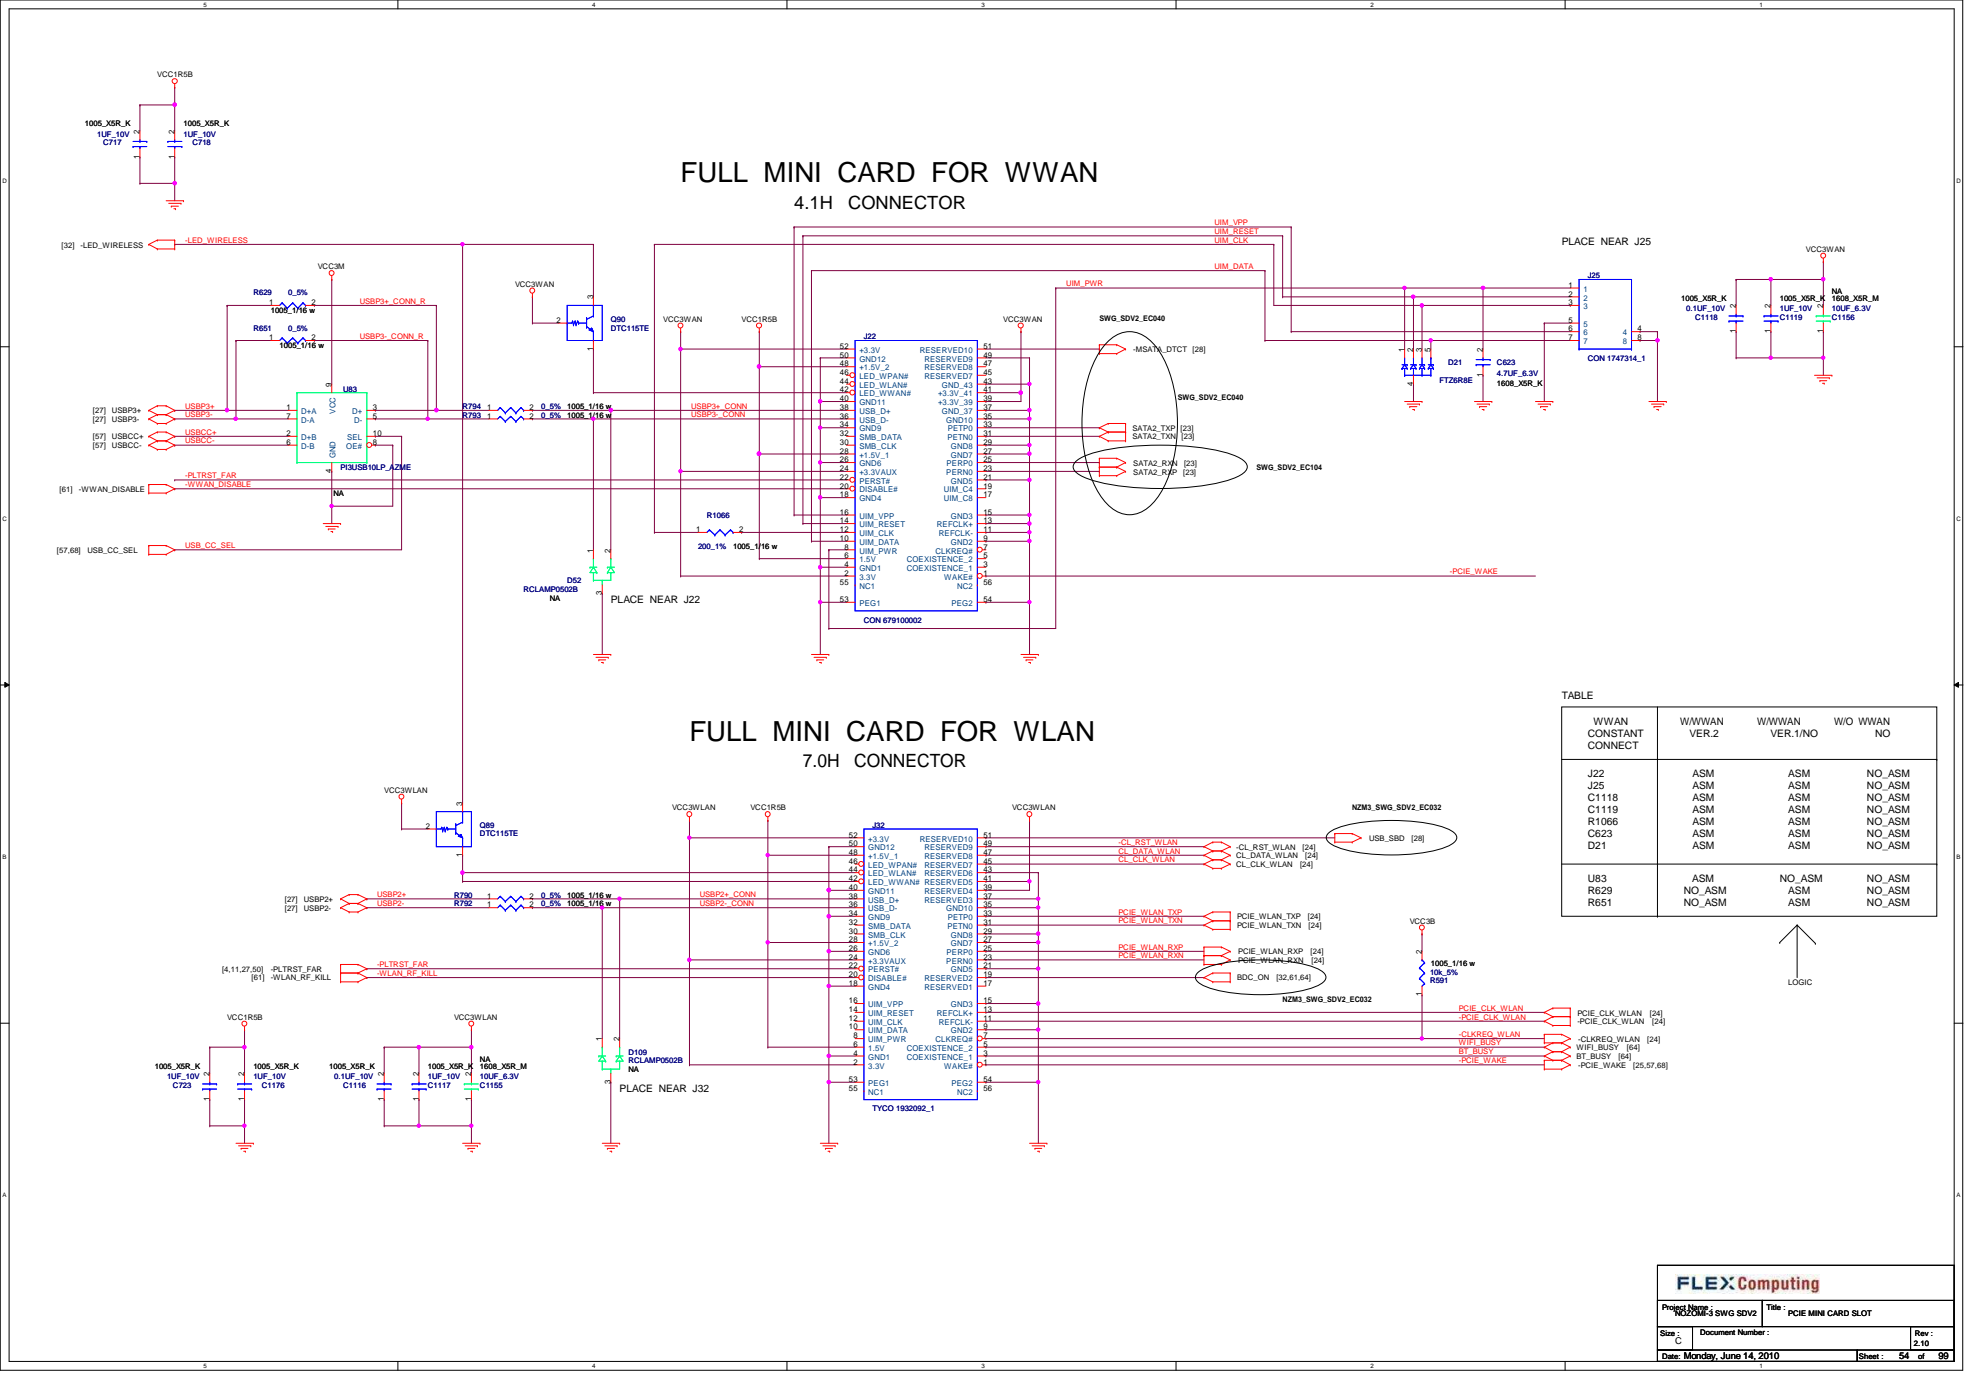
[picture p108: page 54]

FULL MINI CARD FOR WLAN

### TABLE

MEDIA I/F | SD/MMC

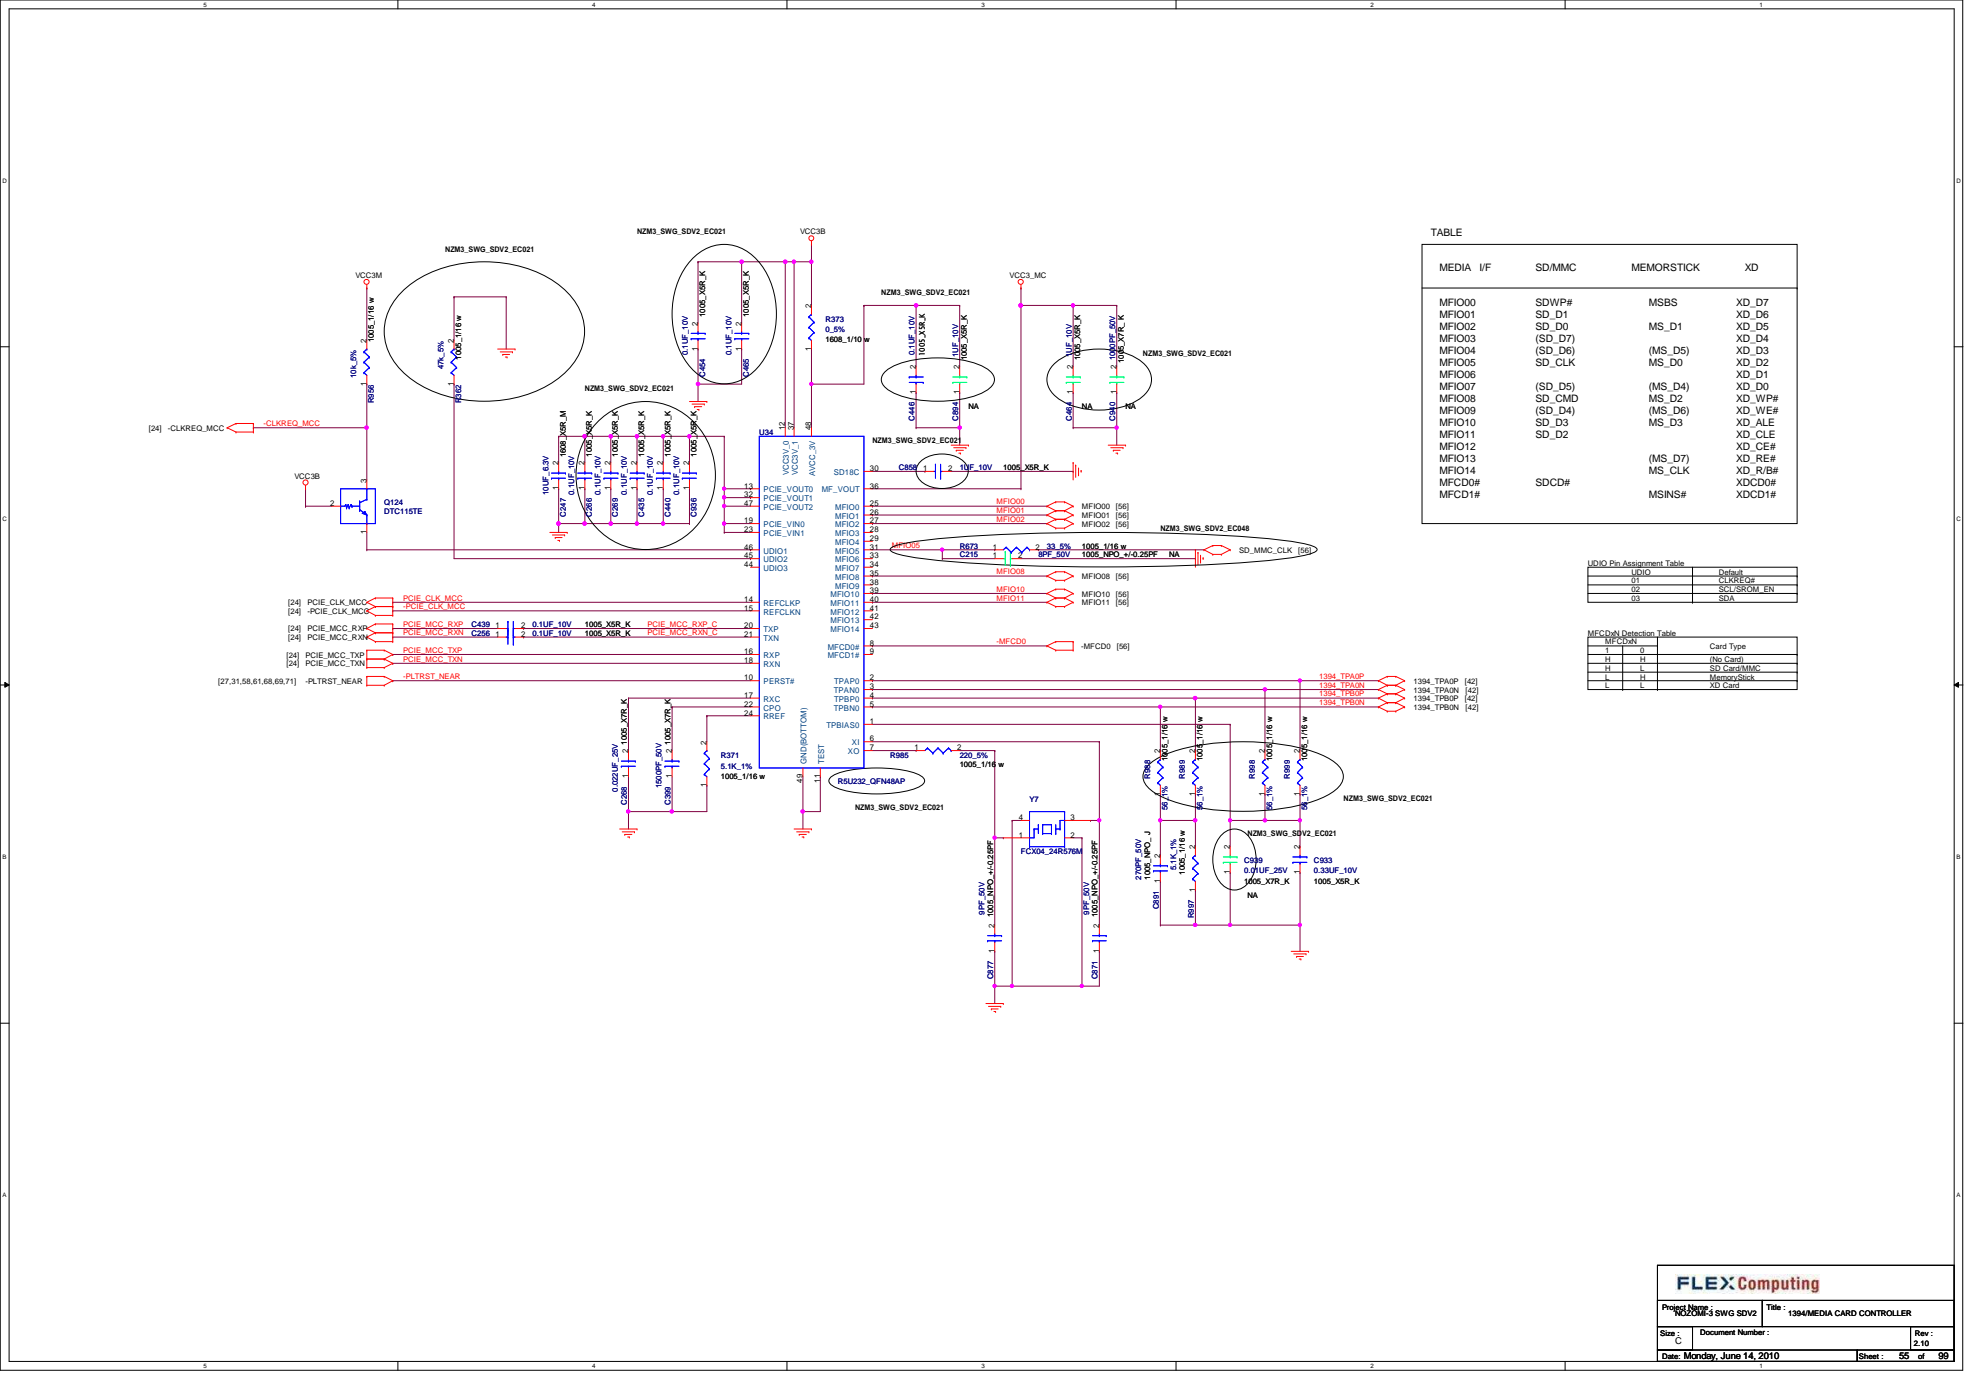
[picture p109: page 55]

UDIO Pin Assignment Table

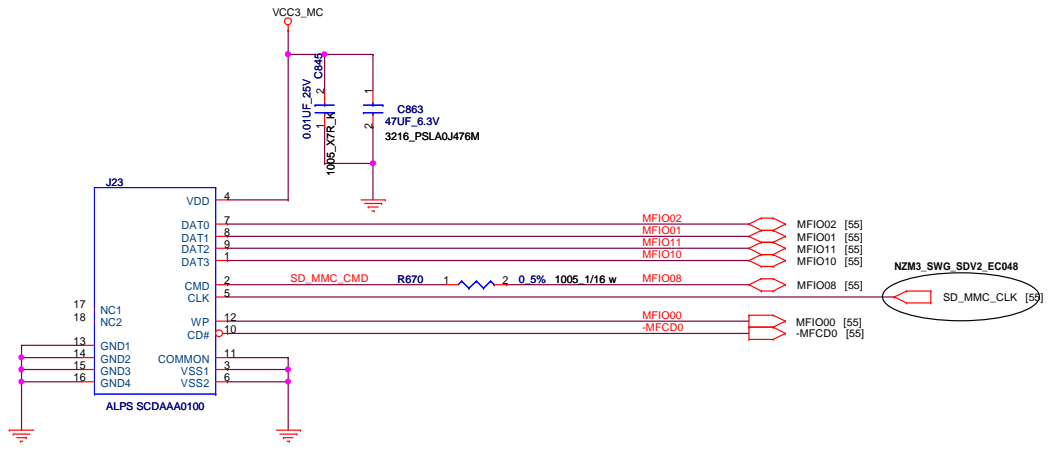
[picture p110: page 56]
MFIO02 MFIO01 MFIO11 MFIO10; SD_MMC_CMD; MFIO08; MFIO00 -MFCD0; MFIO02 [55] MFIO01 [55] MFIO11 [55] MFIO10 [55]; MFIO08 [55]; MFIO00 [55] -MFCD0 [55]; SD_MMC_CLK [55]; VCC3_MC; Monday, June 14, 2010; NOZOMI-3 SWG SDV2; MEDIA CARD INTERFACE; NZM3_SWG_SDV2_EC048; C863 47UF_6.3V 3216_PSLA0J476M; ALPS SCDAAA0100; GND1 13 GND2 14 GND3 15 GND4 16; DAT3; CMD; VSS1; VDD; CLK; VSS2; DAT0; DAT1; DAT2; COMMON

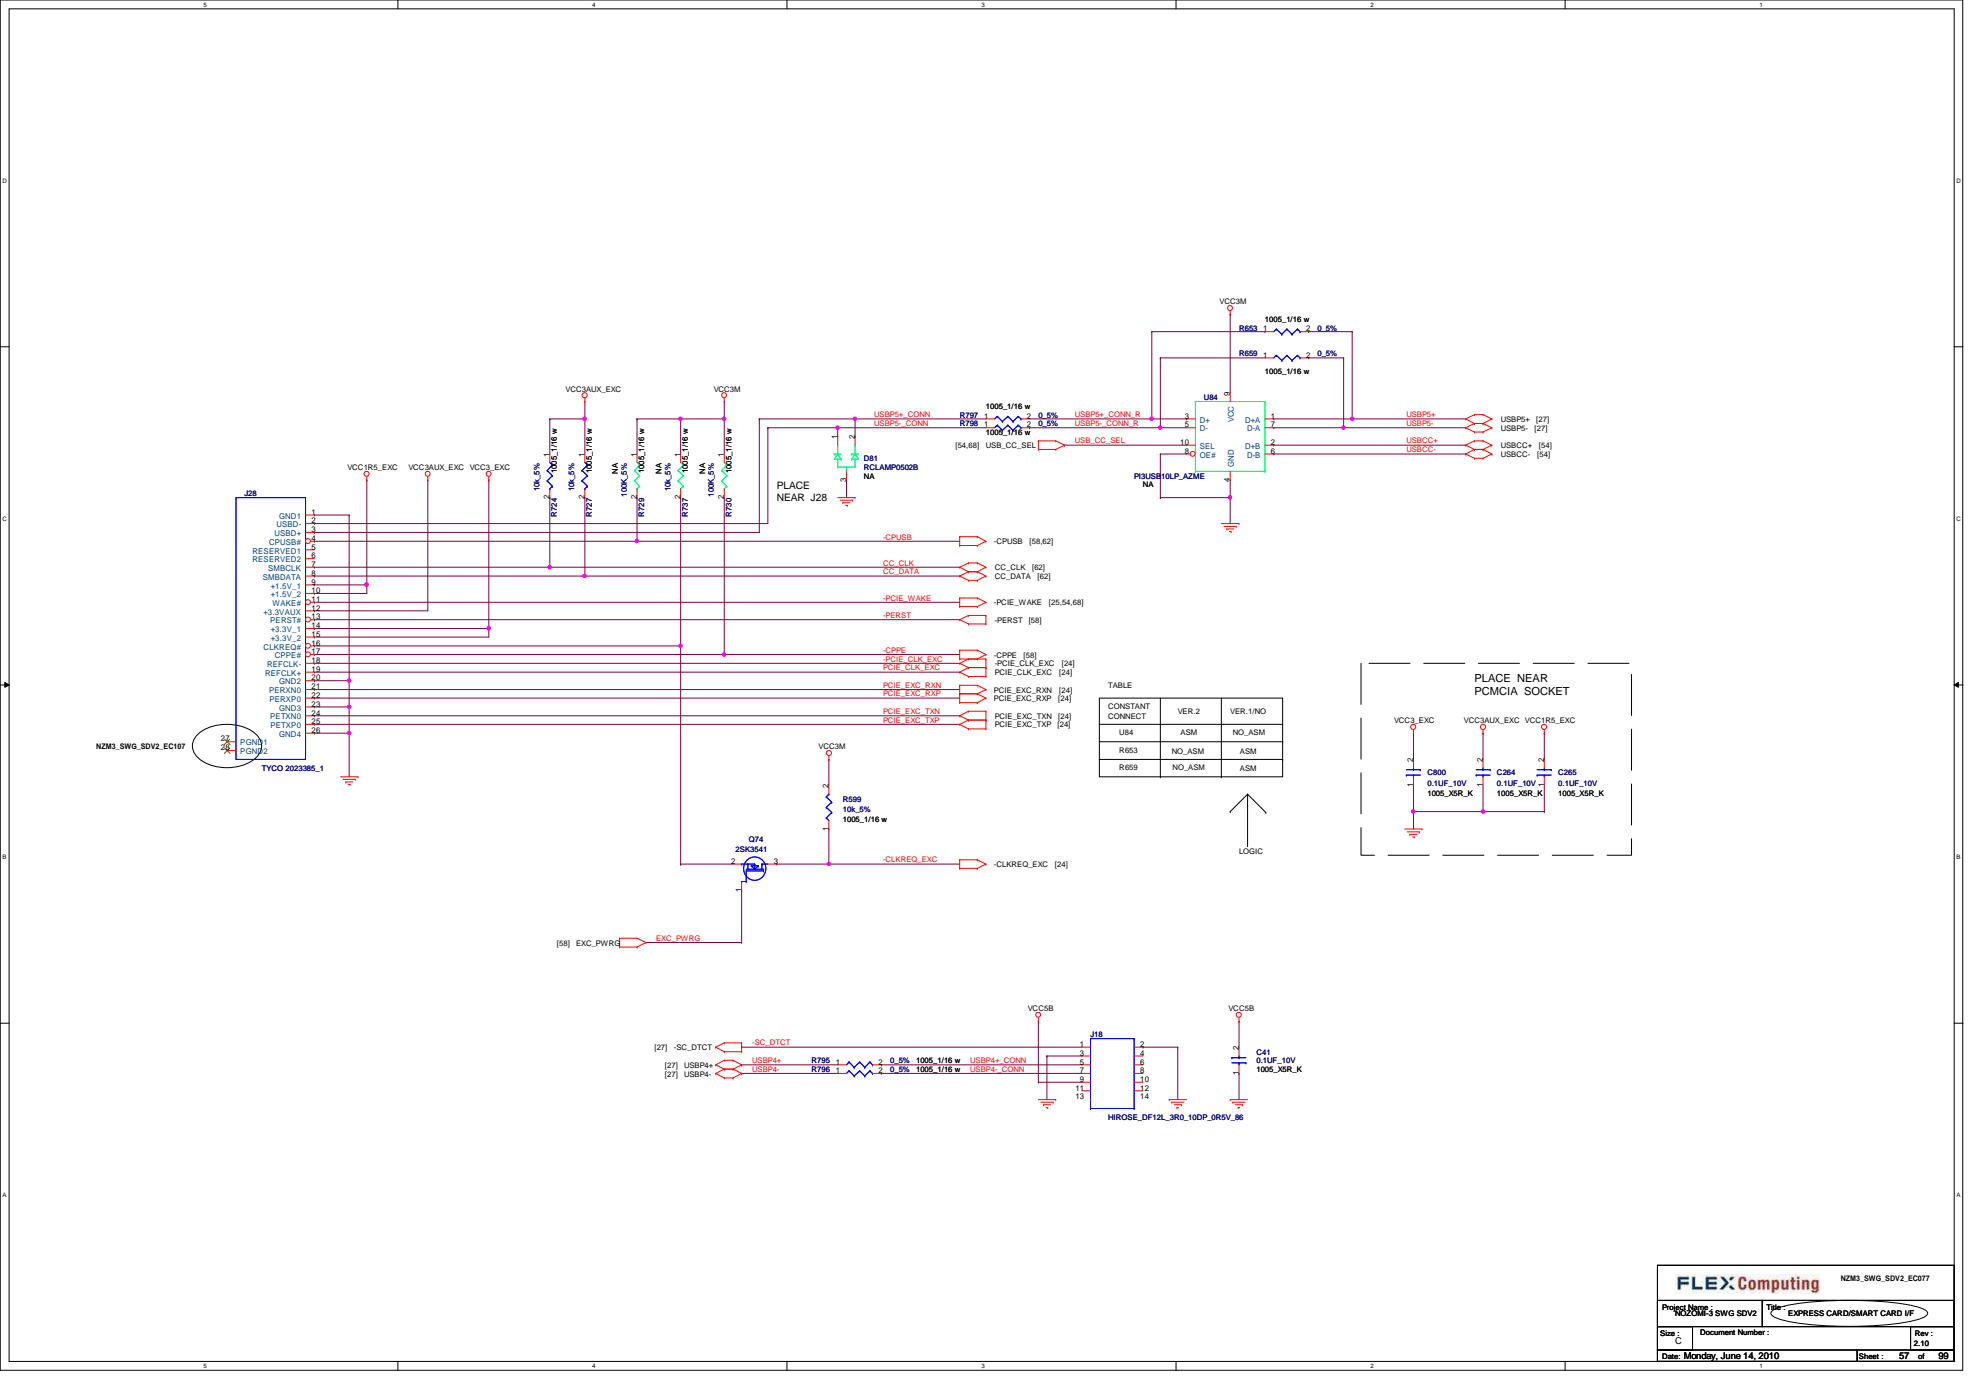
[picture p111: page 57]

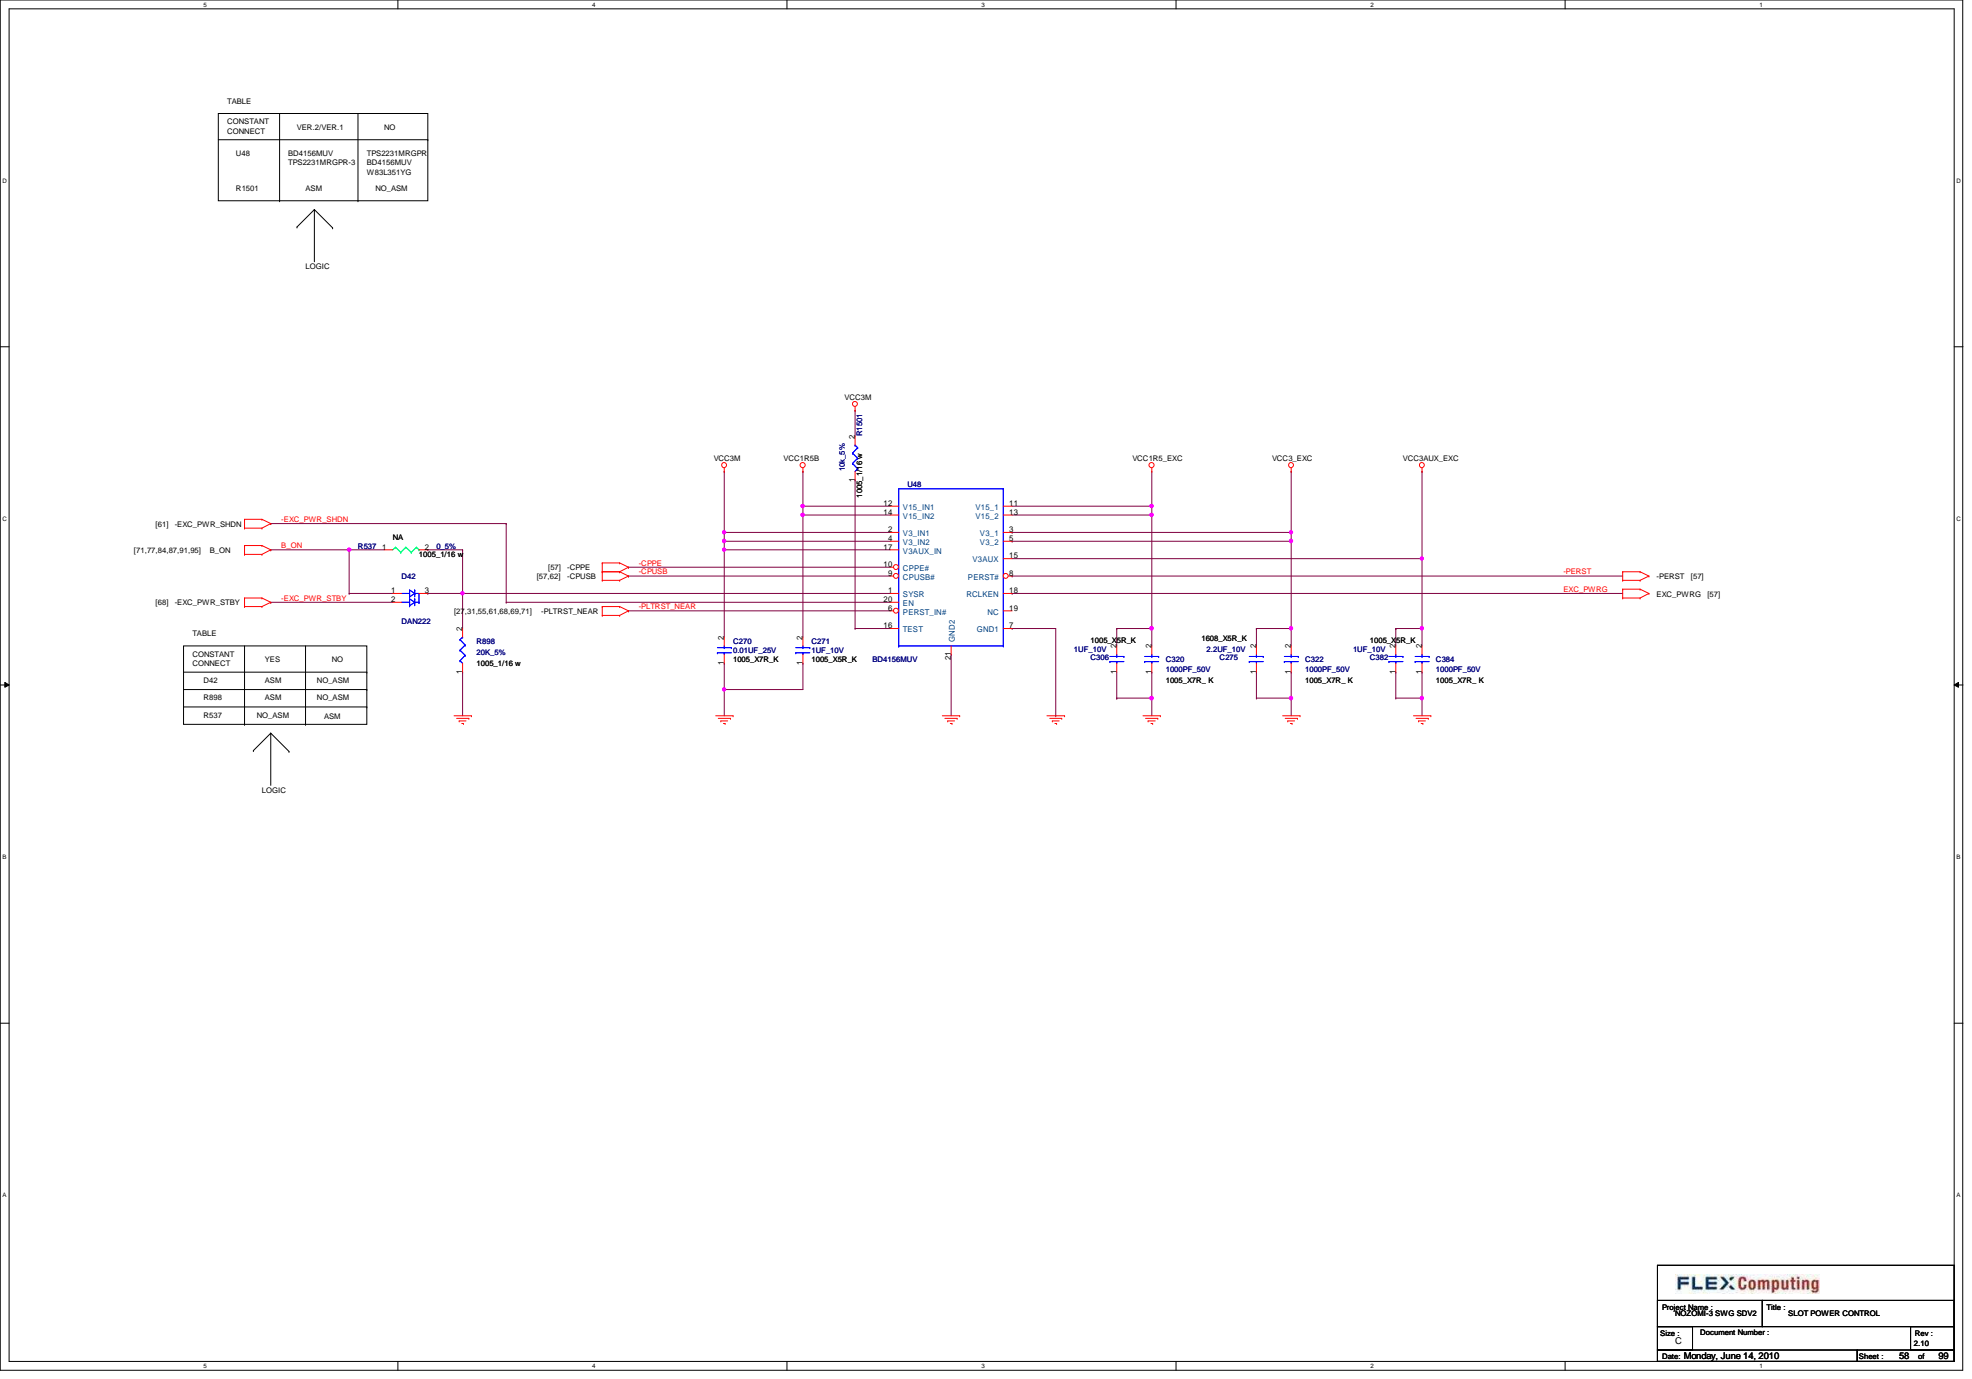
[picture p112: page 58]

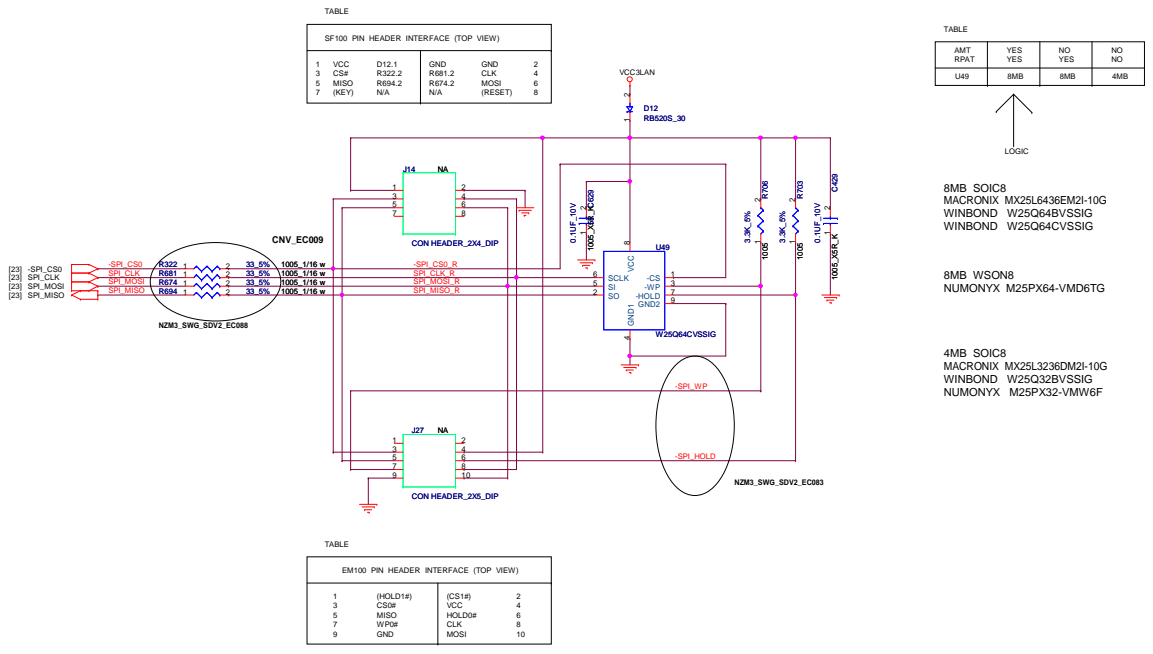
[picture p113: page 59]

SF100 PIN HEADER INTERFACE (TOP VIEW)

EM100 PIN HEADER INTERFACE (TOP VIEW)

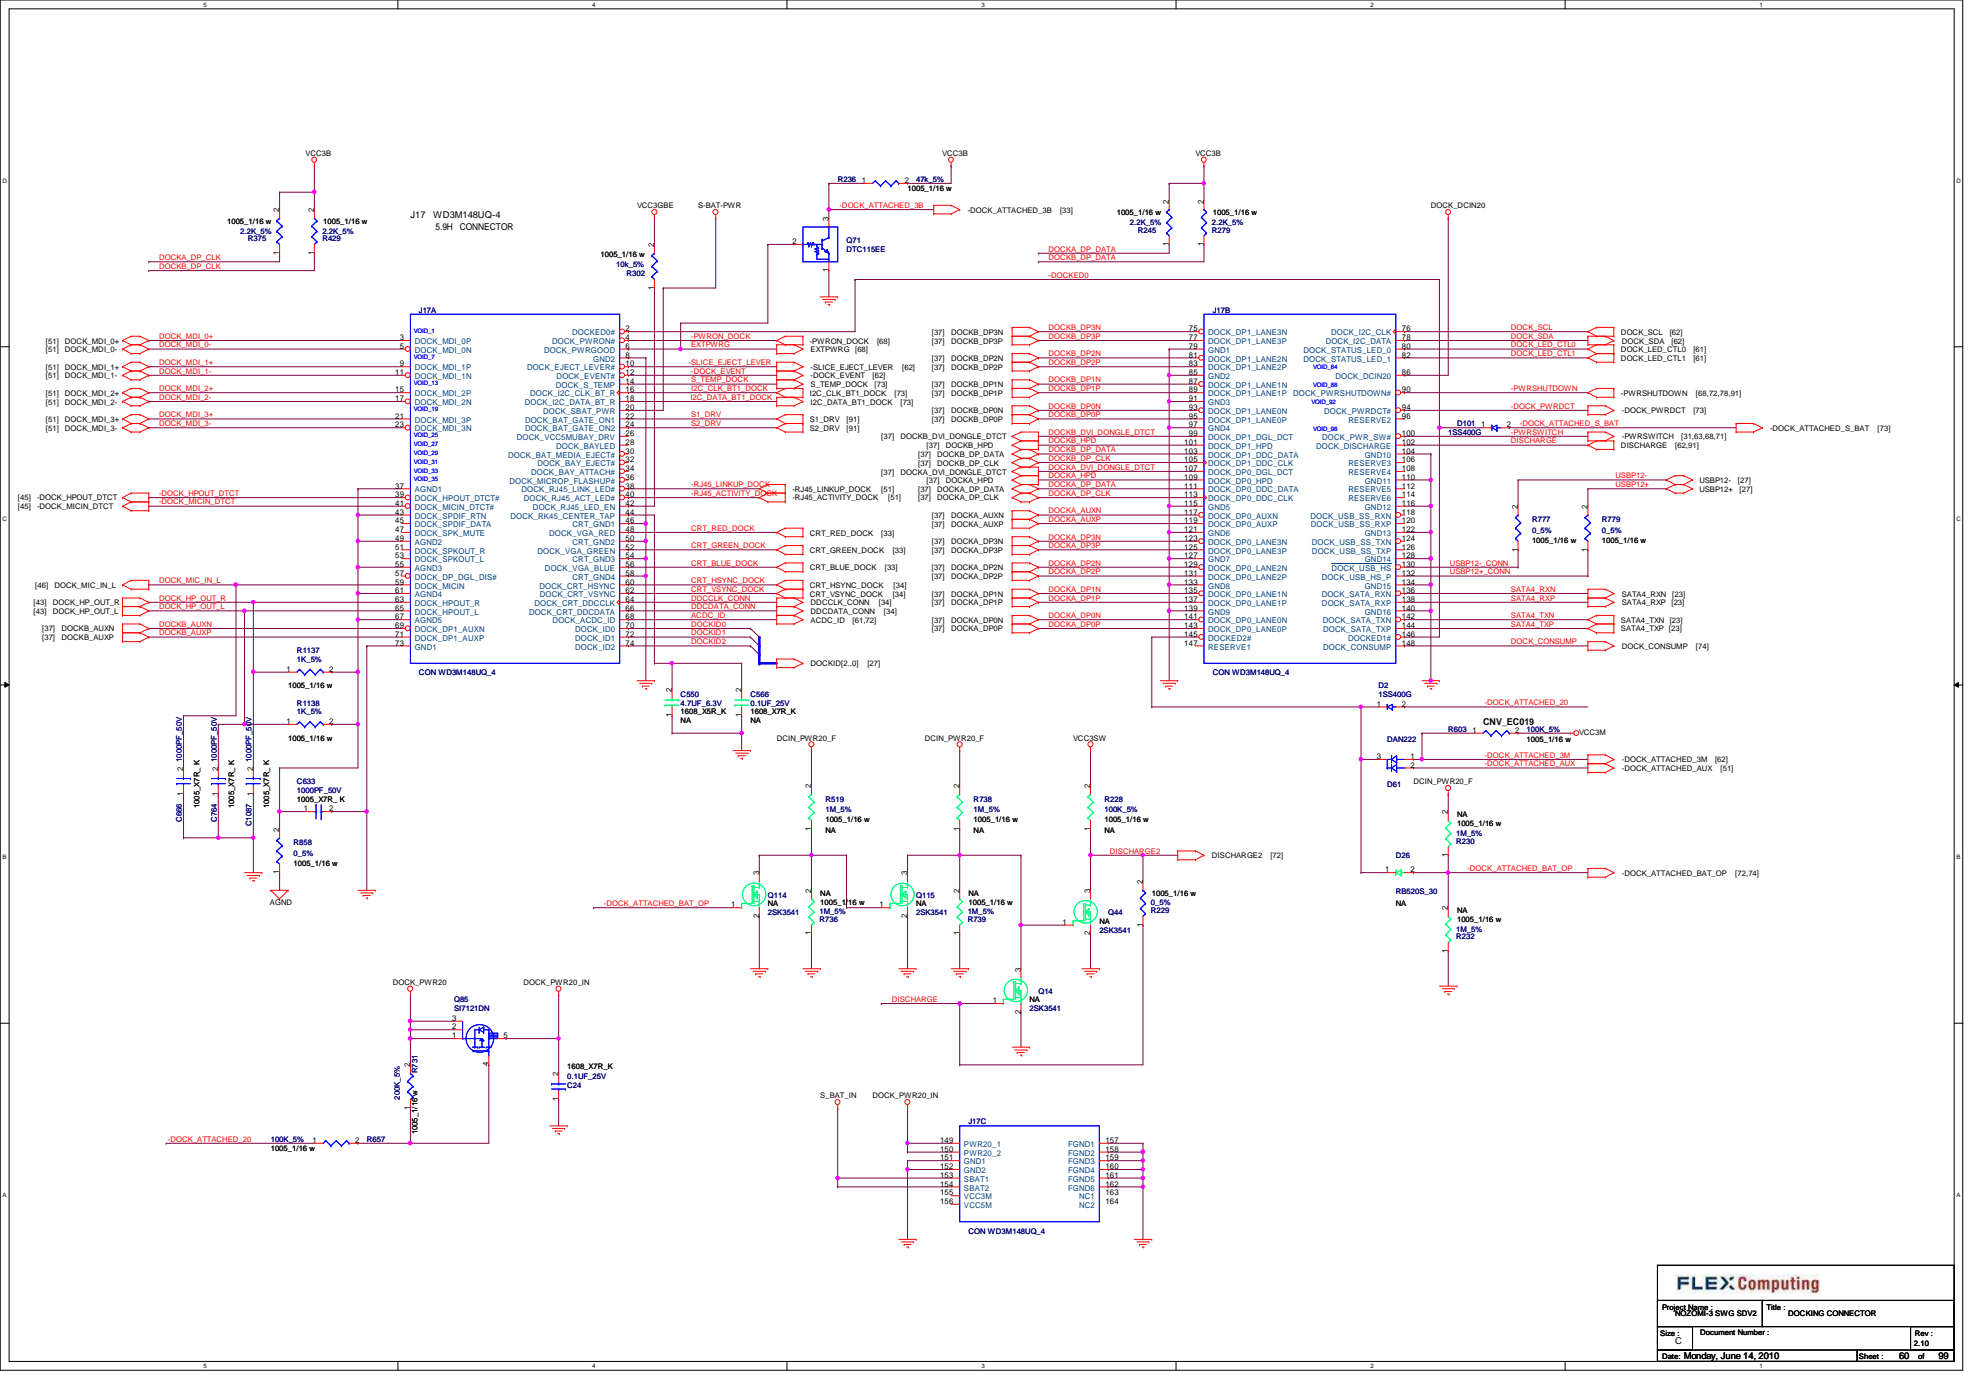
[picture p114: page 60]

## P/N 41A1205 MURATA CSTCE10M0G55-R0

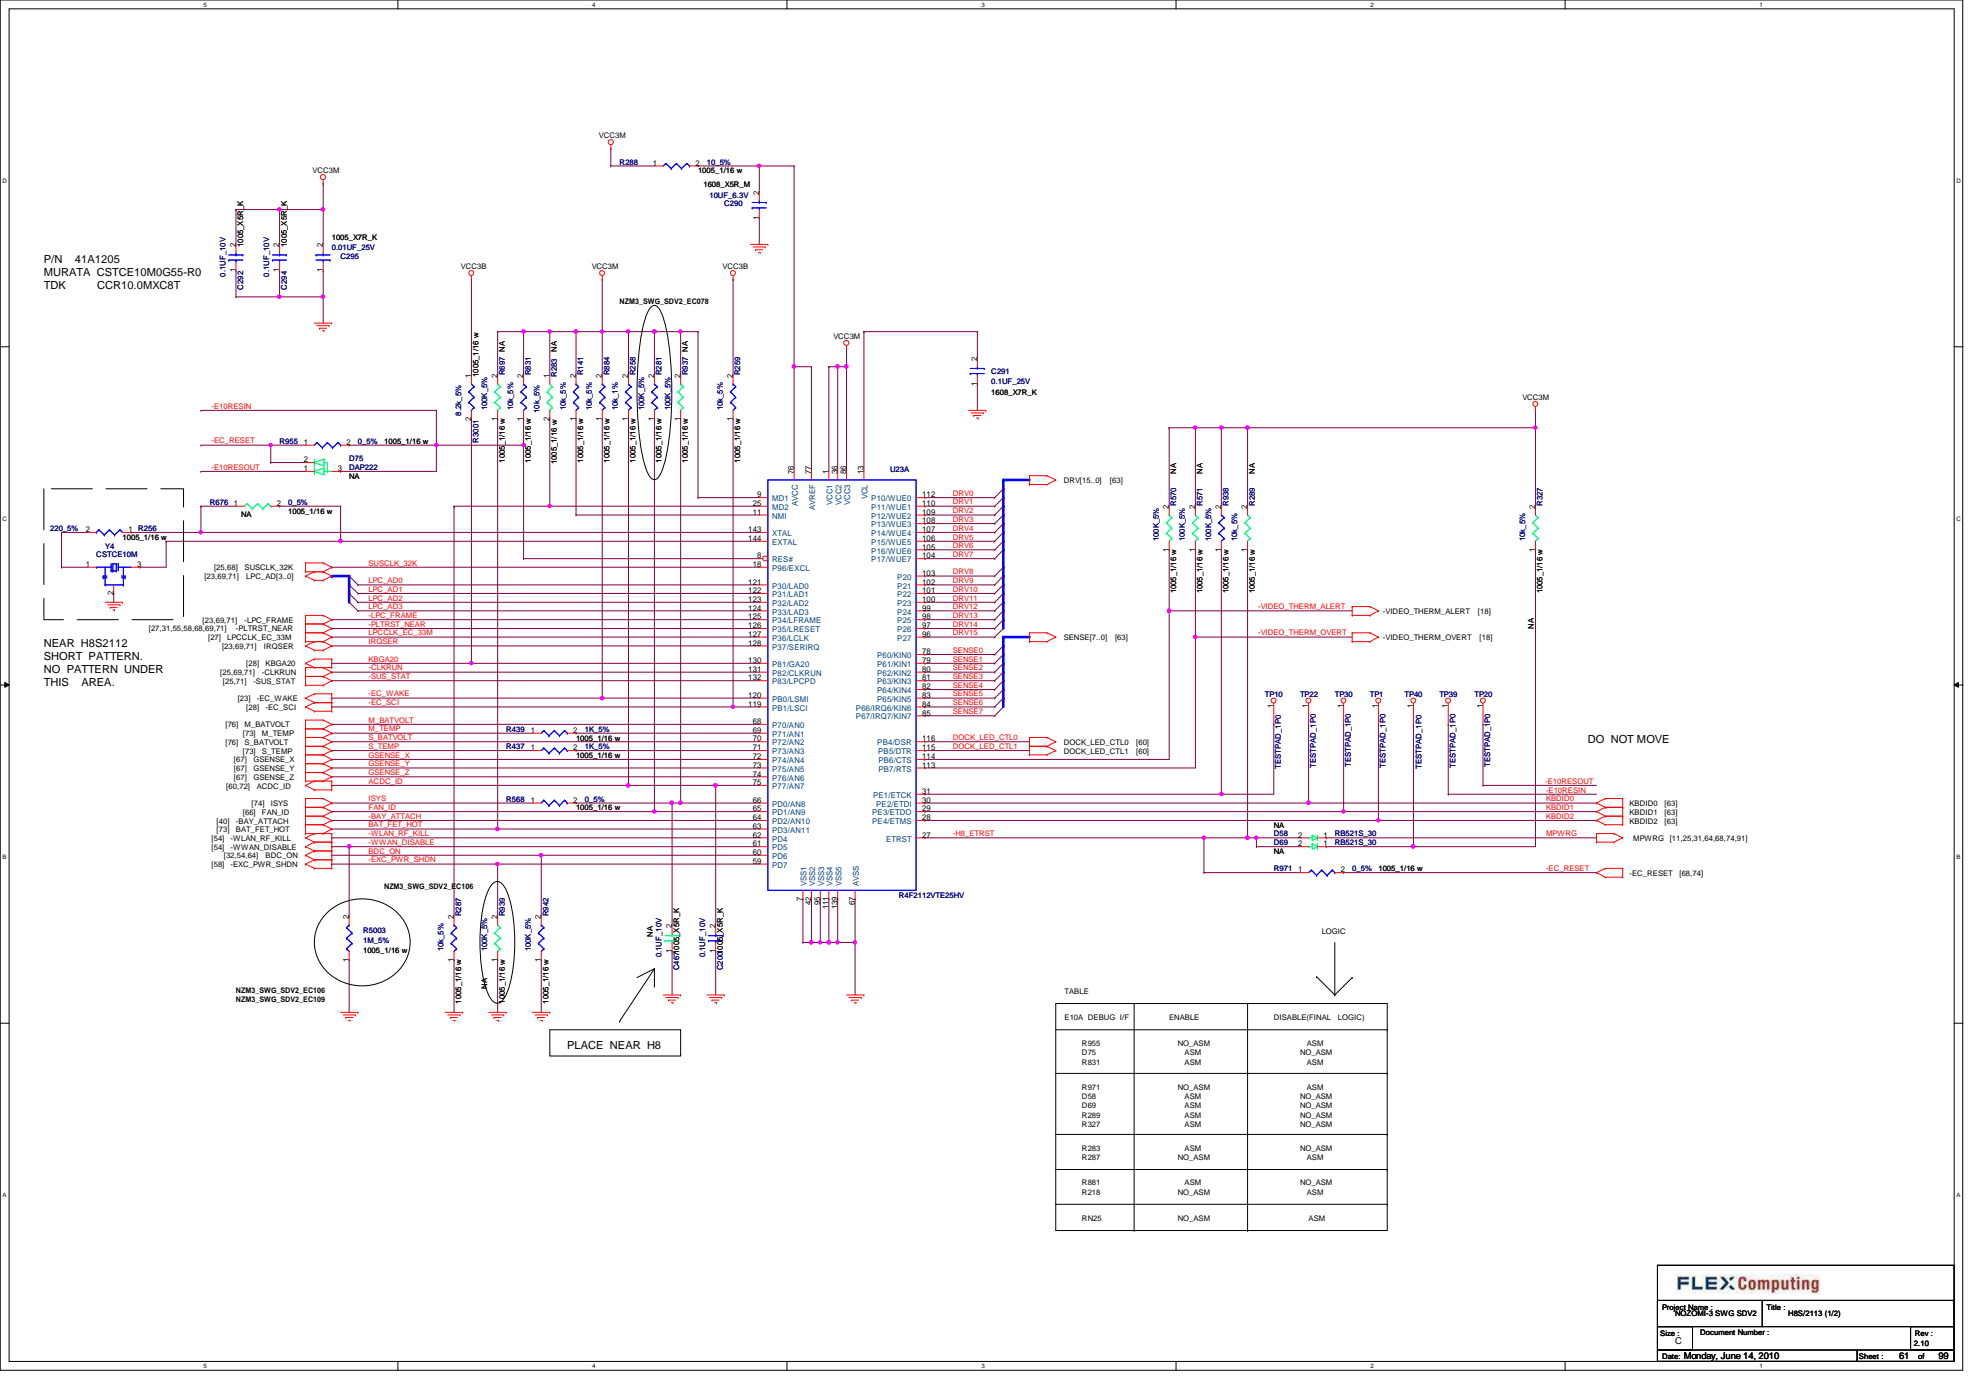
[picture p115: page 61]

P37/SERIRQ 128 P36/LCLK 127 P35/LRESET 126 P34/LFRAME 125 P33/LAD3 124 P32/LAD2 123 P31/LAD1 122 P30/LAD0 121

PE4/ETMS 28 PE3/ETDO 29 PE2/ETDI 30 PE1/ETCK 31

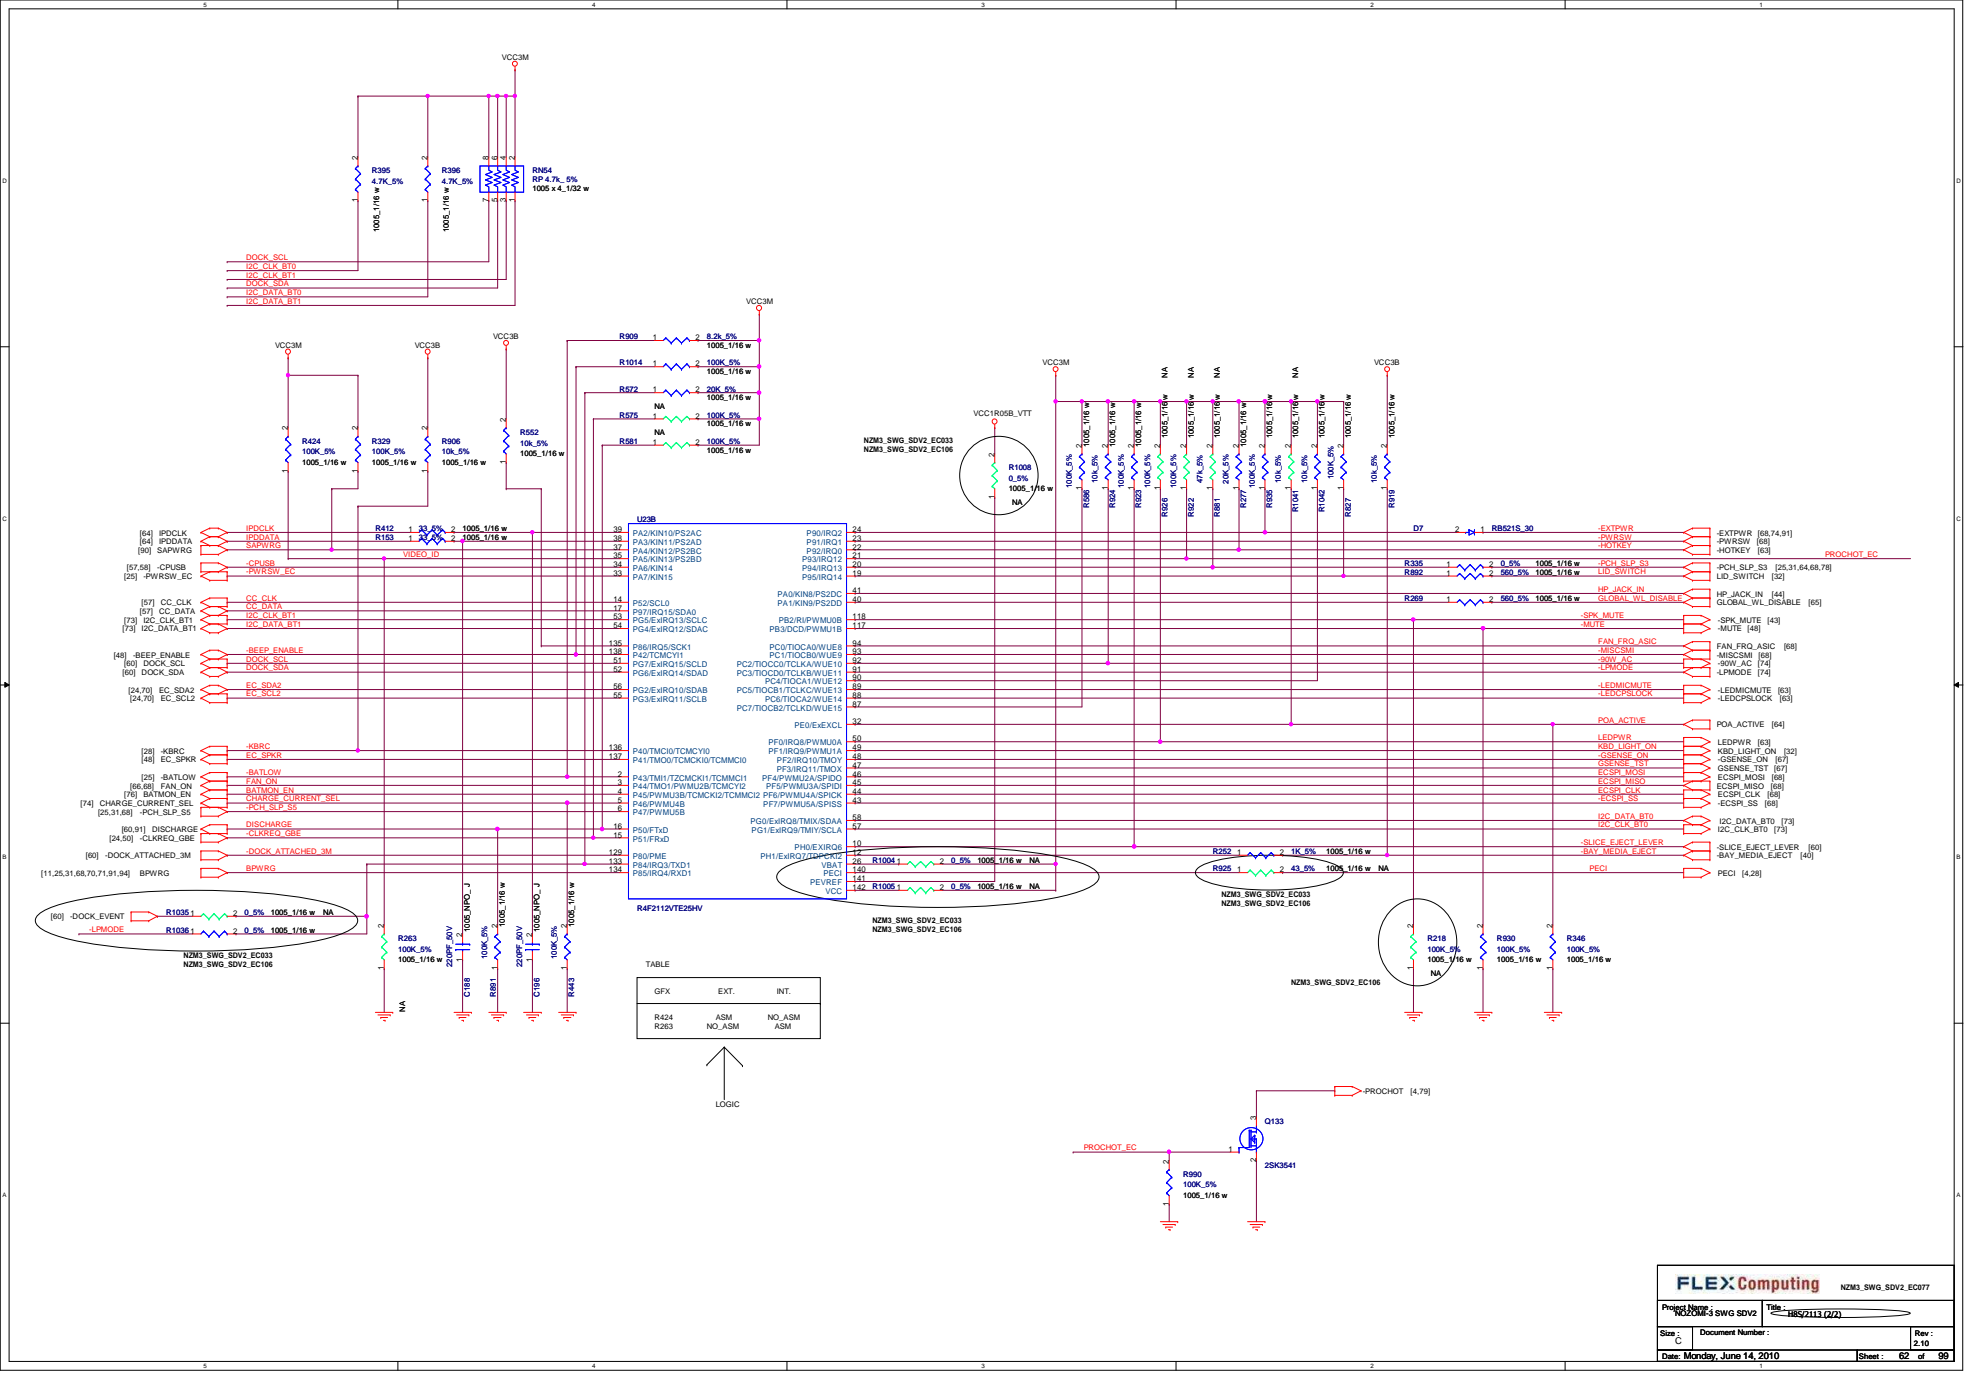
[picture p116: page 62]

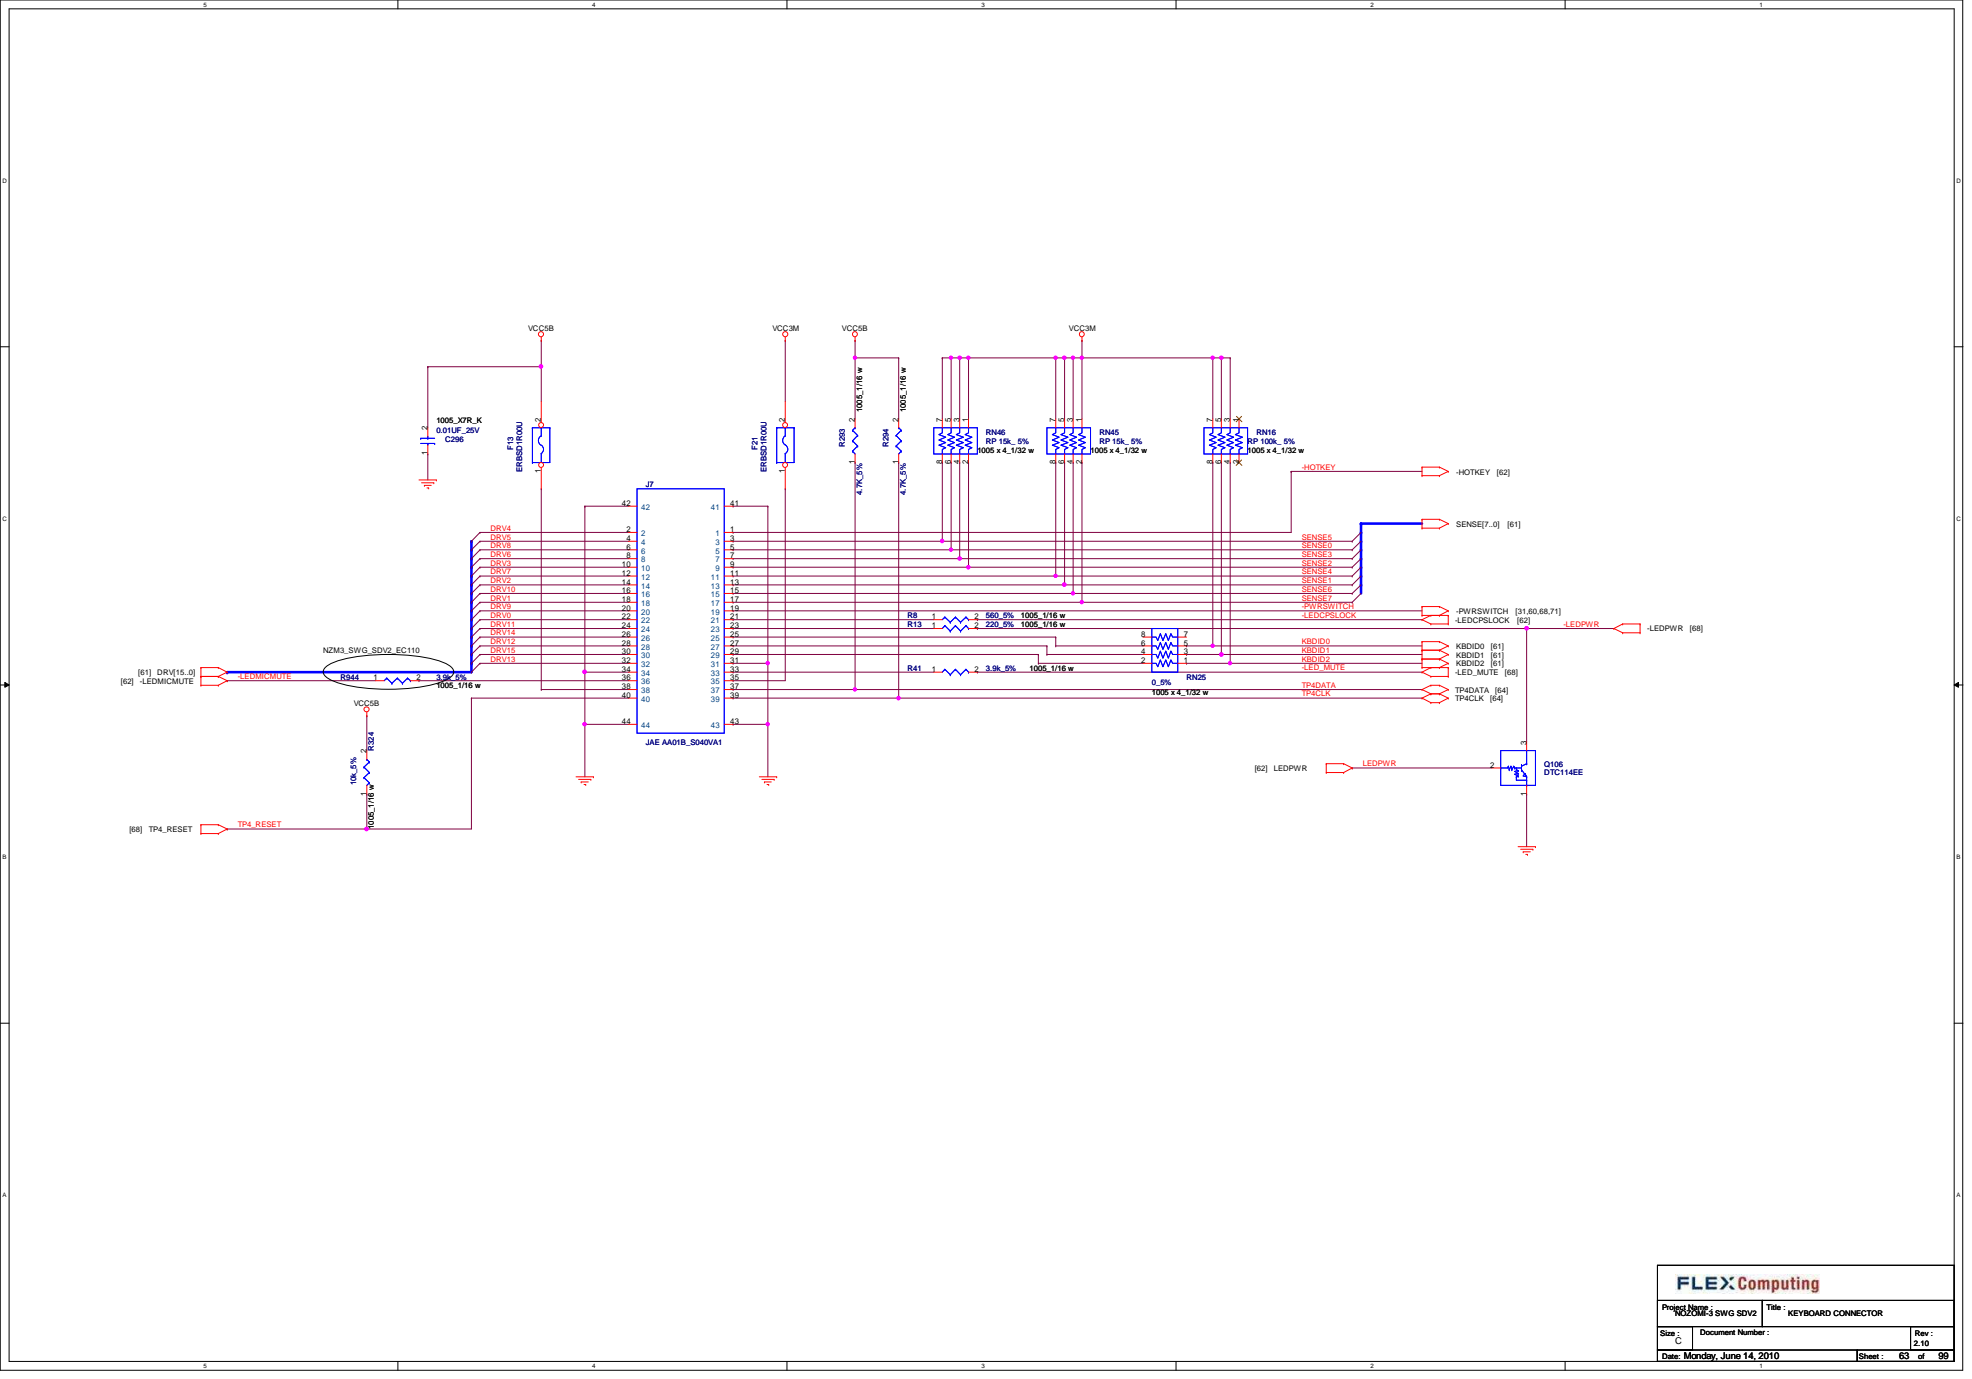
[picture p117: page 63]

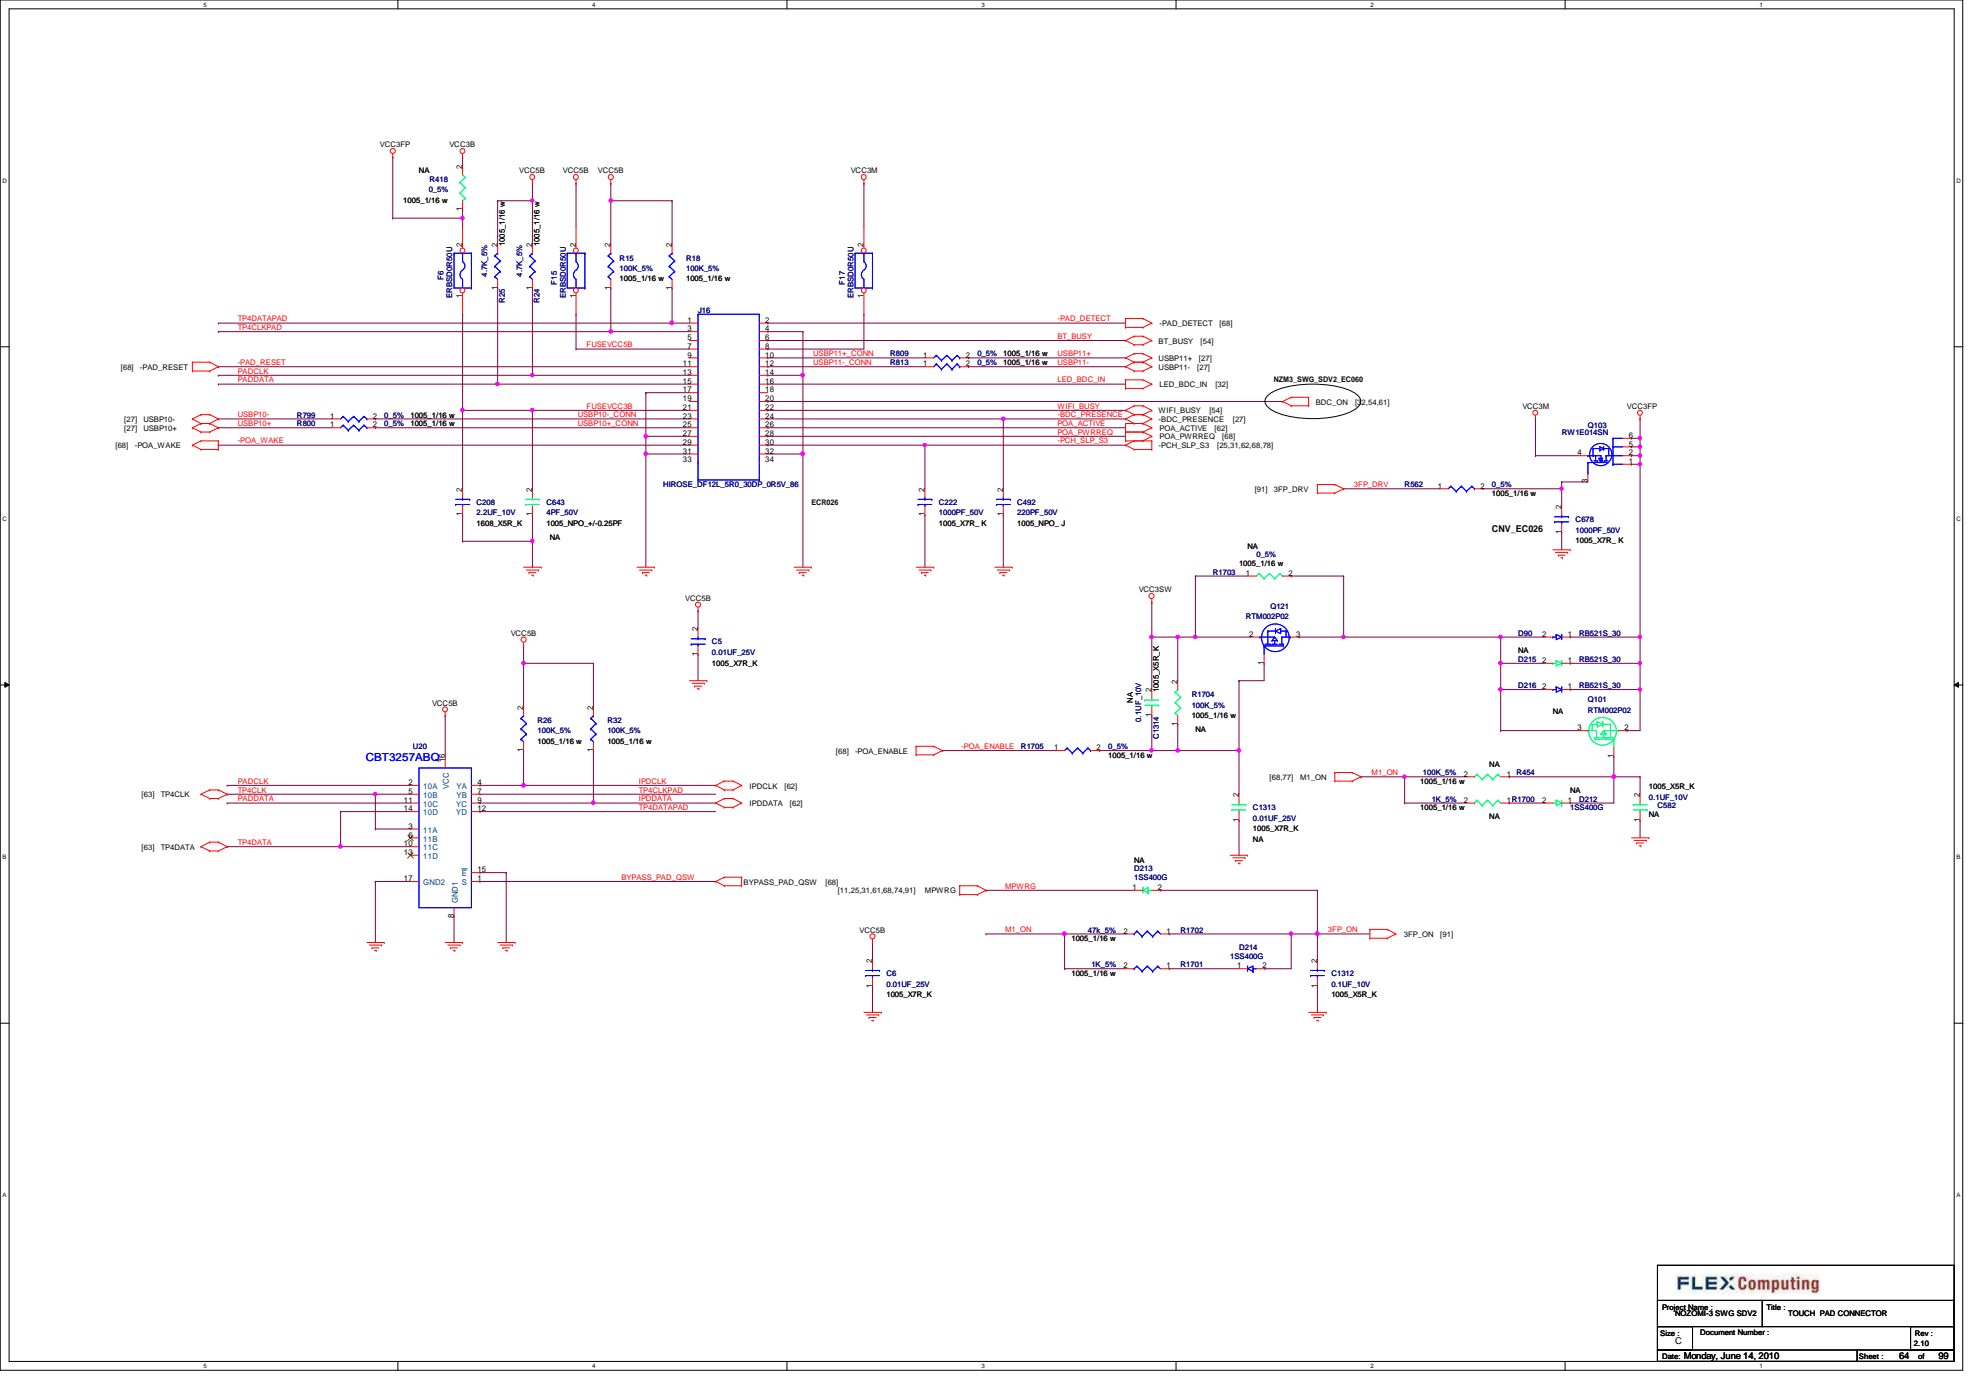
[picture p118: page 64]

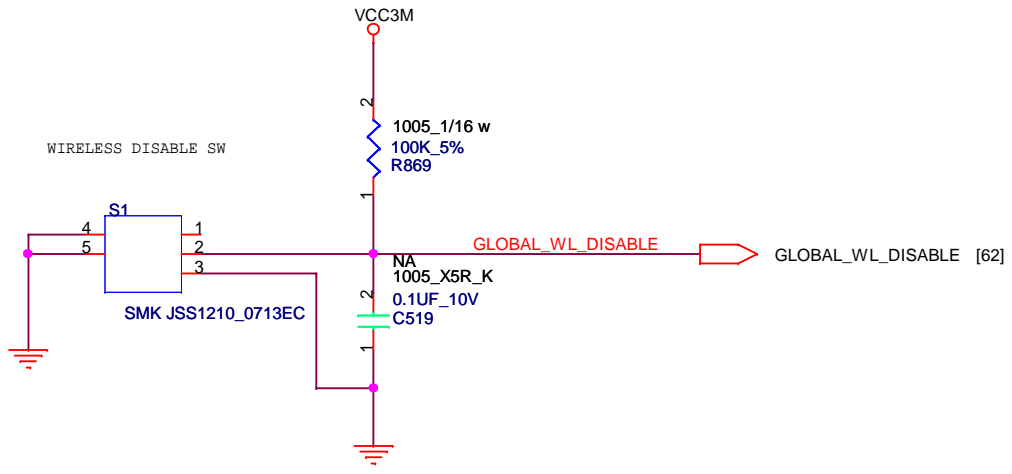
[picture p119: page 65]
GLOBAL_WL_DISABLE; GLOBAL_WL_DISABLE [62]; VCC3M; Monday, June 14, 2010; NOZOMI-3 SWG SDV2; WIRELESS DISABLE SW; SMK JSS1210_0713EC

WIRELESS DISABLE SW

### FUSE 2.0A

### FAN CURRENT

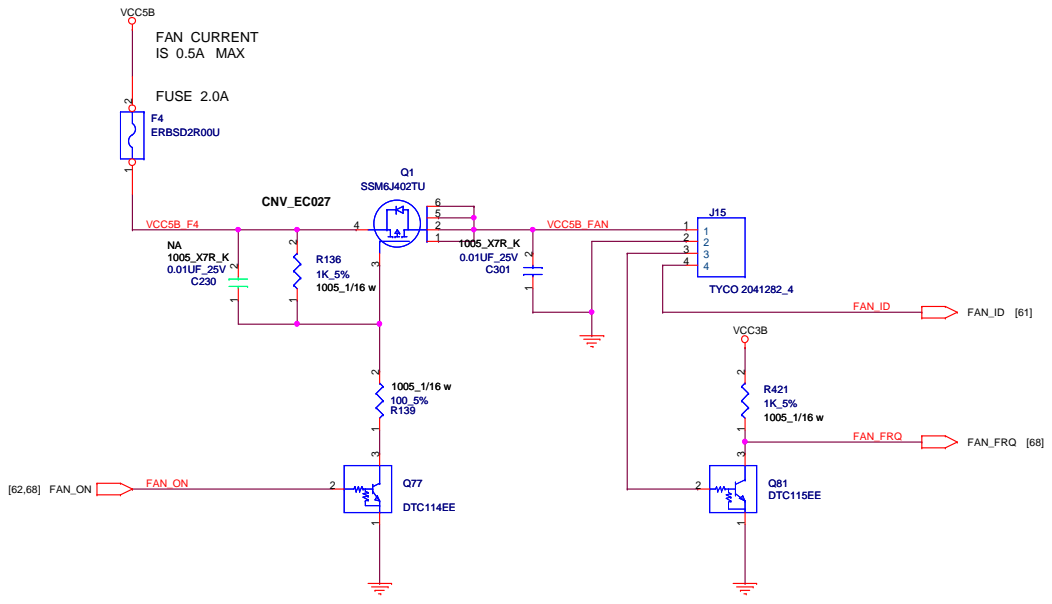
[picture p120: page 66]

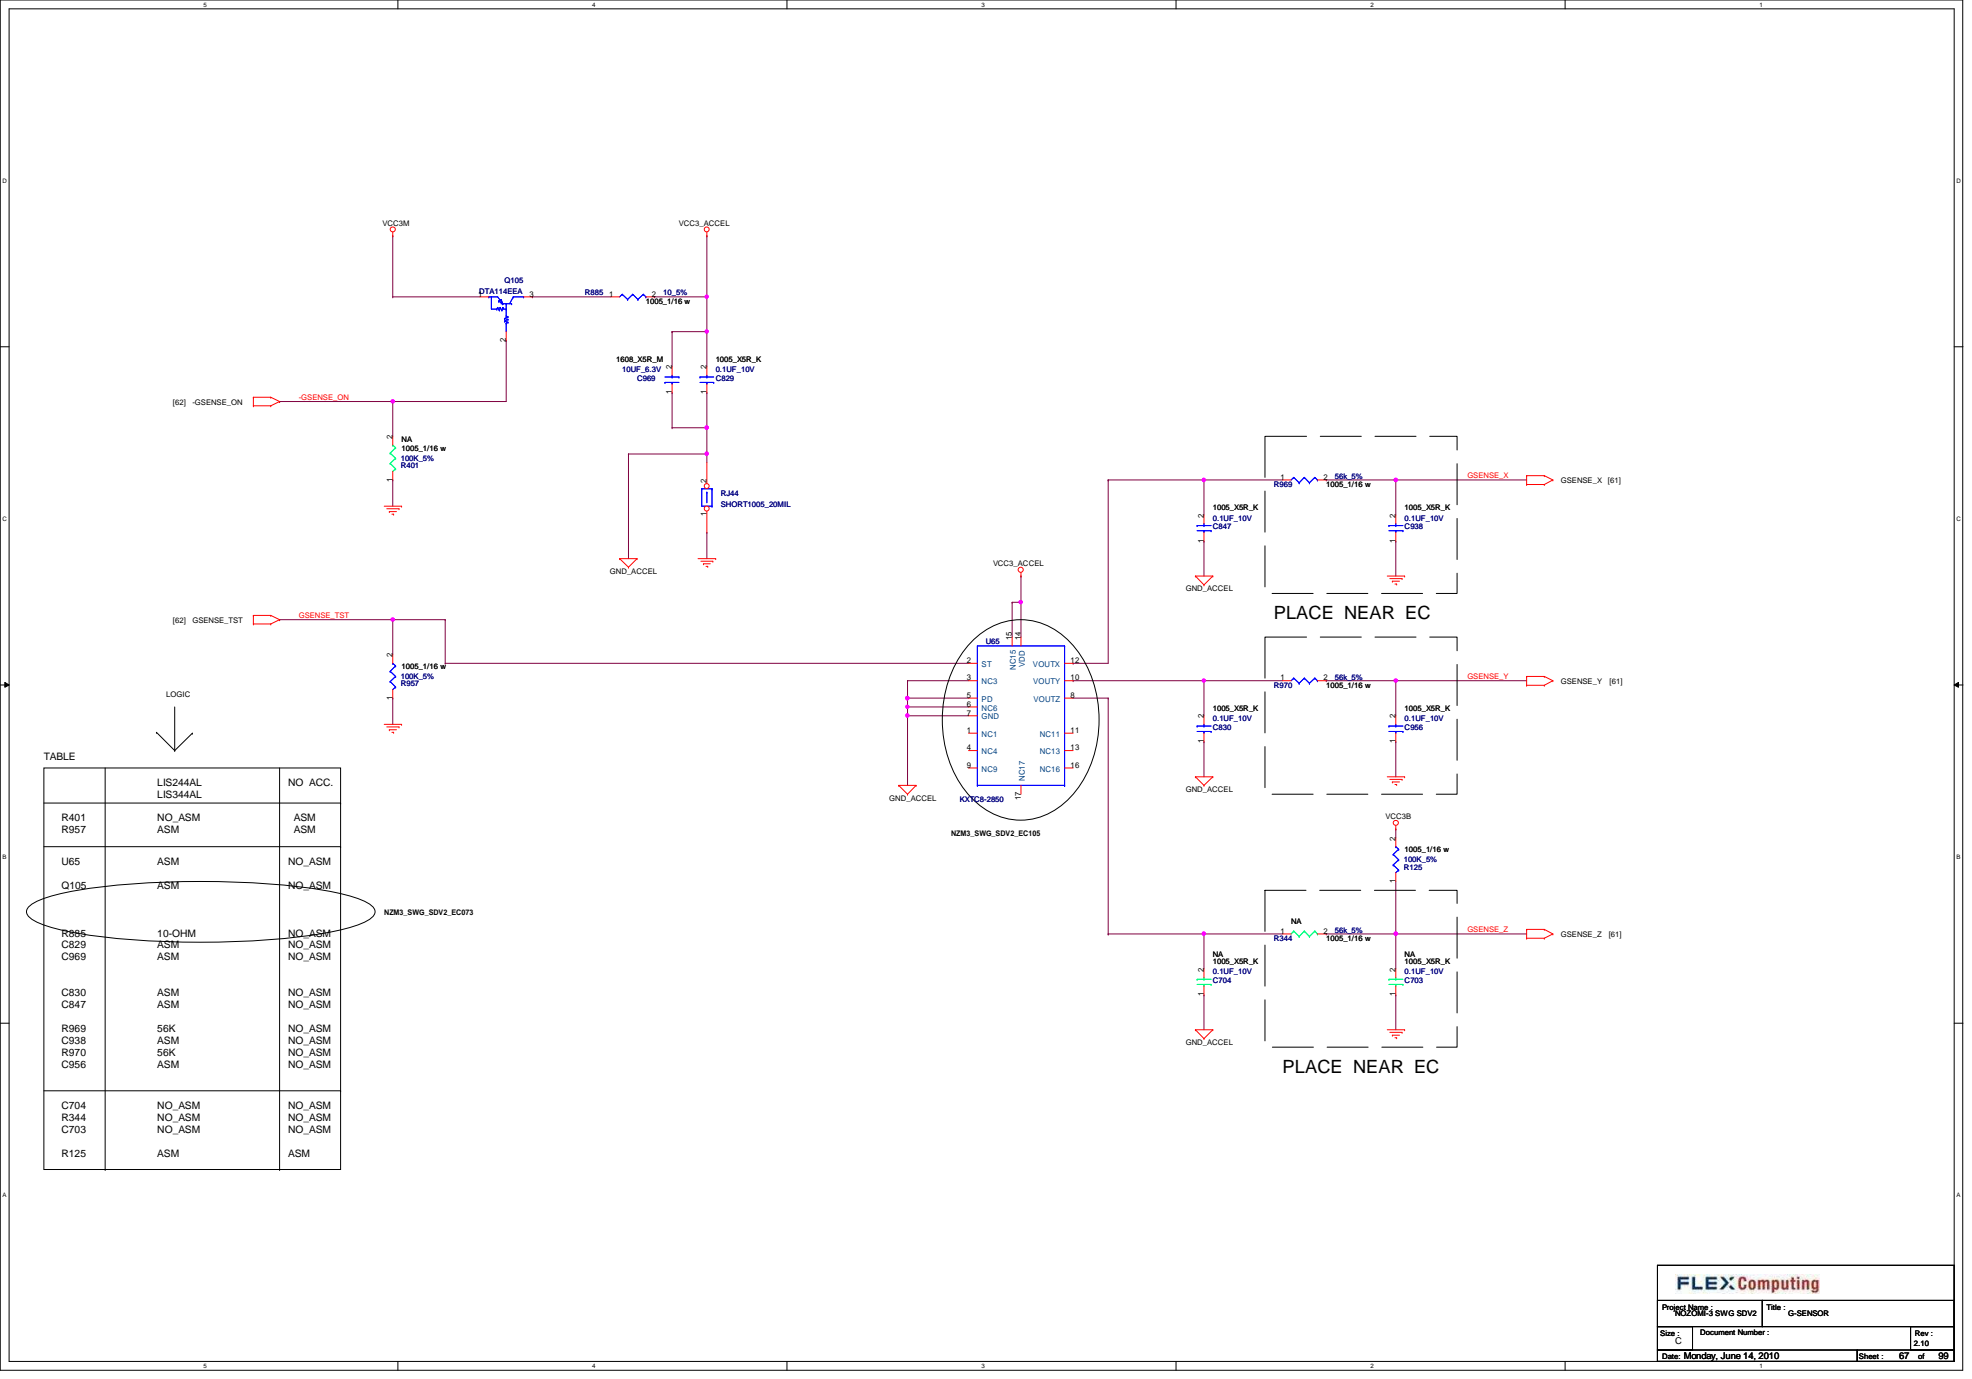
[picture p121: page 67]

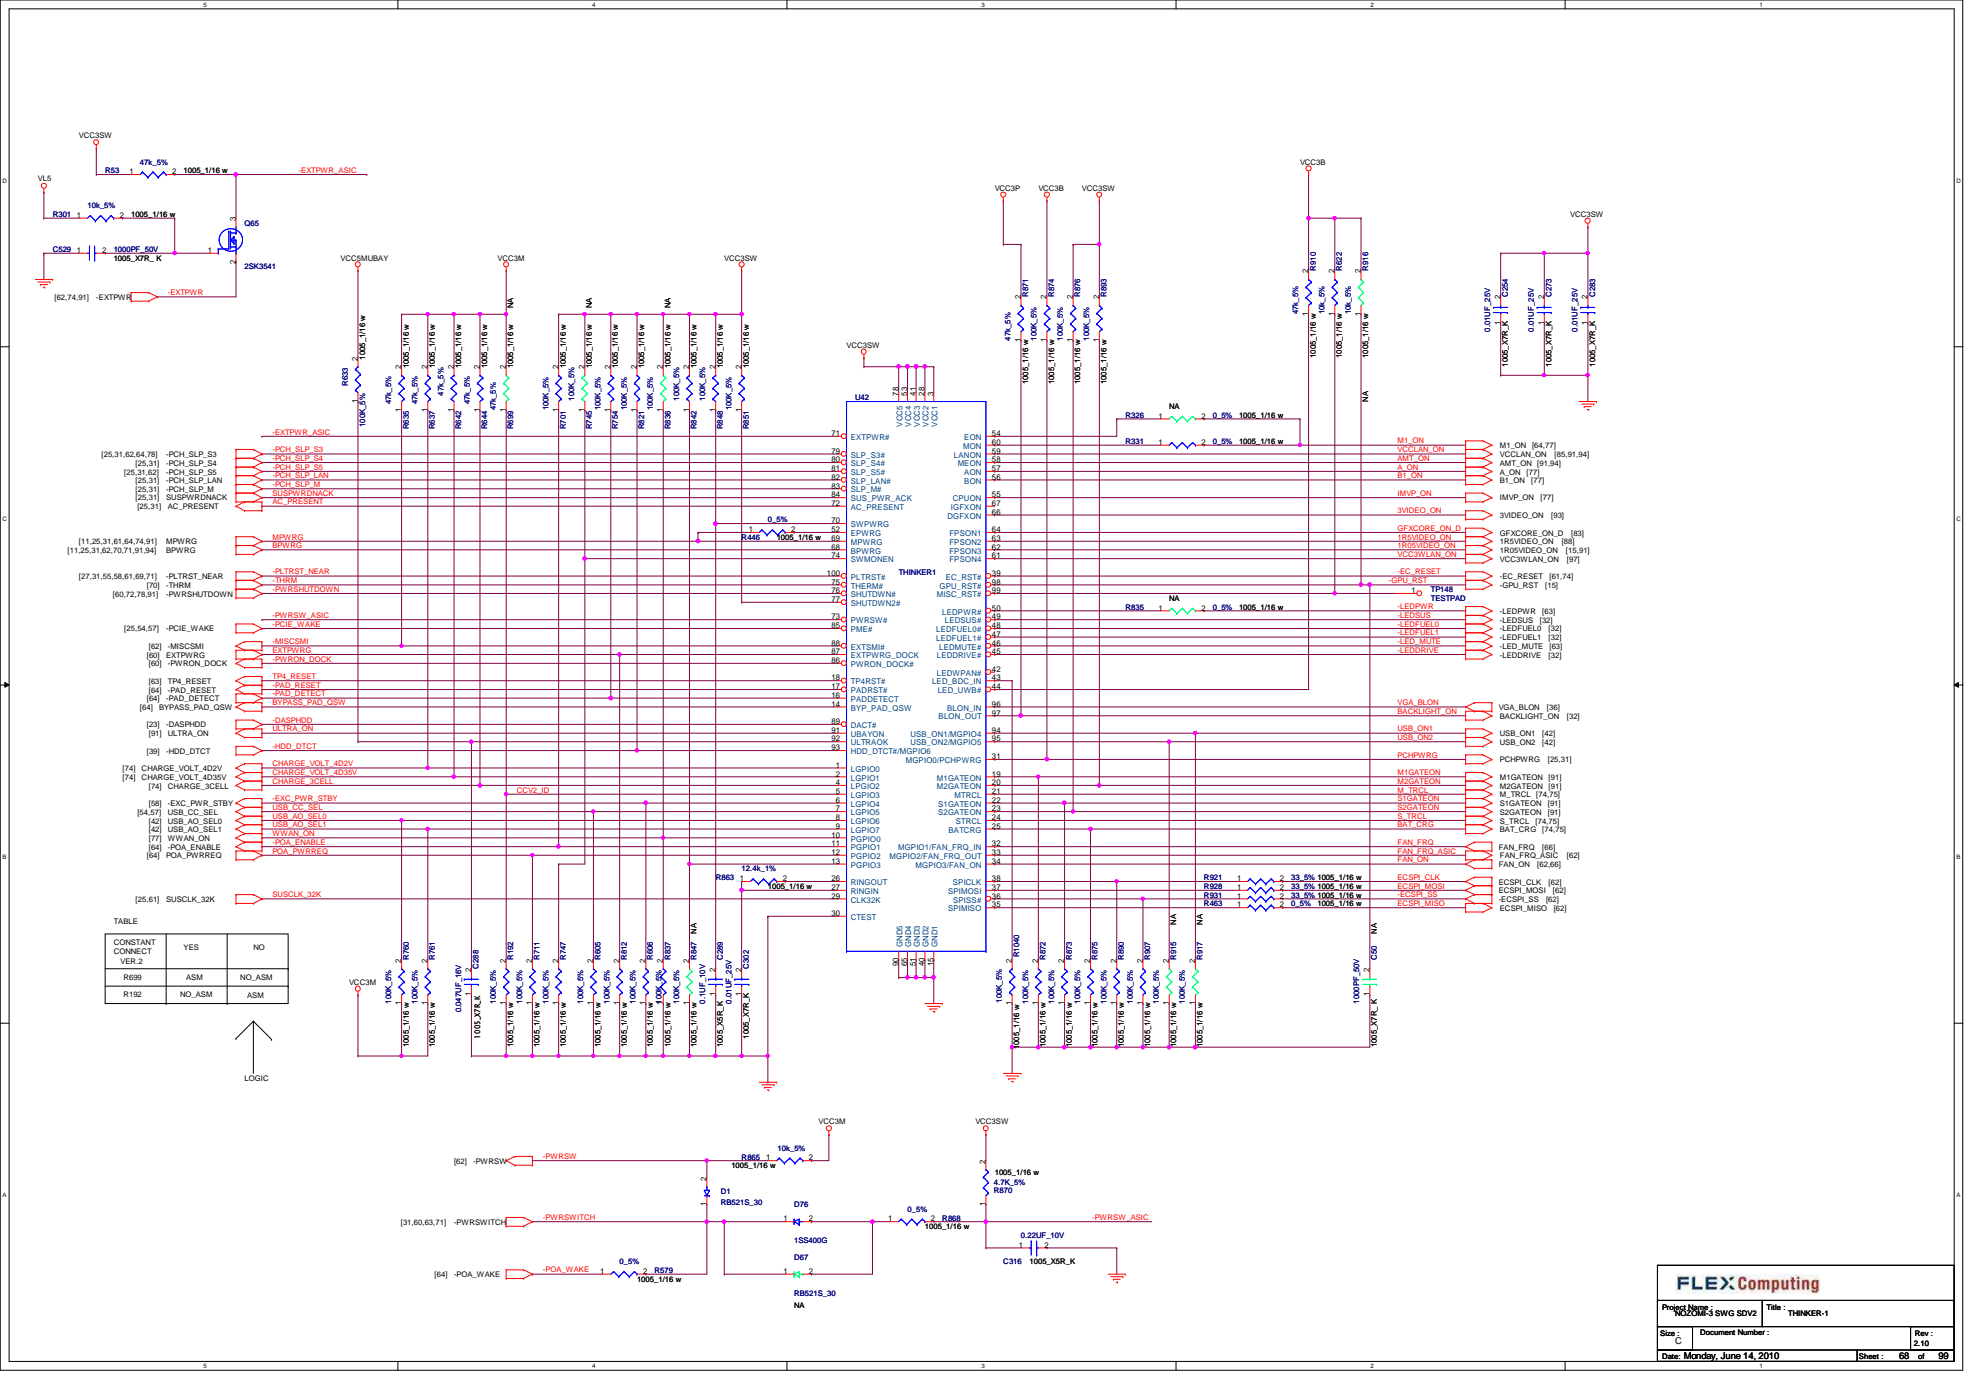
[picture p122: page 68]

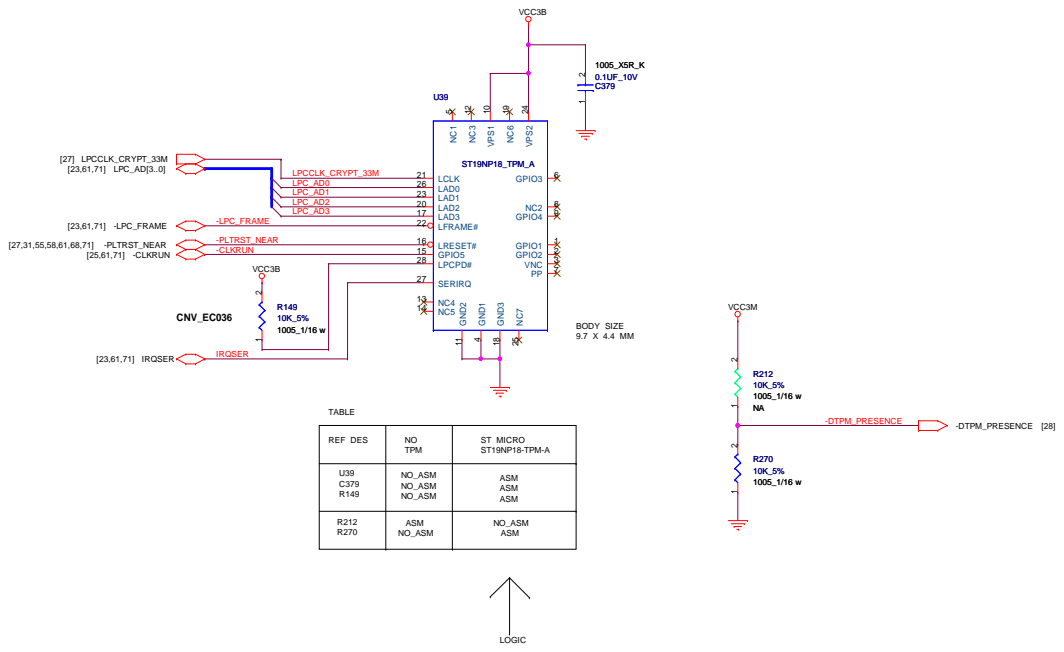
[picture p123: page 69]
IRQSER; -CLKRUN; -PLTRST_NEAR; -LPC_FRAME; LPC_AD2; LPC_AD1; LPC_AD0; LPC_AD3; LPCCLK_CRYPT_33M; -DTPM_PRESENCE; [23,61,71] IRQSER; [25,61,71] -CLKRUN; [27,31,55,58,61,68,71] -PLTRST_NEAR; [23,61,71] -LPC_FRAME; [27] LPCCLK_CRYPT_33M [23,61,71] LPC_AD[3..0]; -DTPM_PRESENCE [28]; VCC3B; VCC3M; Monday, June 14, 2010; NOZOMI-3 SWG SDV2; TPM; LOGIC; TABLE; REF DES; ST MICRO ST19NP18-TPM-A; ASM ASM ASM; NO_ASM NO_ASM NO_ASM; ASM NO_ASM; NO_ASM ASM; BODY SIZE 9.7 X 4.4 MM; CNV_EC036; ST19NP18_TPM_A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

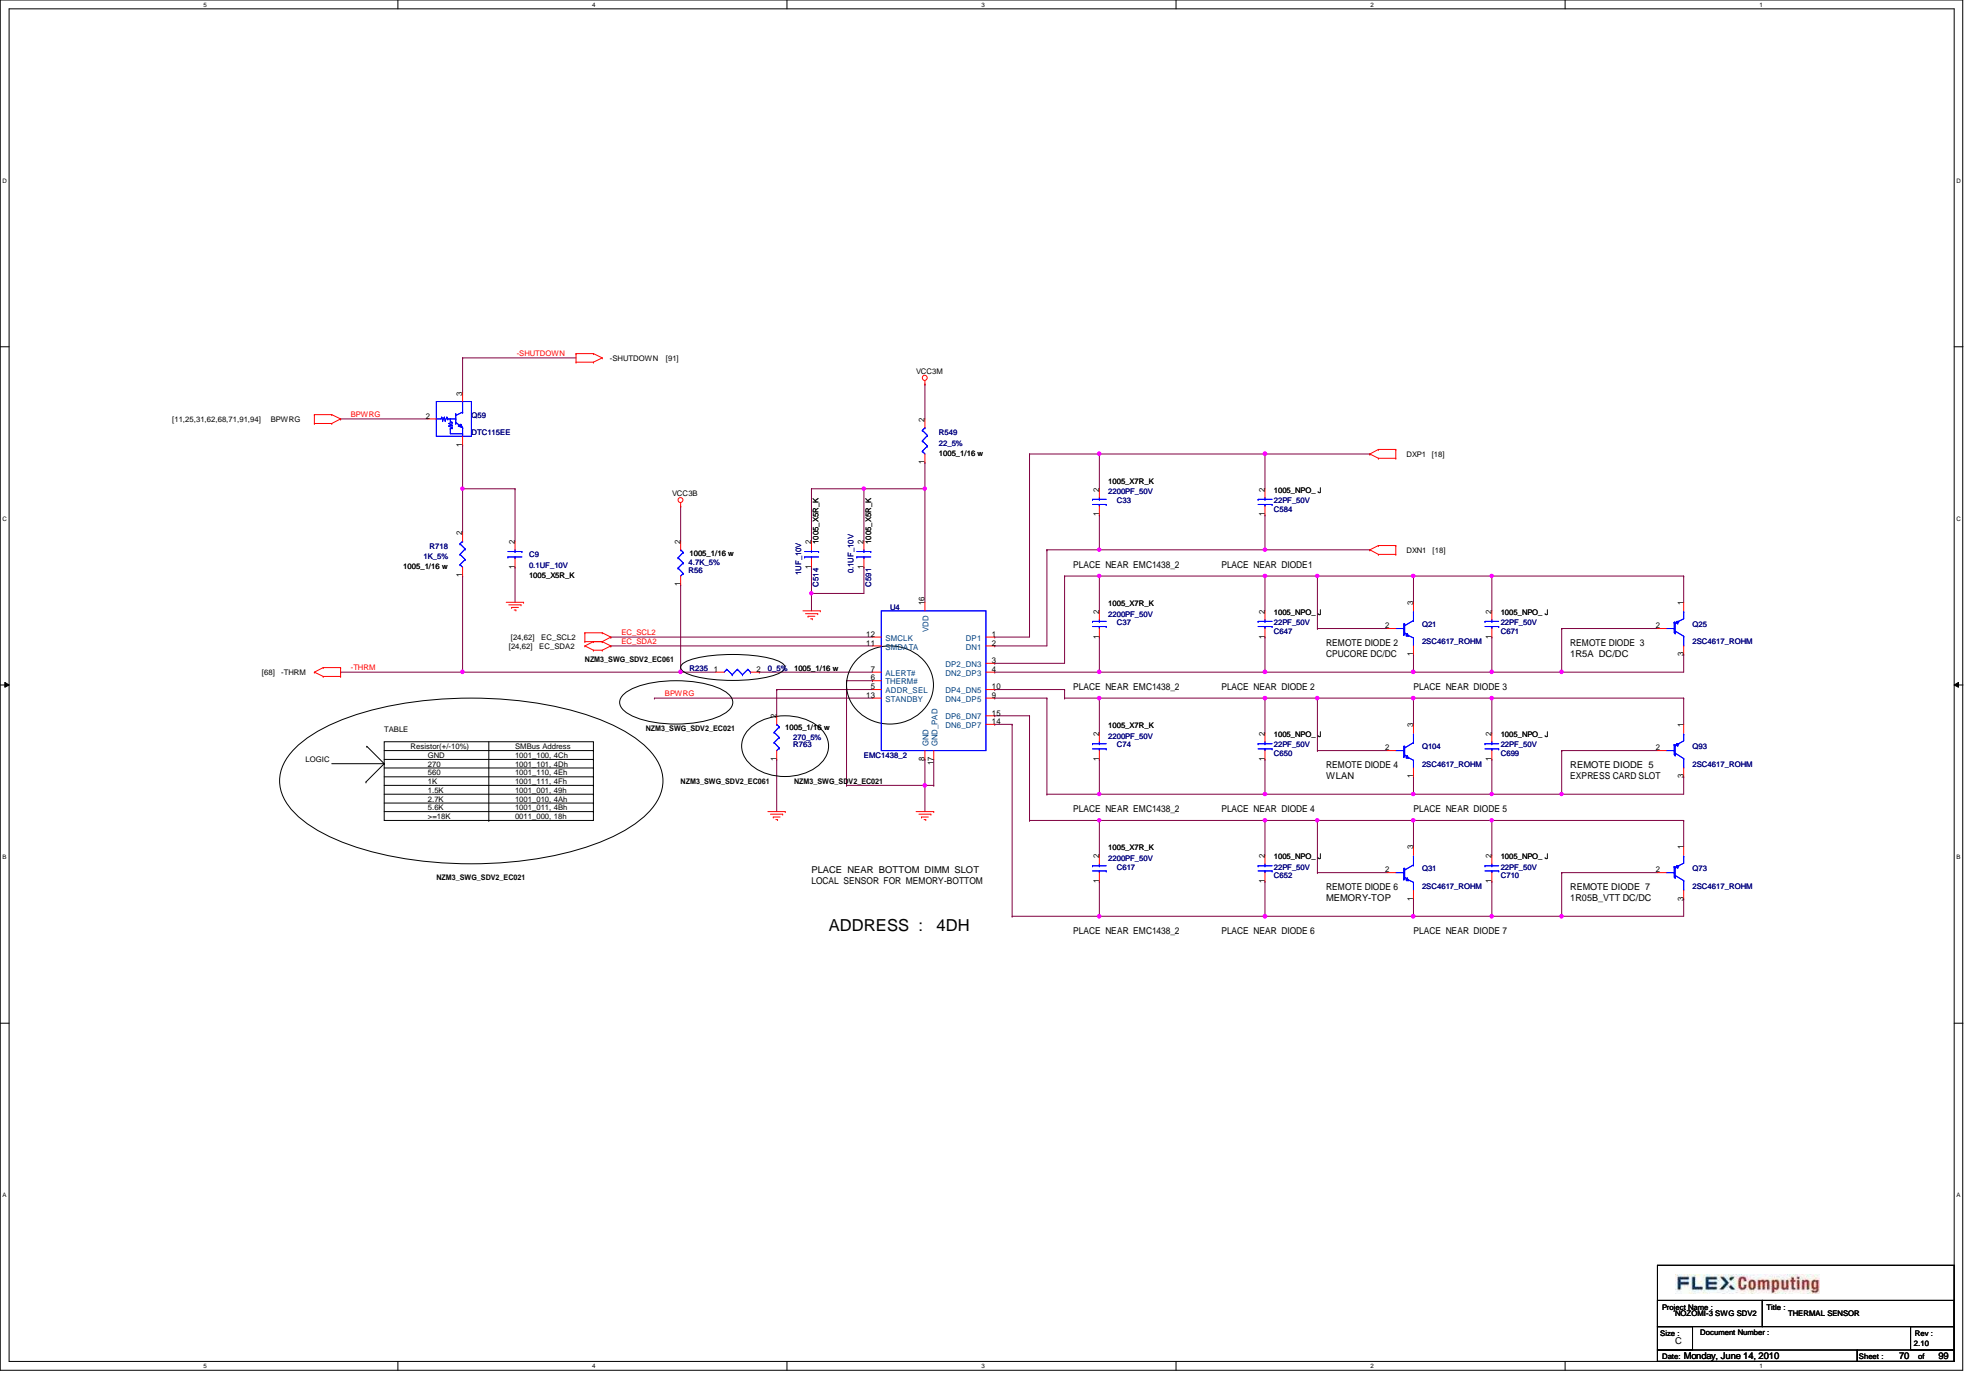
[picture p124: page 70]

PLACE NEAR BOTTOM DIMM SLOT
LOCAL SENSOR FOR MEMORY-BOTTOM

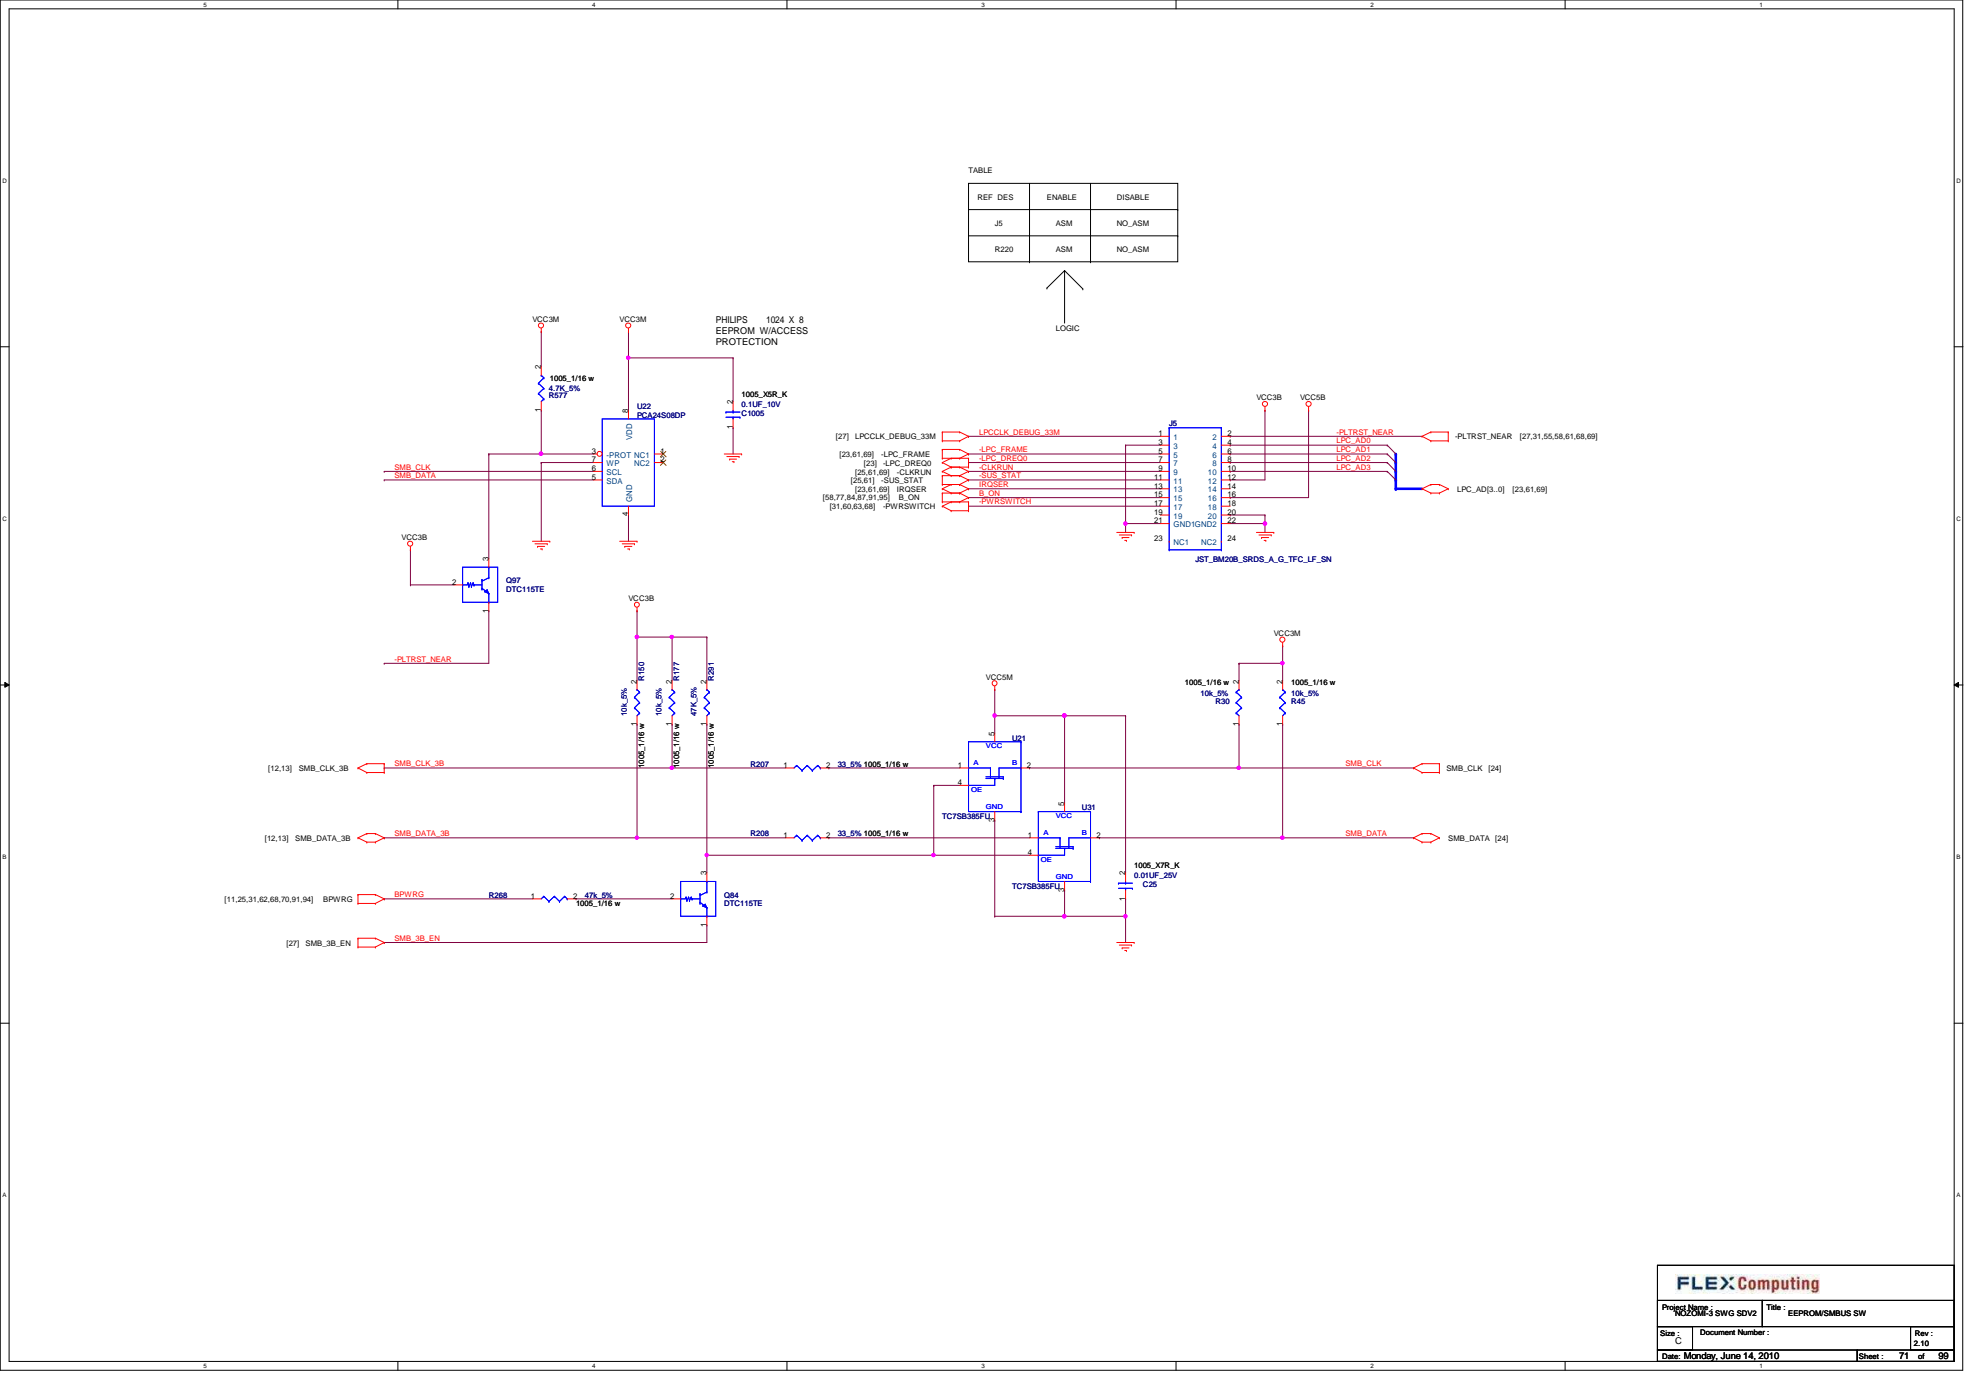
[picture p125: page 71]

SDA 5 SCL 6 WP 7 -PROT 3

# DCIN

## PLACE NEAR CONNECTOR

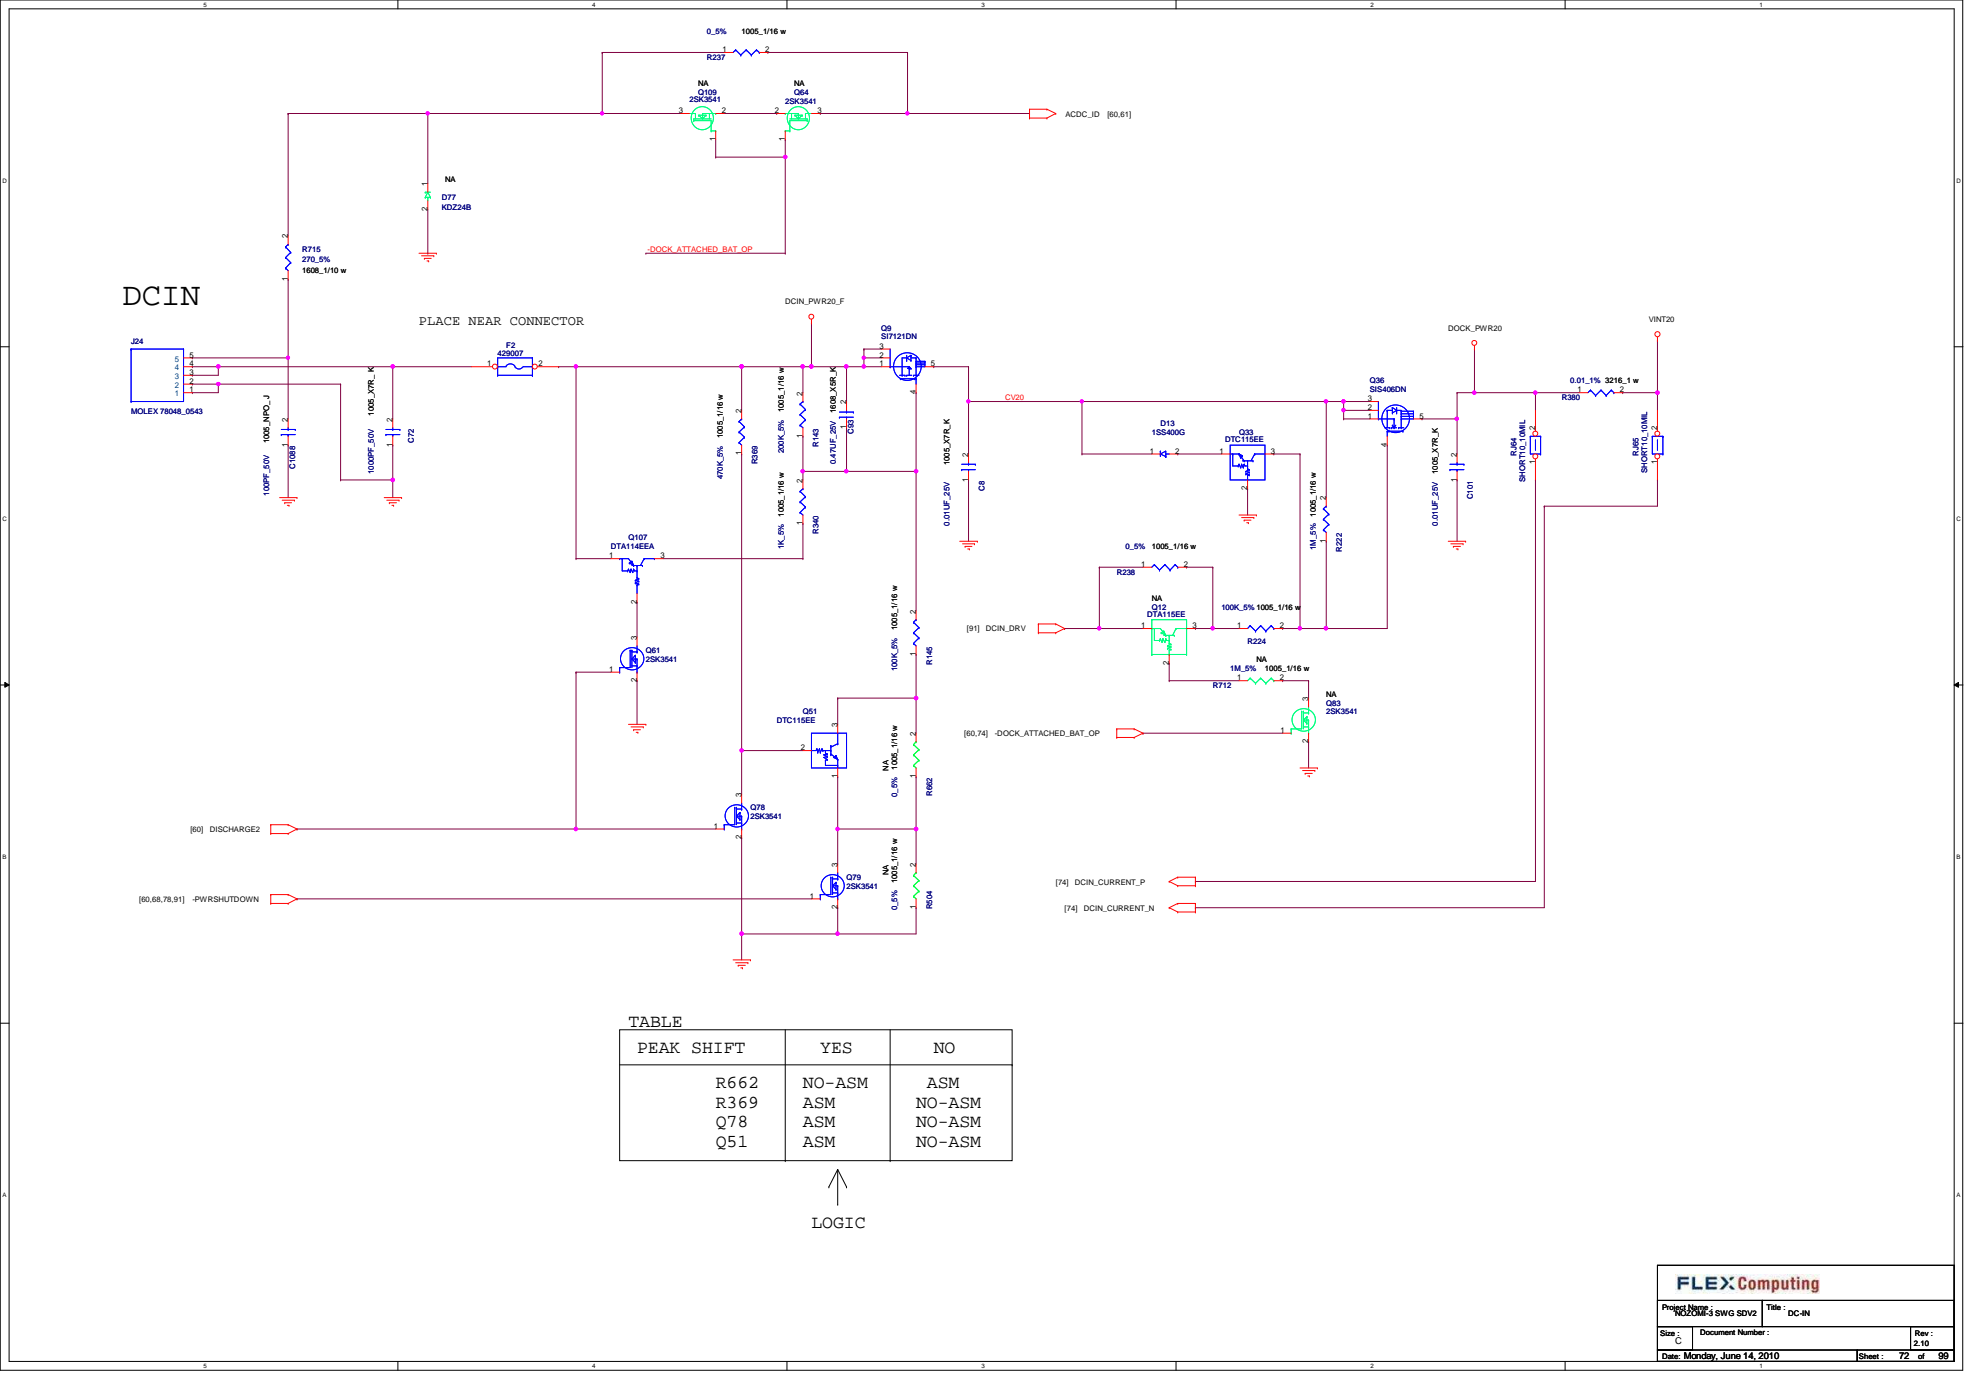
[picture p126: page 72]

## MAIN BAT CONN

# WIDE PATTERN

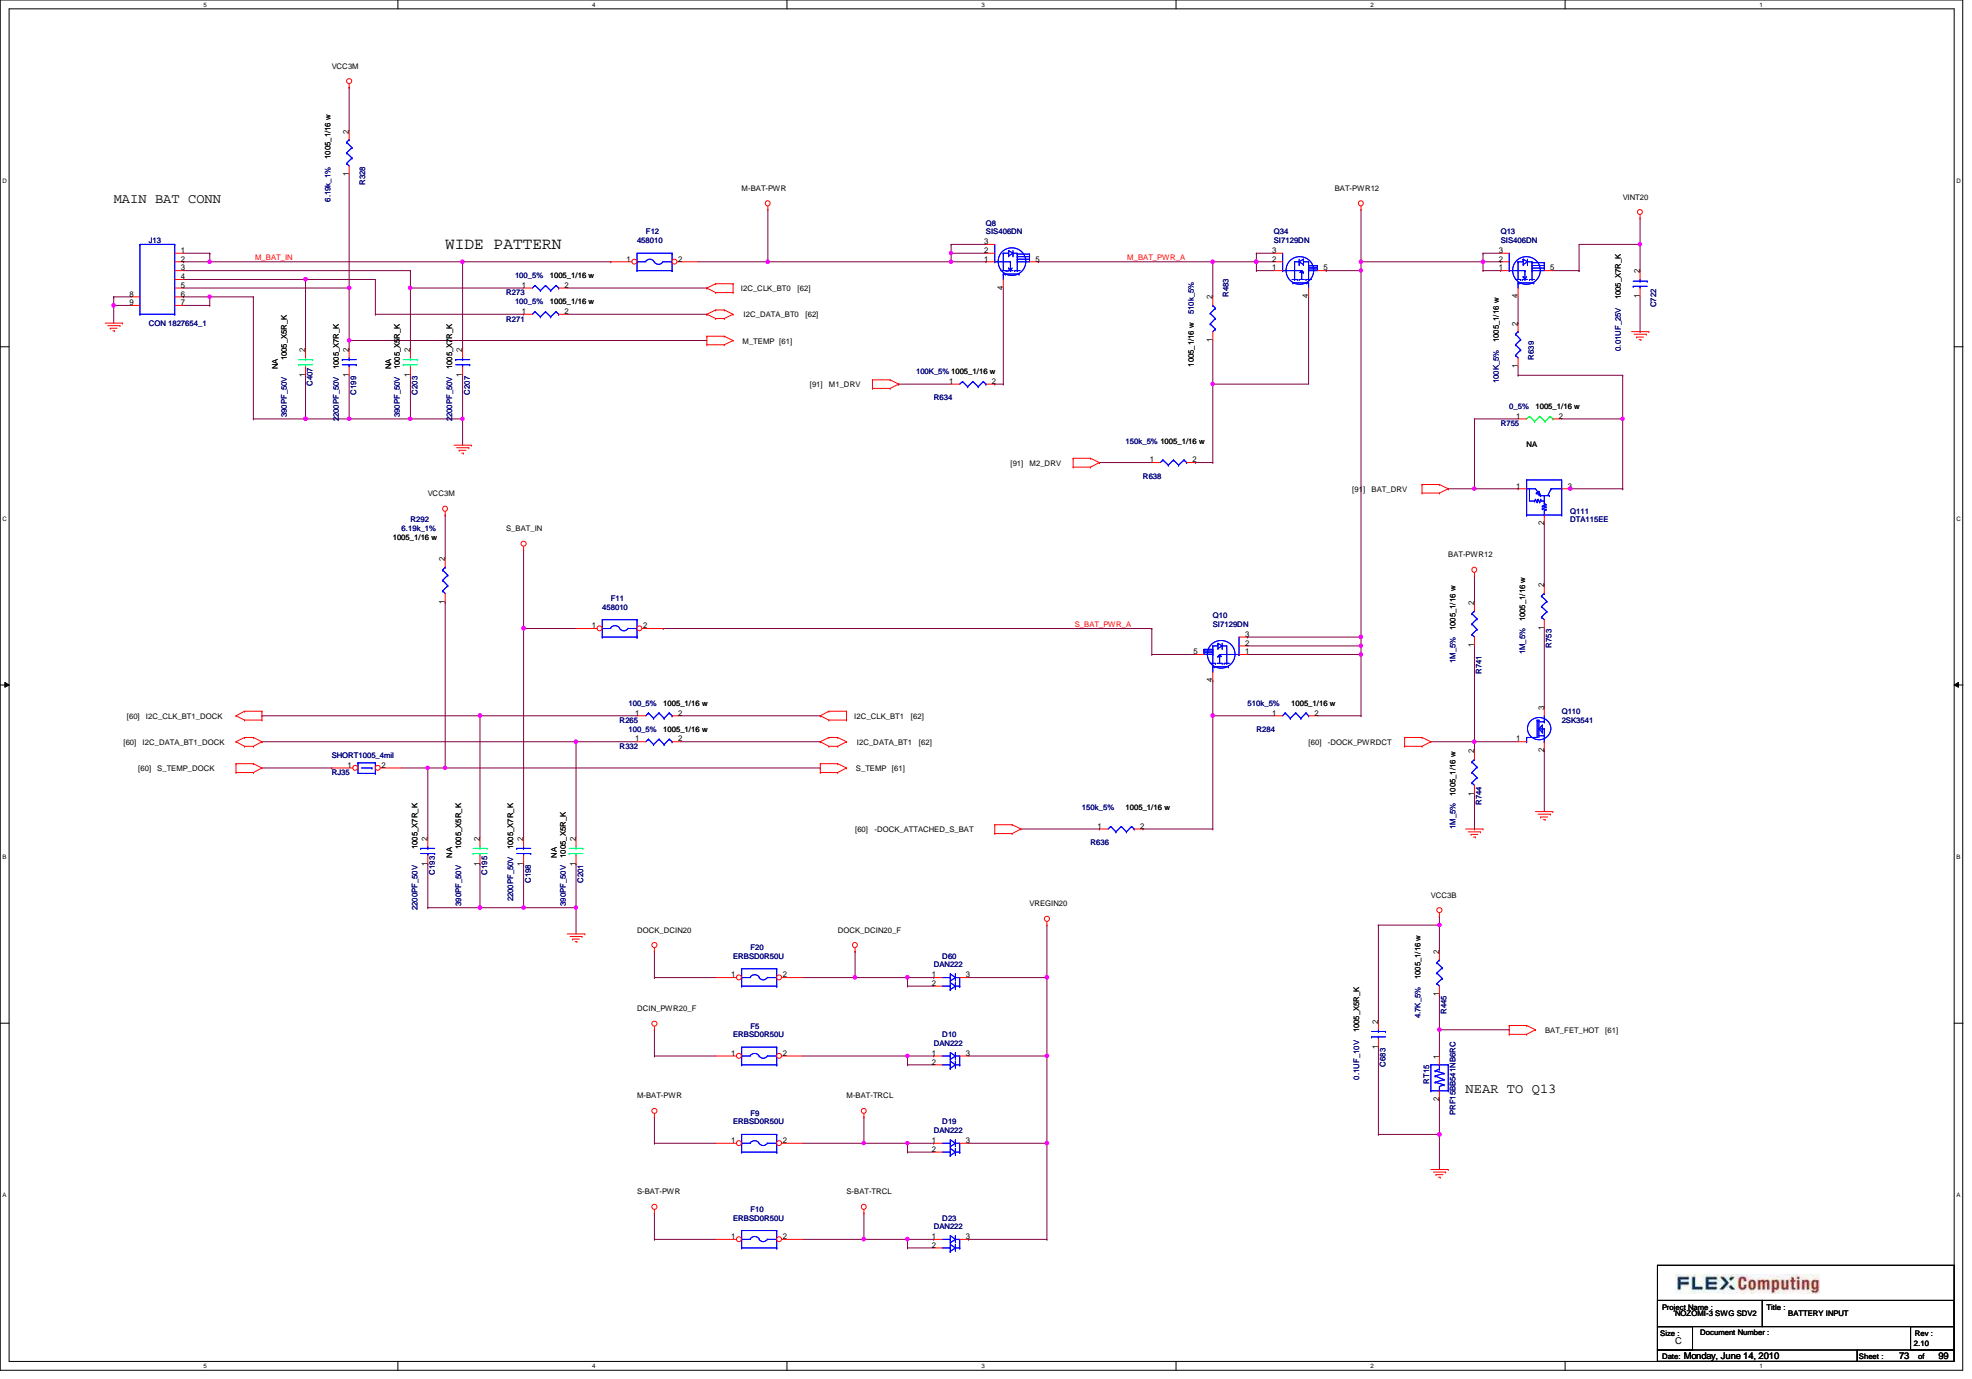
[picture p127: page 73]

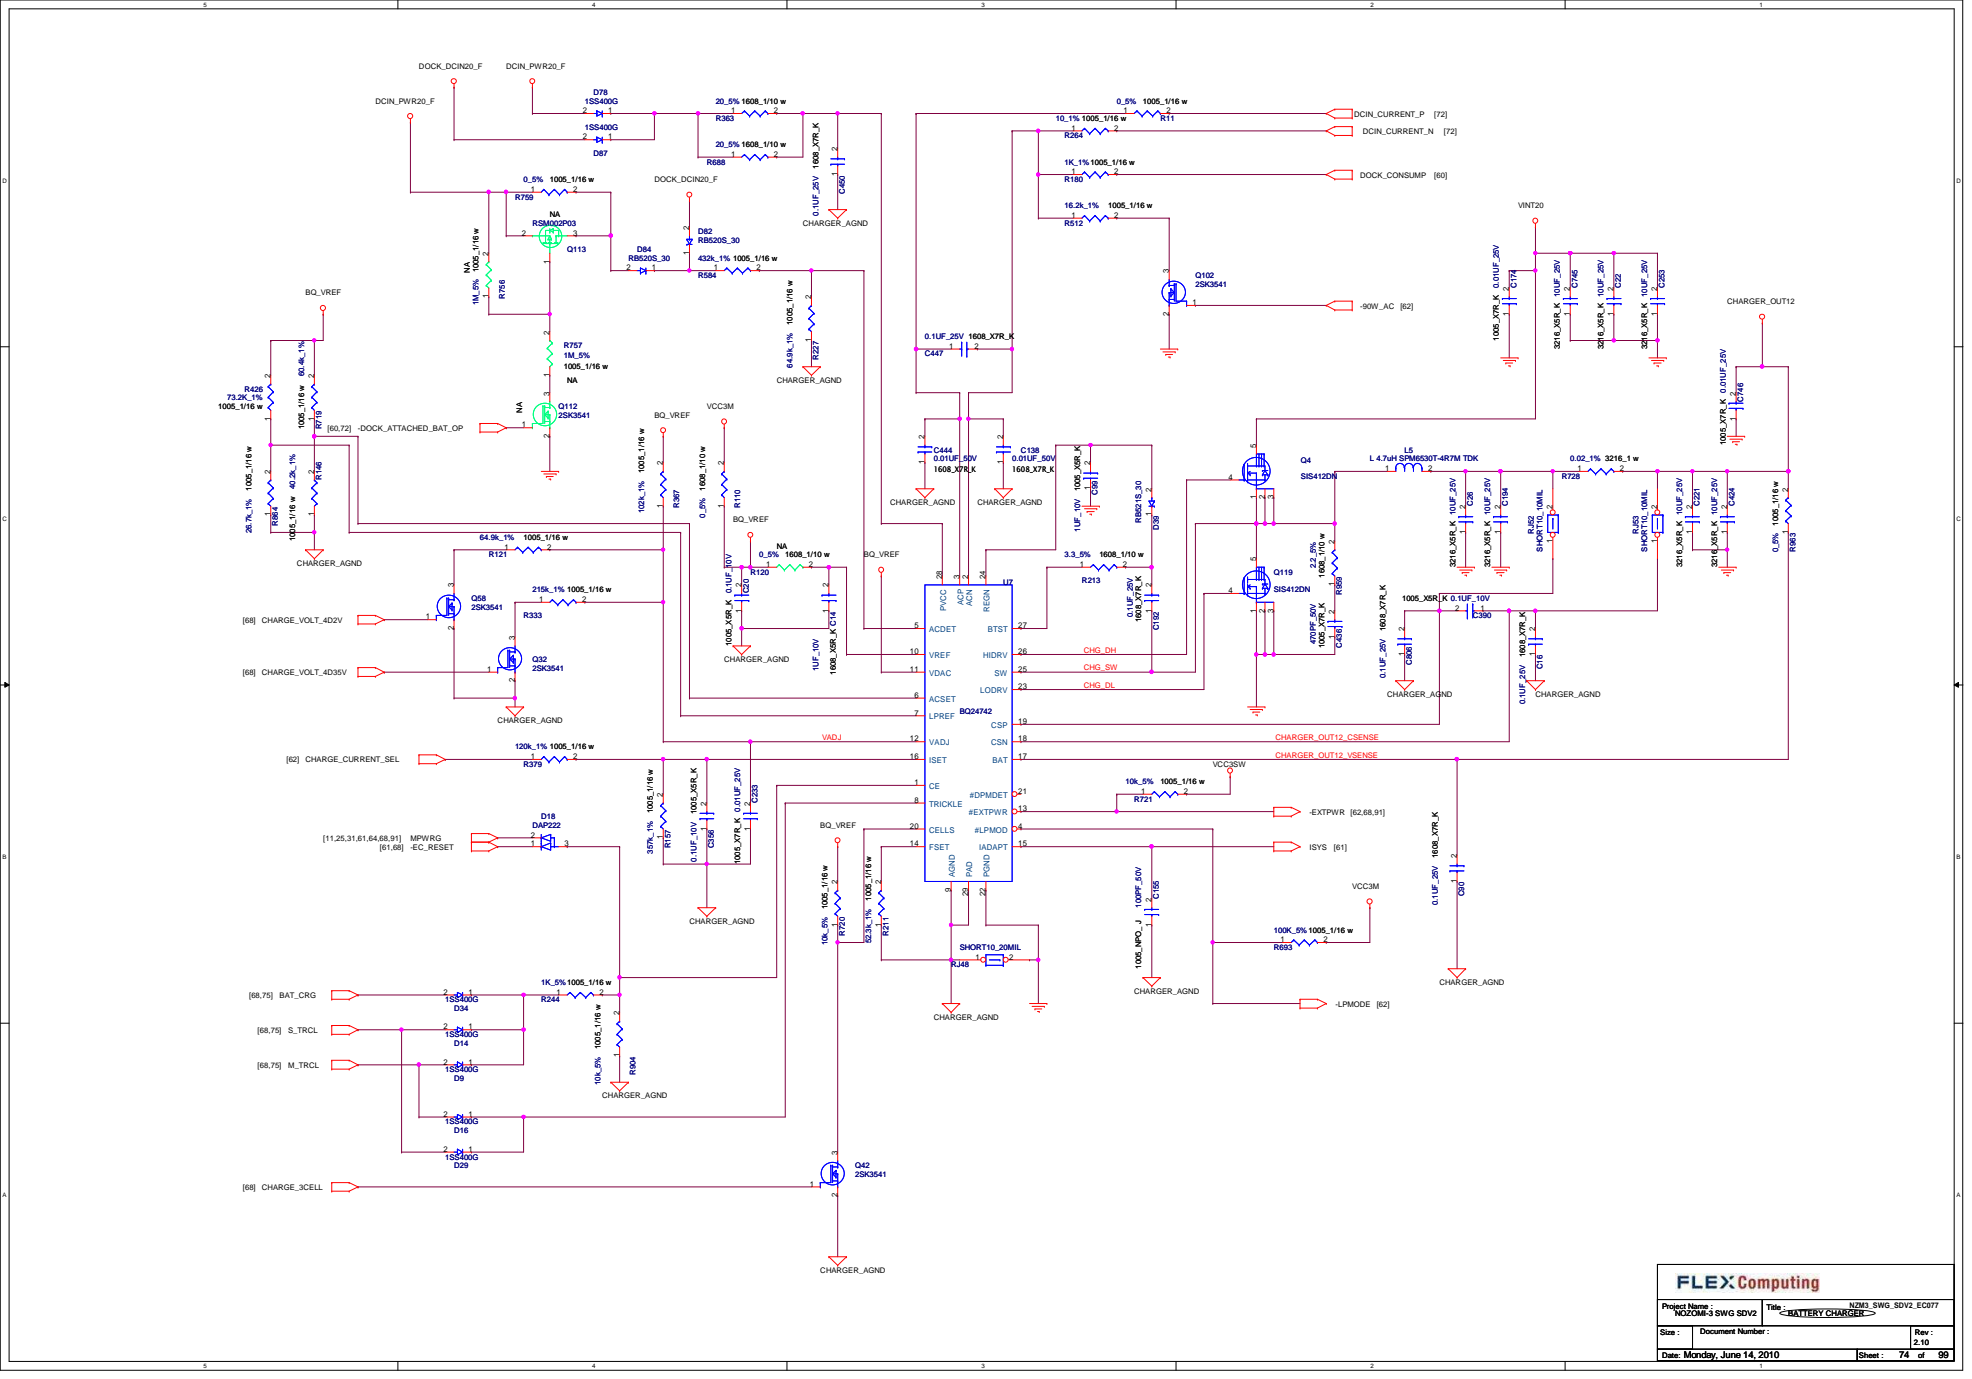
[picture p128: page 74]

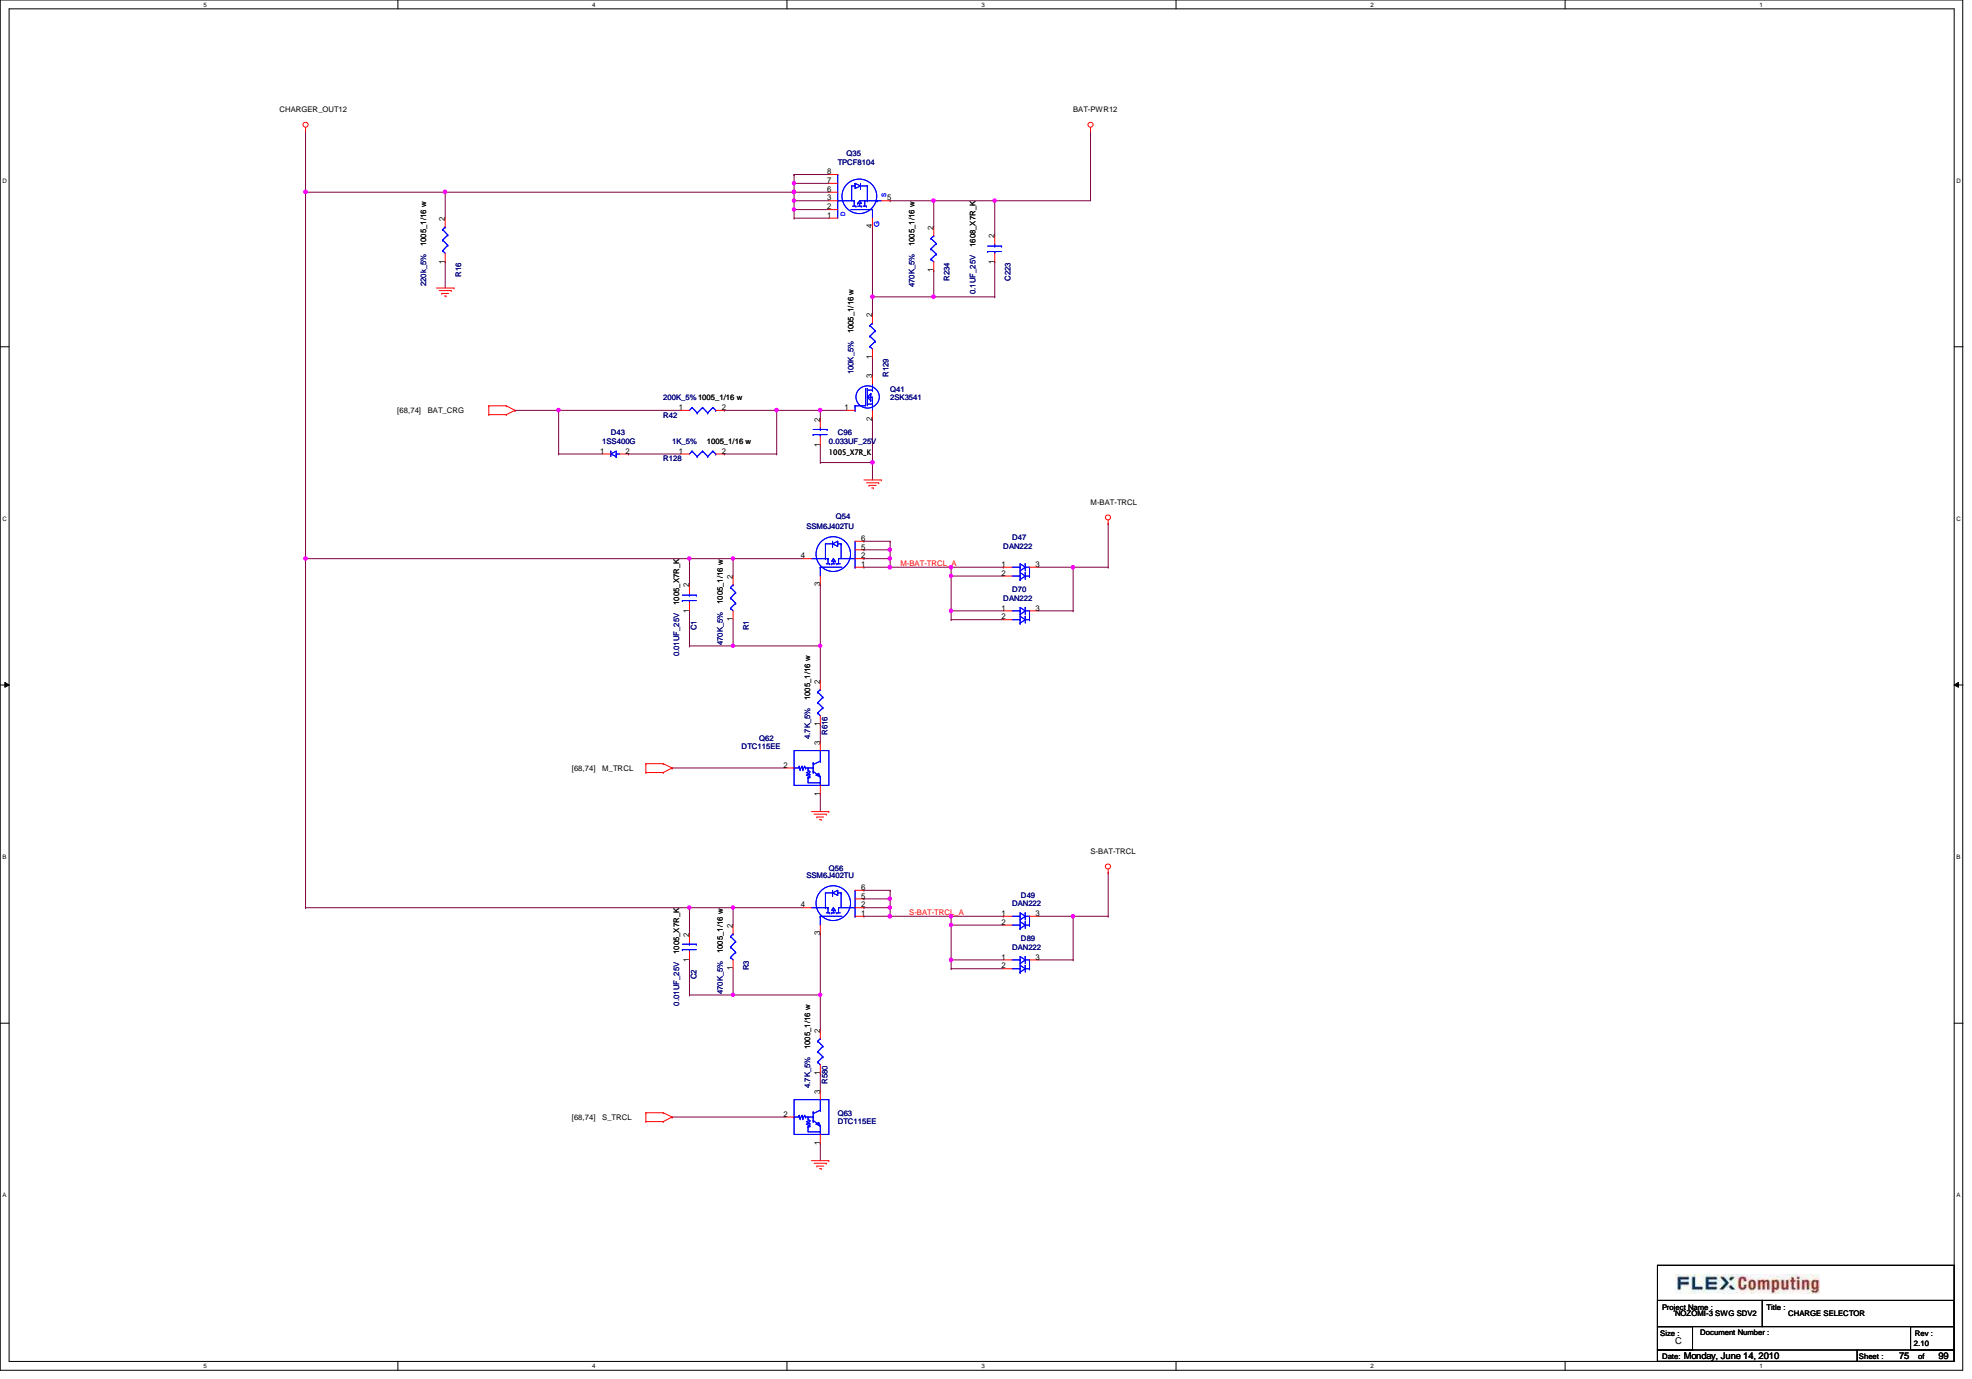
[picture p129: page 75]

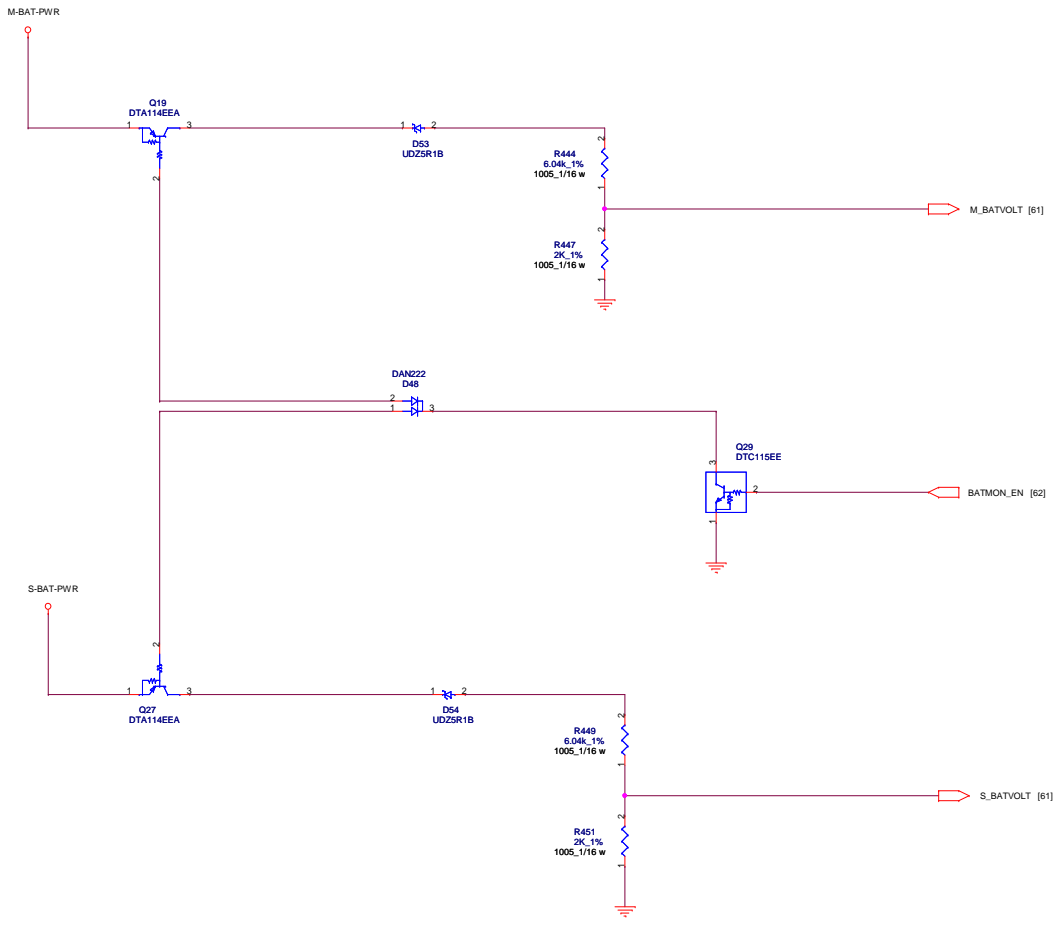
[picture p130: page 76]

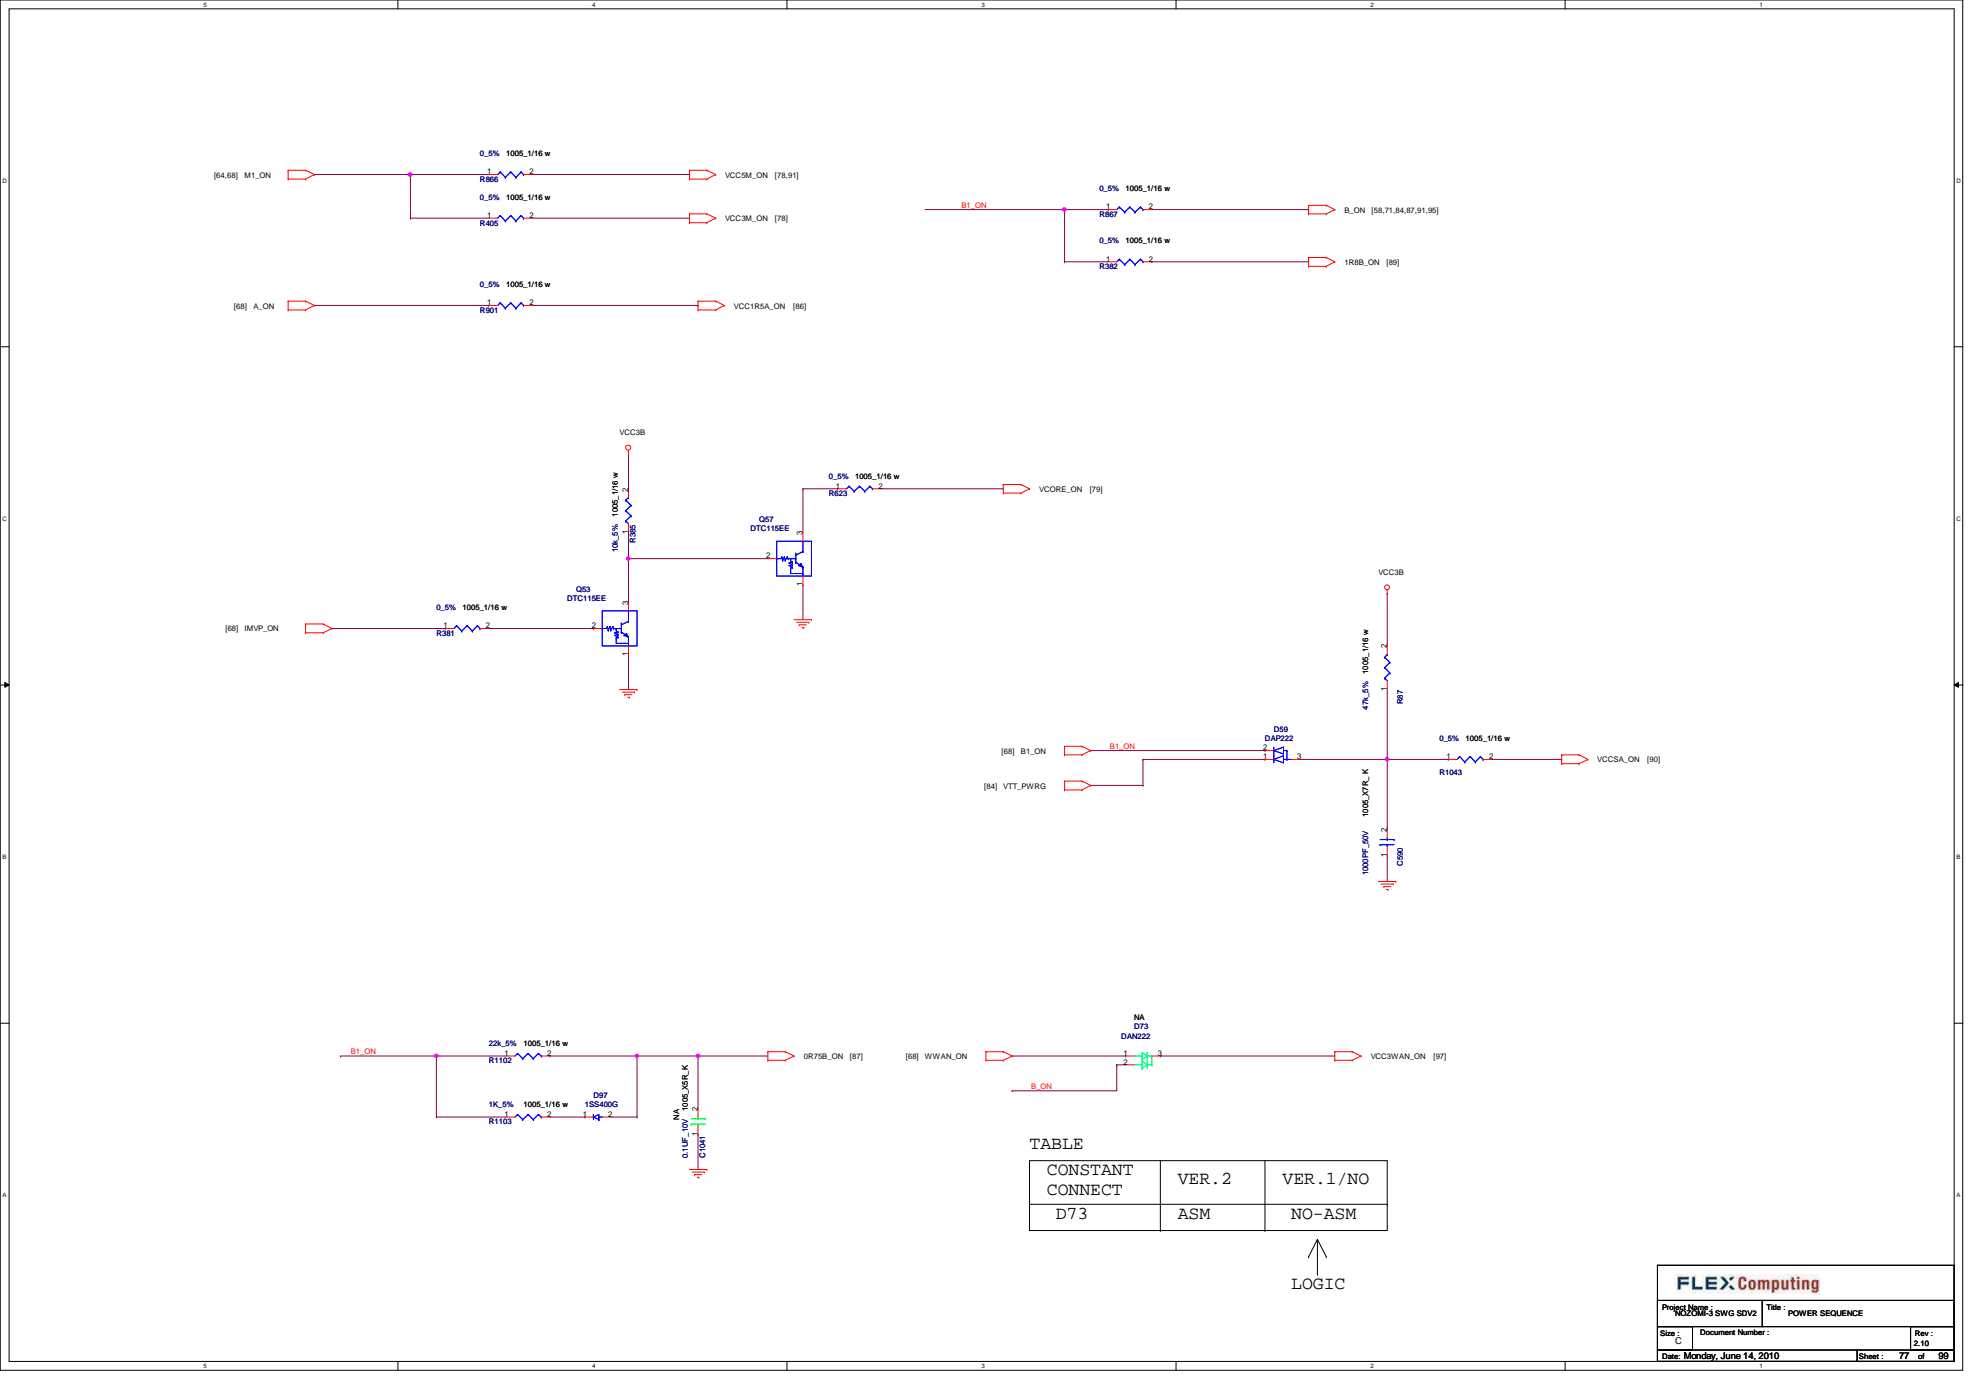
[picture p131: page 77]

9A

16A

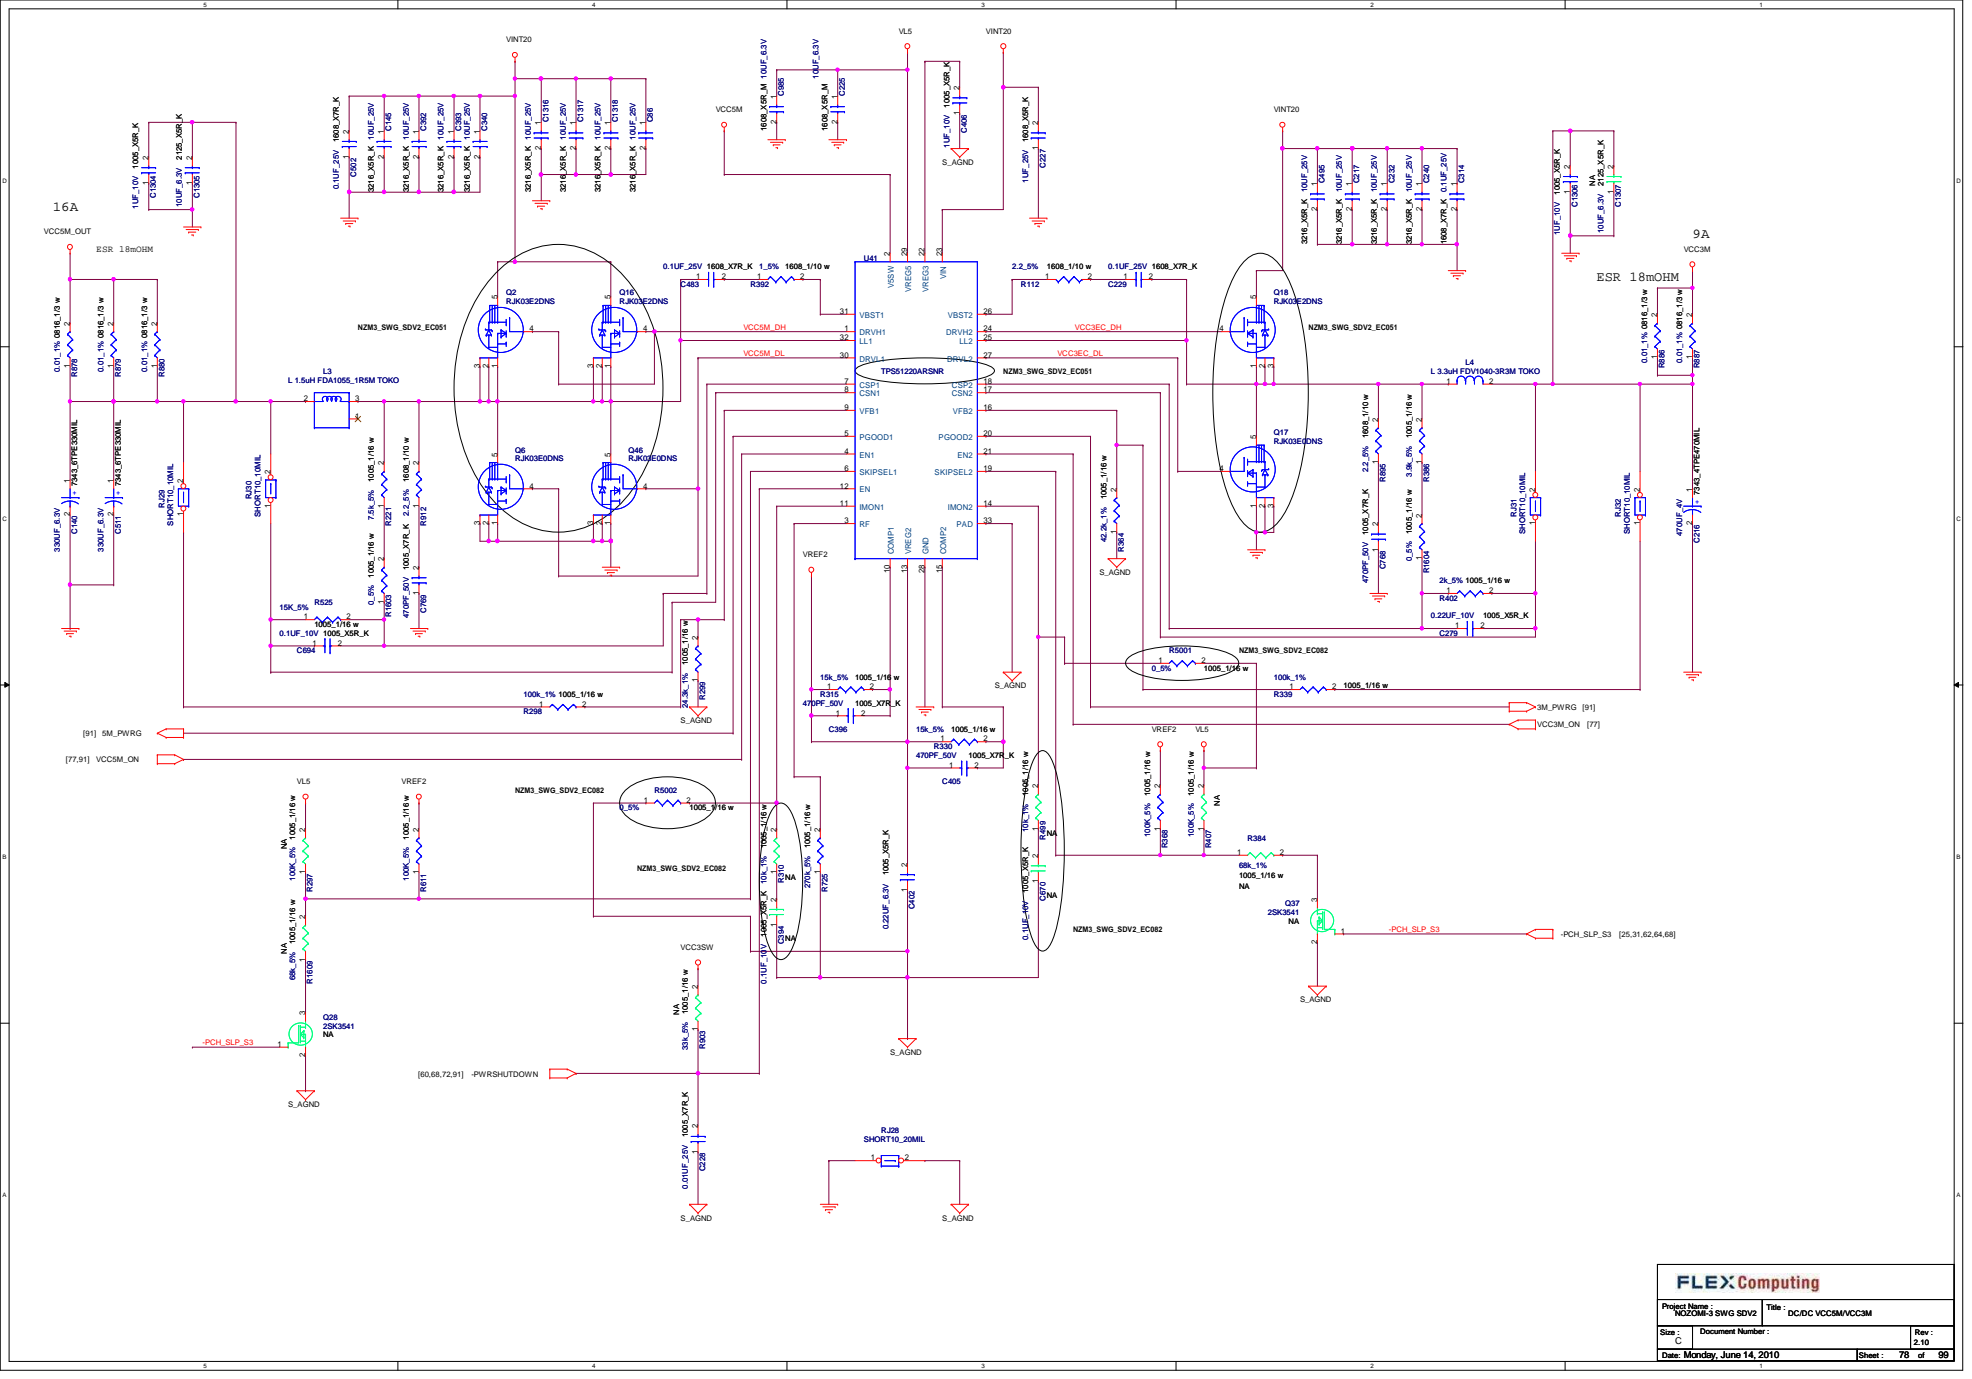
[picture p132: page 78]

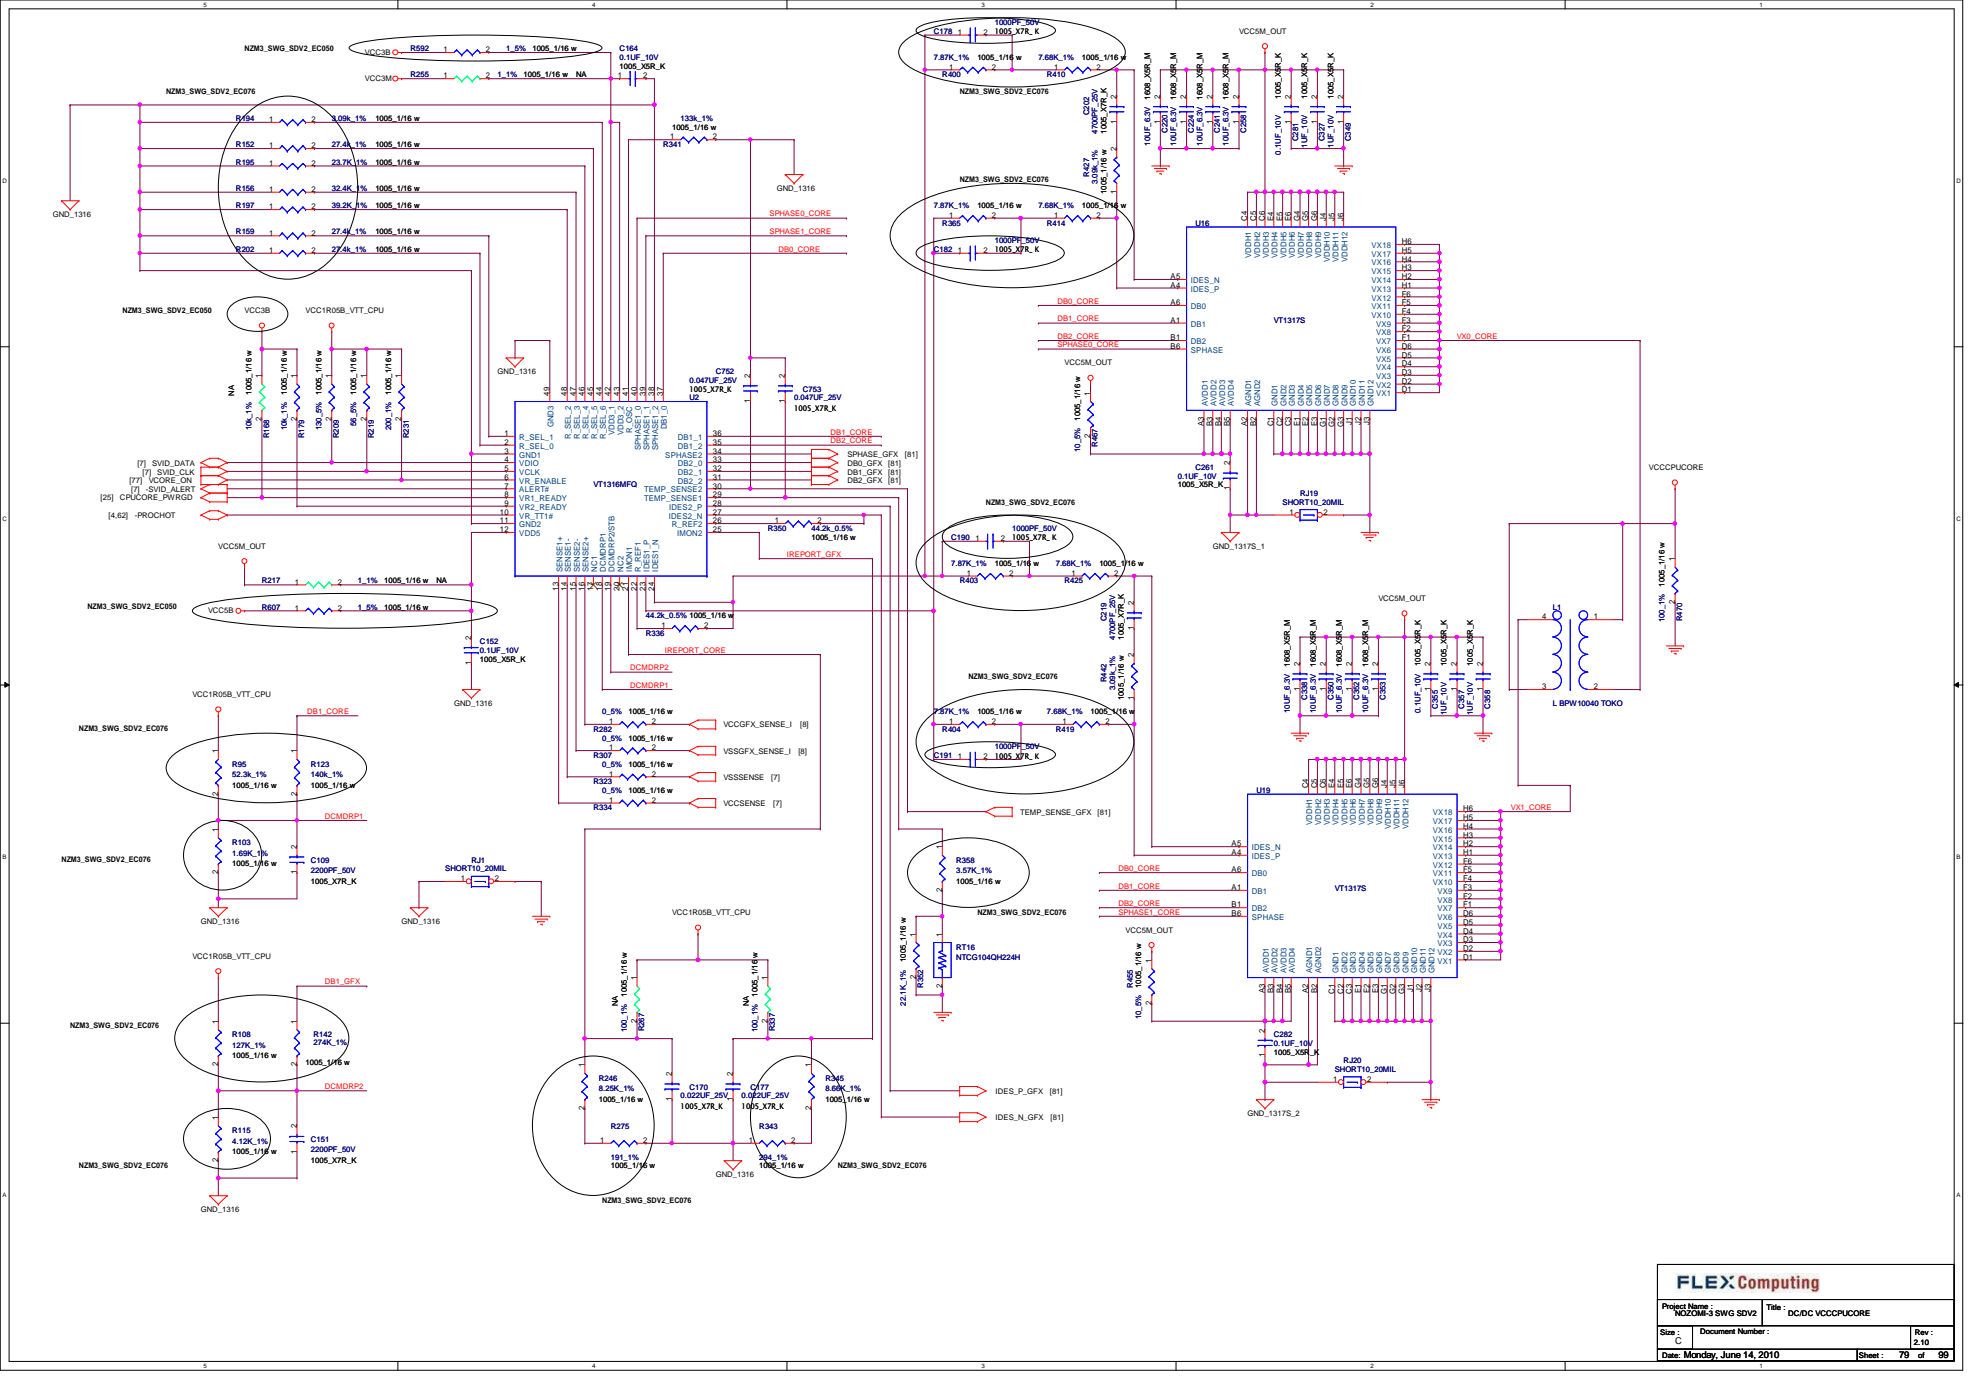
[picture p133: page 79]

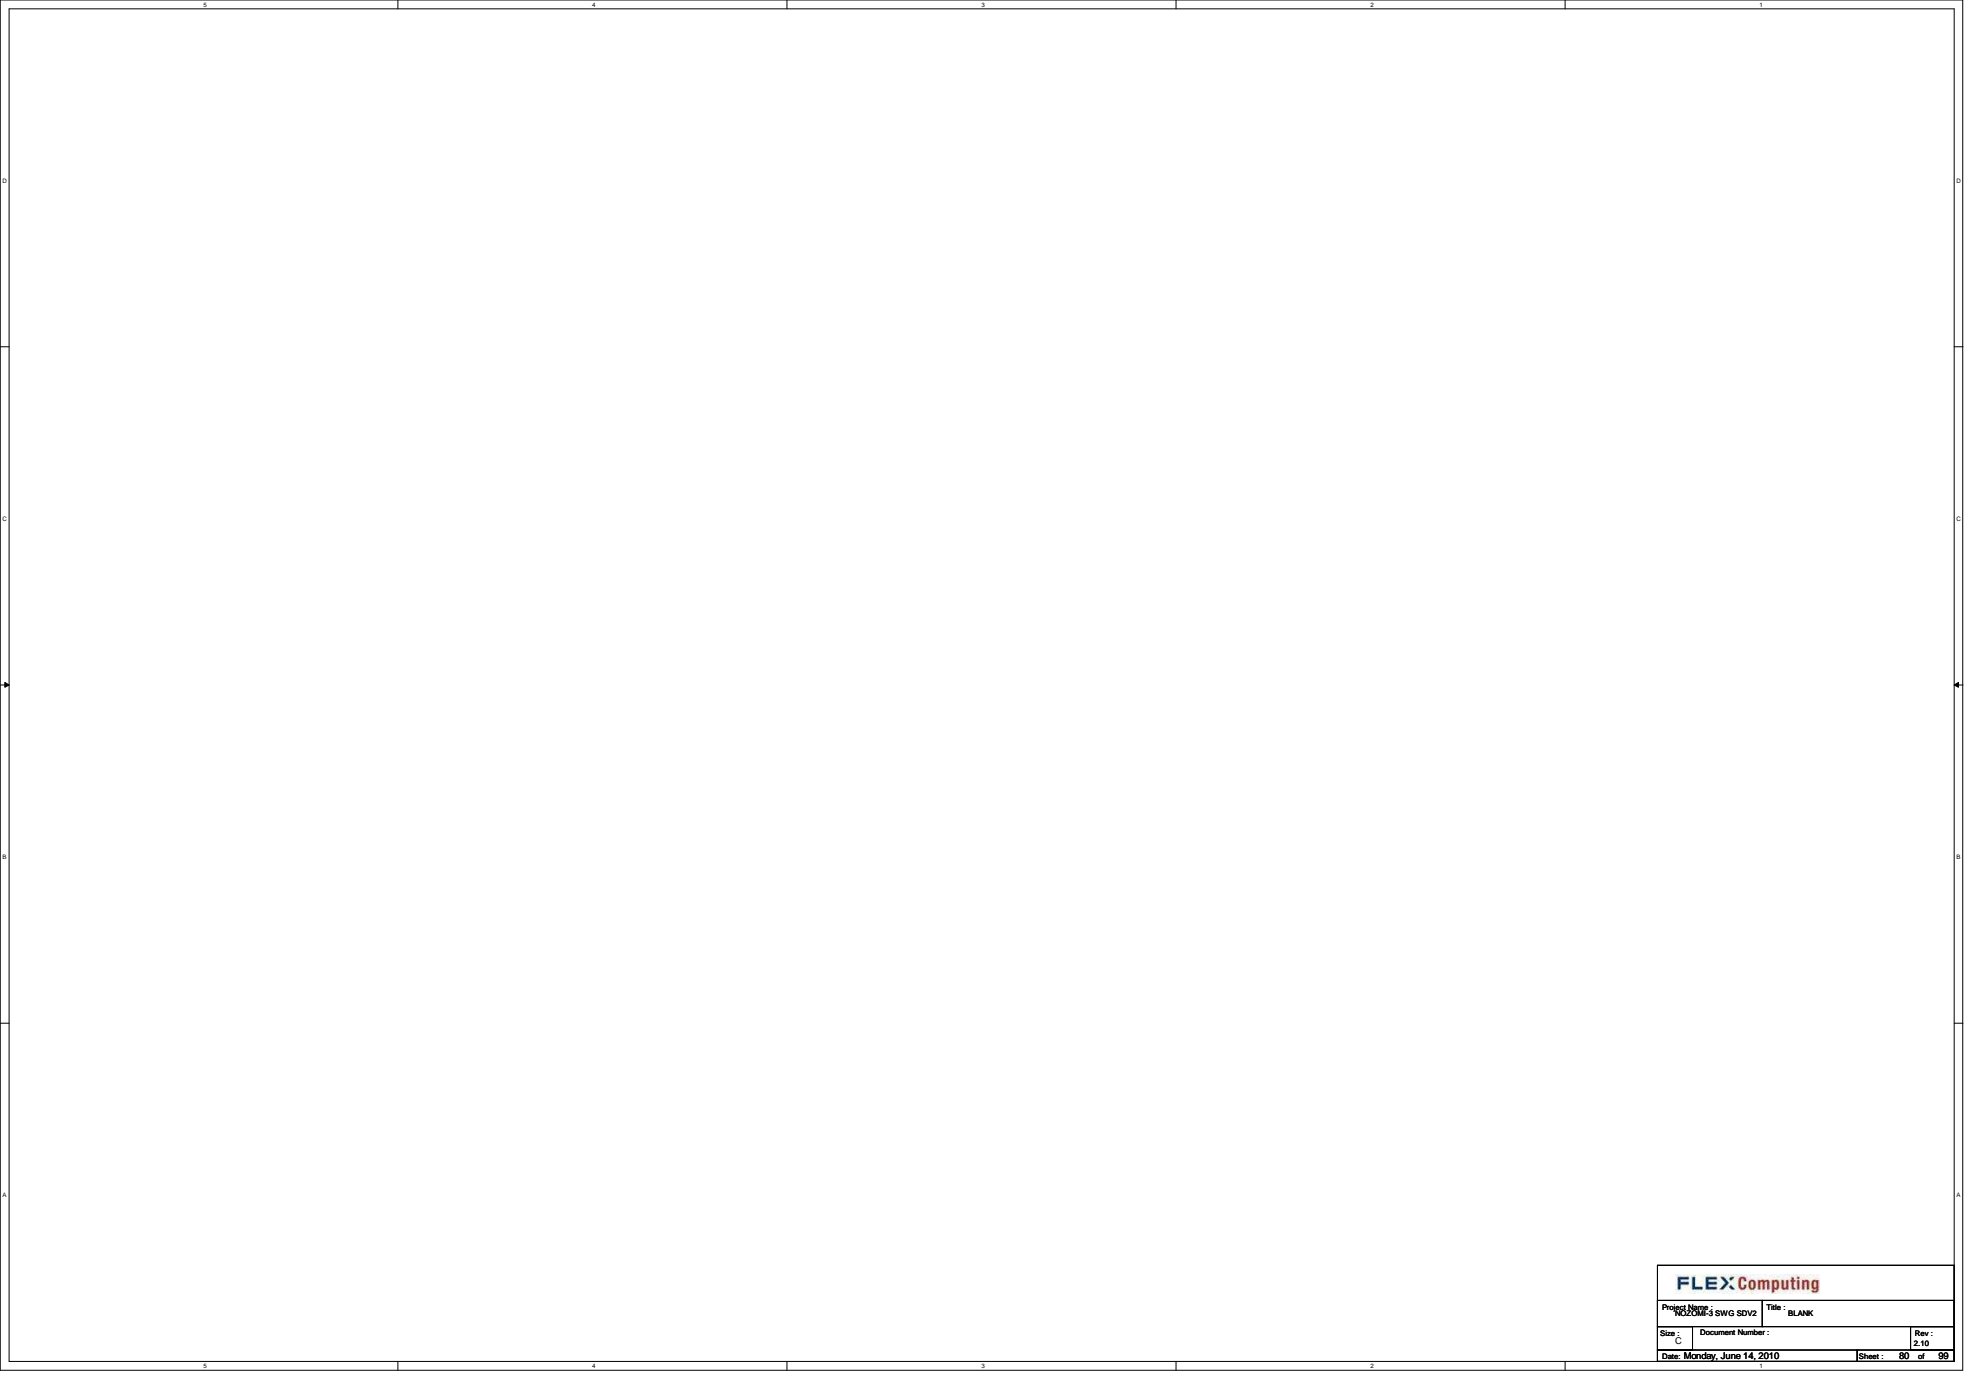
[picture p134: page 80]
Monday, June 14, 2010; NOZOMI-3 SWG SDV2; BLANK

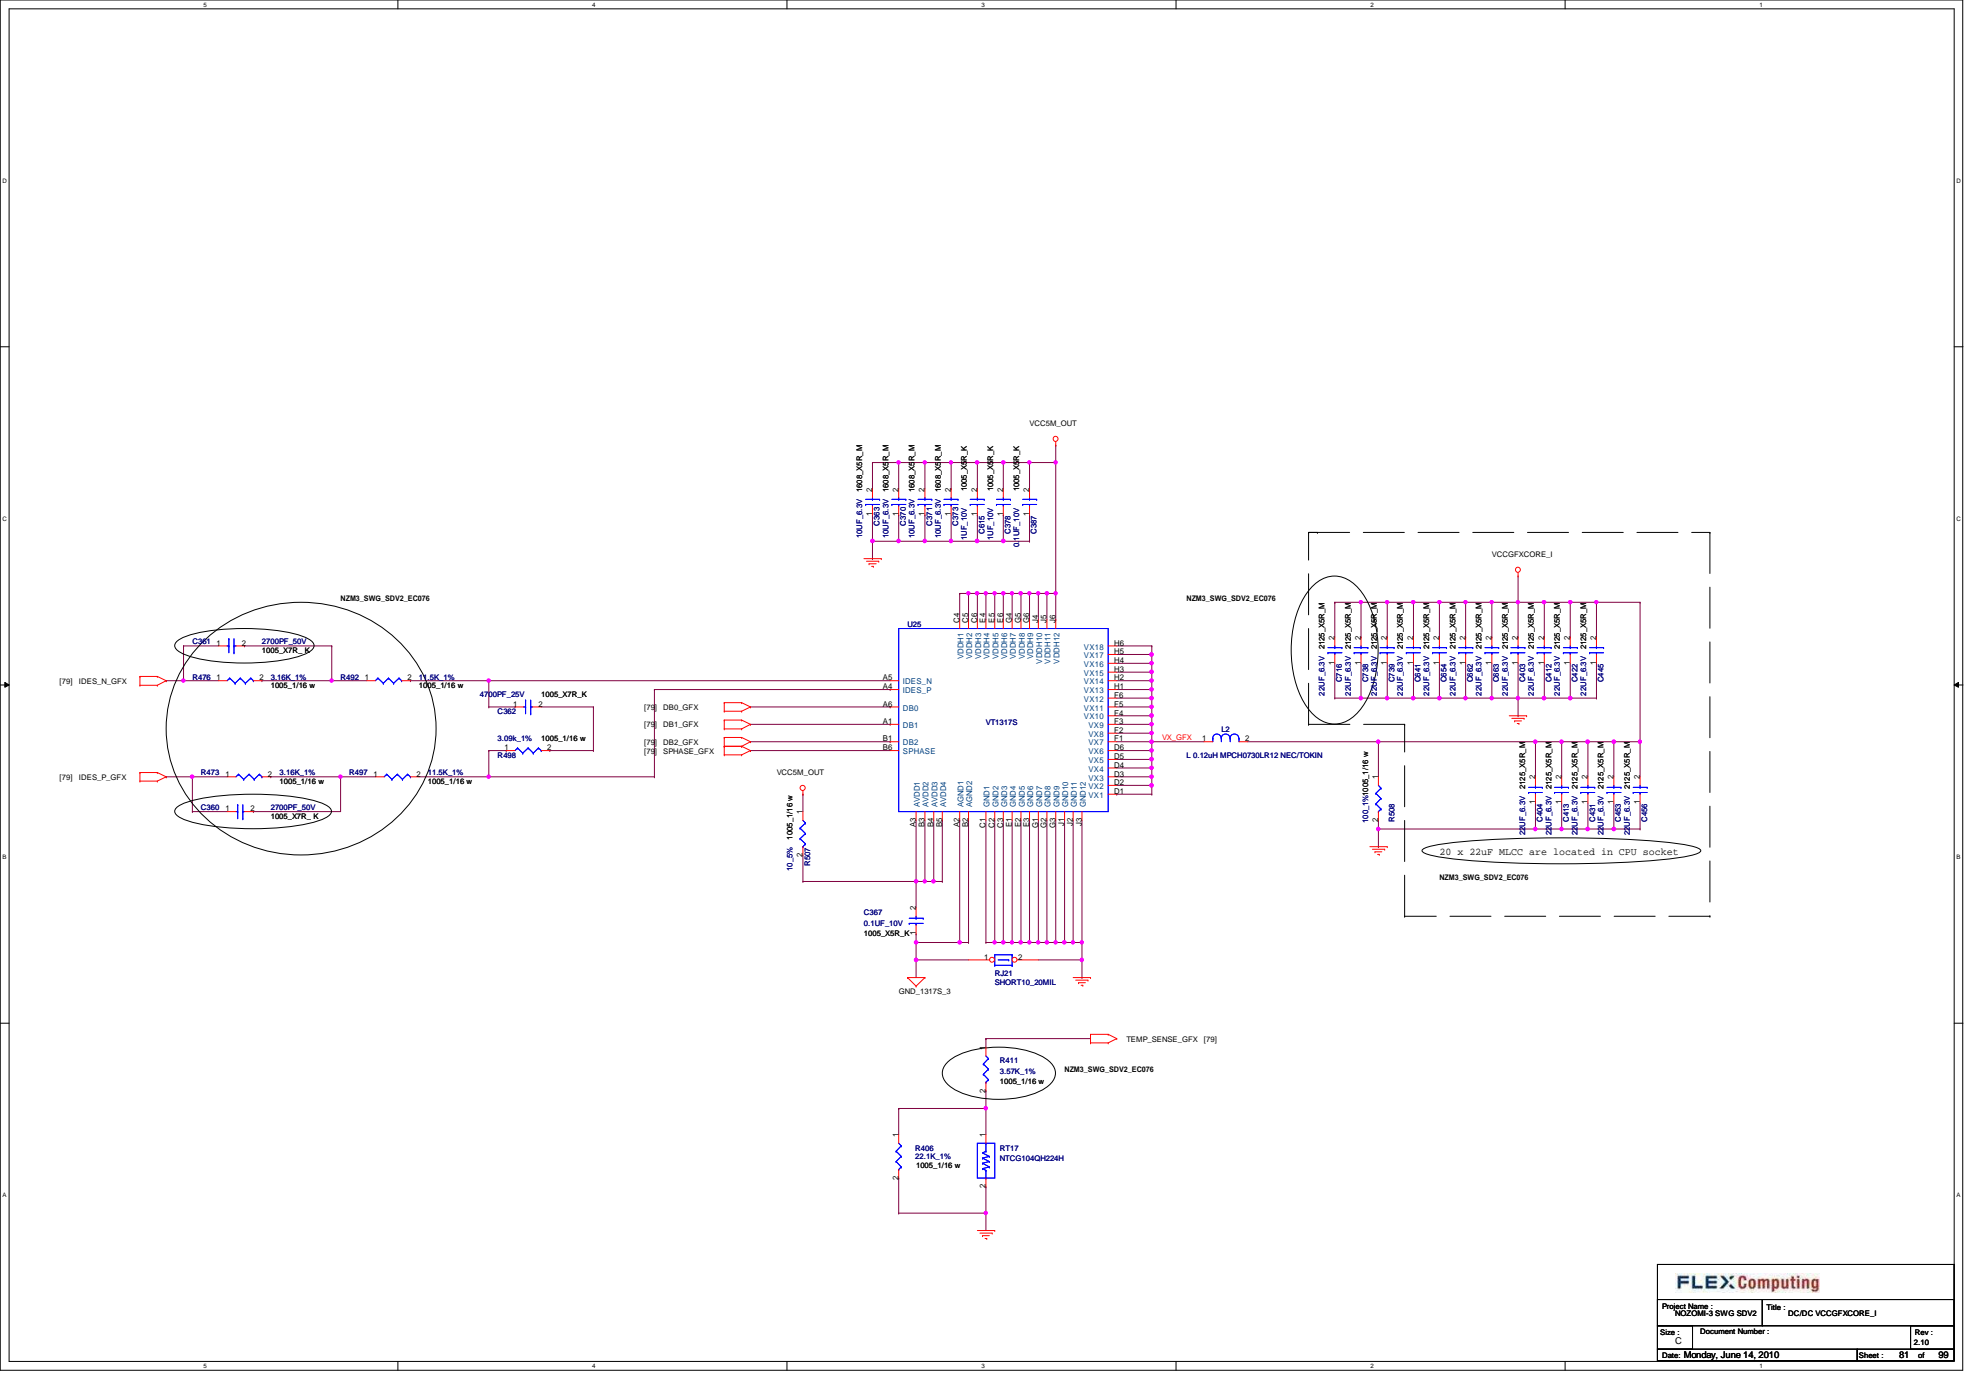
[picture p135: page 81]

20 x 22uF MLCC are located in CPU socket

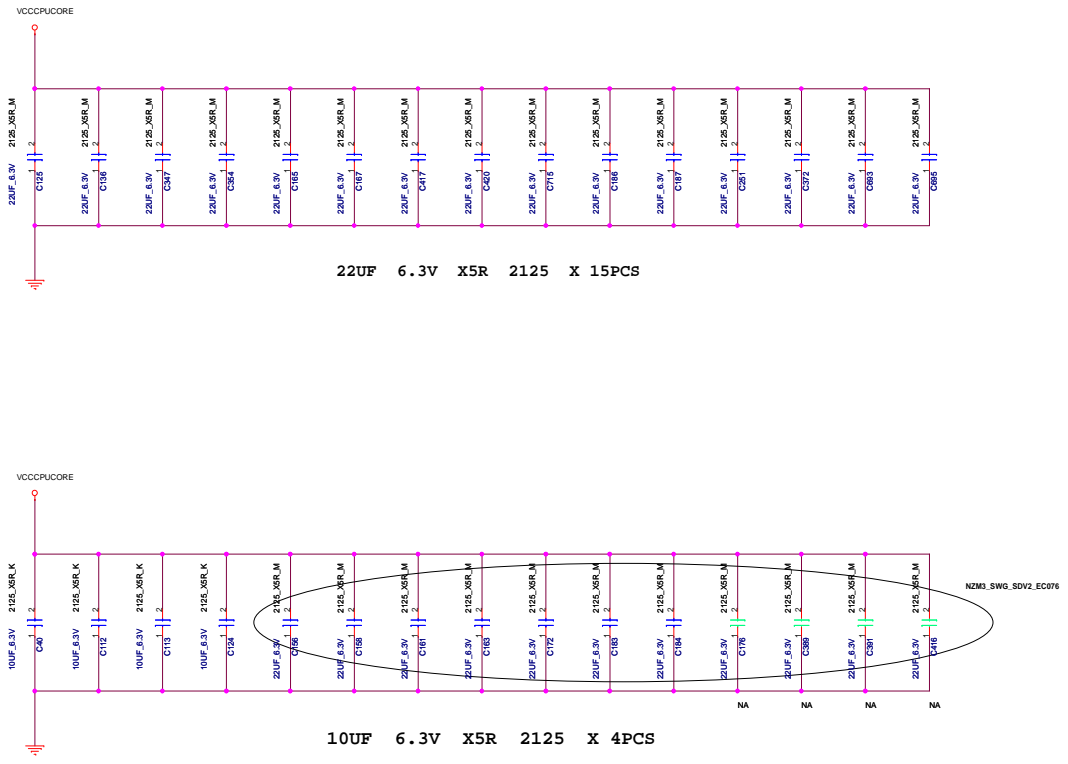
[picture p136: page 82]

N10X

### VID<6..0>

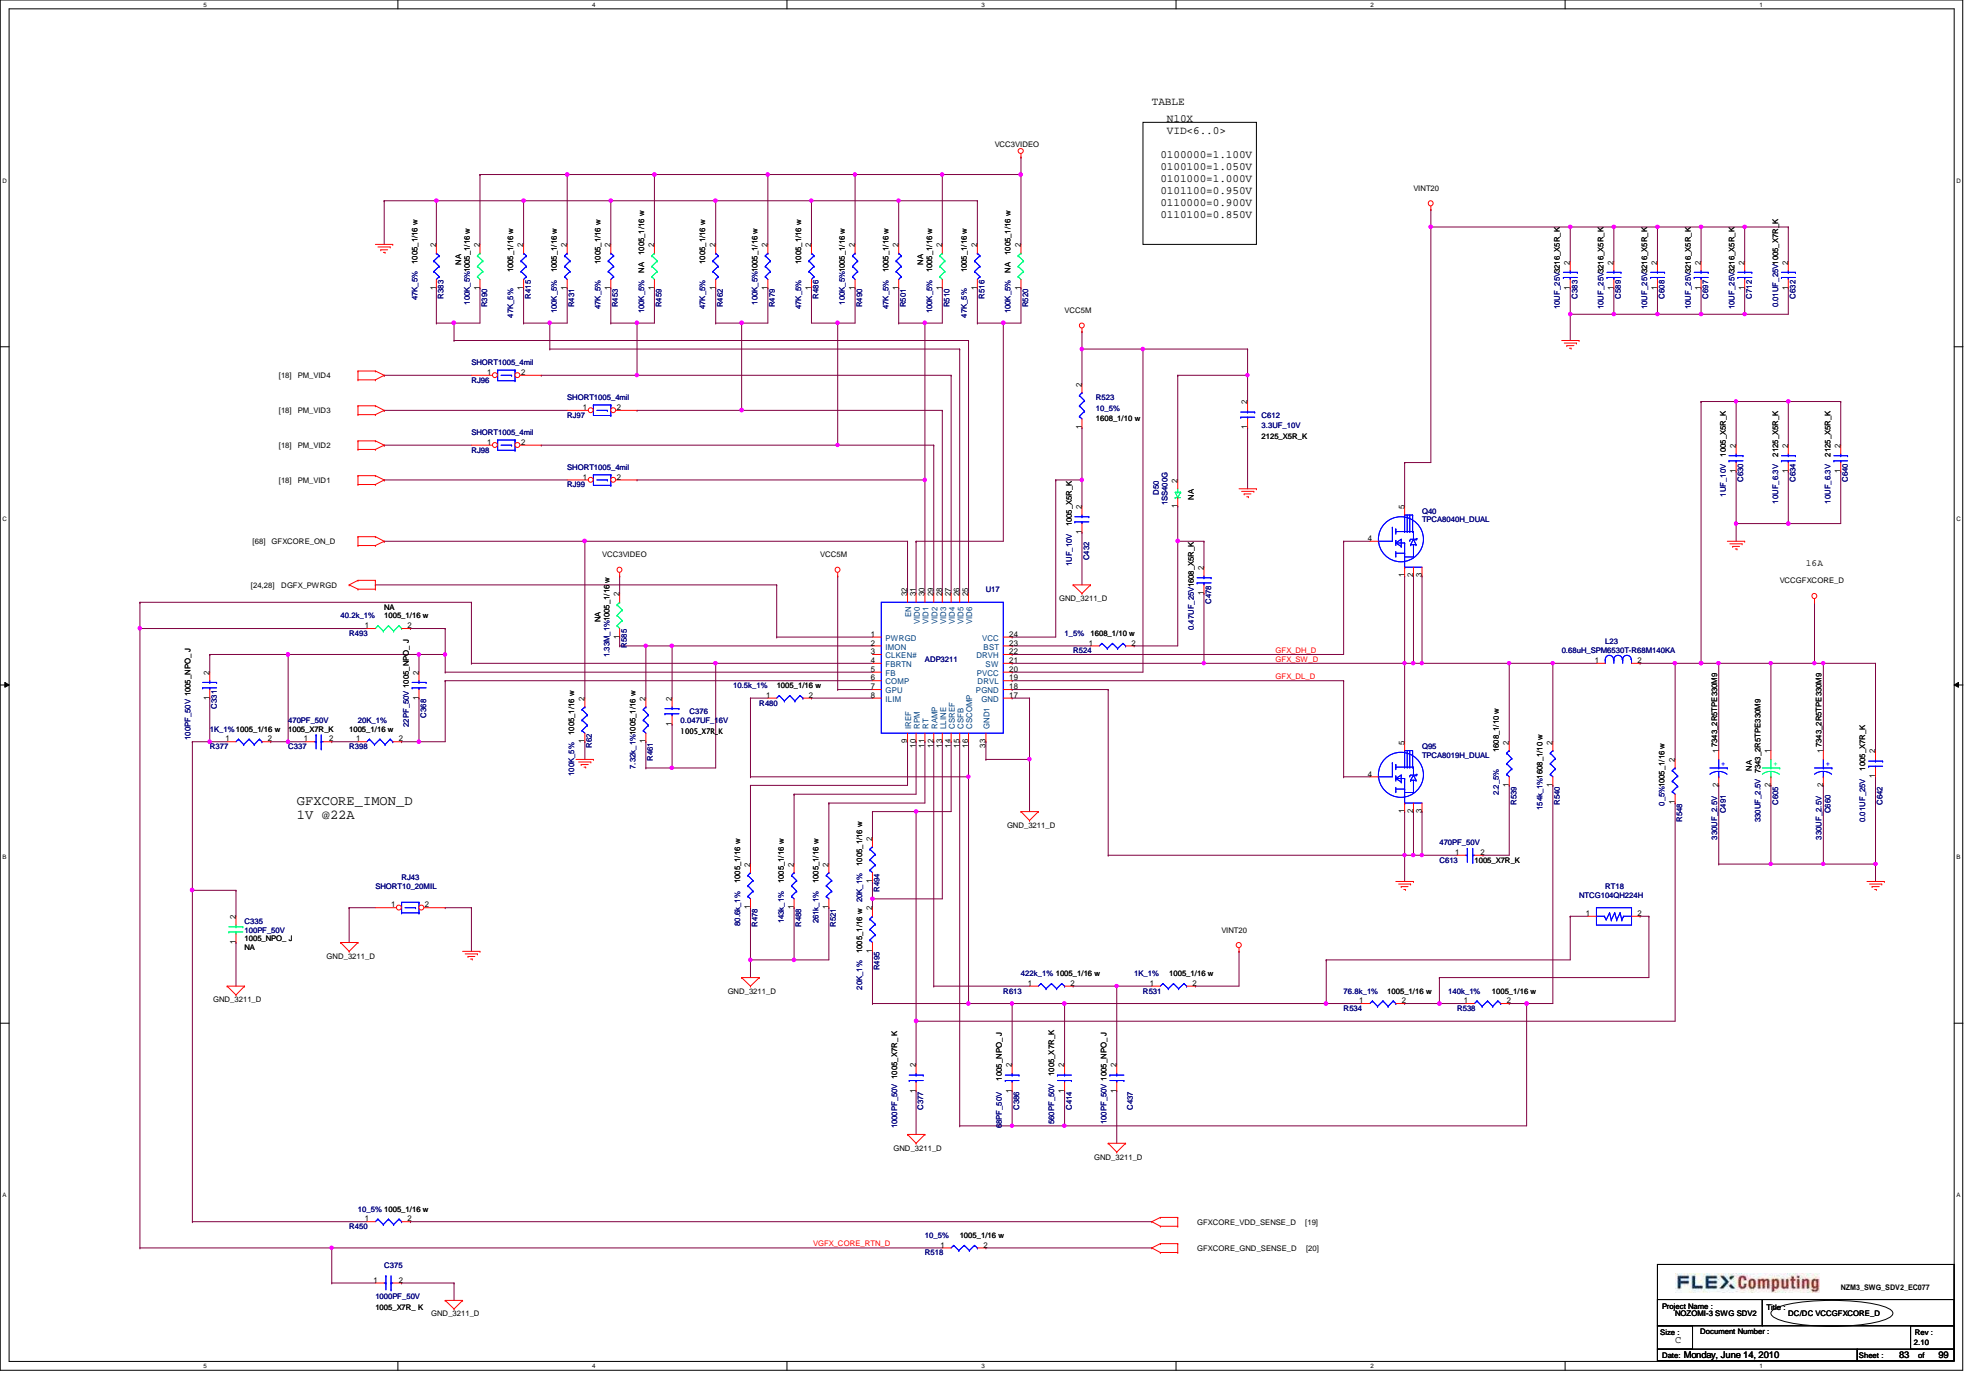
[picture p137: page 83]

GND 17 PGND 18 DRVL 19 PVCC 20 SW 21 DRVH 22 BST 23 VCC 24

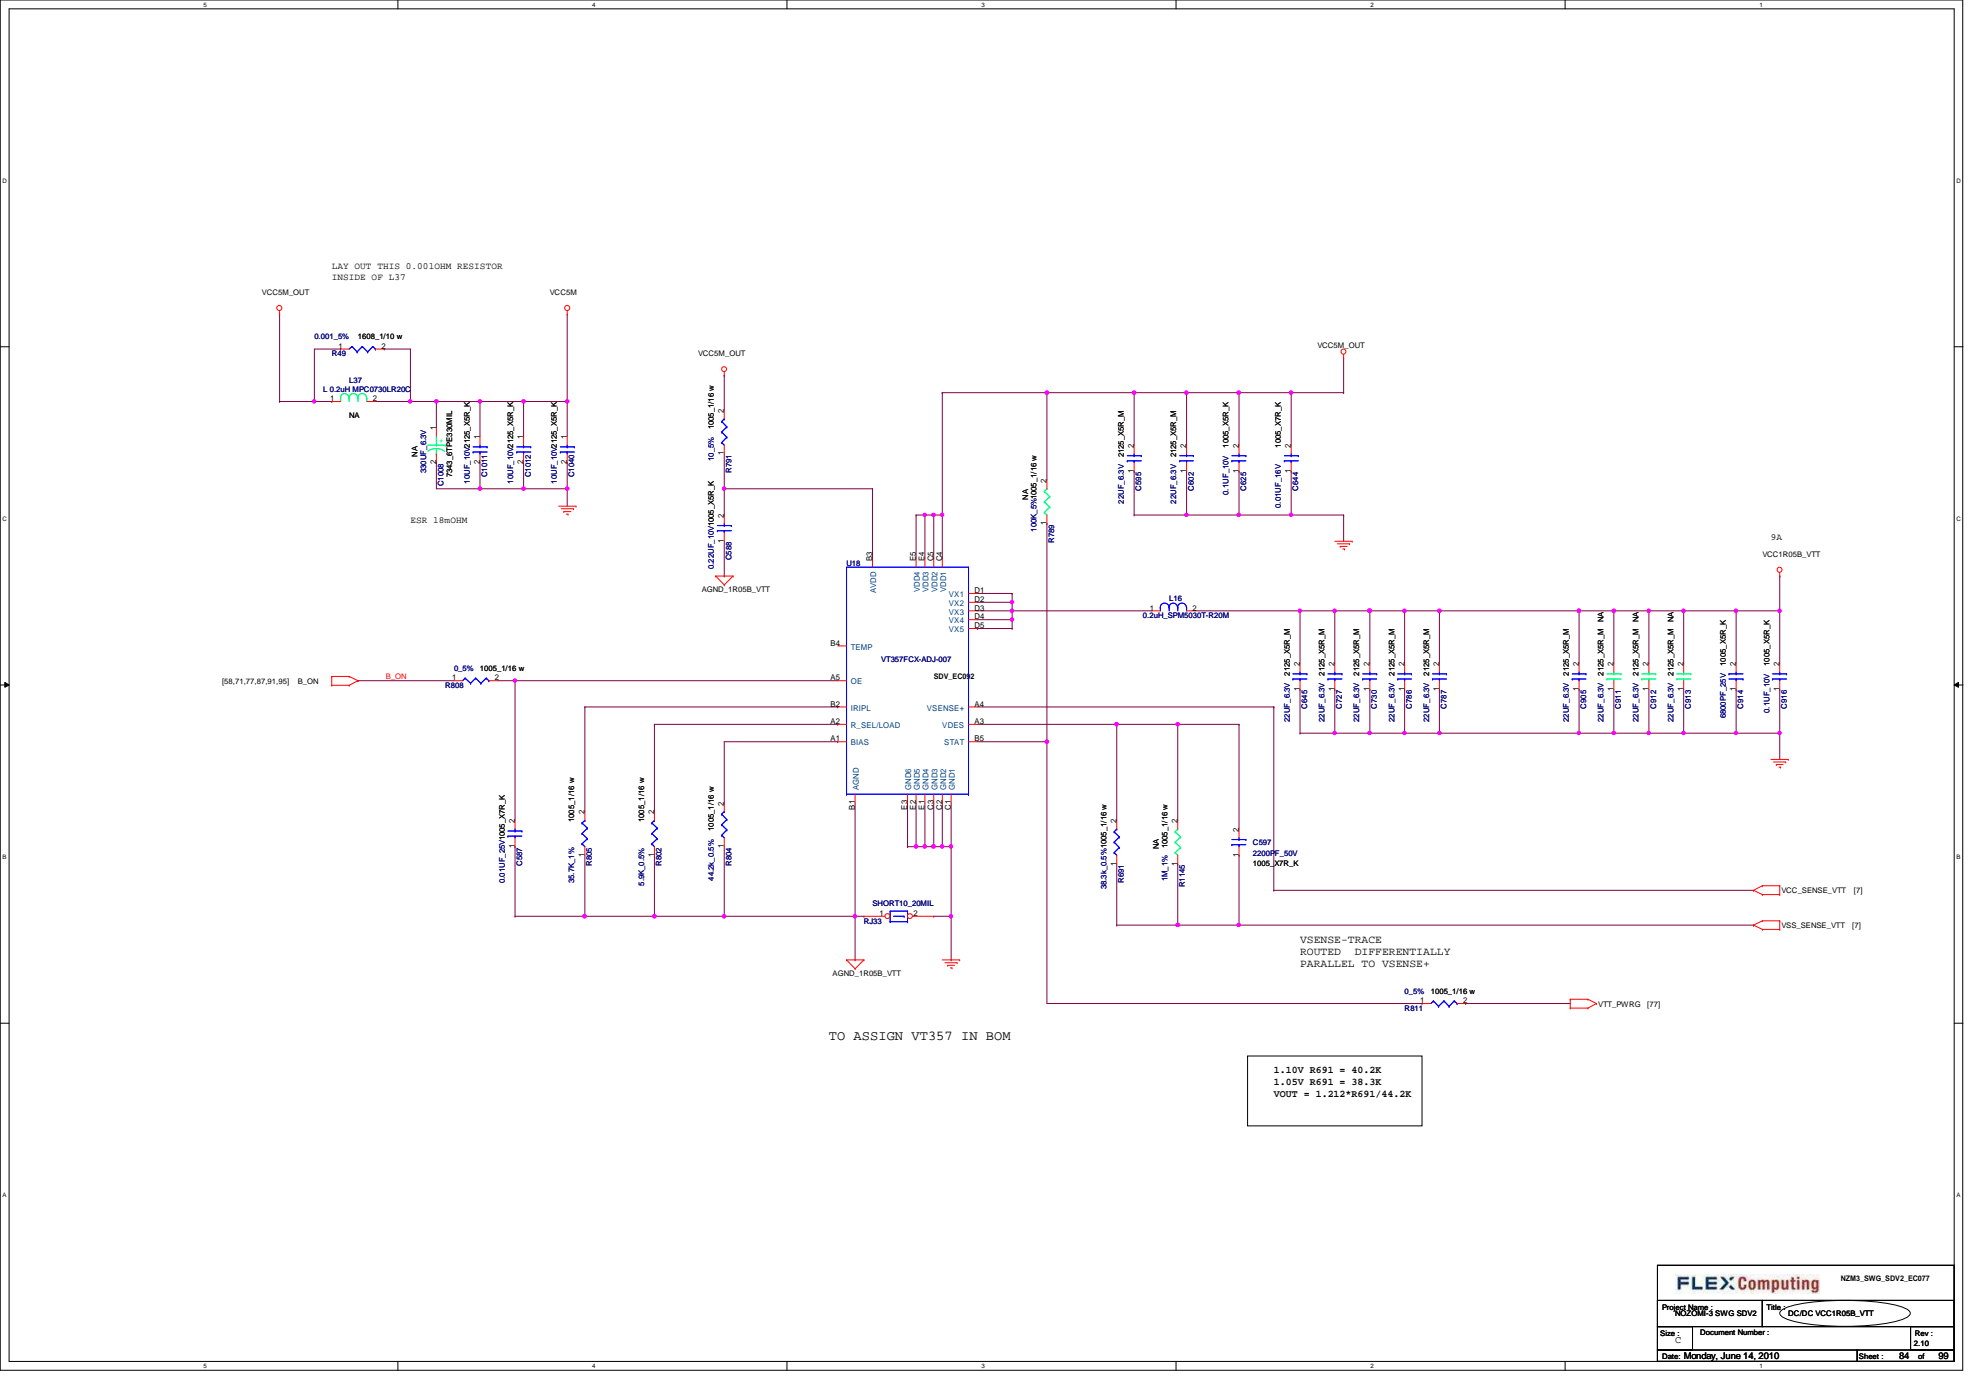
[picture p138: page 84]

LAY OUT THIS 0.001OHM RESISTOR
INSIDE OF L37

TO ASSIGN VT357 IN BOM

10A

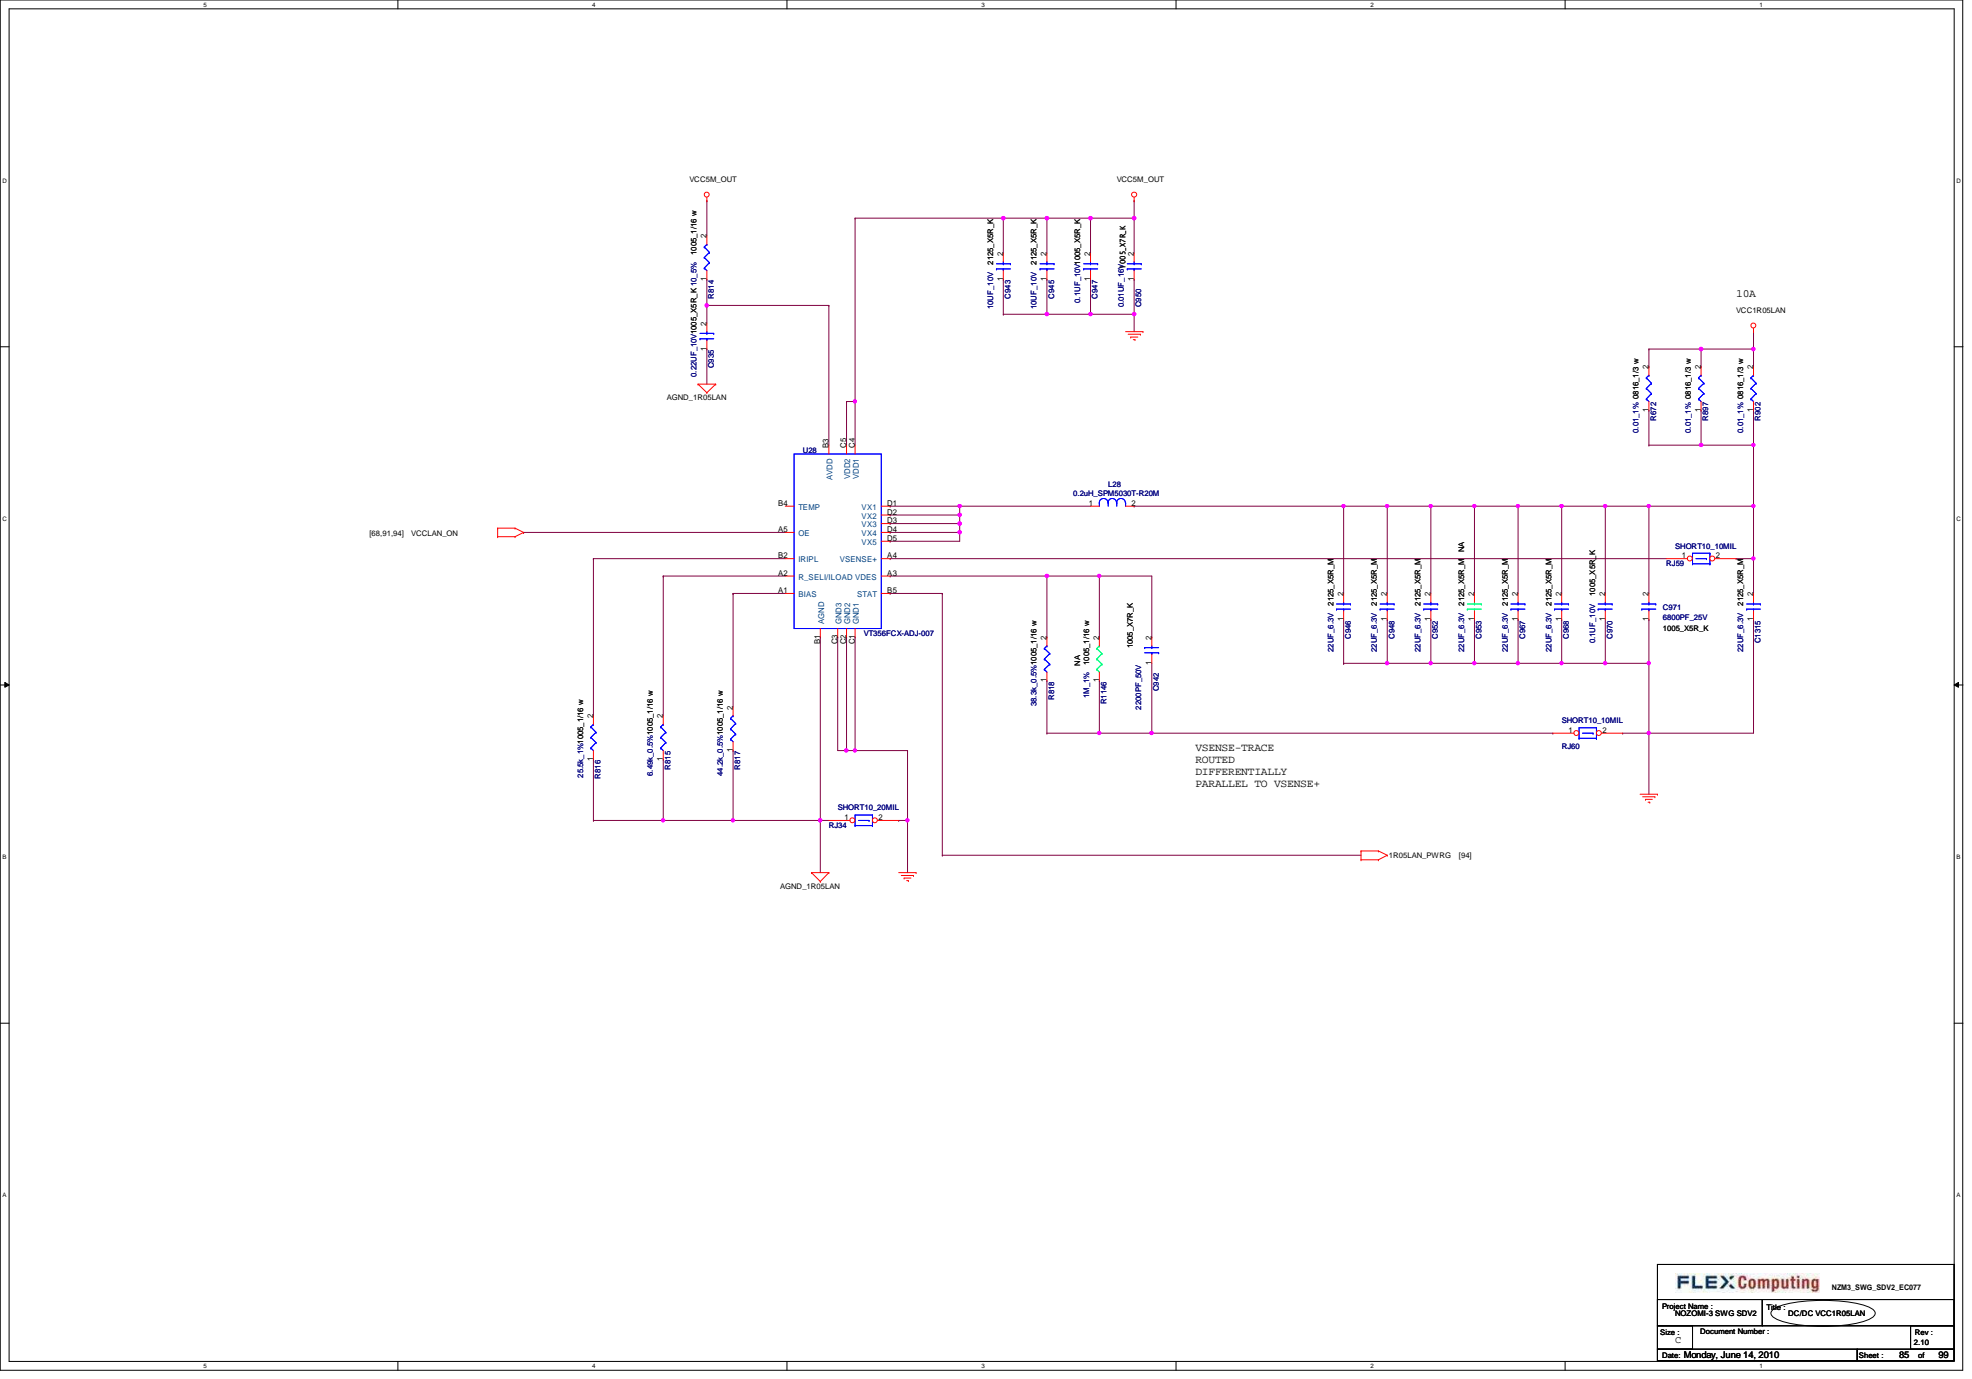
[picture p139: page 85]

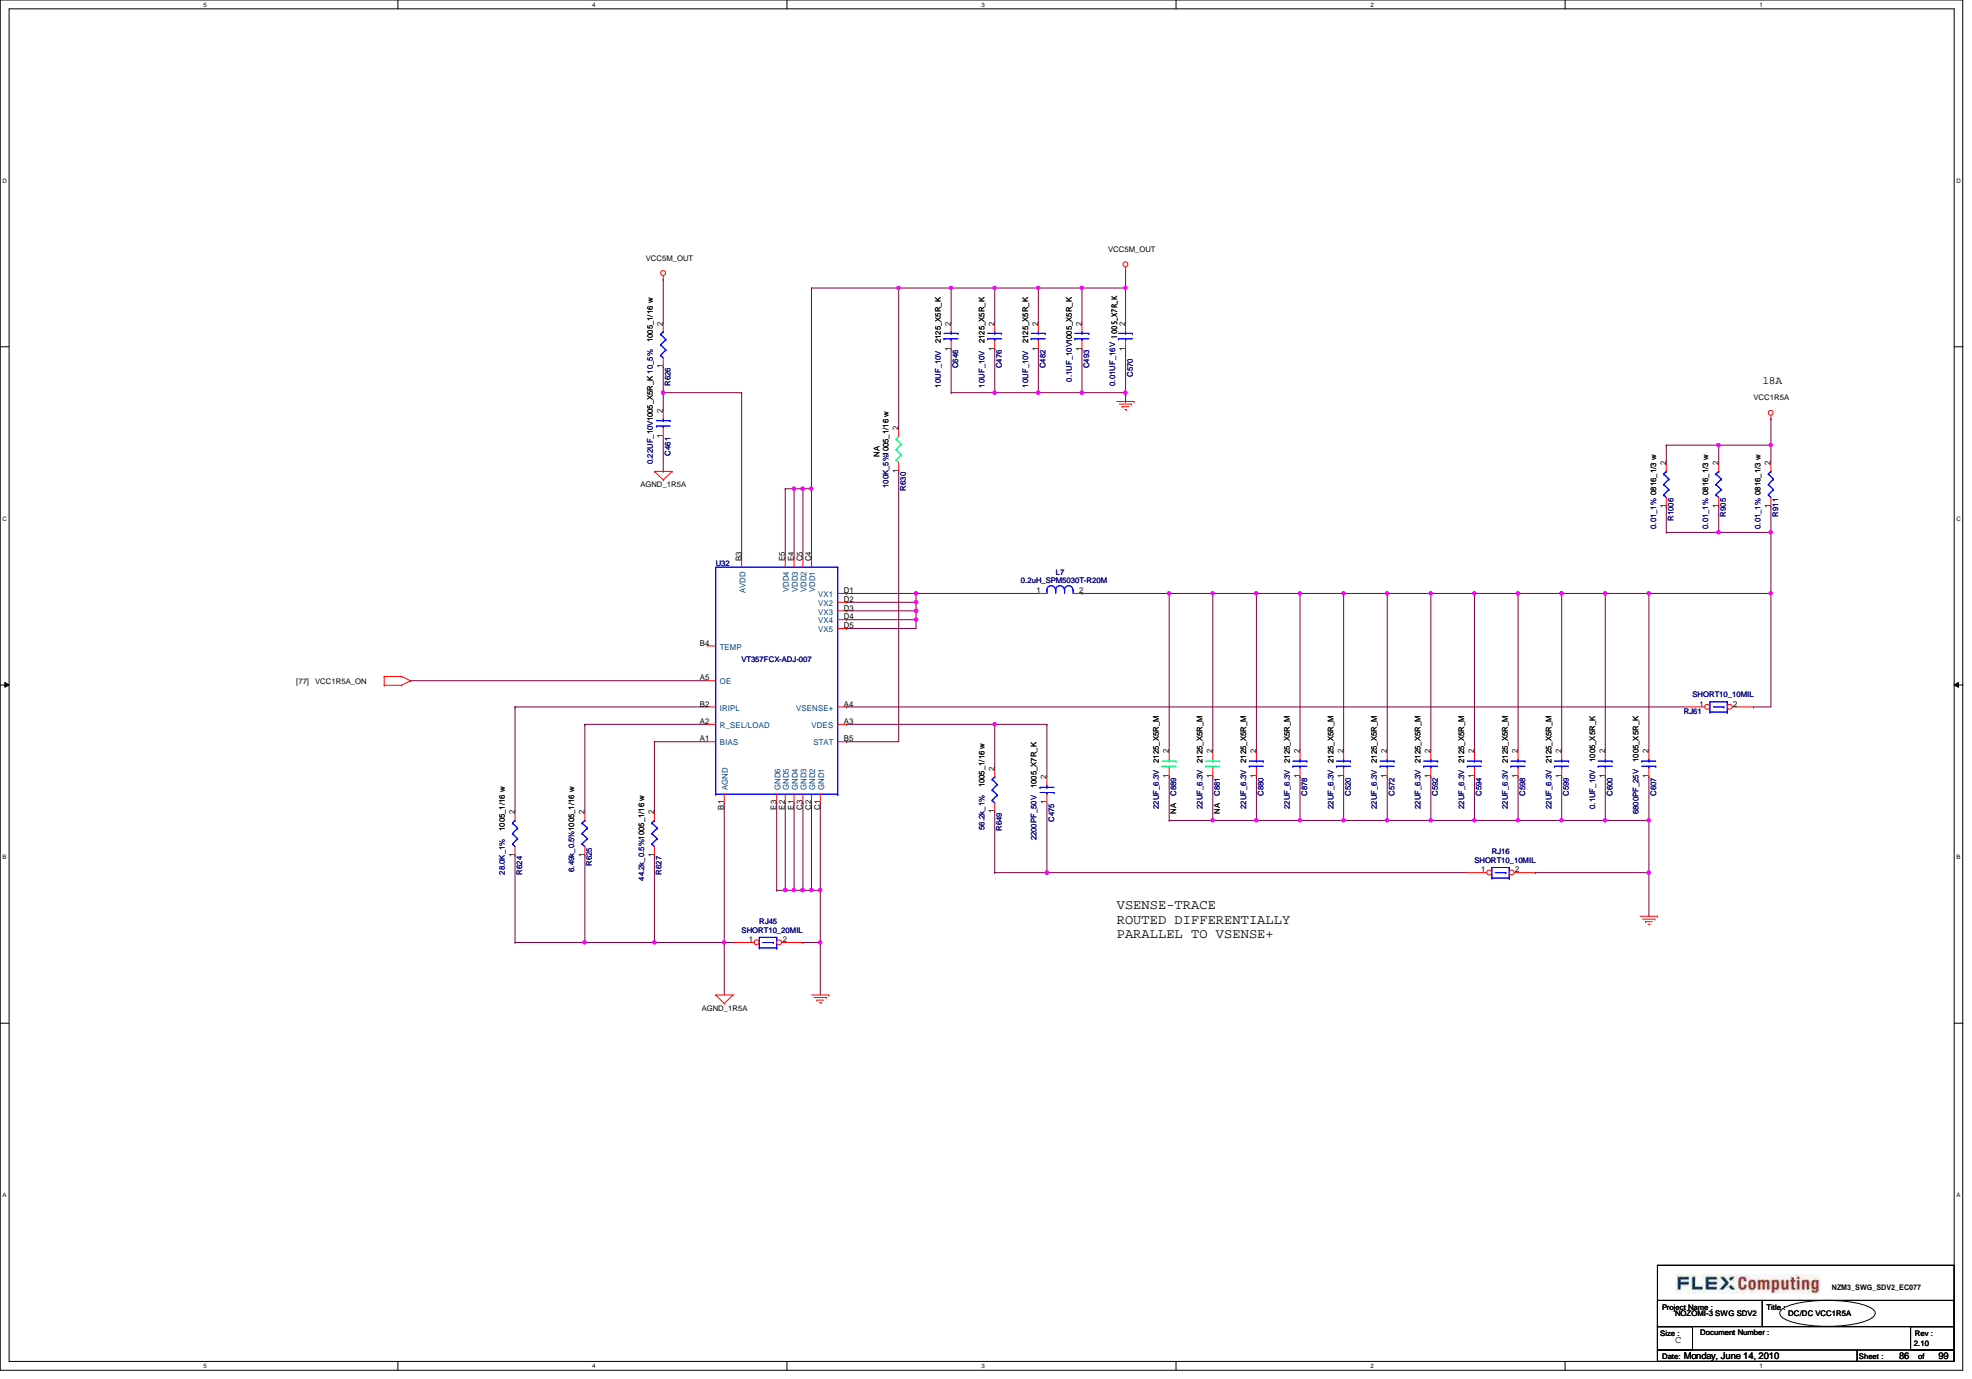
[picture p140: page 86]

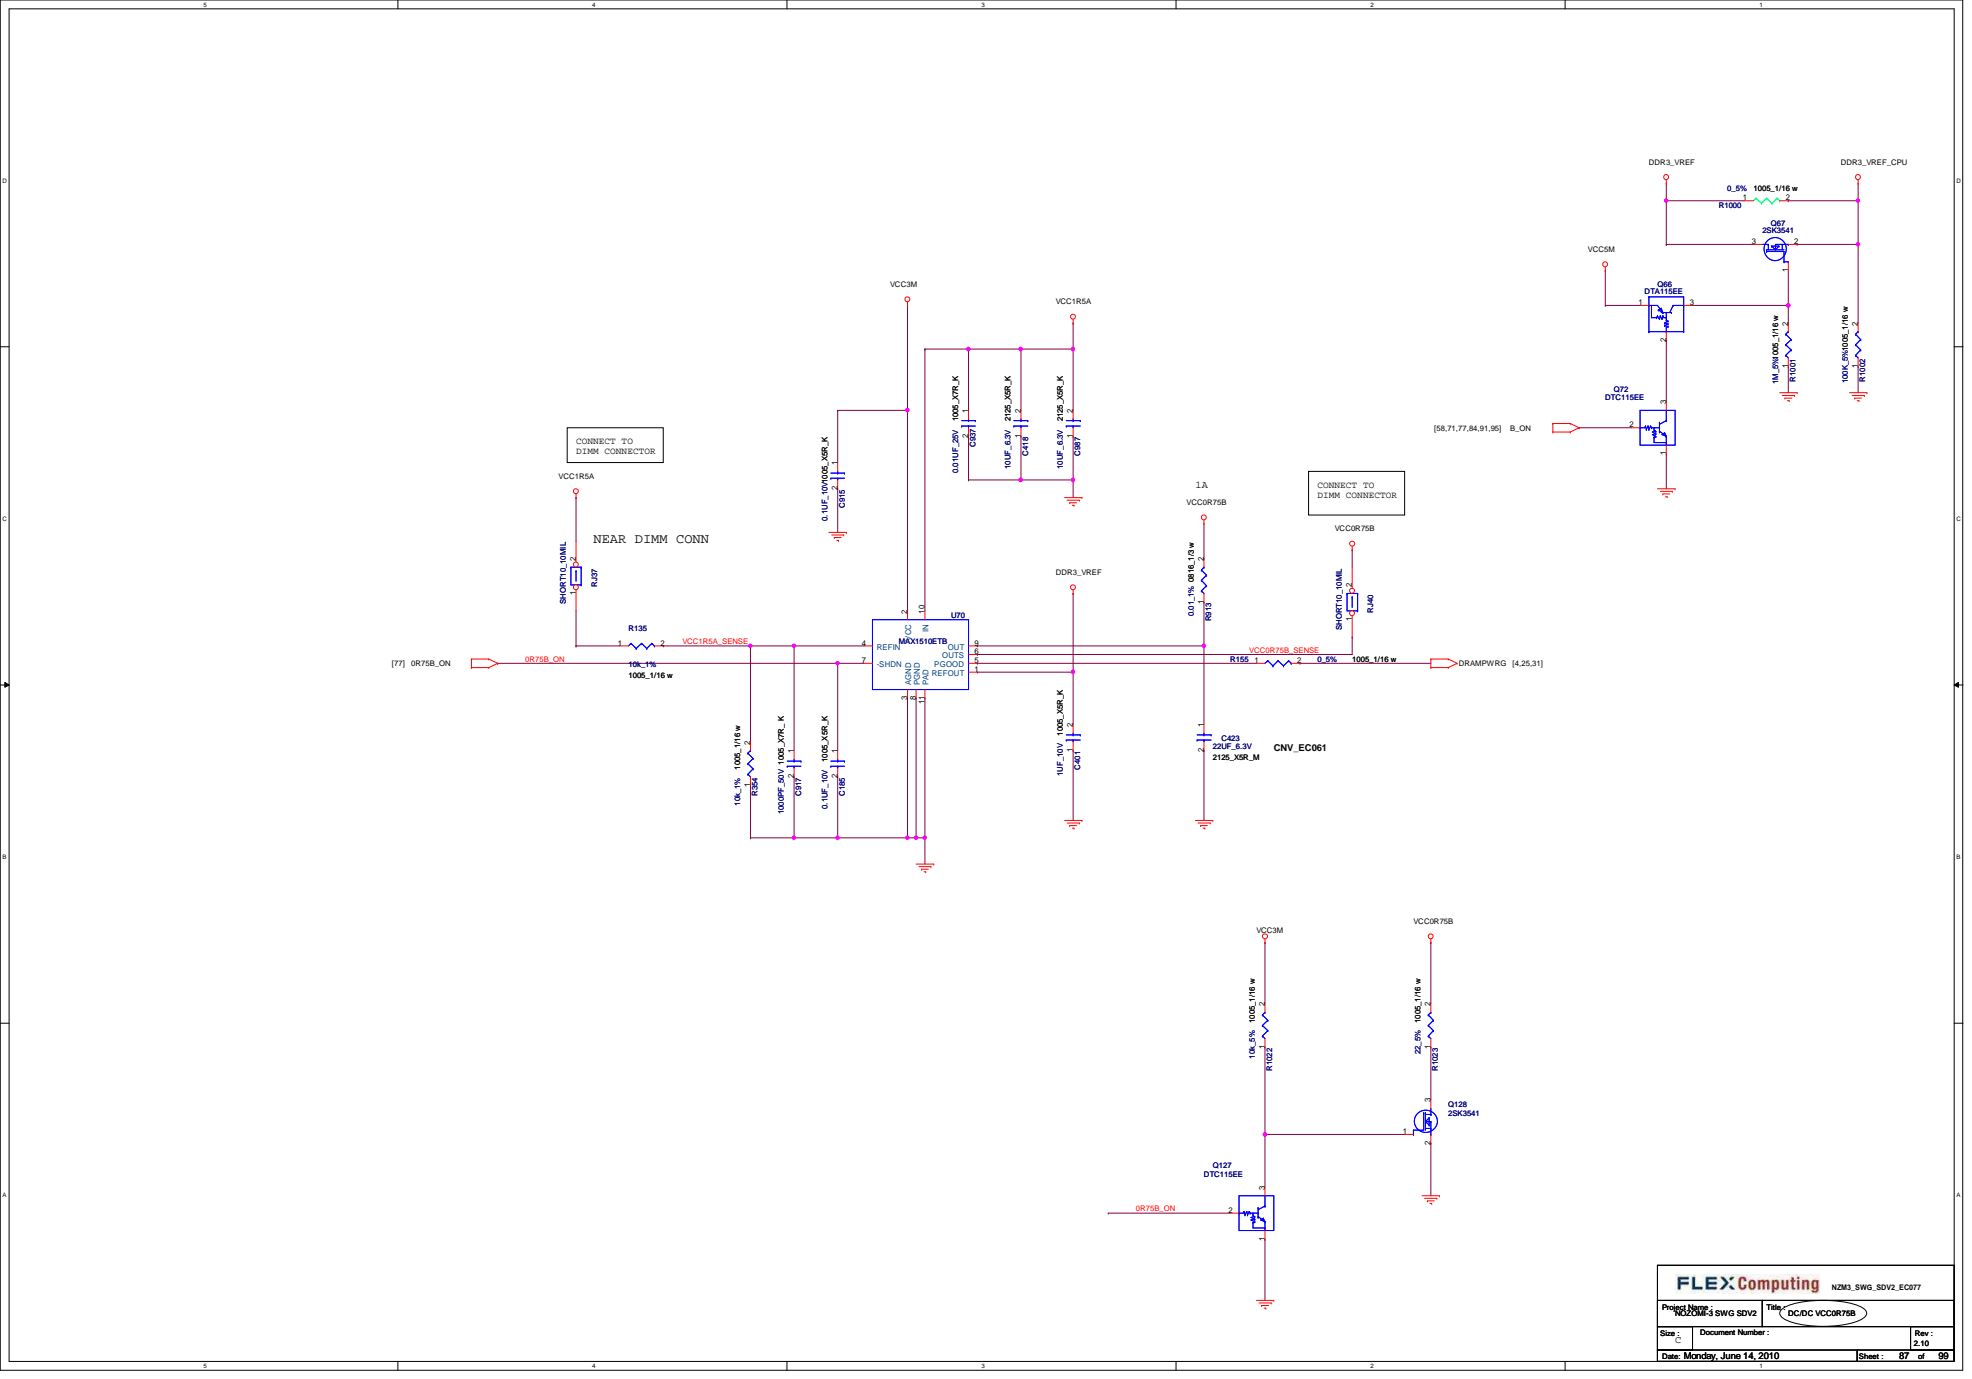
[picture p141: page 87]

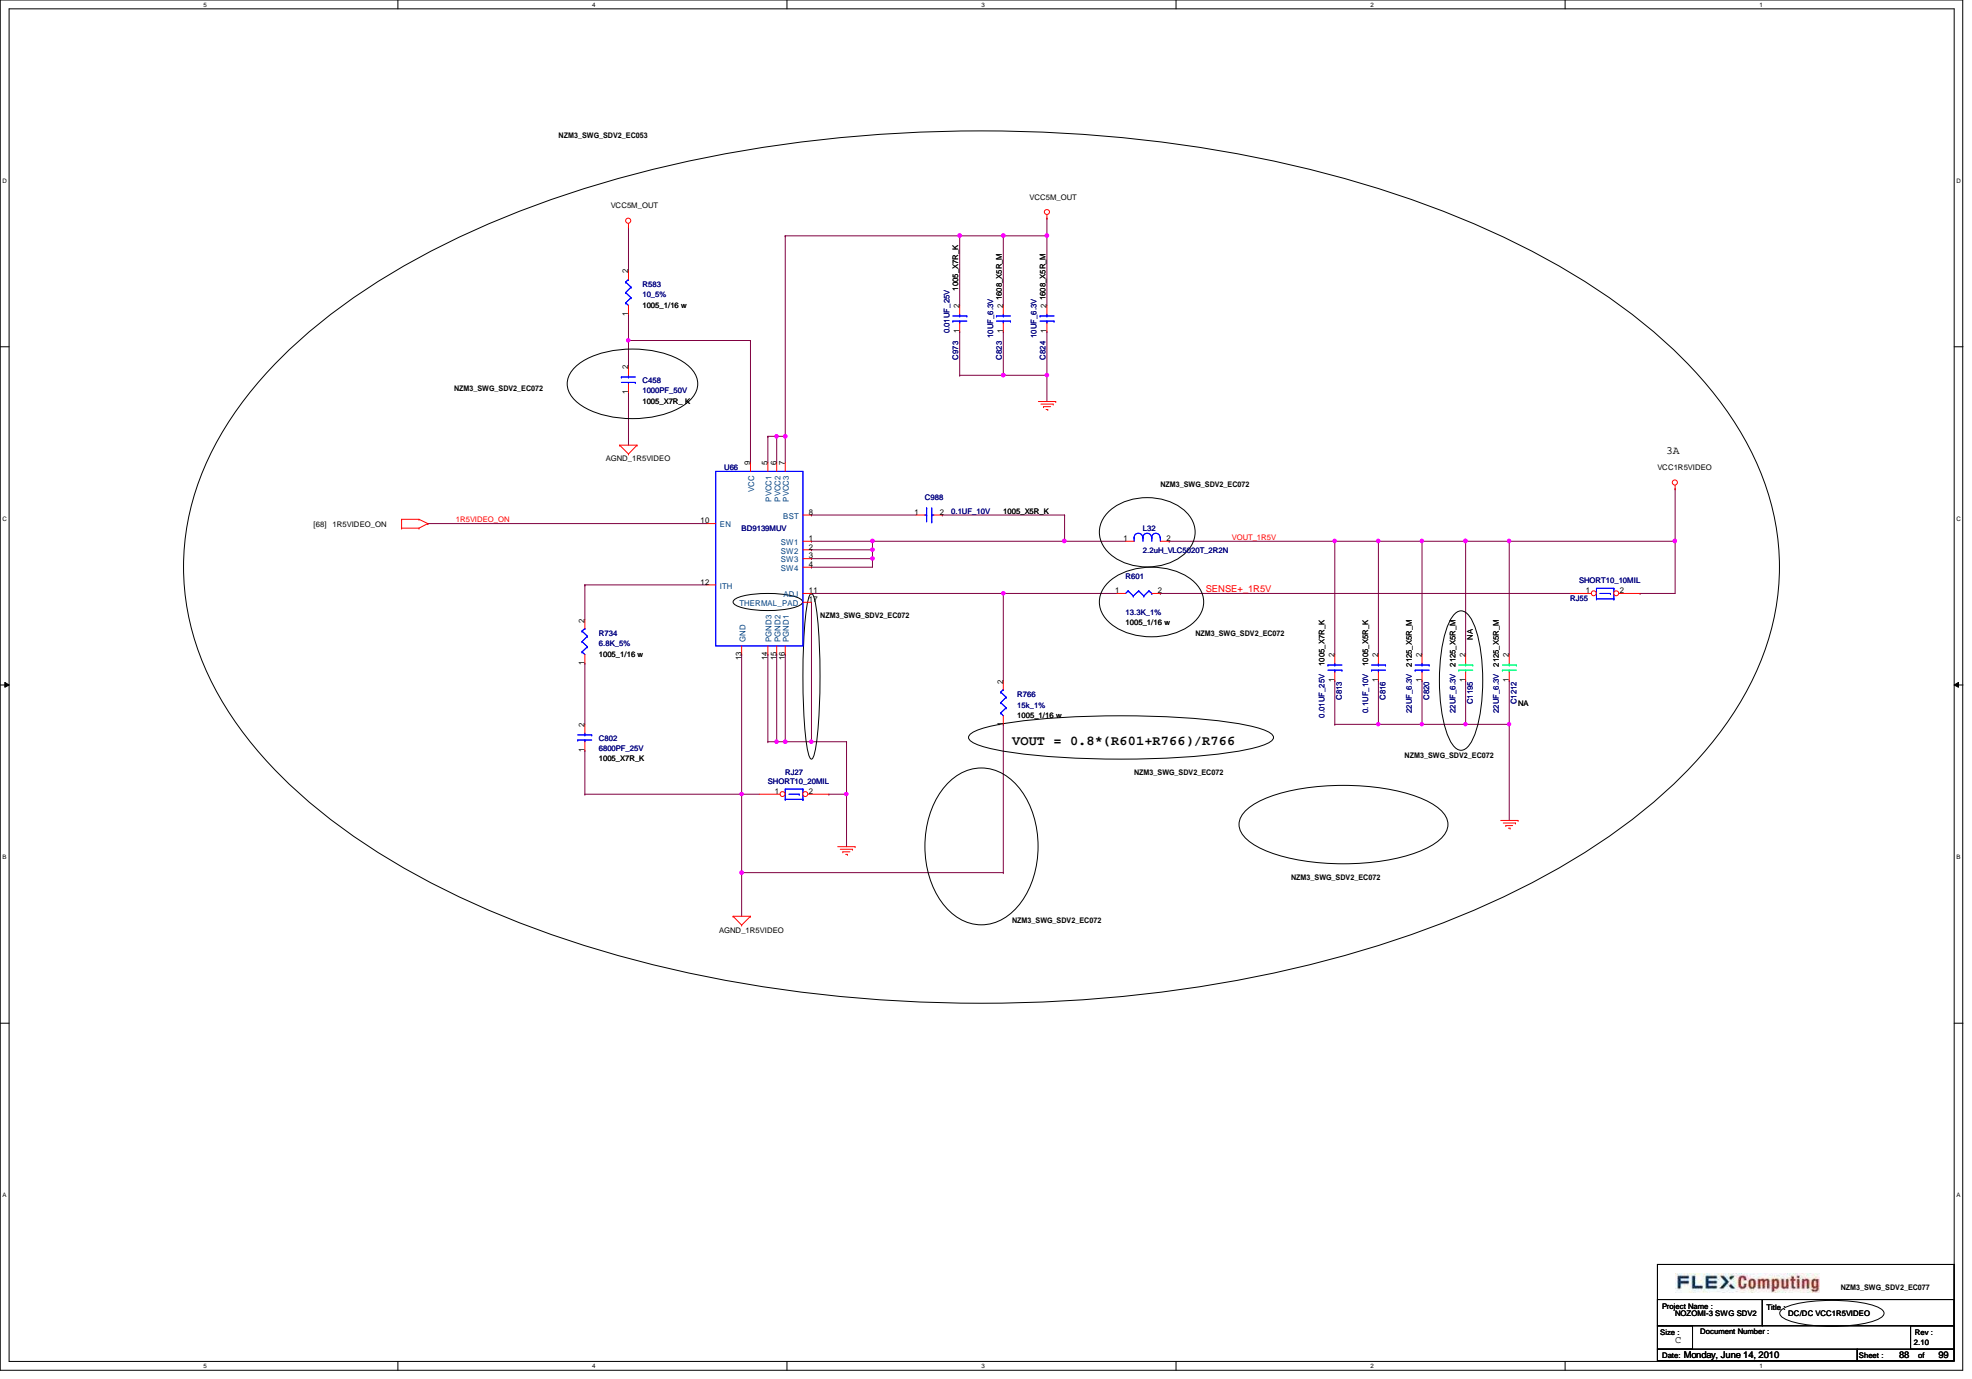
[picture p142: page 88]

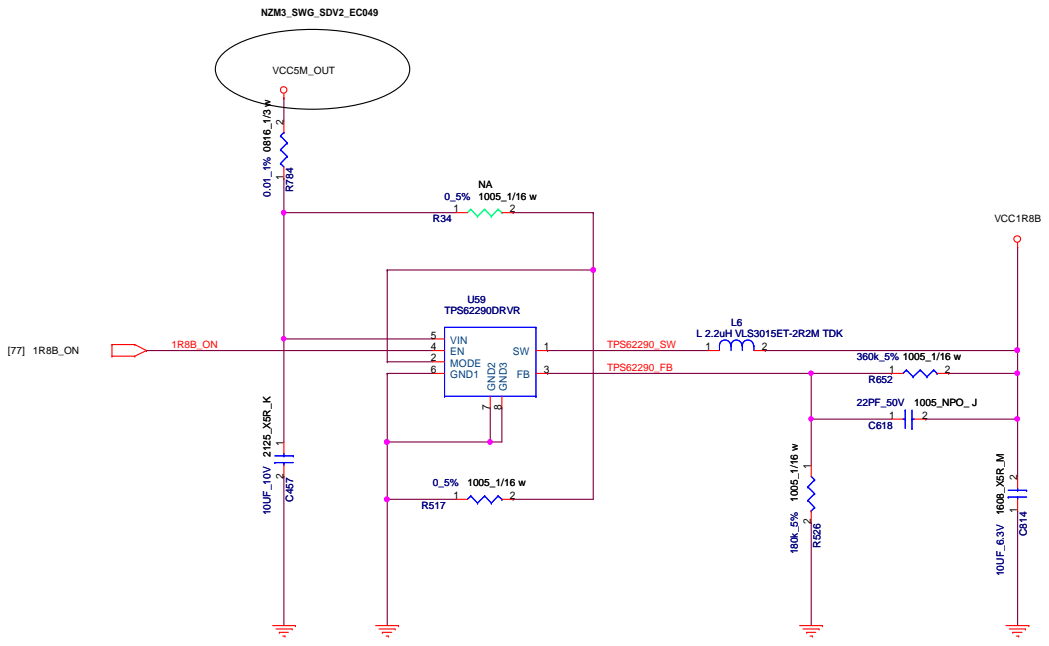
[picture p143: page 89]

### VCCSA=0.9V/0.8V

6A

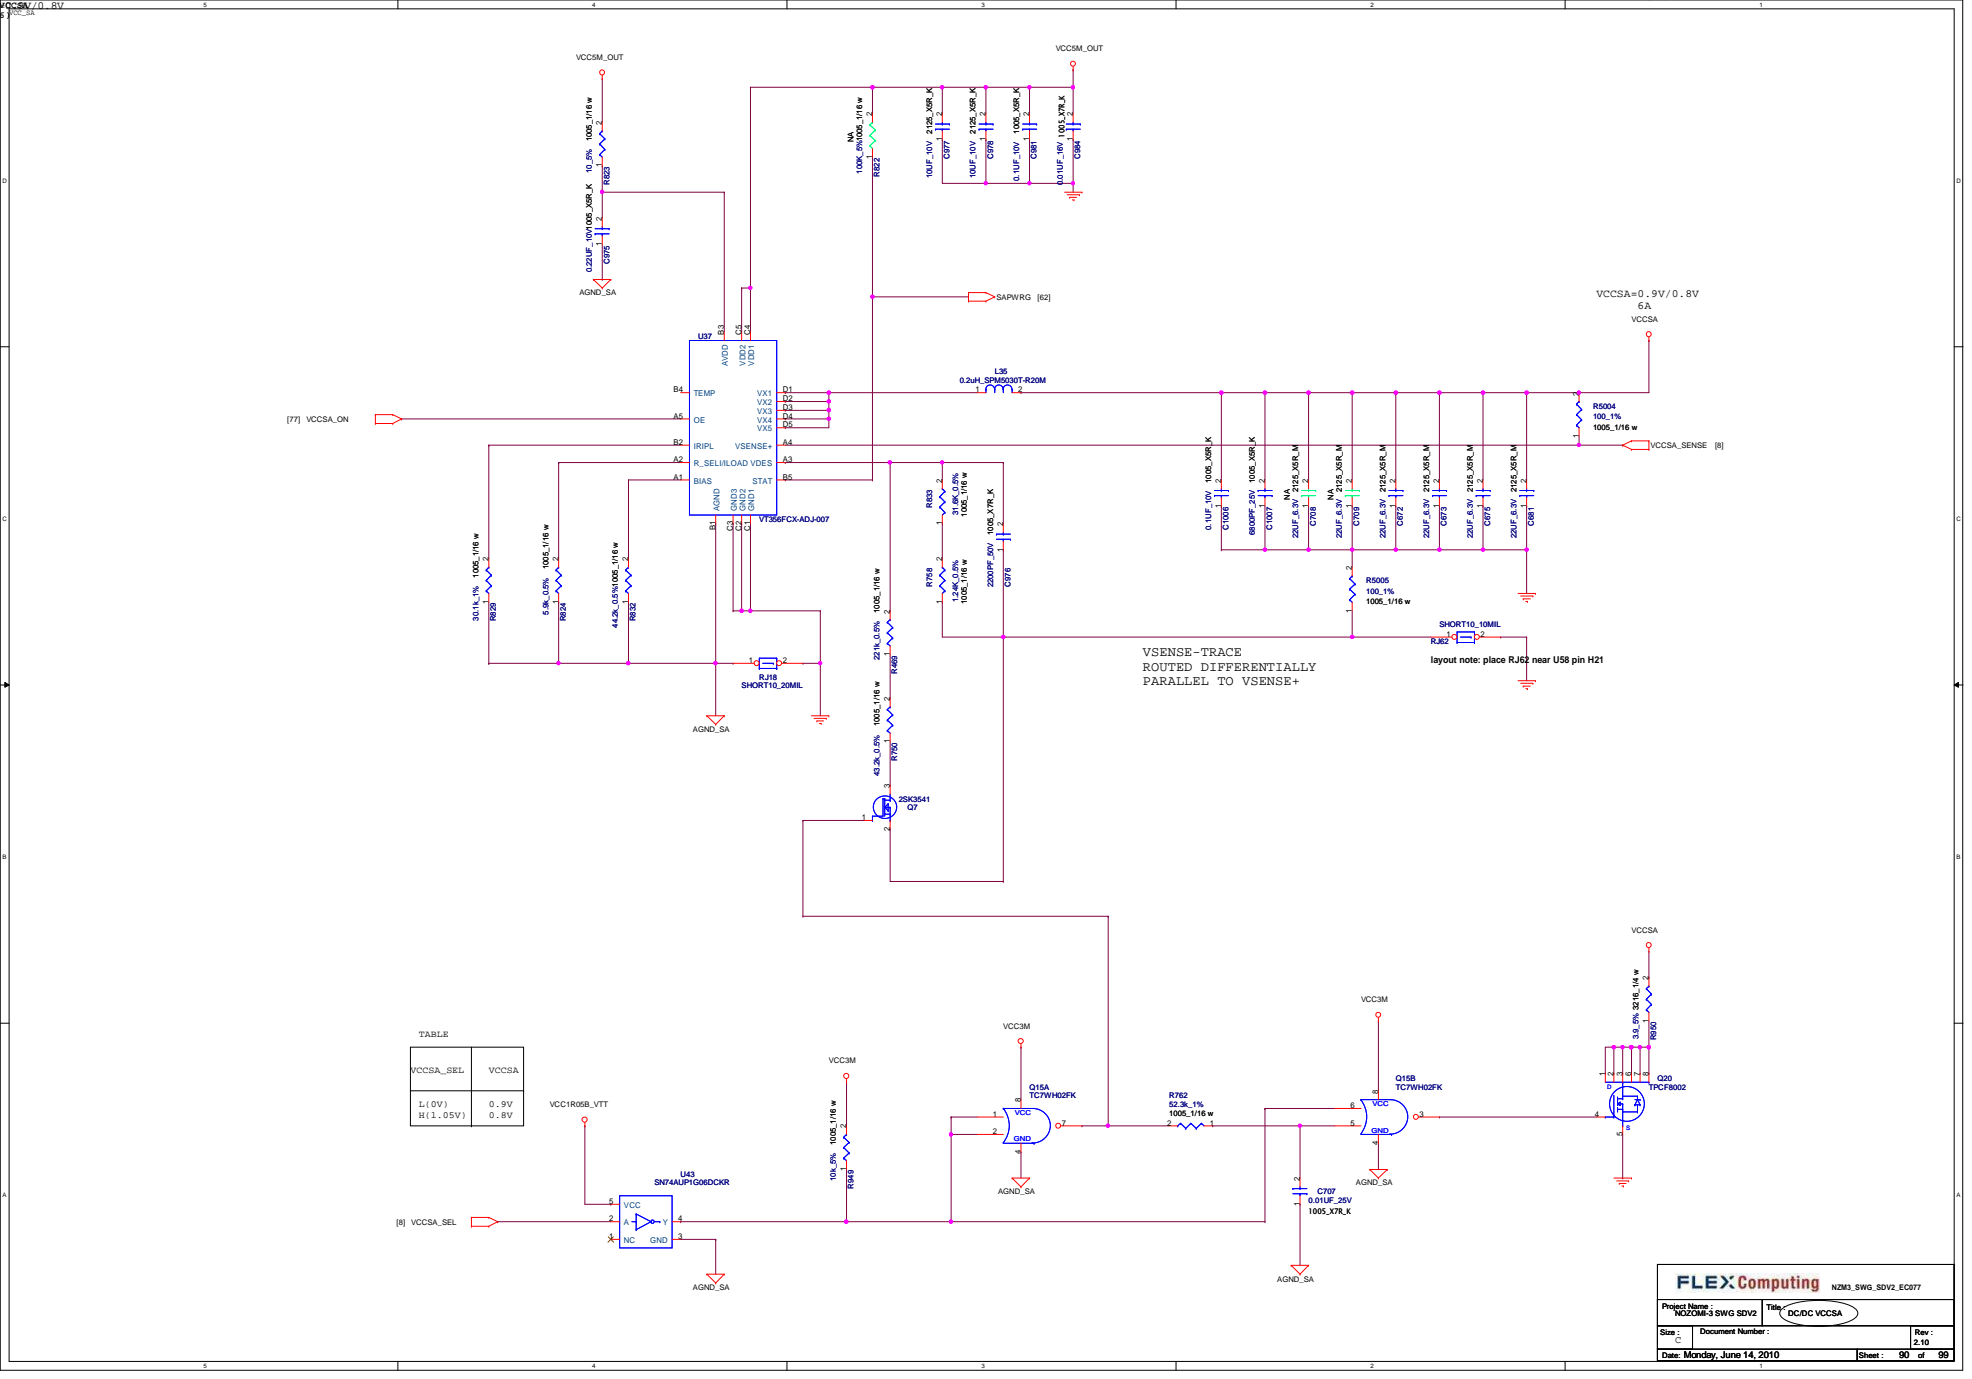
[picture p144: page 90]

## REFER TO VCPIN28 CIRCUIT

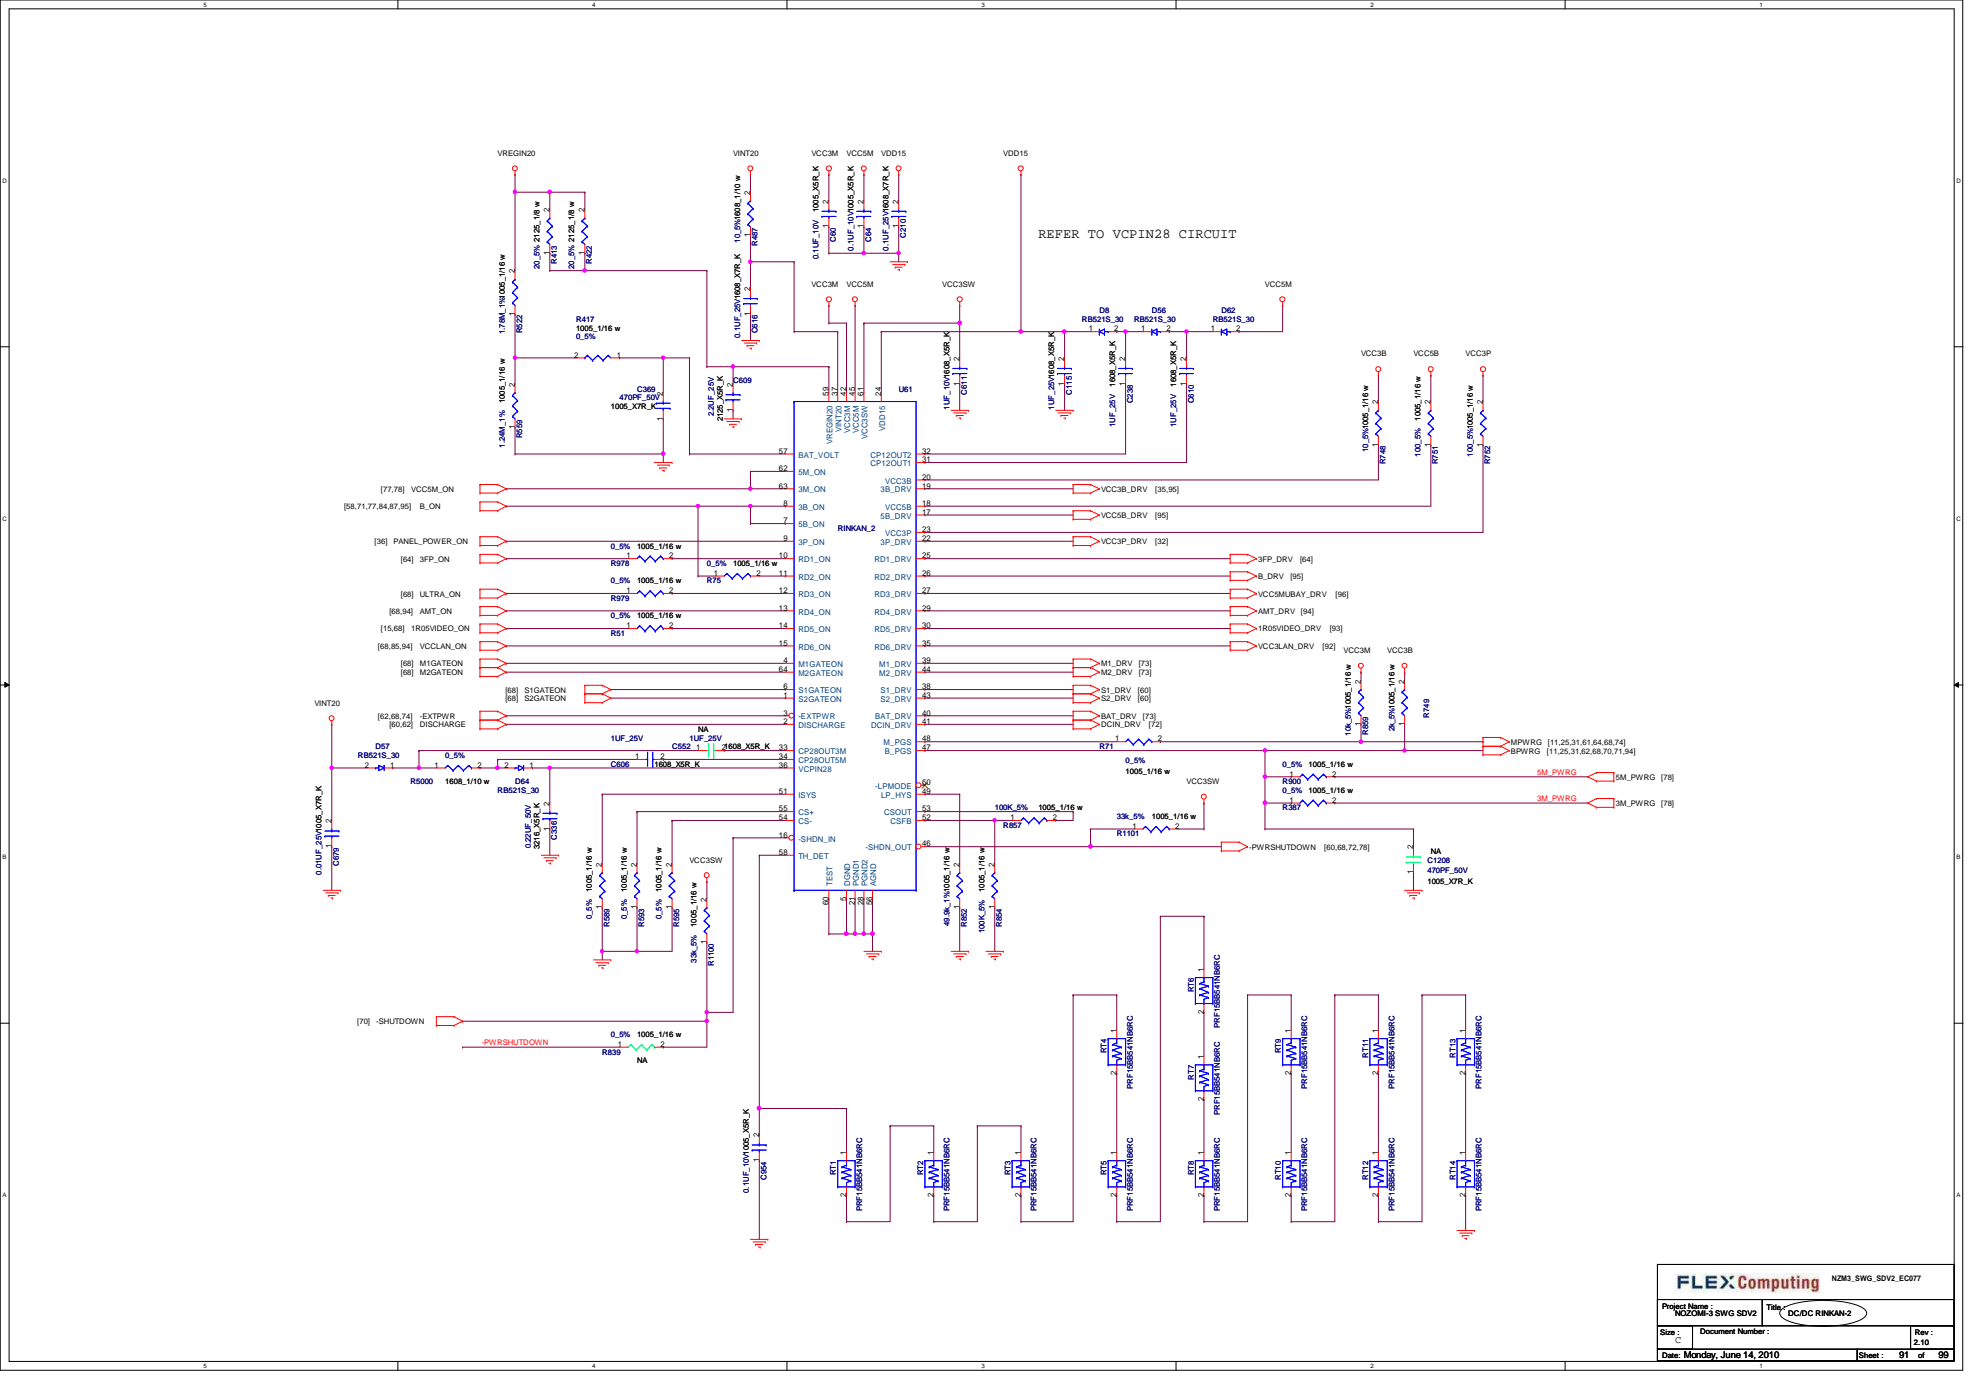
[picture p145: page 91]

0.5A

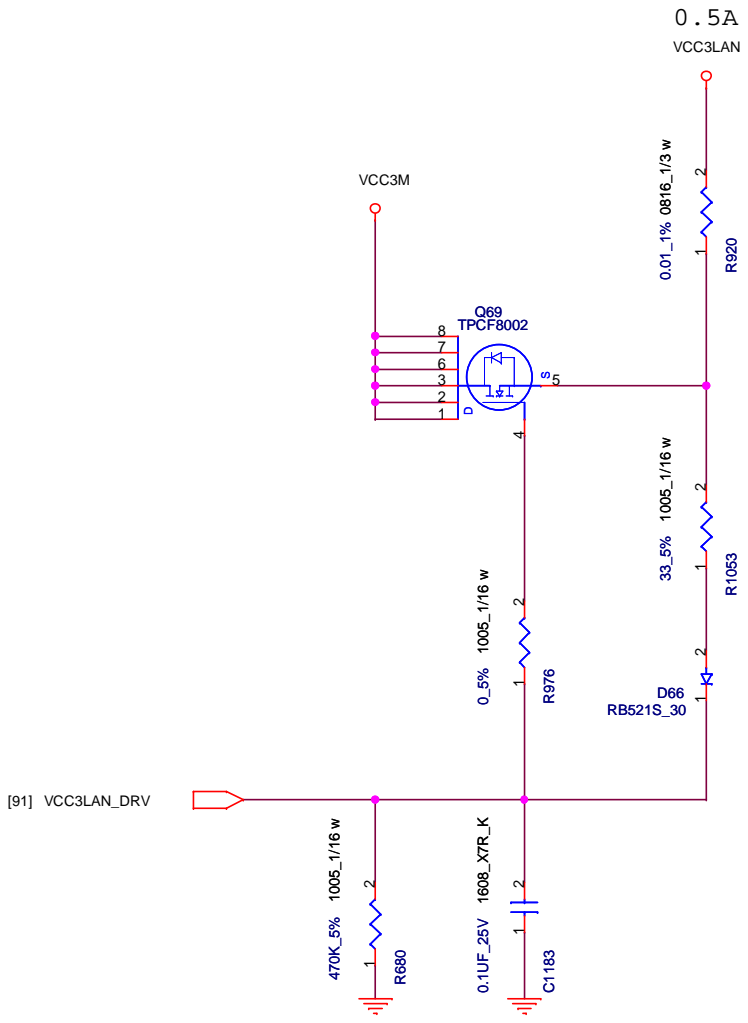
[picture p146: page 92]
[91] VCC3LAN_DRV; VCC3LAN; VCC3M; Monday, June 14, 2010; NOZOMI-3 SWG SDV2; LOAD SW LAN; Q69 TPCF8002

1.3A | 2A

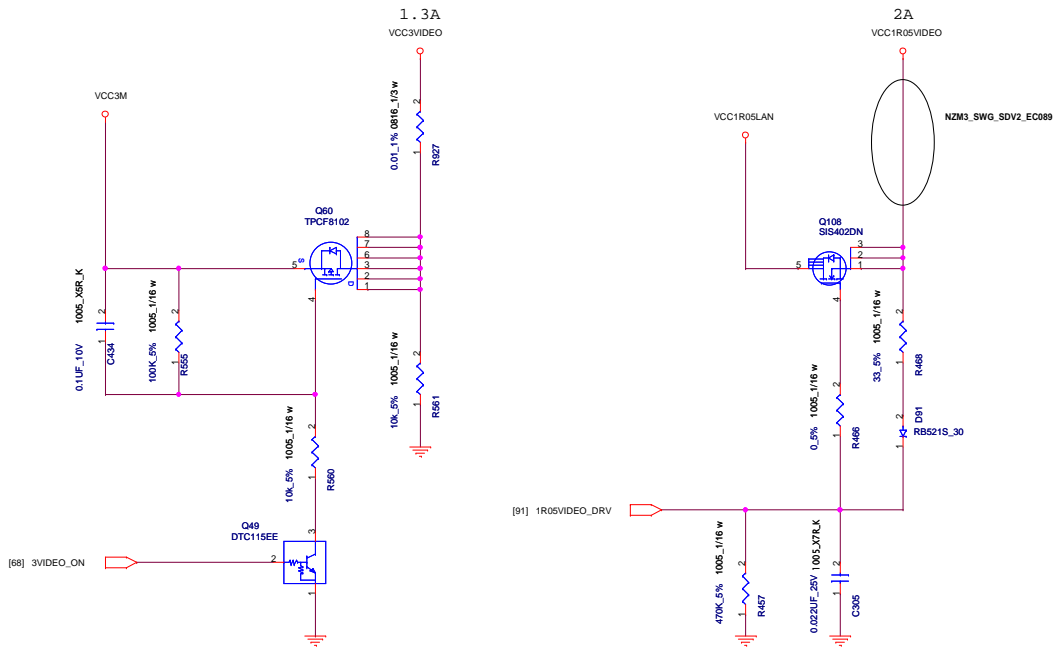
[picture p147: page 93]

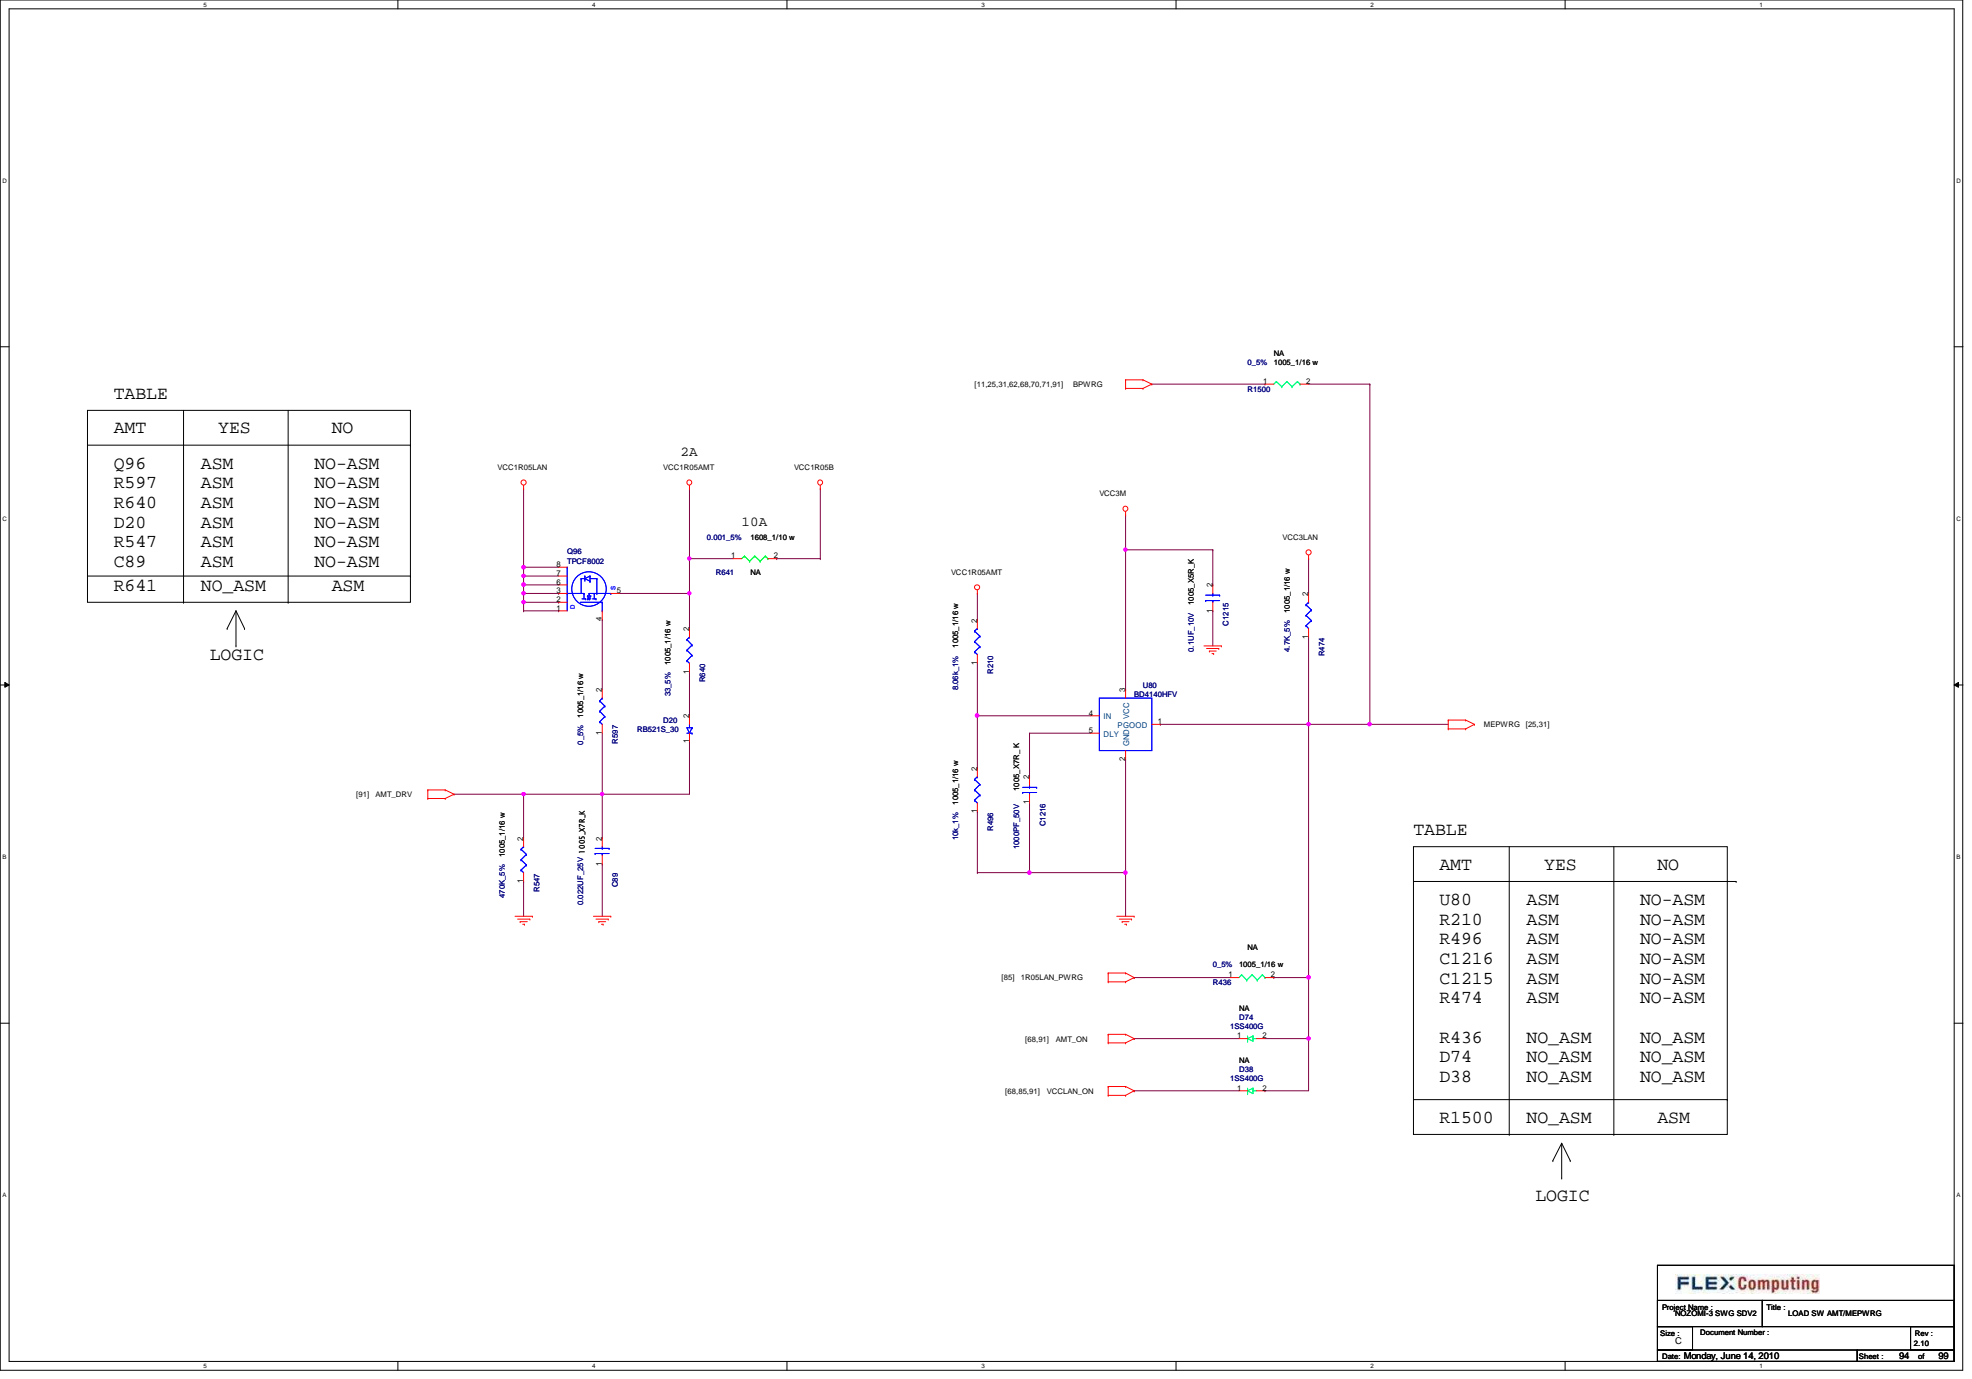
[picture p148: page 94]

7.2A

4A

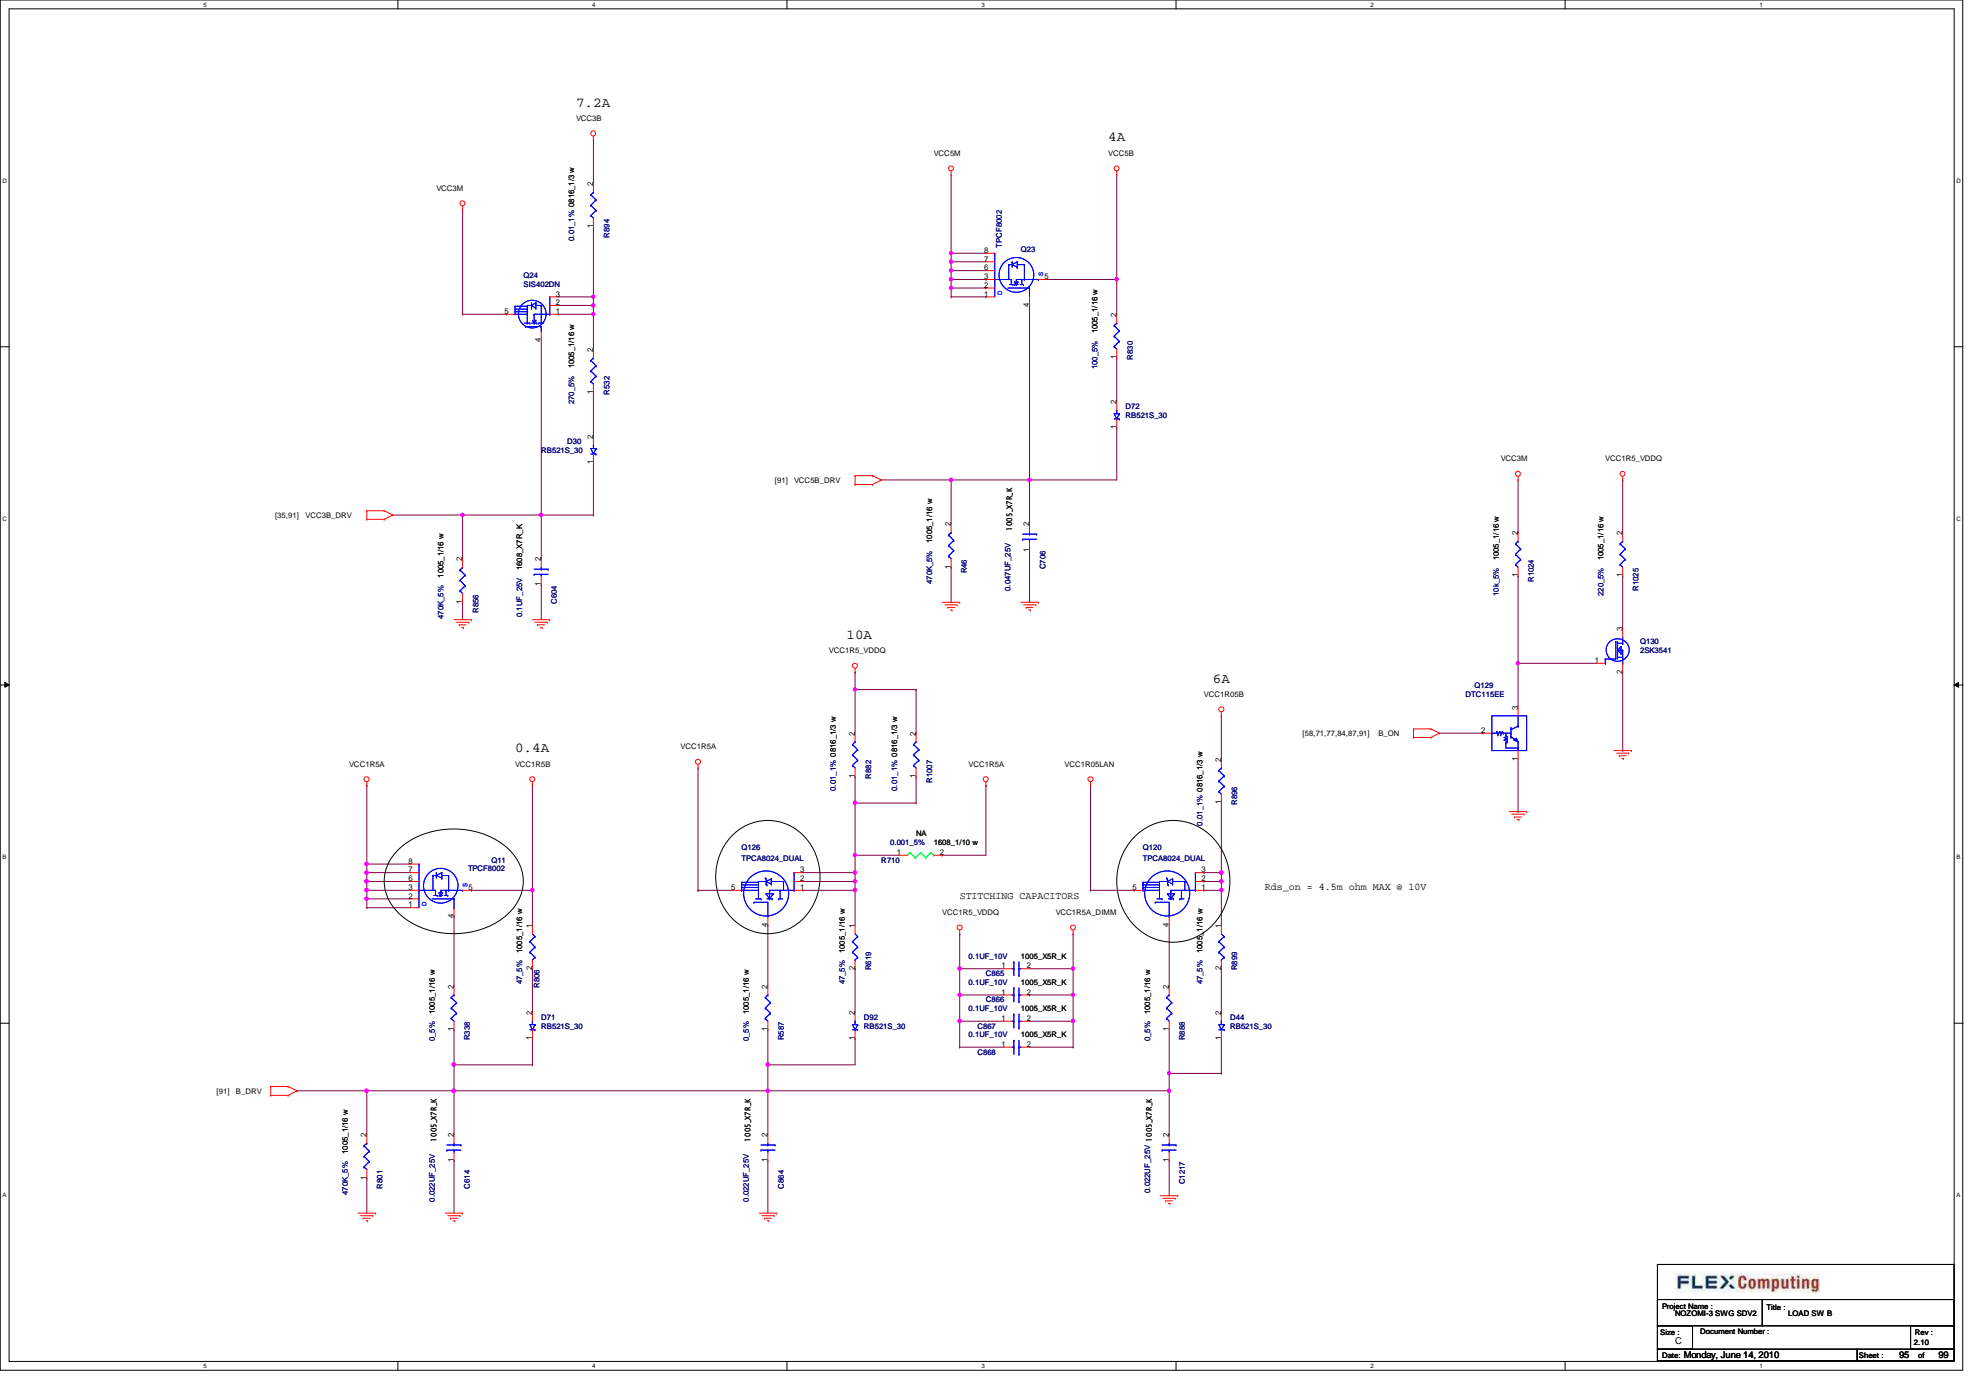
[picture p149: page 95]

1.8A

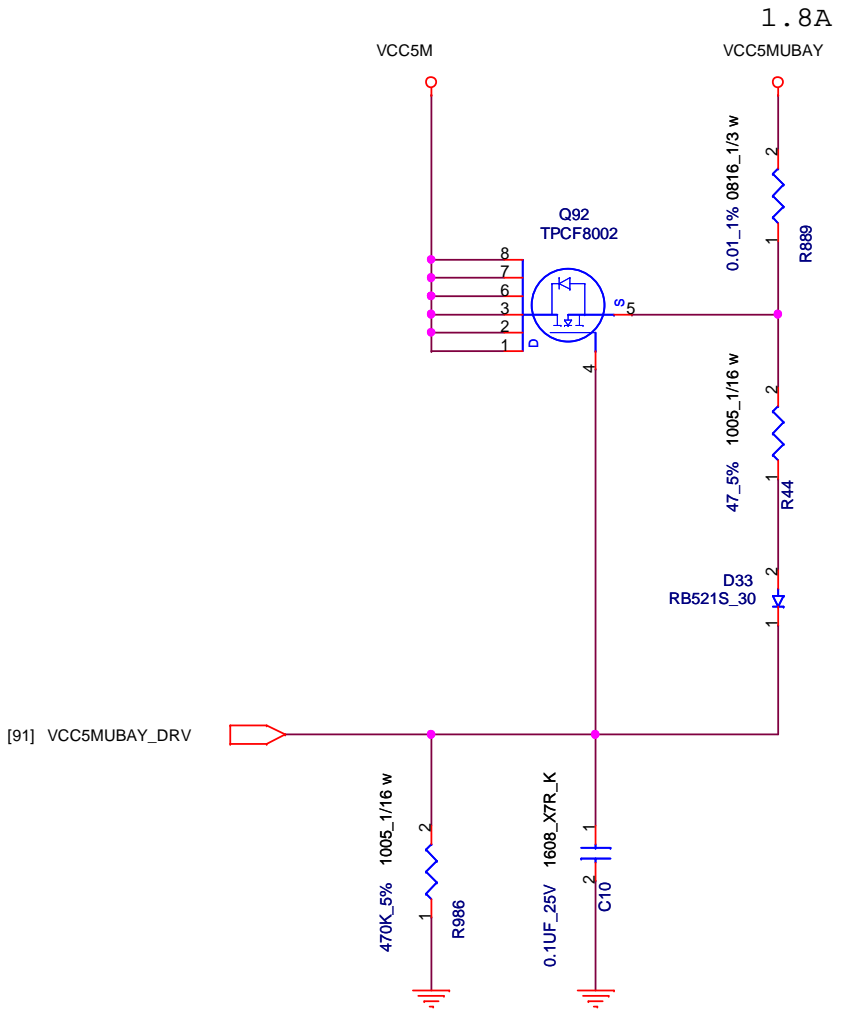
[picture p150: page 96]
[91] VCC5MUBAY_DRV; VCC5M; VCC5MUBAY; Monday, June 14, 2010; NOZOMI-3 SWG SDV2; LOAD SW VCC5MUBAY; Q92 TPCF8002

2.7A | 2.7A
PLACE POSISTOR NEAR Q94 | PLACE POSISTOR NEAR Q100

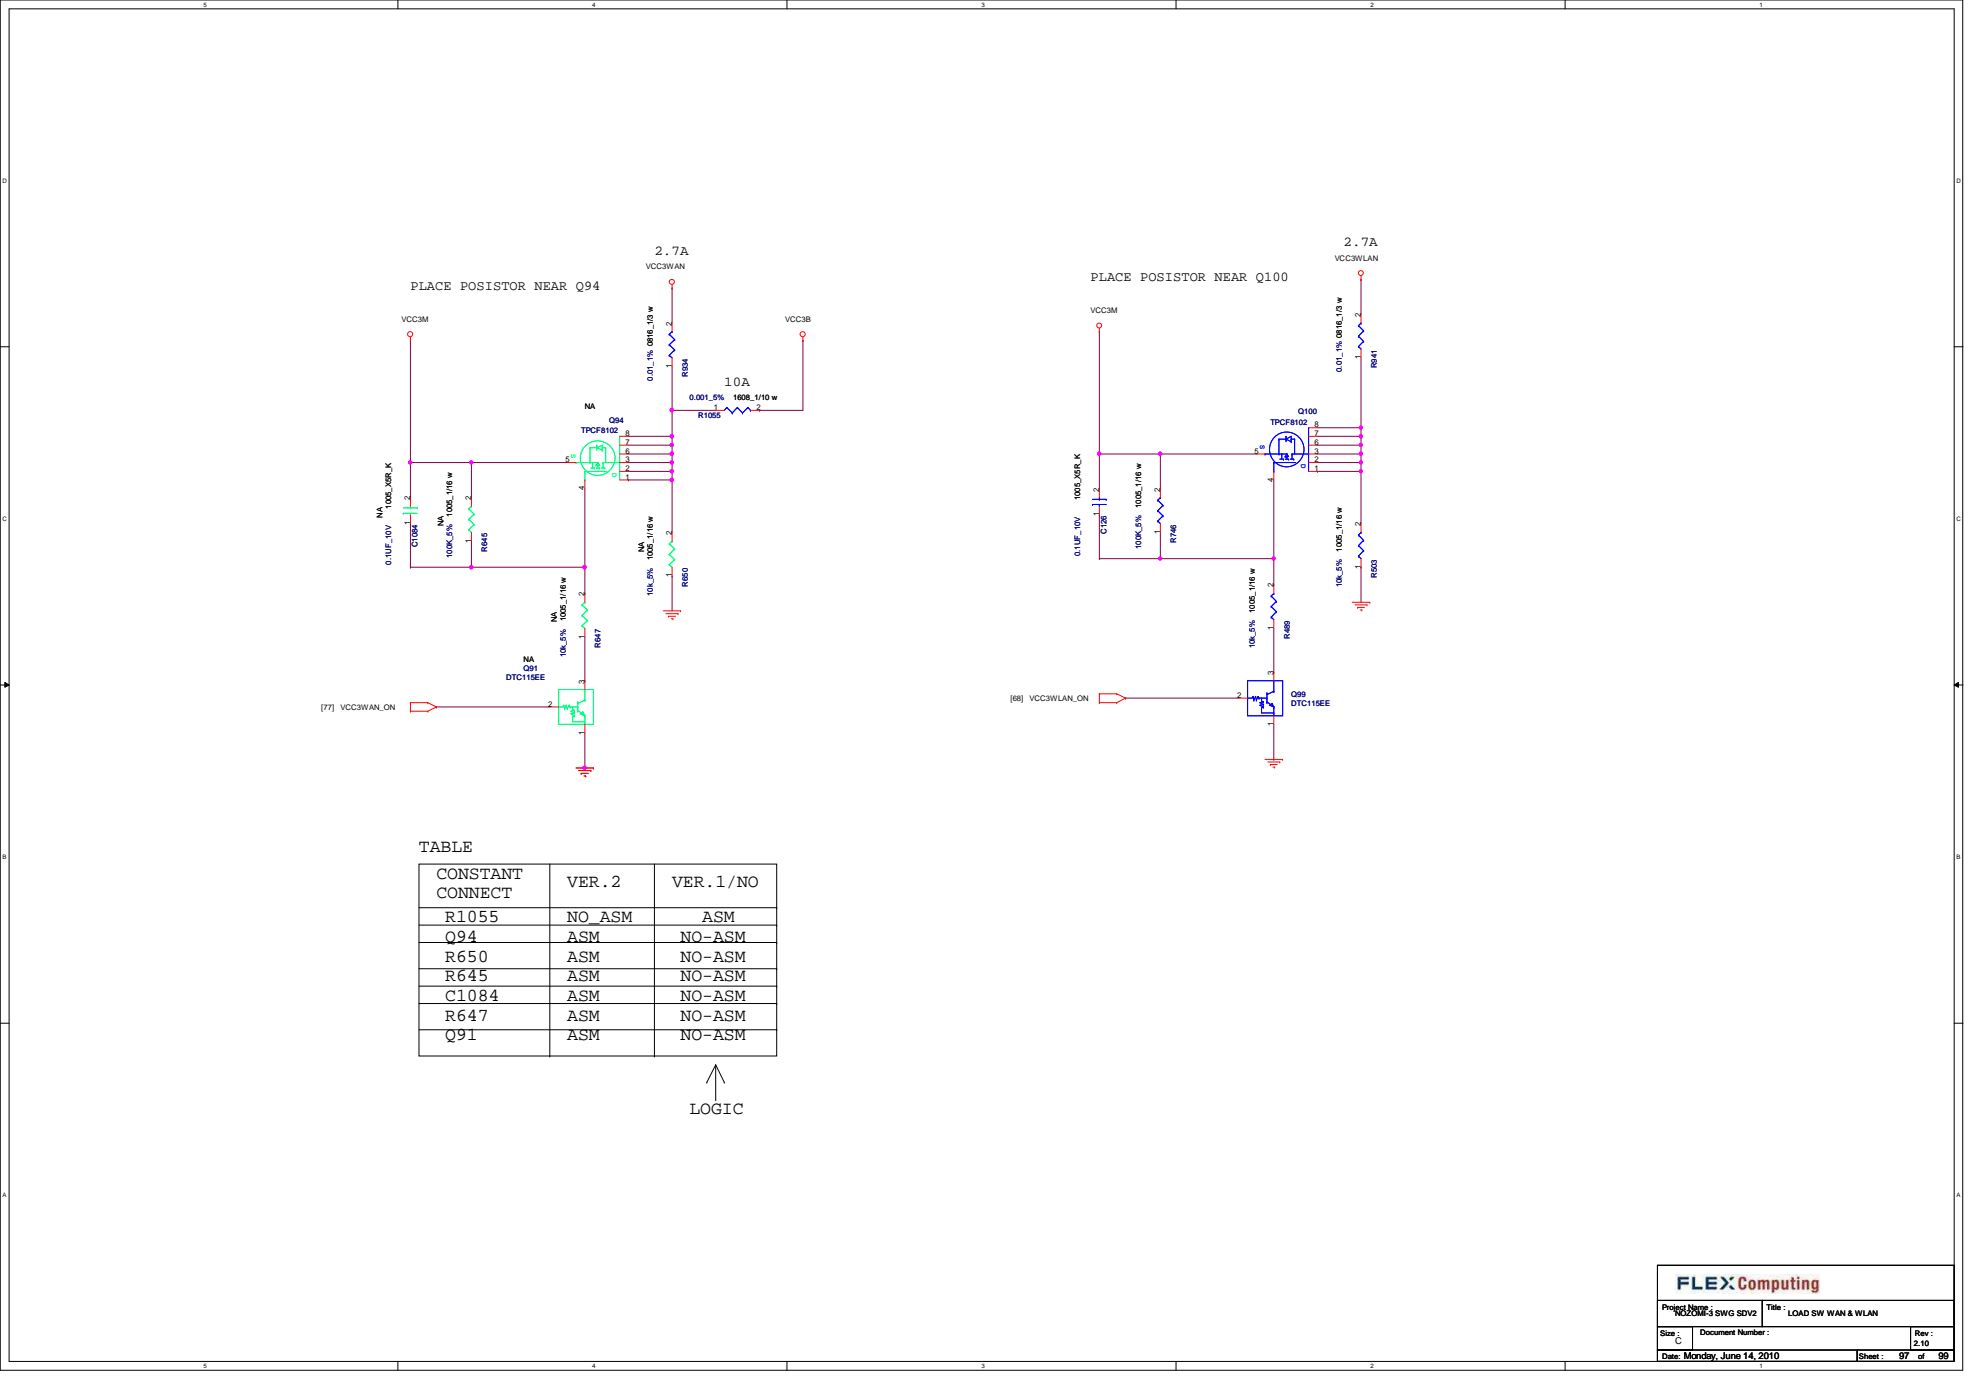
[picture p151: page 97]

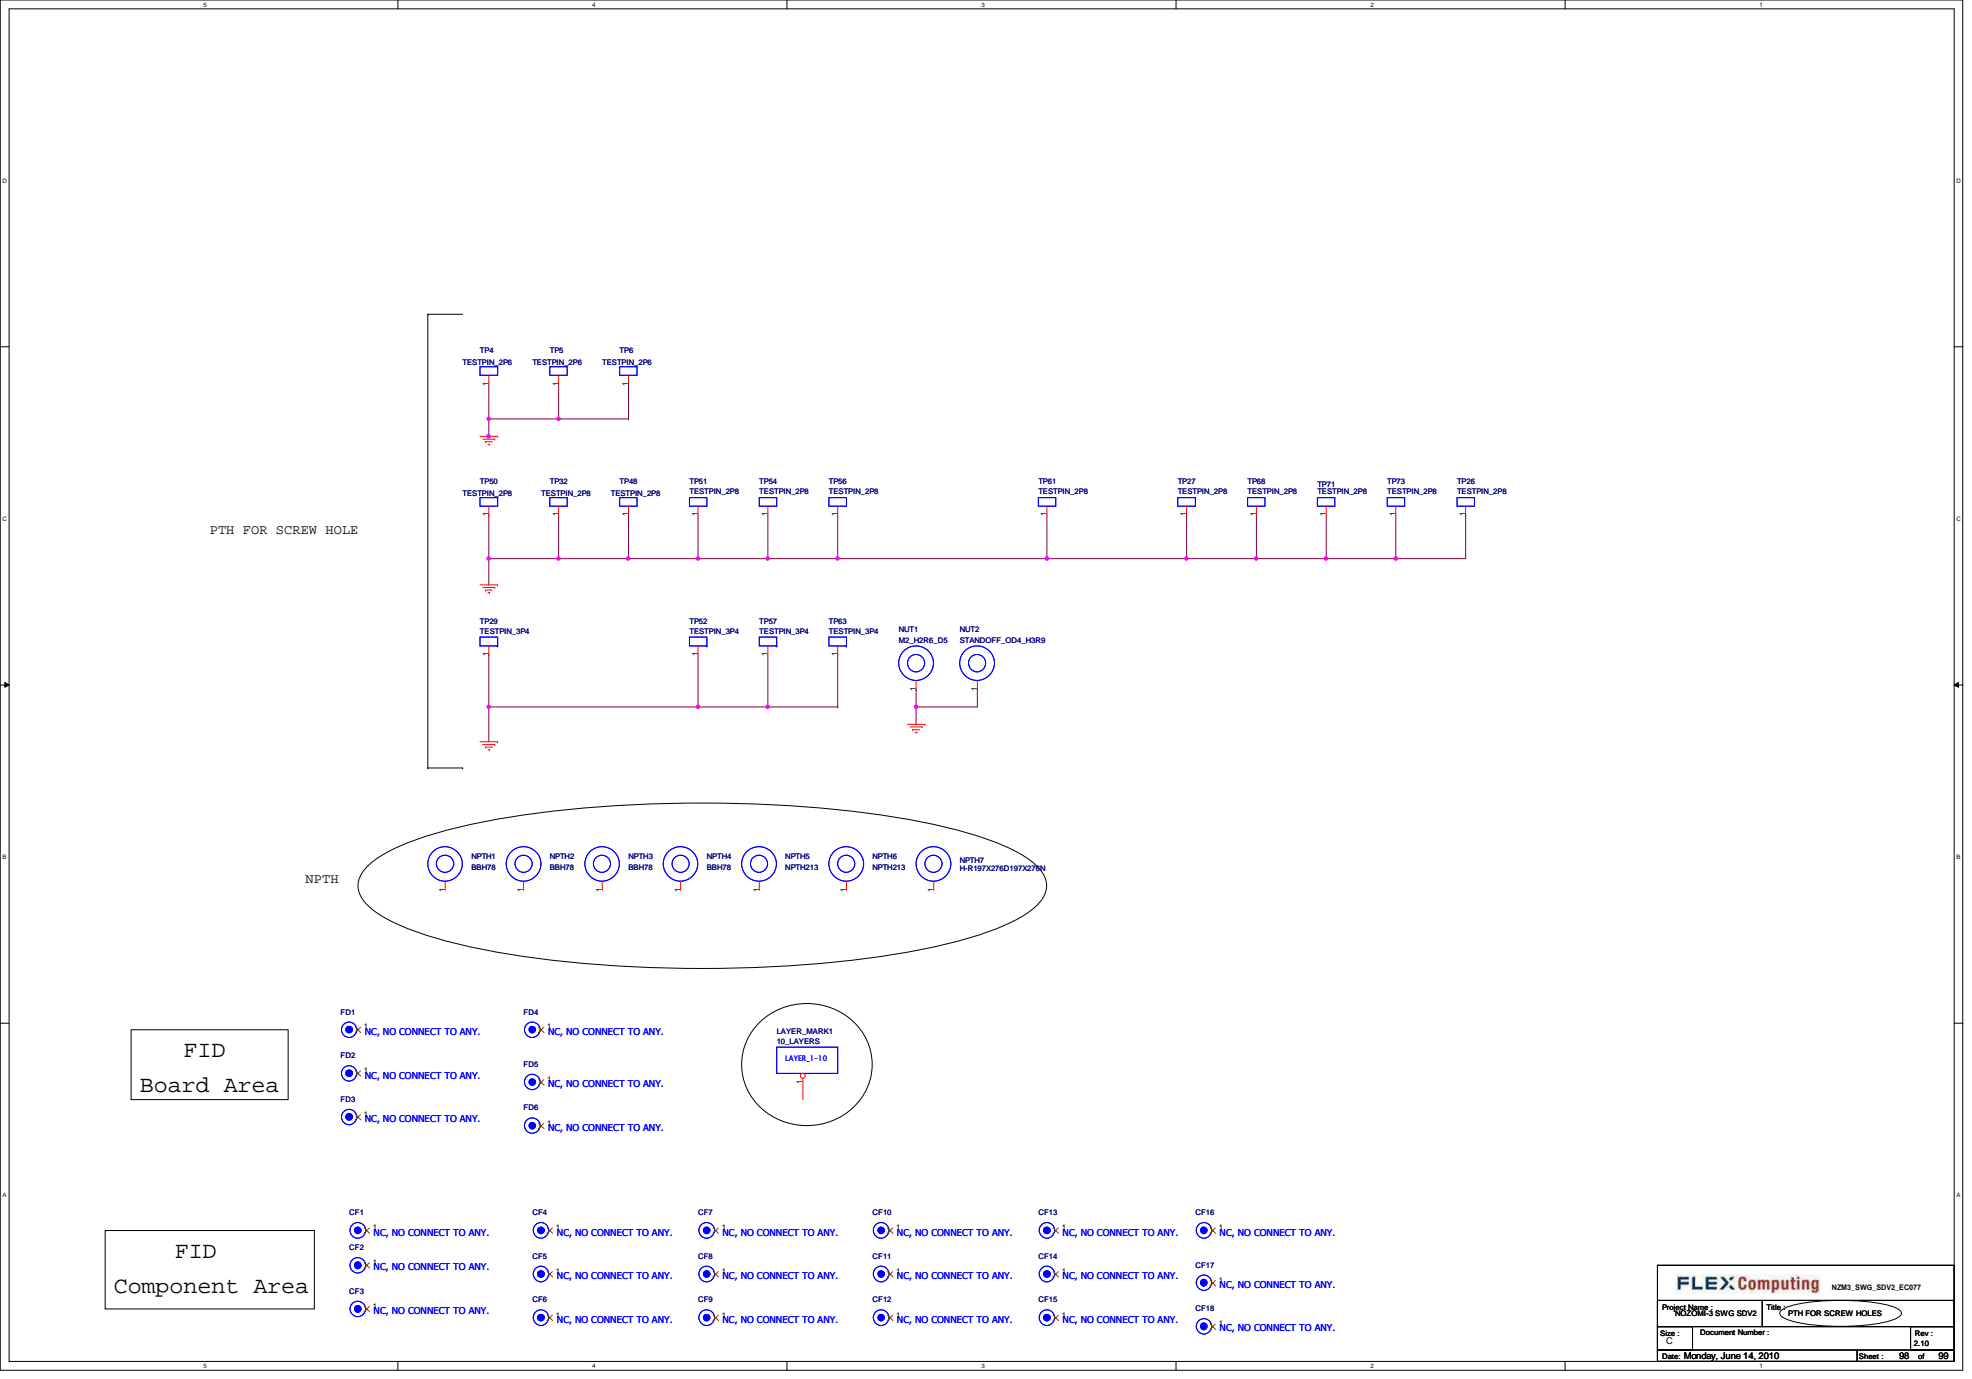
[picture p152: page 98]

PTH FOR SCREW HOLE

1 NC, NO CONNECT TO ANY.

NC, NO CONNECT TO ANY.

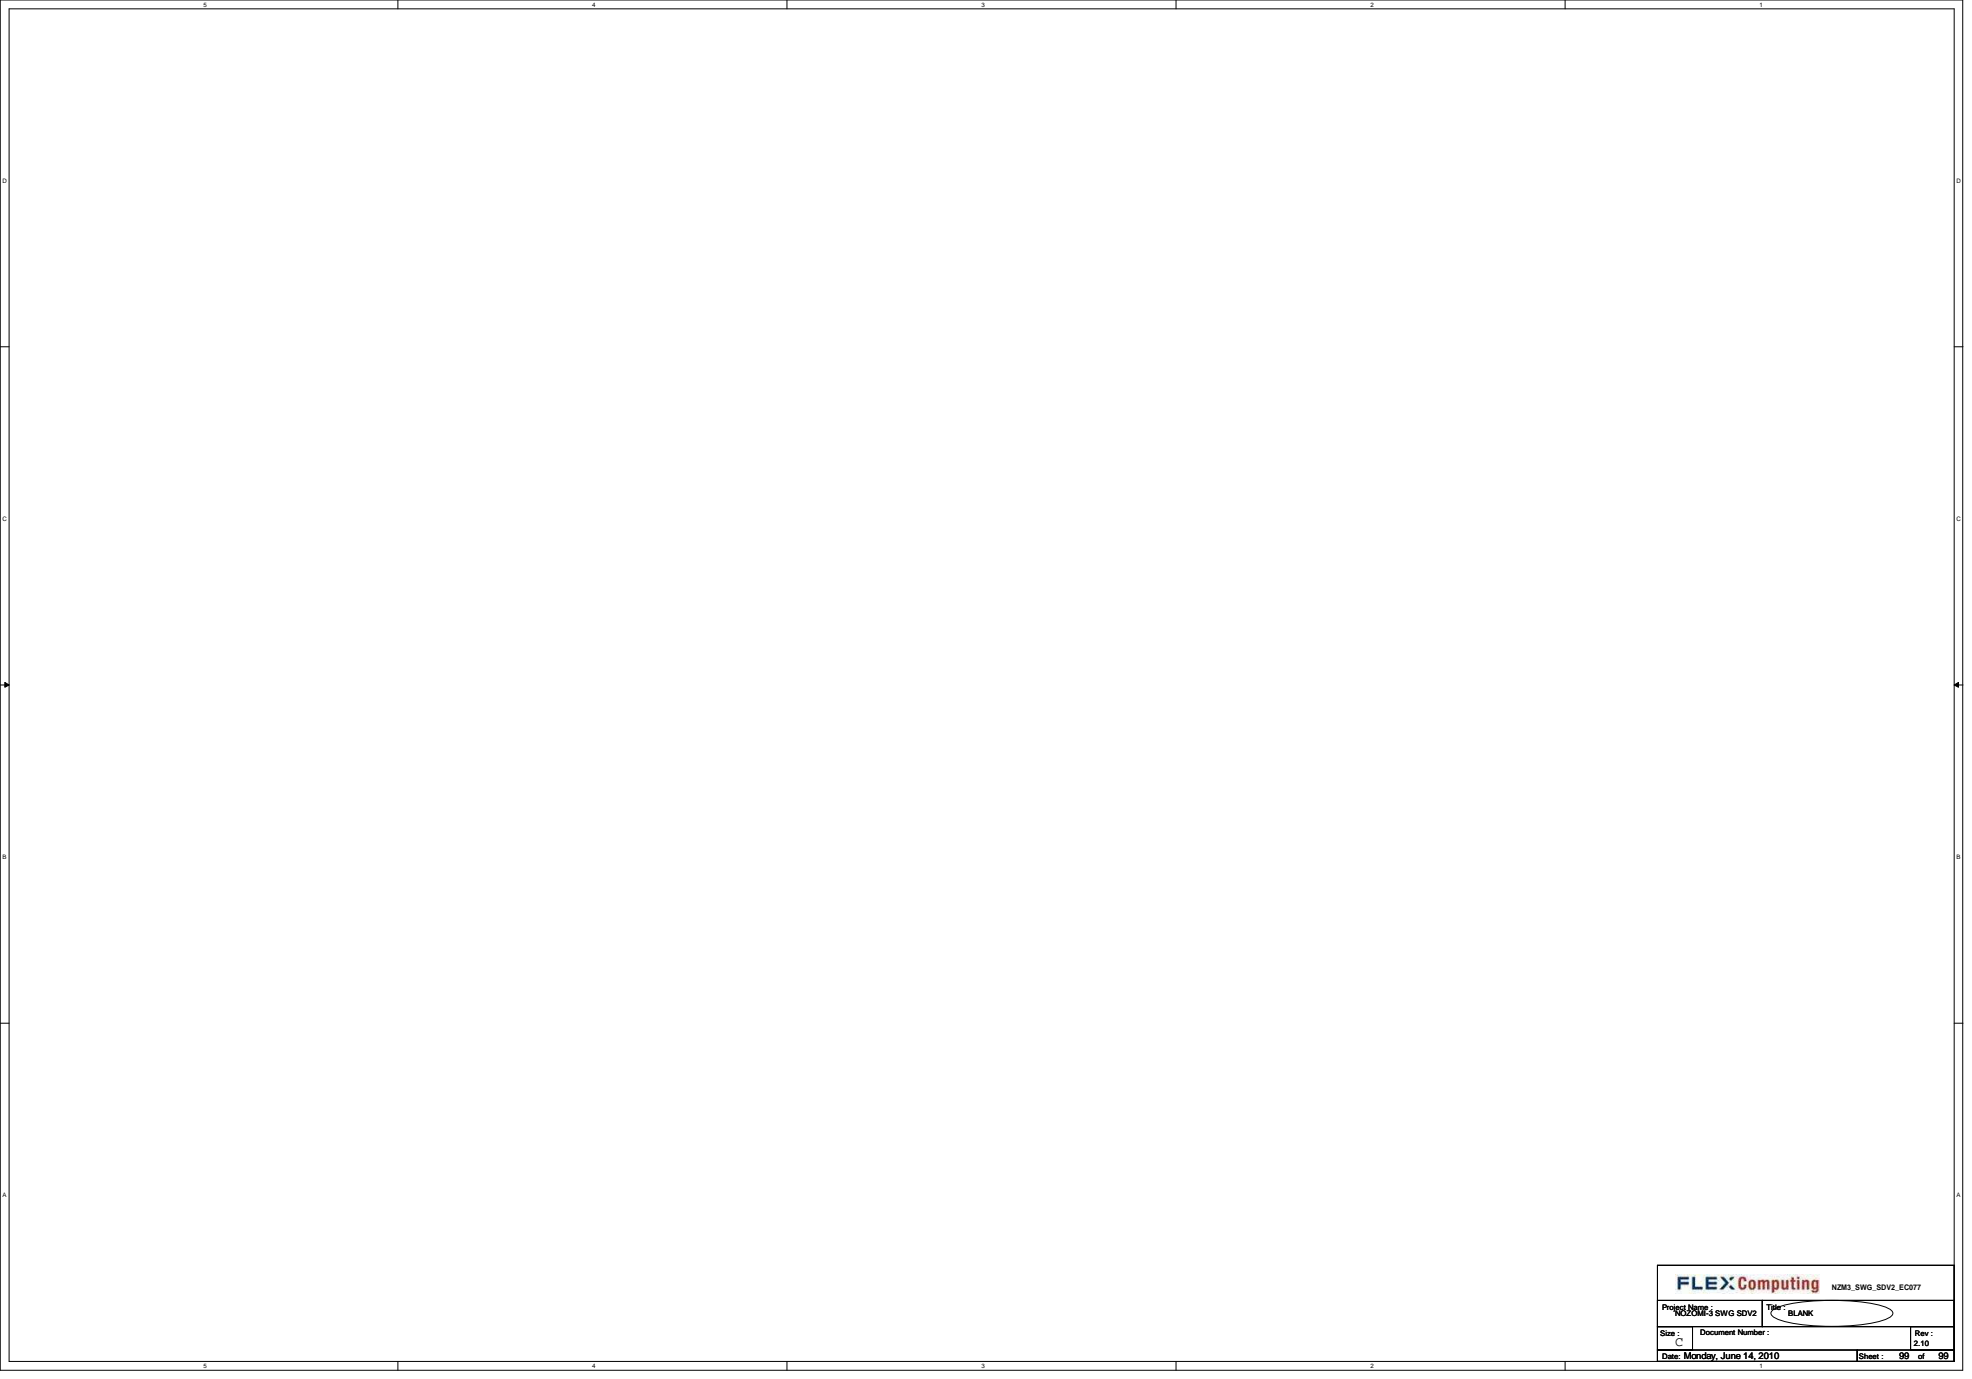
[picture p153: page 99]
Monday, June 14, 2010; NOZOMI-3 SWG SDV2; BLANK; NZM3_SWG_SDV2_EC077
