orbitinstasis/T420_KB_BLE/(list of files, drawings)

Other design files:
PCB/Lenovo_Scanner t32.PcbDoc
PCB/Lenovo_Scanner t32.PrjPcb
