orbitinstasis/T420_KB_BLE/Matrix_Decoder_T420/Matrix_Decoder_T61/Matrix_Decoder_T61.ino

/*
   Licensed under the Apache License, Version 2.0 (the "License");
   you may not use this file except in compliance with the License.
   You may obtain a copy of the License at
       http://www.apache.org/licenses/LICENSE-2.0
   Unless required by applicable law or agreed to in writing, software
   distributed under the License is distributed on an "AS IS" BASIS,
   WITHOUT WARRANTIES OR CONDITIONS OF ANY KIND, either express or implied.
   See the License for the specific language governing permissions and
   limitations under the License.
*/
// this software will determine how a laptop keyboard matrix is wired using a Teensy 3.2 on an FPC T61 daughterboard.
// Open an editor on a computer and load or create a file that lists every key
// on the laptop keyboard that will be tested. Connect the FPC cable of the test keyboard 
// to the Teensy/FPC board. Connect a USB cable from the Teensy to the computer.
// Wait a few seconds for the computer to see the Teensy as a keyboard. If numbers are reported on the screen
// before any keys are pressed, these I/O numbers are shorted together and must be fixed. 
// Press each key one by one on the test keyboard as listed on the editor screen. When a key 
// is pressed on the test keyboard, the program detects which Teensy I/O's  
// were connected. Those two I/O's are sent over USB (separated by a TAB) and displayed 
// on the editor. After sending the numbers, a DOWN ARROW is sent over USB to prepare for
// the next key. Once all keys on the test keyboard have been pressed, the file in
// the editor can be saved to create a row-column matrix.
//
// Revision History
// Rev 1.00 - Nov 18, 2018 - Original Release
//
// FPC 02,03,04,05,06,07,08,09,10,11,12,13,14,15,16,17,18,20,22,24,26,28,30,32
// I/O 31,15,32,16,26,17,07,12,25,11,06,10,24,09,05,08,33,04,20,03,21,02,22,01
// Load an array with the Teensy 3.2 I/O numbers that correspond to the FPC pins
 int con_pin[] = {30,15,32,16,29,17,7,12,25,11,6,10,24,9,5,8,33,4,20,3,21,2,22,1};
//
// load the key codes used in sending usb numbers, tab, and down arrow
int key_1 = KEY_1; 
int key_2 = KEY_2;
int key_3 = KEY_3;
int key_4 = KEY_4;
int key_5 = KEY_5;
int key_6 = KEY_6;
int key_7 = KEY_7;
int key_8 = KEY_8;
int key_9 = KEY_9;
int key_0 = KEY_0;
int key_tab = KEY_TAB;
int key_down = KEY_DOWN;
//
// Function to set a pin as an input with a pullup so it's high unless grounded by a key press
void go_z(int pin)
{
  pinMode(pin, INPUT_PULLUP);
  digitalWrite(pin, HIGH);
}

// Function to set a pin as an output and drive it to a logic low (0 volts)
void go_0(int pin)
{
  pinMode(pin, OUTPUT);
  digitalWrite(pin, LOW);
}

// Function to send numbers over USB for display on an editor
void usb_num(int num)  // the numbers 0 thru 33 are sent over usb as 0 thru 33 
{
  switch (num) {
    case 0:    
      Keyboard.set_key1(key_0);
      Keyboard.send_now();
      break;
    case 1:    
      Keyboard.set_key1(key_1);
      Keyboard.send_now();
      break;
    case 2:    
      Keyboard.set_key1(key_2);
      Keyboard.send_now();
      break;
    case 3:    
      Keyboard.set_key1(key_3);
      Keyboard.send_now();
      break;
    case 4:    
      Keyboard.set_key1(key_4);
      Keyboard.send_now();
      break;
    case 5:    
      Keyboard.set_key1(key_5);
      Keyboard.send_now();
      break;
    case 6:    
      Keyboard.set_key1(key_6);
      Keyboard.send_now();
      break;
    case 7:    
      Keyboard.set_key1(key_7);
      Keyboard.send_now();
      break;
    case 8:    
      Keyboard.set_key1(key_8);
      Keyboard.send_now();
      break;
    case 9:    
      Keyboard.set_key1(key_9);
      Keyboard.send_now();
      break;
    case 10:    
      Keyboard.set_key1(key_1);
      Keyboard.send_now();
      delay(20);
      Keyboard.set_key2(key_0);
      Keyboard.send_now();
      break;
    case 11:    
      Keyboard.set_key1(key_1);
      Keyboard.send_now();
      delay(50);
      Keyboard.set_key1(0);
      Keyboard.send_now();
      delay(50);
      Keyboard.set_key2(key_1);
      Keyboard.send_now();
      break;
    case 12:    
      Keyboard.set_key1(key_1);
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
  Keyboard.send_now();
  delay(20);
}

// Function to send a down arrow over usb to position for the next key
void down_arrow(void) {
  Keyboard.set_key1(key_down); // send a down arrow
  Keyboard.send_now();
  delay(20); 
  Keyboard.set_key1(0); // release the down arrow
  Keyboard.send_now();
}

// --------------------------------------------------Setup-----------------------------------
void setup() {
  for (int k = 0; k < 24; k++) {  // loop thru all connector pins 
    go_z(con_pin[k]); // set each pin as an input with a pullup
  }
  delay(3000);  // Wait for the host to connect to the Teensy as a keyboard. If 2 pins are shorted,
              // you want the host to be ready to receive the pin numbers.
}
//
// -------------------------------------------Main Loop--------------------------------------
// 
void loop() {  
//
//
  for (int i=0; i<23; i++) {   // outer loop index
    go_0(con_pin[i]); // make the outer loop pin an output and send this pin low
    for (int j=i+1; j<24; j++) {   // inner loop index
      delayMicroseconds(10); // give time to let the signals settle out
      if (!digitalRead(con_pin[j])) {  // check for connection between inner and outer pins
        usb_num(con_pin[i]); // send outer loop I/O number over usb
        usb_num(con_pin[j]); // send inner loop I/O number over usb
        down_arrow(); // send a down arrow over usb
        while(!digitalRead(con_pin[j])) {  // wait until key is released 
           ;                              // if 2 pins are shorted, the code will hang here                                            
        }                                                  
      }
    }
  go_z(con_pin[i]); // return the outer loop pin to float with pullup        
  }
//
//
delay(25);  // overall keyboard scan rate is about 30 milliseconds
//
}
