orbitinstasis/T420_KB_BLE/(commit log)

2021-09-04 Enclosure initial
    [10gram weight.ipt, 18650 Battery Final.SLDPRT, 18650 Battery Final.ipt, 1X01.ipt, 1X02.ipt, 1X05.ipt, 543630489.iam, 5gram weight.ipt]
2022-11-05 Completed enclosure, code, correct PCB files
    Added code to exclusivly send BLE or USB codes based solely on the states of physical USB port.
    Enclosure has been designed and tested, some minor changes to be made but otherwise working well.
    PCB files were incorrect previously, have uploaded correct files but need to add minor pin changes.
    Attached Images
    Whole keyboard is balaced in the centre and weighs over a kg.
    BLE mouse move needs to be smoothed
    need to add a way to unpair whatever is paired on the keyboard side, currently only possible by doing a factory reset or unpairing from the receiver
    [4 R.stl, 4 left.stl, 5THFinalAttemptLeft.stp, 5THFinalAttemptRight.stp, 61.stl, 62.stl, 6THLEFT.stp, 6THright.stp]
2022-11-06 Added code and functionality for buttons
    mic mute button and thinkvantage button can now do meaningful functionality in the MCU, check main loop
    added codes for BLE and USB to alt + left or right for forward or back page buttons
2022-11-10 volume hold functionality, noInt to mouse move, disCon and debond button
2022-12-02 fixed baud and RTS CTS in constructor
    [T420_KB_TP.ino]
